peterpolidoro/camera-gpio-interface-pcb/docs/generated/README.md

# camera-gpio-interface-pcb — Generated Board Documentation

Everything in this directory is generated by `orb-weaver-kicad-docs` from the
KiCad sources. Do not edit it by hand; run `make docs` instead.

- KiCad `10.0.6`
- Board `6bc224f47287`

## Board At A Glance

| Property | Value |
| --- | --- |
| Outline | 100.0 × 60.0 mm, 5.0 mm corner radius |
| Thickness | 1.6 mm |
| Copper layers | 4 |
| Mounting holes | 4 × 3.2 mm |
| Connectors and controls | 11 |
| Bill of materials | 26 distinct parts, 151 placements |

## Assembled Board

The [board view](board-view.md) numbers the design blocks on the model and on the top render; each number leads to the block's page.

### Top, straight down

Top, straight down

### Bottom, straight down

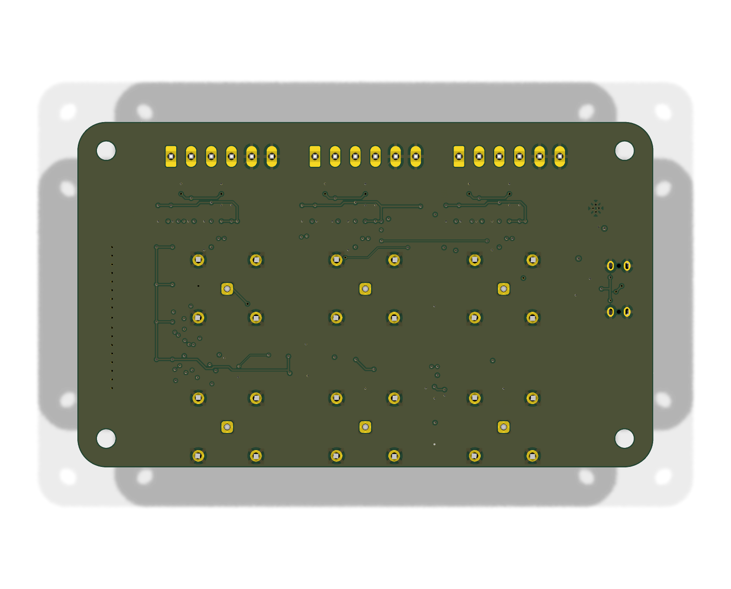
[picture p4: docs/generated/3d/bottom.png]
Bottom, straight down


### Isometric from the front left

Isometric from the front left

### Isometric from the front right

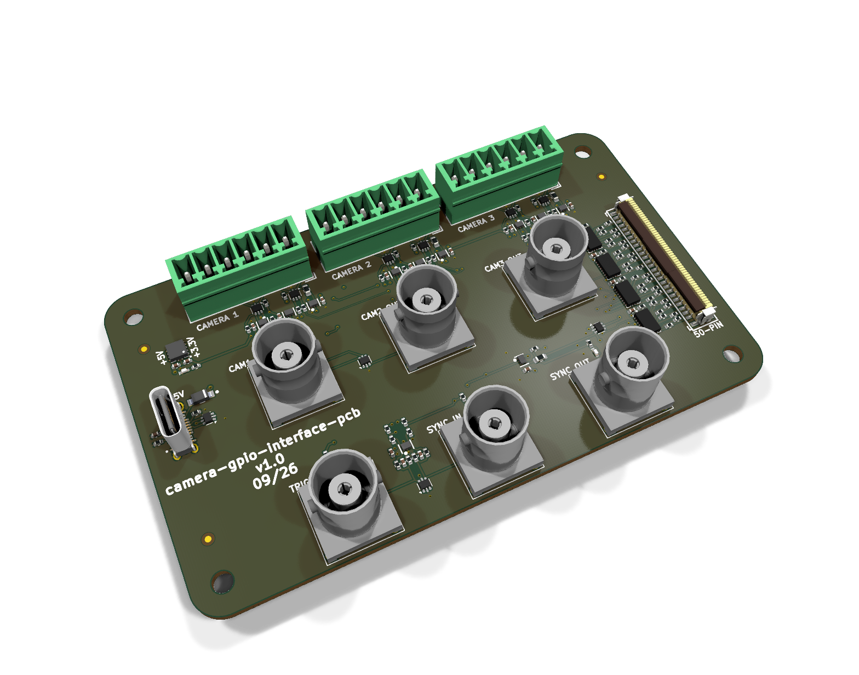
[picture p5: docs/generated/3d/iso-front-right.png]
Isometric from the front right


### Isometric from the rear left

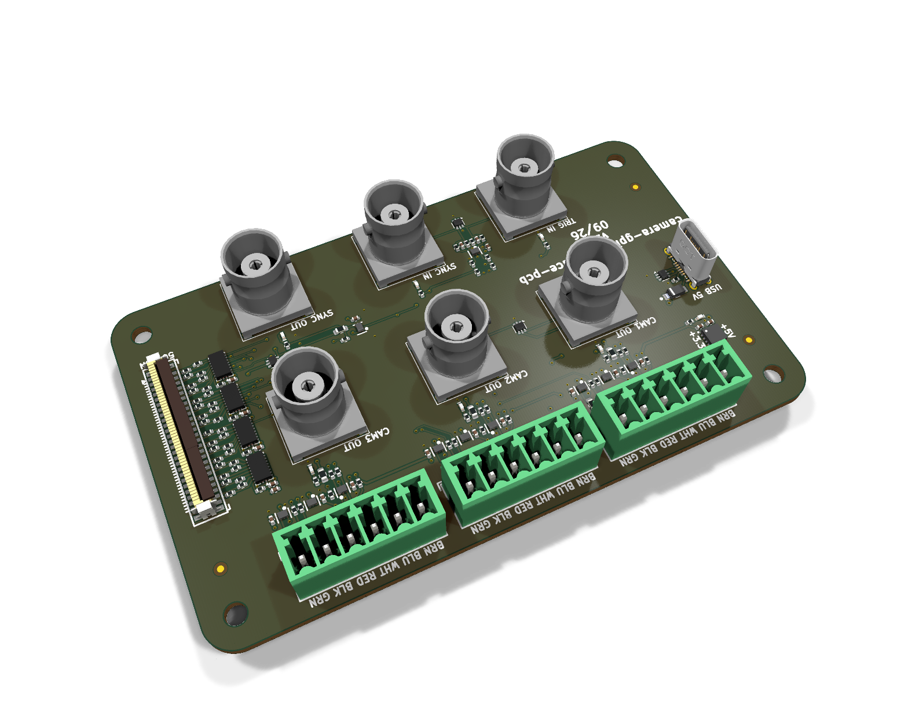
[picture p6: docs/generated/3d/iso-rear-left.png]
Isometric from the rear left


### Isometric from the rear right

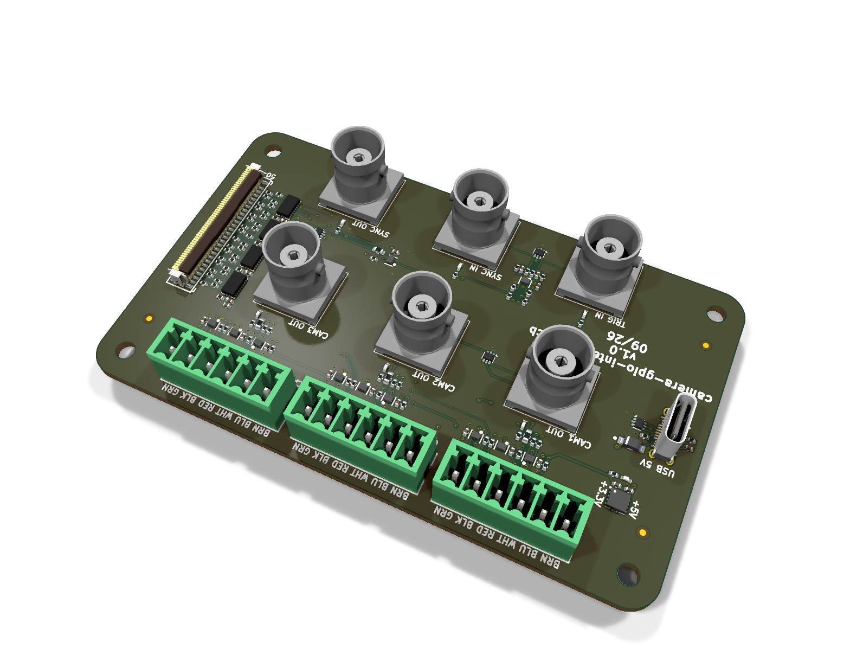
[picture p7: docs/generated/3d/iso-rear-right.png]
Isometric from the rear right


### Front elevation, for connector heights

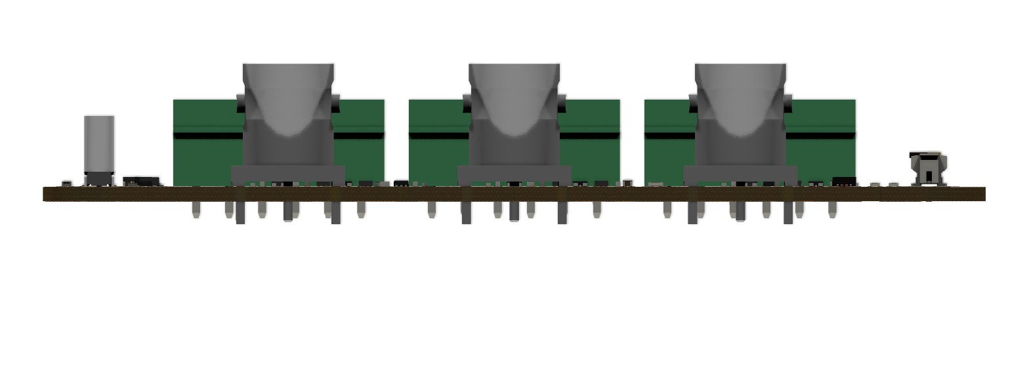
[picture p8: docs/generated/3d/elevation-front.png]
Front elevation, for connector heights


### Left elevation, for connector heights

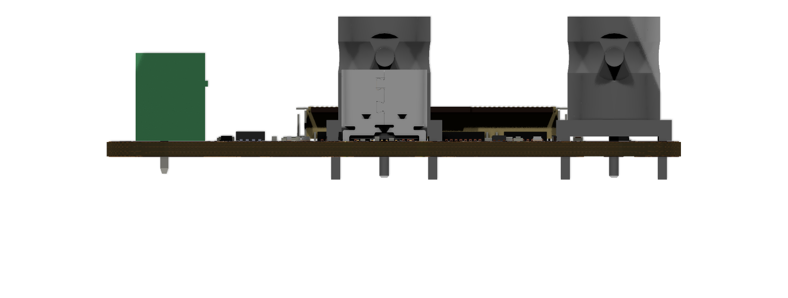
[picture p9: docs/generated/3d/elevation-left.png]
Left elevation, for connector heights


## Documents

| Document | File |
| --- | --- |
| Schematic, all sheets, PDF | [camera-gpio-interface-pcb-schematic.pdf](schematic/camera-gpio-interface-pcb-schematic.pdf) |
| Schematic sheets, SVG (11) | [schematic/](schematic/) |
| Schematic, instance overviews and details, PDF | [Review booklet](schematic/camera-gpio-interface-pcb-schematic-review.pdf) |
| Design blocks placed (7), one page each | [blocks/README.md](blocks/README.md) |
| Board view: the model and the top render with the design blocks numbered | [board-view.md](board-view.md) |
| Subsystem sheets (3), from their recipes | [subsystems/README.md](subsystems/README.md) |
| Assembly view, top | [assembly-top.svg](layout/assembly-top.svg) |
| Assembly view, bottom | [assembly-bottom.svg](layout/assembly-bottom.svg) |
| Assembled board, STEP, for FreeCAD | [camera-gpio-interface-pcb-assembled.step](3d/camera-gpio-interface-pcb-assembled.step) |
| Assembled board, glTF, for a viewer (the library's materials written in) | [camera-gpio-interface-pcb.glb](3d/camera-gpio-interface-pcb.glb) |
| Bill of materials | [table](bom/camera-gpio-interface-pcb-bom.md) · [CSV](bom/camera-gpio-interface-pcb-bom.csv) |
| Outline and mounting holes, dimensioned drawing | [SVG](mechanical/board-dimensions.svg) · [PDF](mechanical/board-dimensions.pdf) · [PNG](mechanical/board-dimensions.png) |
| Board dimensions and stackup | [board-dimensions.md](mechanical/board-dimensions.md) |
| Board geometry, machine readable | [board-geometry.json](mechanical/board-geometry.json) |
| Mounting holes | [mounting-holes.csv](mechanical/mounting-holes.csv) |
| Connector locations | [connectors.csv](mechanical/connectors.csv) |

## Design Blocks

Every block the board places, documented from the library: [the index](blocks/README.md) and one page per placement; the numbers are the [board view](board-view.md)'s.

| # | Instance | Block | Lifecycle | Family | Placed sheet |
| ---: | --- | --- | --- | --- | --- |
| 1 | [`blackfly_s_gpio_channel_mcv6_vertical`](blocks/blackfly_s_gpio_channel_mcv6_vertical.md) | `orb_weaver_blackfly_s_gpio_channel:blackfly_s_gpio_channel_mcv6_vertical` | routed | blackfly_s_gpio_channel `mcv6_vertical` (gpio) | differs |
| 7 | [`logic_input_2ch_5v_schmitt_sn74lvc2g17`](blocks/logic_input_2ch_5v_schmitt_sn74lvc2g17.md) | `orb_weaver_private:logic_input_2ch_5v_schmitt_sn74lvc2g17` | routed |  | differs |
| 4 | [`5v_to_3v3_tps73733`](blocks/5v_to_3v3_tps73733.md) | `orb_weaver_private:5v_to_3v3_tps73733` | routed |  | differs |
| 6 | [`usb2_vertical`](blocks/usb2_vertical.md) | `orb_weaver_private:usb2_vertical` | routed |  | differs |
| 5 | [`instrument_port_digital_50_dut_ffc_boundary_vertical`](blocks/instrument_port_digital_50_dut_ffc_boundary_vertical.md) | `orb_weaver_private:instrument_port_digital_50_dut_ffc_boundary_vertical` | routed |  | differs |
| 3 | [`blackfly_s_gpio_channel_mcv6_vertical2`](blocks/blackfly_s_gpio_channel_mcv6_vertical2.md) | `orb_weaver_blackfly_s_gpio_channel:blackfly_s_gpio_channel_mcv6_vertical` | routed | blackfly_s_gpio_channel `mcv6_vertical` (gpio) | differs |
| 2 | [`blackfly_s_gpio_channel_mcv6_vertical1`](blocks/blackfly_s_gpio_channel_mcv6_vertical1.md) | `orb_weaver_blackfly_s_gpio_channel:blackfly_s_gpio_channel_mcv6_vertical` | routed | blackfly_s_gpio_channel `mcv6_vertical` (gpio) | differs |

## Subsystems

The board's subsystem sheets from their recipes: [the index](subsystems/README.md) and one page each.

| Subsystem | Recipe | Blocks |
| --- | --- | --- |
| [`inputs`](subsystems/inputs.md) | `subsystems/inputs.subsystem.yaml` | 1 |
| [`power`](subsystems/power.md) | `subsystems/power.subsystem.yaml` | 2 |
| [`outputs`](subsystems/outputs.md) | `subsystems/outputs.subsystem.yaml` | 0 |

### Enclosure Reference

Millimetres from the **centre of the board outline**, X right and Y up,
looking at the top of the board. Extents are the part's courtyard, which is
what a panel cutout has to clear. Full tables in [board-dimensions.md](mechanical/board-dimensions.md).

Outline and mounting holes, dimensioned

The outline and the mounting holes dimensioned, as KiCad draws them: [SVG](mechanical/board-dimensions.svg) · [PDF](mechanical/board-dimensions.pdf); the cross is the centre the tables measure from.

**Mounting holes**

| Ref | X (mm) | Y (mm) | Drill (mm) |
| --- | --- | --- | --- |
| H101 | -45.0 | 25.0 | 3.2 |
| H102 | 45.0 | 25.0 | 3.2 |
| H103 | 45.0 | -25.0 | 3.2 |
| H104 | -45.0 | -25.0 | 3.2 |

**Connectors and controls**

| Ref | Part | X (mm) | Y (mm) | Rot | Extent X (mm) | Extent Y (mm) |
| --- | --- | --- | --- | --- | --- | --- |
| J301 | HL-BNC-KHDA | -24.0 | -23.0 | 0.0 | -30.5 to -17.5 | -29.5 to -16.5 |
| J302 | HL-BNC-KHDA | 0.0 | -23.0 | 0.0 | -6.5 to 6.5 | -29.5 to -16.5 |
| J401 | HL-BNC-KHDA | 24.0 | -23.0 | 0.0 | 17.5 to 30.5 | -29.5 to -16.5 |
| J402 | HL-BNC-KHDA | -24.0 | 1.0 | 0.0 | -30.5 to -17.5 | -5.5 to 7.5 |
| J403 | HL-BNC-KHDA | 0.0 | 1.0 | 0.0 | -6.5 to 6.5 | -5.5 to 7.5 |
| J404 | HL-BNC-KHDA | 24.0 | 1.0 | 0.0 | 17.5 to 30.5 | -5.5 to 7.5 |
| J501 | FH12-50S-0.5SVA(54) | 44.0 | -4.0 | 270.0 | 41.2 to 46.8 | -18.75 to 10.75 |
| J701 | TBH-1x06-3.5mm | -25.0 | 24.0 | 180.0 | -36.7 to -13.3 | 19.25 to 27.5 |
| J901 | USB-C | -44.0 | 1.0 | 90.0 | -46.31 to -41.69 | -4.05 to 6.05 |
| J1201 | TBH-1x06-3.5mm | 0.0 | 24.0 | 180.0 | -11.7 to 11.7 | 19.25 to 27.5 |
| J1401 | TBH-1x06-3.5mm | 25.0 | 24.0 | 180.0 | 13.3 to 36.7 | 19.25 to 27.5 |
