peterpolidoro/camera-gpio-interface-pcb/docs/generated/board-view.md

# camera-gpio-interface-pcb — Board View

<!-- Generated by orb-weaver-kicad-docs (scripts/board_view.py); do not edit. -->

The assembled board with its design blocks numbered. On the site the picture is a model that turns, or the top
render where WebGL is absent, and each number is a link to the block's page: its schematic, parts, ports and
placement guidance. Read on the forge, the picture is the plain top render and the table below is the key.

<script type="module" src="https://ajax.googleapis.com/ajax/libs/model-viewer/4.0.0/model-viewer.min.js"></script>

<script>
(function(){try{var c=document.createElement('canvas');if('customElements' in window&&(c.getContext('webgl2')||c.getContext('webgl')))document.documentElement.classList.add('webgl');}catch(e){}})();
</script>

<style>
.board-3d{display:none}html.webgl .board-3d{display:block}html.webgl .board-2d{display:none}.board-plain{display:none}
@media print{.board-3d{display:none !important}.board-2d{display:block !important}}
.hotspot{display:block;width:22px;height:22px;border-radius:11px;border:2px solid #fff;background:#d9480f;color:#fff;font:bold 11px/18px sans-serif;text-align:center;text-decoration:none;box-shadow:0 1px 3px rgba(0,0,0,.4)}
.hotspot::before{content:attr(data-n)}.hotspot:hover{background:#a63a0b}
.board-hint{font-size:.8em;opacity:.75;margin:.4em 0 0}
</style>

<div class="board-3d">
<model-viewer id="board" src="../3d/camera-gpio-interface-pcb.glb?v=8f34d4777c1f" alt="The assembled camera-gpio-interface-pcb" camera-controls touch-action="pan-y"
 camera-orbit="0deg 30deg auto" field-of-view="30deg" shadow-intensity="0.5" exposure="0.75" interaction-prompt="none"
 style="width:100%;height:560px;background:#fff;border-radius:8px">

</model-viewer>
<p class="board-hint">Drag to turn, scroll to zoom; the numbers are links.</p>
<script>
(function(){var mv=document.getElementById('board');if(!mv)return;
var fallback=function(){document.documentElement.classList.remove('webgl');};
mv.addEventListener('error',fallback);var t=setTimeout(fallback,20000);
if(window.customElements)customElements.whenDefined('model-viewer').then(function(){clearTimeout(t);});})();
</script>
</div>

<div class="board-2d">
<object data="../3d/top.svg?v=dc8af144220e" type="image/svg+xml" style="width:100%" aria-label="The top of the board with the blocks numbered"></object>
<p class="board-hint">The numbers are links; in a browser with WebGL this picture is a model that turns.</p>
</div>

<div class="board-plain" markdown>

Top, straight down

</div>

| # | Block instance | Library block | On sheet | Side | Parts |
| ---: | --- | --- | --- | --- | ---: |
| 1 | [`blackfly_s_gpio_channel_mcv6_vertical`](blocks/blackfly_s_gpio_channel_mcv6_vertical.md) | `orb_weaver_blackfly_s_gpio_channel:blackfly_s_gpio_channel_mcv6_vertical` | `/` | top | 21 |
| 2 | [`blackfly_s_gpio_channel_mcv6_vertical1`](blocks/blackfly_s_gpio_channel_mcv6_vertical1.md) | `orb_weaver_blackfly_s_gpio_channel:blackfly_s_gpio_channel_mcv6_vertical` | `/` | top | 21 |
| 3 | [`blackfly_s_gpio_channel_mcv6_vertical2`](blocks/blackfly_s_gpio_channel_mcv6_vertical2.md) | `orb_weaver_blackfly_s_gpio_channel:blackfly_s_gpio_channel_mcv6_vertical` | `/` | top | 21 |
| 4 | [`5v_to_3v3_tps73733`](blocks/5v_to_3v3_tps73733.md) | `orb_weaver_private:5v_to_3v3_tps73733` | `/power` | top | 3 |
| 5 | [`instrument_port_digital_50_dut_ffc_boundary_vertical`](blocks/instrument_port_digital_50_dut_ffc_boundary_vertical.md) | `orb_weaver_private:instrument_port_digital_50_dut_ffc_boundary_vertical` | `/` | top | 46 |
| 6 | [`usb2_vertical`](blocks/usb2_vertical.md) | `orb_weaver_private:usb2_vertical` | `/power` | top | 6 |
| 7 | [`logic_input_2ch_5v_schmitt_sn74lvc2g17`](blocks/logic_input_2ch_5v_schmitt_sn74lvc2g17.md) | `orb_weaver_private:logic_input_2ch_5v_schmitt_sn74lvc2g17` | `/inputs` | top | 12 |

The numbers run left to right, top to bottom over the top view. The model is
[`3d/camera-gpio-interface-pcb.glb`](3d/camera-gpio-interface-pcb.glb) (metres, Y up, the board's x and y along X and Z); the drawing
[`3d/top.svg`](3d/top.svg) is [`3d/top.png`](3d/top.png) at
12.35 px/mm with one rectangle per block, the union of its footprints' courtyards; both and the
footprints of each block are recorded in [`3d/hotspots.json`](3d/hotspots.json).
Each block's page shows the render clipped around its rectangle.
