peterpolidoro/camera-gpio-interface-pcb/docs/generated/blocks/blackfly_s_gpio_channel_mcv6_vertical1.md

# blackfly_s_gpio_channel_mcv6_vertical1

<!-- Generated by orb-weaver-kicad-board-docs from board-manifest.yaml; do not edit. -->

Block `orb_weaver_blackfly_s_gpio_channel:blackfly_s_gpio_channel_mcv6_vertical` placed in `/` of **camera-gpio-interface-pcb**. One FLIR Blackfly S camera GPIO channel (trigger, sync, exposure output, instrument taps) on a 6-position 3.5 mm Phoenix header; the connector family pilot: the vertical MCV and the horizontal MC header are pad-identical, so one source publishes both orientations

|  |  |
| --- | --- |
| Lifecycle | routed |
| Family | blackfly_s_gpio_channel `mcv6_vertical` (gpio): VERTICAL, top-entry 6-position 3.5 mm pluggable screw-terminal header, Phoenix MCV 1,5/6-G-3,5 (1843648), LCSC C5443576 |
| Placement | anchor (0, -24) mm, rotation 180°, front side; anchor rule: inferred (block not in the anchor table): the group's one connector, pad-array centre |
| Sheet | `blackfly_s_gpio_channel_mcv6_vertical.kicad_sch`; sheet pins: the library's arrangement |
| Drawing | [camera-gpio-interface-pcb-blackfly_s_gpio_channel_mcv6_vertical1.svg](../schematic/camera-gpio-interface-pcb-blackfly_s_gpio_channel_mcv6_vertical1.svg) |

## On the Board

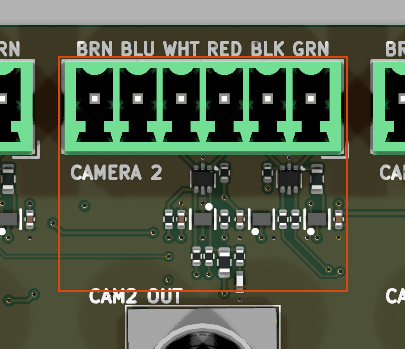
[picture p12: docs/generated/blocks/layout/blackfly_s_gpio_channel_mcv6_vertical1.png]
blackfly_s_gpio_channel_mcv6_vertical1 on the board


Block 2 of the [board view](../board-view.md): 23.4 × 19.1 mm on the top side, its centre 0.0 mm right of and 18.0 mm above the board centre (X right, Y up, as the enclosure tables); 21 footprints. The picture is the top render clipped around the block, the rectangle the extent of its footprints' courtyards.

## Description

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

## Ports

The brief's shape, edge, class and meaning for each port, then what the board wires it to.

| Port | Shape | Edge | Class | Wired to | Board net | Board class | GPIO | Meaning | On this board |
| --- | --- | --- | --- | --- | --- | --- | --- | --- | --- |
| `+3.3V` | passive | west | PWR_3V3_LOCAL | `+3.3V` | `/+3.3V` | PWR_3V3_NARROW |  | Logic rail for U23001, U23002, U23003 and the L2/L1 pull-ups; always-on if the taps must read before firmware. | The only logic rail, from the TPS73733 on the power sheet; always on while USB is present, as the InstrumentPort block requires |
| `+5V` | passive | west | PWR_5V_LOCAL | `+5V` | `/+5V` | PWR_5V_NARROW |  | Must be a 5 V rail: the Line 0 opto drive level (R23003) and both ESD clamps' VBUS reference. | VBUS after the USB block's Schottky (+5V_USB in the design record): the Line 0 pull-ups and every ESD array's clamp reference |
| `CAM_OUT_BNC` | output | west | Default | `CAM2_OUT_BNC` | `/CAM2_OUT_BNC` | Default |  | Exposure-active output: CAM_OUT through R23005 (470 ohm); the BNC itself is the board's. | Camera 2 ExposureActive (Line 2, Schmitt-buffered) behind the block's 470 Ω, to the CAM2 OUT BNC |
| `GND` | passive | west | PWR_RETURN_LOCAL | `GND` | `/GND` | PWR_RETURN_LOCAL |  | Camera pins 5 (opto ground) and 6 (ground) both land here, with the logic and ESD returns. | Board ground; every BNC shell and camera pins 5 and 6 |
| `L0_INST` | output | west | INSTRUMENT | `CAM2_L0_INST` | `/CAM2_L0_INST` | INSTRUMENT |  | 100 ohm tap (R23007) on L0, camera Line 0 OPTOIN: the sync drive. | DIG8: camera 2 pin 2 node (Line 0, the Rsync drive), 0 to 4.7 V open-drain |
| `L1_INST` | output | west | INSTRUMENT | `CAM2_L1_INST` | `/CAM2_L1_INST` | INSTRUMENT |  | 100 ohm tap (R23008) on L1_BUF, camera Line 1 OPTOOUT after the Schmitt buffer. | DIG9: camera 2 OPTOOUT (Line 1), Schmitt-buffered; a second camera output for diagnosing missed triggers |
| `L2_INST` | output | west | INSTRUMENT | `CAM2_L2_INST` | `/CAM2_L2_INST` | INSTRUMENT |  | 100 ohm tap (R23009) on L2, camera Line 2, the open-drain exposure output. | DIG10: camera 2 Line 2 raw open-drain node (ExposureActive) |
| `L3_INST` | output | west | INSTRUMENT | `CAM2_L3_INST` | `/CAM2_L3_INST` | INSTRUMENT |  | 100 ohm tap (R23010) on L3, camera Line 3, the frame trigger. | DIG11: camera 2 pin 1 node (Line 3, the trigger) after the 220 Ω |
| `OUT_INST` | output | west | INSTRUMENT | `CAM2_OUT_INST` | `/CAM2_OUT_INST` | INSTRUMENT |  | 100 ohm tap (R23011) on CAM_OUT, the buffered exposure signal. | DIG12: what the CAM2 OUT BNC carries |
| `SYNC_IN` | input | west | Default | `SYNC_IN` | `/SYNC_IN` | Default |  | Conditioned 3.3 V Rsync from the board's input Schmitt into U23003 (pin 2). | Conditioned Rsync from the SYNC IN BNC, 3.3 V, to the three Line 0 drivers and the SYNC OUT driver |
| `TRIG_IN` | input | west | Default | `TRIG_IN` | `/TRIG_IN` | Default |  | Conditioned 3.3 V frame trigger from the board's input Schmitt into U23002 (pin 2). | Conditioned 150 Hz frame trigger from the TRIG IN BNC, 3.3 V, to the three camera channels' Line 3 drivers |

## Parts

As placed on the board's sheet; 21 of 21 paired with the brief's references by symbol identity, the rest given the brief's role where the internal part has one, else the catalog's role slug; the placement is the `Placement` field of the board's symbol, else of the library's (D38); the manufacturer part and the LCSC number are the board's BOM's.

| Reference | Brief | Part | Value | Role | Placement | Manufacturer part | LCSC | DNP |
| --- | --- | --- | --- | --- | --- | --- | --- | --- |
| `C1201` | `C23001` | `OW-CAP-100N-0402-X5R-16V` | 100nF | VCC pin 6 bypass, U23002 | beside U1202.6 (VCC), on +3.3V | GRM155R62A104KE14D | [C162178](https://www.lcsc.com/product-detail/C162178.html) |  |
| `C1202` | `C23002` | `OW-CAP-100N-0402-X5R-16V` | 100nF | VCC pin 6 bypass, U23003 | beside U1203.6 (VCC), on +3.3V | GRM155R62A104KE14D | [C162178](https://www.lcsc.com/product-detail/C162178.html) |  |
| `C1203` | `C23003` | `OW-CAP-100N-0402-X5R-16V` | 100nF | VCC pin 5 bypass, U23001 | beside U1201C.5 (VCC), on +3.3V | GRM155R62A104KE14D | [C162178](https://www.lcsc.com/product-detail/C162178.html) |  |
| `D1201` | `D23001` | `OW-MISC-APHHS1005CGCK` | APHHS1005CGCK | Exposure LED, green |  | [APHHS1005CGCK](https://www.kingbrightusa.com/images/catalog/SPEC/APHHS1005CGCK.pdf) | [C2853065](https://www.lcsc.com/product-detail/C2853065.html) |  |
| `J1201` | `J23001` | `OW-CONN-TBH-1X06-3P5-VERT` | TBH-1x06-3.5mm | Camera GPIO header, 6-pos 3.5 mm |  | [1843648](https://www.phoenixcontact.com/en-pc/products/1843648) | [C5443576](https://www.lcsc.com/product-detail/C5443576.html) |  |
| `R1201` | `R23001` | `OW-PASS-RC0402FR-071KL` | 1k | L2 pull-up to +3.3V, 1 k | beside U1201A.1 (1A), on L2 | RC0402FR-071KL | [C106235](https://www.lcsc.com/product-detail/C106235.html) |  |
| `R1202` | `R23002` | `OW-RES-4K7-0402` | 4.7k | L1 pull-up to +3.3V, 4.7 k | beside U1201B.3 (2A), on L1 | 0402WGF4701TCE | [C25900](https://www.lcsc.com/product-detail/C25900.html) |  |
| `R1203` | `R23003` | `OW-PASS-FRC0402F8200TS` | 820 | L0 opto pull-up to +5V, 820 ohm | beside U1203.4, on L0 | FRC0402F8200TS | [C2909387](https://www.lcsc.com/product-detail/C2909387.html) |  |
| `R1204` | `R23004` | `OW-PASS-0603WAF2200T5E` | 220 | L3 trigger series, 220 ohm |  | 0603WAF2200T5E | [C22962](https://www.lcsc.com/product-detail/C22962.html) |  |
| `R1205` | `R23005` | `OW-PASS-0603WAF4700T5E` | 470 | BNC drive series, 470 ohm |  | 0603WAF4700T5E | [C23179](https://www.lcsc.com/product-detail/C23179.html) |  |
| `R1206` | `R23006` | `OW-PASS-RC0402FR-07680RL` | 680 | LED series, 680 ohm |  | RC0402FR-07680RL | [C137948](https://www.lcsc.com/product-detail/C137948.html) |  |
| `R1207` | `R23007` | `OW-PASS-0402WGF1000TCE` | 100 | 100 ohm tap, L0 to L0_INST |  | 0402WGF1000TCE | [C25076](https://www.lcsc.com/product-detail/C25076.html) |  |
| `R1208` | `R23008` | `OW-PASS-0402WGF1000TCE` | 100 | 100 ohm tap, L1_BUF to L1_INST |  | 0402WGF1000TCE | [C25076](https://www.lcsc.com/product-detail/C25076.html) |  |
| `R1209` | `R23009` | `OW-PASS-0402WGF1000TCE` | 100 | 100 ohm tap, L2 to L2_INST |  | 0402WGF1000TCE | [C25076](https://www.lcsc.com/product-detail/C25076.html) |  |
| `R1210` | `R23010` | `OW-PASS-0402WGF1000TCE` | 100 | 100 ohm tap, L3 to L3_INST |  | 0402WGF1000TCE | [C25076](https://www.lcsc.com/product-detail/C25076.html) |  |
| `R1211` | `R23011` | `OW-PASS-0402WGF1000TCE` | 100 | 100 ohm tap, CAM_OUT to OUT_INST |  | 0402WGF1000TCE | [C25076](https://www.lcsc.com/product-detail/C25076.html) |  |
| `U1201` | `U23001` | `OW-MISC-SN74LVC2G17DRYR` | SN74LVC2G17DRYR | Schmitt buffers, L2 and L1 |  | [SN74LVC2G17DRYR](https://www.ti.com/lit/ds/symlink/sn74lvc2g17.pdf) | [C2675856](https://www.lcsc.com/product-detail/C2675856.html) |  |
| `U1202` | `U23002` | `OW-MISC-SN74LVC1G125DRYR` | SN74LVC1G125DRYR | Line 3 trigger driver, always enabled |  | [SN74LVC1G125DRYR](https://www.ti.com/lit/ds/symlink/sn74lvc1g125.pdf) | [C527546](https://www.lcsc.com/product-detail/C527546.html) |  |
| `U1203` | `U23003` | `OW-MISC-SN74LVC1G07DRYR` | SN74LVC1G07DRYR | Line 0 sync driver, open drain |  | [SN74LVC1G07DRYR](https://www.ti.com/lit/ds/symlink/sn74lvc1g07.pdf) | [C2675513](https://www.lcsc.com/product-detail/C2675513.html) |  |
| `U1204` | `U23004` | `OW-MISC-USBLC6-2P6` | USBLC6-2P6 | ESD array for L3/L0 |  | [USBLC6-2P6](https://www.st.com/resource/en/datasheet/usblc6-2.pdf) | [C2827693](https://www.lcsc.com/product-detail/C2827693.html) |  |
| `U1205` | `U23005` | `OW-MISC-USBLC6-2P6` | USBLC6-2P6 | ESD array for L2/L1 |  | [USBLC6-2P6](https://www.st.com/resource/en/datasheet/usblc6-2.pdf) | [C2827693](https://www.lcsc.com/product-detail/C2827693.html) |  |

## Operating Notes

- Camera side: J23001's terminal numbers are the camera's Hirose HR10A-7R-6PB pin numbers, wired with the FLIR 1 m flying-lead GPIO cable into a Phoenix MC 1,5/6-ST-3,5 plug: pin 1 green Line 3 (GPI, trigger), pin 2 black Line 0 (OPTOIN, sync), pin 3 red Line 2 (GPIO, exposure output), pin 4 white Line 1 (OPTOOUT), pin 5 blue opto ground and pin 6 brown ground, both on GND (common-ground wiring).
- Trigger path: TRIG_IN -> U23002 (SN74LVC1G125, ~{OE} pin 1 grounded, so always enabled) -> L3_DRV -> R23004 (220 ohm) -> L3 -> camera Line 3; camera settings TriggerSelector FrameStart, TriggerSource Line3 RisingEdge. Sync path: SYNC_IN -> U23003 (SN74LVC1G07 open drain) -> L0, pulled to +5V by R23003 (820 ohm): 5 V across 820 ohm is about 6 mA, less by the opto input's forward drop. Both drivers run from +3.3V with 5.5 V-tolerant I/O.
- Exposure output: camera Line 2 (LineMode Output, LineSource ExposureActive, V3_3Enable false, so open drain) is pulled up by R23001 (1 k) to +3.3V and squared by Schmitt U23001 1A -> 1Y = CAM_OUT, which drives the BNC through R23005 (470 ohm), the green LED D23001 through R23006 (680 ohm: about (3.3 - 2.1) / 680 = 1.8 mA, LED on while exposure is active) and the OUT_INST tap. Line 1 (OPTOOUT, LineSource Off) is pulled up by R23002 (4.7 k) and buffered 2A -> 2Y into L1_BUF for its tap.
- ESD: two USBLC6-2P6 arrays with VBUS on +5V clamp L3 and L0 (U23004) and L2 and L1 (U23005), 15 kV IEC 61000-4-2 level 4, at most 3.5 pF per line; both I/O pins of each pair are wired to the node, so the footprint's paired pads need no track between them. +5V must therefore be a 5 V rail: it is the clamp reference and the opto drive level, and feeds nothing else.
- Variants (family.json): mcv6_vertical fits J23001 = OW-CONN-TBH-1X06-3P5-VERT (Phoenix MCV 1,5/6-G-3,5, top entry); mc6_horizontal fits OW-CONN-1844252 (Phoenix MC 1,5/6-G-3,5, side entry toward the footprint's +Y). The two footprints are pad-identical (six 1.8 x 3.6 mm ovals on 3.5 mm, origin at the pad-array centre), so the variant swaps only the connector's body, courtyard and 3D model; every pad, track and via stays, and the anchor connector_center is the same point for both.
- The placing board provides +3.3V (bind it to the always-on rail when the taps must be observable before firmware runs), a 5 V rail on +5V, the BNC on CAM_OUT_BNC, the conditioned 3.3 V TRIG_IN and SYNC_IN, and the instrument port behind the five 100 ohm taps; the three pull-ups are inside because the block owns L0, L1 and L2 (layout convention 10). Place one block per camera; the horizontal variant's plug needs the board edge its wire exit faces.

## Placement and Routing

### Camera header

`J23001`

J23001, the 6-position 3.5 mm Phoenix header; pins 1 to 4 are Lines 3, 0, 2 and 1, pins 5 and 6 are the camera's two grounds.

- Place: Place J23001 at the board edge the plug needs: the vertical body takes the plug from above, the horizontal from its +Y side; the anchor is the pad-array centre for both.
- Route: L3, L0, L2 and L1 run straight from the pads to their clamps and parts; GND from pins 5 and 6 into the block's return.

### Line 3 trigger drive

`U23002`, `R23004`, `C23001`

U23002 (always enabled) drives L3_DRV; R23004 (220 ohm) in series feeds camera Line 3 on L3; C23001 bypasses U23002's VCC.

- Place: Place U23002 near J23001 pin 1 with C23001 at its pin 6 and a short return to pin 3; R23004 between the driver and the connector.
- Route: L3 is a 3.3 V edge-triggered line: short, over ground, away from the switching parts of the board.

### Line 0 sync drive

`U23003`, `R23003`, `C23002`

U23003's open-drain Y pulls L0 low; R23003 (820 ohm) returns it to +5V, the opto input's drive level; C23002 bypasses U23003's VCC.

- Place: Place U23003 near J23001 pin 2 with C23002 at its pin 6; R23003 from L0 to the +5V entry.
- Route: L0 carries about 6 mA pulses into the camera's opto input; keep its return with the trigger line.

### Exposure output, BNC drive and LED

`U23001`, `R23001`, `R23002`, `R23005`, `R23006`, `D23001`, `C23003`

R23001 pulls Line 2 up, U23001 gate 1 squares it into CAM_OUT; R23005 drives the BNC, R23006 lights D23001; R23002 pulls Line 1 up and gate 2 buffers it into L1_BUF; C23003 bypasses U23001.

- Place: Place U23001 between the connector and the BNC side with C23003 at its pin 5; R23001 and R23002 at the connector pads; D23001 where it is visible.
- Route: CAM_OUT is the board's exposure reference: route R23005's far end to the BNC with a ground return beside it.

### ESD clamps

`U23004`, `U23005`

U23004 clamps L3 and L0, U23005 clamps L2 and L1, both referenced to +5V and GND; each pair's two I/O pins are tied to the node.

- Place: Place both arrays right at J23001's pads, before any series part, with the shortest GND return.
- Route: Wire the paired I/O pads together on the node itself; no separate track between them.

### Instrument taps

`R23010`, `R23007`, `R23009`, `R23008`, `R23011`

100 ohm series taps: R23010 on L3, R23007 on L0, R23009 on L2, R23008 on L1_BUF, R23011 on CAM_OUT, each to its _INST port.

- Place: Place the five taps as a row toward the instrument-port side of the block.
- Route: INSTRUMENT class to the instrument port; every tapped node has a DC definition (driven or pulled up).

## Library Identity

|  |  |
| --- | --- |
| Block | `orb_weaver_blackfly_s_gpio_channel:blackfly_s_gpio_channel_mcv6_vertical` |
| Resolution | the placed id is in the library |
| Brief | `design_block_families/blackfly_s_gpio_channel/source/blackfly_s_gpio_channel.brief.yaml`, the family's brief |
| Published sheet | `c9f98b3dd751f5b0` |
| Published PCB | `bc94c2fa85826a2e` |
| Family release | `blackfly_s_gpio_channel` variant `mcv6_vertical`, profile `gpio`; VERTICAL, top-entry 6-position 3.5 mm pluggable screw-terminal header, Phoenix MCV 1,5/6-G-3,5 (1843648), LCSC C5443576; geometry `76343d3e1fe7bf57`; copper `5697f9a330d24bc3`; hardware unvalidated; qualification matches |
| Placed sheet | `c66fa0c5aaaae95b`: matches the brief: its 21 parts by internal part, every port by name and shape; the file is the board's copy under its own designators |
| Netlist check | ok on 2026-10-15: every pin on the brief's net; 24 identity records differ, the board's own instances |
