peterpolidoro/camera-gpio-interface-pcb/docs/generated/schematic/camera-gpio-interface-pcb-schematic-review.pdf

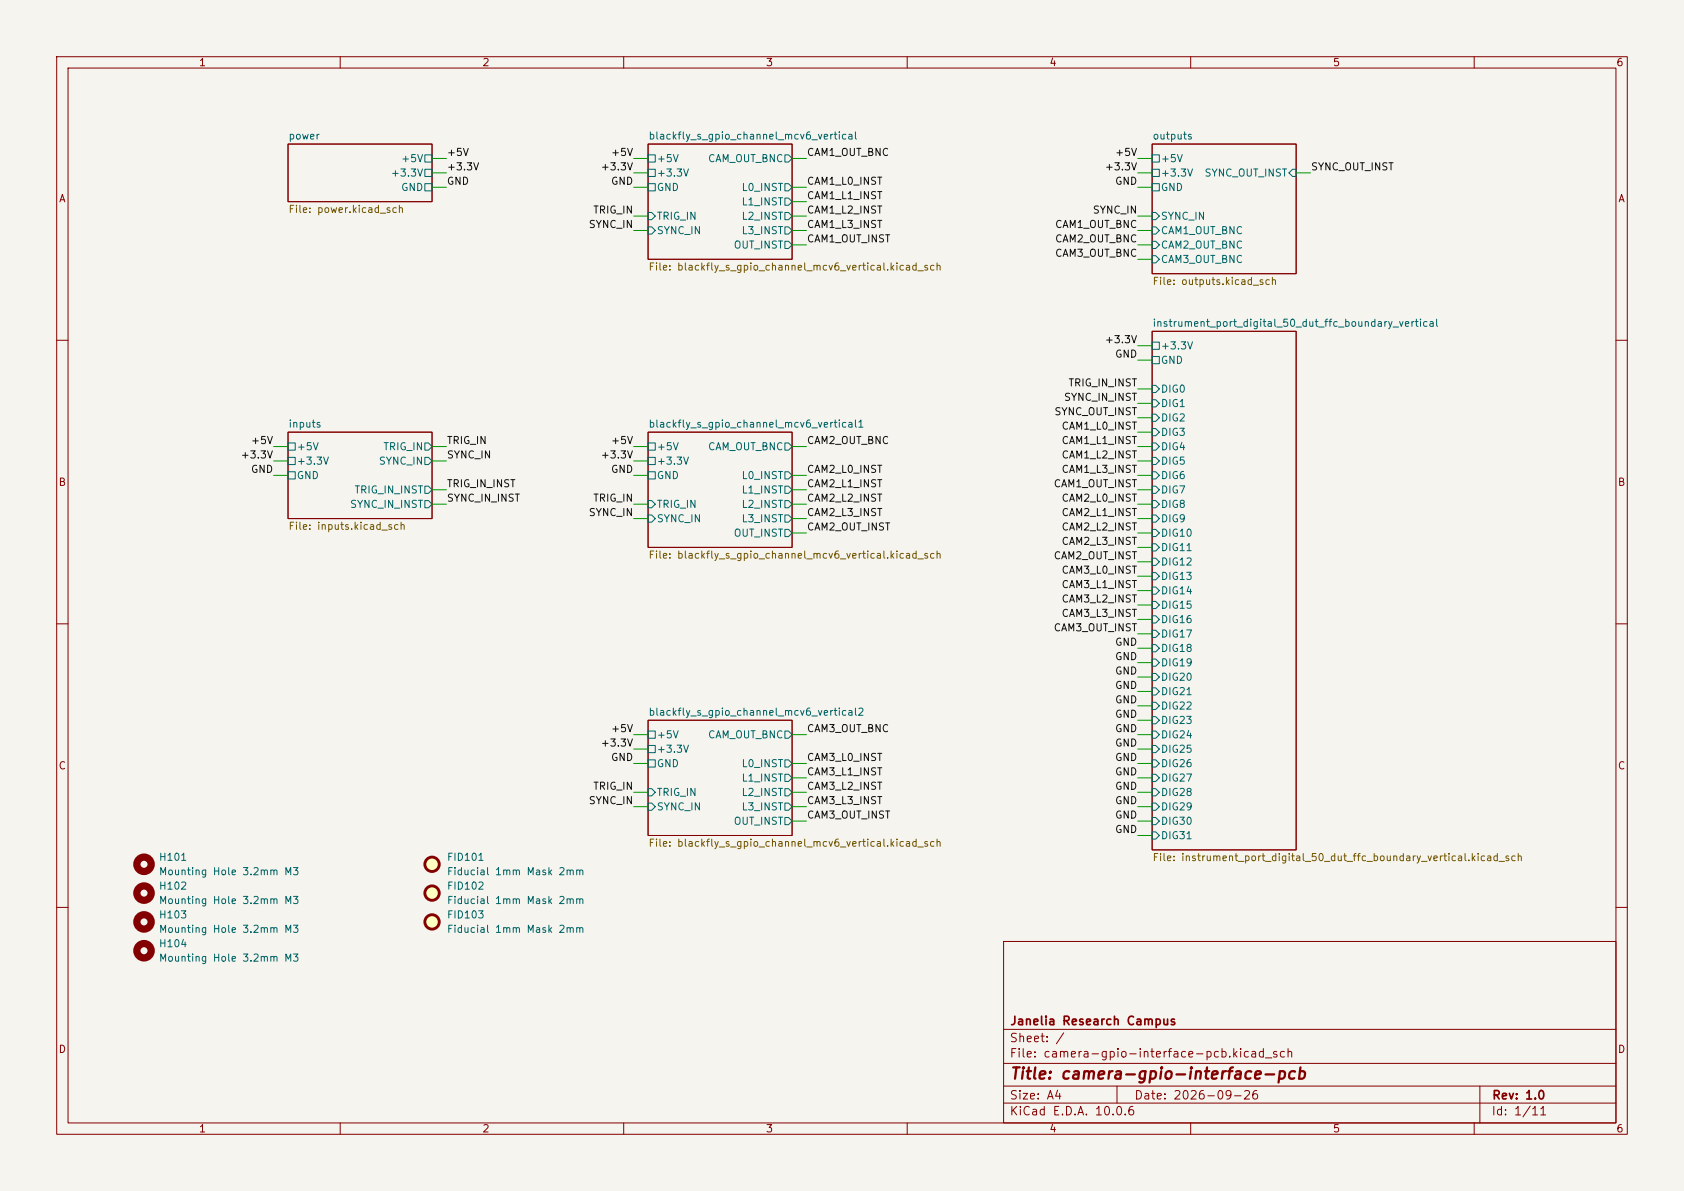
[picture p17: page 1]

Janelia Research Campus
Sheet: /
File: camera-gpio-interface-pcb.kicad_sch
Title: camera-gpio-interface-pcb

Size: A4 | Date: 2026-09-26 | Rev: 1.0
KiCad E.D.A. 10.0.6 | | Id: 1/11

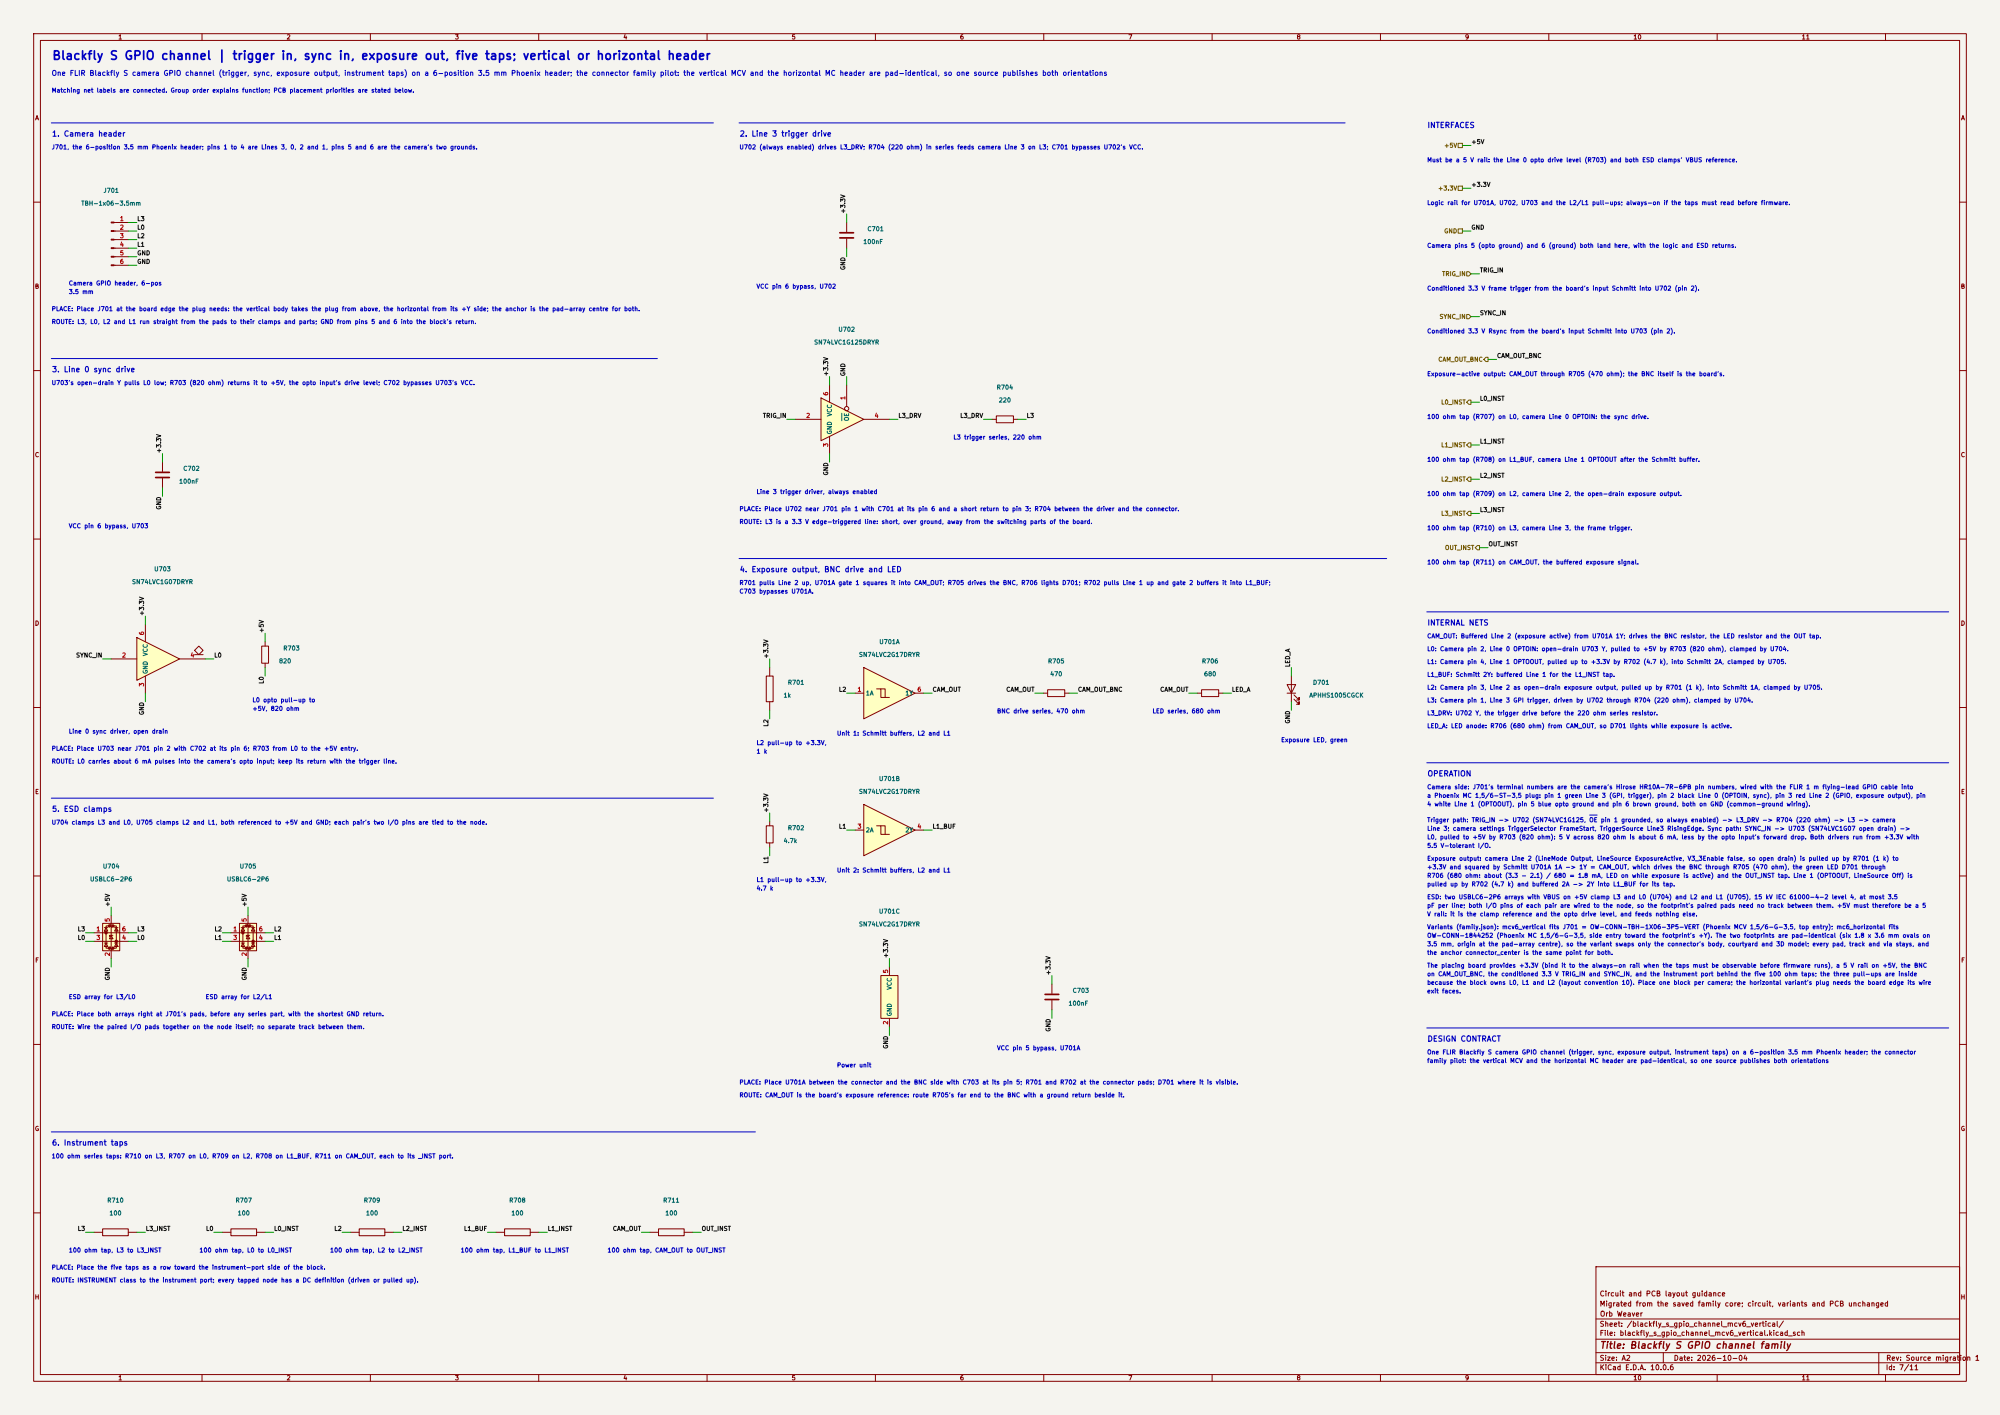
[picture p18: page 2]

Blackfly S GPIO channel | trigger in, sync in, exposure out, five taps; vertical or horizontal header

One FLIR Blackfly S camera GPIO channel (trigger, sync, exposure output, instrument taps) on a 6-position 3.5 mm Phoenix header; the connector family pilot: the vertical MCV and the horizontal MC header are pad-identical, so one source publishes both orientations

Matching net labels are connected. Group order explains function; PCB placement priorities are stated below.

J701, the 6-position 3.5 mm Phoenix header; pins 1 to 4 are Lines 3, 0, 2 and 1, pins 5 and 6 are the camera's two grounds.

U702 (always enabled) drives L3_DRV; R704 (220 ohm) in series feeds camera Line 3 on L3; C701 bypasses U702's VCC.

Must be a 5 V rail: the Line 0 opto drive level (R703) and both ESD clamps' VBUS reference.

Logic rail for U701A, U702, U703 and the L2/L1 pull-ups; always-on if the taps must read before firmware.

Camera pins 5 (opto ground) and 6 (ground) both land here, with the logic and ESD returns.

Camera GPIO header, 6-pos

Conditioned 3.3 V frame trigger from the board's input Schmitt into U702 (pin 2).

PLACE: Place J701 at the board edge the plug needs: the vertical body takes the plug from above, the horizontal from its +Y side; the anchor is the pad-array centre for both.

ROUTE: L3, L0, L2 and L1 run straight from the pads to their clamps and parts; GND from pins 5 and 6 into the block's return.

Conditioned 3.3 V Rsync from the board's input Schmitt into U703 (pin 2).

Exposure-active output: CAM_OUT through R705 (470 ohm); the BNC itself is the board's.

U703's open-drain Y pulls L0 low; R703 (820 ohm) returns it to +5V, the opto input's drive level; C702 bypasses U703's VCC.

100 ohm tap (R707) on L0, camera Line 0 OPTOIN: the sync drive.

100 ohm tap (R708) on L1_BUF, camera Line 1 OPTOOUT after the Schmitt buffer.

Line 3 trigger driver, always enabled

100 ohm tap (R709) on L2, camera Line 2, the open-drain exposure output.

PLACE: Place U702 near J701 pin 1 with C701 at its pin 6 and a short return to pin 3; R704 between the driver and the connector.

ROUTE: L3 is a 3.3 V edge-triggered line: short, over ground, away from the switching parts of the board.

100 ohm tap (R710) on L3, camera Line 3, the frame trigger.

4. Exposure output, BNC drive and LED

100 ohm tap (R711) on CAM_OUT, the buffered exposure signal.

R701 pulls Line 2 up, U701A gate 1 squares it into CAM_OUT; R705 drives the BNC, R706 lights D701; R702 pulls Line 1 up and gate 2 buffers it into L1_BUF;
C703 bypasses U701A.

CAM_OUT: Buffered Line 2 (exposure active) from U701A 1Y; drives the BNC resistor, the LED resistor and the OUT tap.

L0: Camera pin 2, Line 0 OPTOIN: open-drain U703 Y, pulled to +5V by R703 (820 ohm), clamped by U704.

L1: Camera pin 4, Line 1 OPTOOUT, pulled up to +3.3V by R702 (4.7 k), into Schmitt 2A, clamped by U705.

L1_BUF: Schmitt 2Y: buffered Line 1 for the L1_INST tap.
L2: Camera pin 3, Line 2 as open-drain exposure output, pulled up by R701 (1 k), into Schmitt 1A, clamped by U705.

L0 opto pull-up to
+5V, 820 ohm

L3: Camera pin 1, Line 3 GPI trigger, driven by U702 through R704 (220 ohm), clamped by U704.

BNC drive series, 470 ohm

L3_DRV: U702 Y, the trigger drive before the 220 ohm series resistor.
LED_A: LED anode: R706 (680 ohm) from CAM_OUT, so D701 lights while exposure is active.

Line 0 sync driver, open drain

Unit 1: Schmitt buffers, L2 and L1

PLACE: Place U703 near J701 pin 2 with C702 at its pin 6; R703 from L0 to the +5V entry.

ROUTE: L0 carries about 6 mA pulses into the camera's opto input; keep its return with the trigger line.

Camera side: J701's terminal numbers are the camera's Hirose HR10A-7R-6PB pin numbers, wired with the FLIR 1 m flying-lead GPIO cable into
a Phoenix MC 1,5/6-ST-3,5 plug: pin 1 green Line 3 (GPI, trigger), pin 2 black Line 0 (OPTOIN, sync), pin 3 red Line 2 (GPIO, exposure output), pin
4 white Line 1 (OPTOOUT), pin 5 blue opto ground and pin 6 brown ground, both on GND (common-ground wiring).

U704 clamps L3 and L0, U705 clamps L2 and L1, both referenced to +5V and GND; each pair's two I/O pins are tied to the node.

Trigger path: TRIG_IN -> U702 (SN74LVC1G125, OE pin 1 grounded, so always enabled) -> L3_DRV -> R704 (220 ohm) -> L3 -> camera
Line 3; camera settings TriggerSelector FrameStart, TriggerSource Line3 RisingEdge. Sync path: SYNC_IN -> U703 (SN74LVC1G07 open drain) ->
L0, pulled to +5V by R703 (820 ohm): 5 V across 820 ohm is about 6 mA, less by the opto input's forward drop. Both drivers run from +3.3V with
5.5 V-tolerant I/O.

Exposure output: camera Line 2 (LineMode Output, LineSource ExposureActive, V3_3Enable false, so open drain) is pulled up by R701 (1 k) to
+3.3V and squared by Schmitt U701A 1A -> 1Y = CAM_OUT, which drives the BNC through R705 (470 ohm), the green LED D701 through
R706 (680 ohm: about (3.3 - 2.1) / 680 = 1.8 mA, LED on while exposure is active) and the OUT_INST tap. Line 1 (OPTOOUT, LineSource Off) is
pulled up by R702 (4.7 k) and buffered 2A -> 2Y into L1_BUF for its tap.

Unit 2: Schmitt buffers, L2 and L1

ESD: two USBLC6-2P6 arrays with VBUS on +5V clamp L3 and L0 (U704) and L2 and L1 (U705), 15 kV IEC 61000-4-2 level 4, at most 3.5
pF per line; both I/O pins of each pair are wired to the node, so the footprint's paired pads need no track between them. +5V must therefore be a 5
V rail: it is the clamp reference and the opto drive level, and feeds nothing else.
Variants (family.json): mcv6_vertical fits J701 = OW-CONN-TBH-1X06-3P5-VERT (Phoenix MCV 1,5/6-G-3,5, top entry); mc6_horizontal fits
OW-CONN-1844252 (Phoenix MC 1,5/6-G-3,5, side entry toward the footprint's +Y). The two footprints are pad-identical (six 1.8 x 3.6 mm ovals on
3.5 mm, origin at the pad-array centre), so the variant swaps only the connector's body, courtyard and 3D model; every pad, track and via stays, and
the anchor connector_center is the same point for both.
The placing board provides +3.3V (bind it to the always-on rail when the taps must be observable before firmware runs), a 5 V rail on +5V, the BNC
on CAM_OUT_BNC, the conditioned 3.3 V TRIG_IN and SYNC_IN, and the instrument port behind the five 100 ohm taps; the three pull-ups are inside
because the block owns L0, L1 and L2 (layout convention 10). Place one block per camera; the horizontal variant's plug needs the board edge its wire
exit faces.

PLACE: Place both arrays right at J701's pads, before any series part, with the shortest GND return.

ROUTE: Wire the paired I/O pads together on the node itself; no separate track between them.

One FLIR Blackfly S camera GPIO channel (trigger, sync, exposure output, instrument taps) on a 6-position 3.5 mm Phoenix header; the connector
family pilot: the vertical MCV and the horizontal MC header are pad-identical, so one source publishes both orientations

PLACE: Place U701A between the connector and the BNC side with C703 at its pin 5; R701 and R702 at the connector pads; D701 where it is visible.

ROUTE: CAM_OUT is the board's exposure reference: route R705's far end to the BNC with a ground return beside it.

100 ohm series taps: R710 on L3, R707 on L0, R709 on L2, R708 on L1_BUF, R711 on CAM_OUT, each to its _INST port.

PLACE: Place the five taps as a row toward the instrument-port side of the block.
ROUTE: INSTRUMENT class to the instrument port; every tapped node has a DC definition (driven or pulled up).

Circuit and PCB layout guidance
Migrated from the saved family core; circuit, variants and PCB unchanged
Orb Weaver
Sheet: /blackfly_s_gpio_channel_mcv6_vertical/
File: blackfly_s_gpio_channel_mcv6_vertical.kicad_sch
Title: Blackfly S GPIO channel family

Date: 2026-10-04

KiCad E.D.A. 10.0.6 | | Id: 7/11

1 | 2 | 3 | 4 | 5 | 6 | 7 | 8 | 9 | 10 | 11

1
2
3
4
5
6

J701

## TBH-1x06-3.5mm

L0

L3

L2
L1

## GND GND

## Camera GPIO header, 6-pos

3.5 mm

Matching net labels are connected. Group order explains function; PCB placement priorities are stated below.

# 1. Camera header

ROUTE: L3, L0, L2 and L1 run straight from the pads to their clamps and parts; GND from pins 5 and 6 into the block's return.

Blackfly S GPIO channel | trigger in, sync in, exposure out, five taps; vertical or horizontal header

J701, the 6-position 3.5 mm Phoenix header; pins 1 to 4 are Lines 3, 0, 2 and 1, pins 5 and 6 are the camera's two grounds.

PLACE: Place J701 at the board edge the plug needs: the vertical body takes the plug from above, the horizontal from its +Y side; the anchor is the pad-array centre for both.

One FLIR Blackfly S camera GPIO channel (trigger, sync, exposure output, instrument taps) on a 6-position 3.5 mm Phoenix header; the connector family pilot: the vertical MCV and the horizontal MC header are pad-identical, so one source publishes both orientations

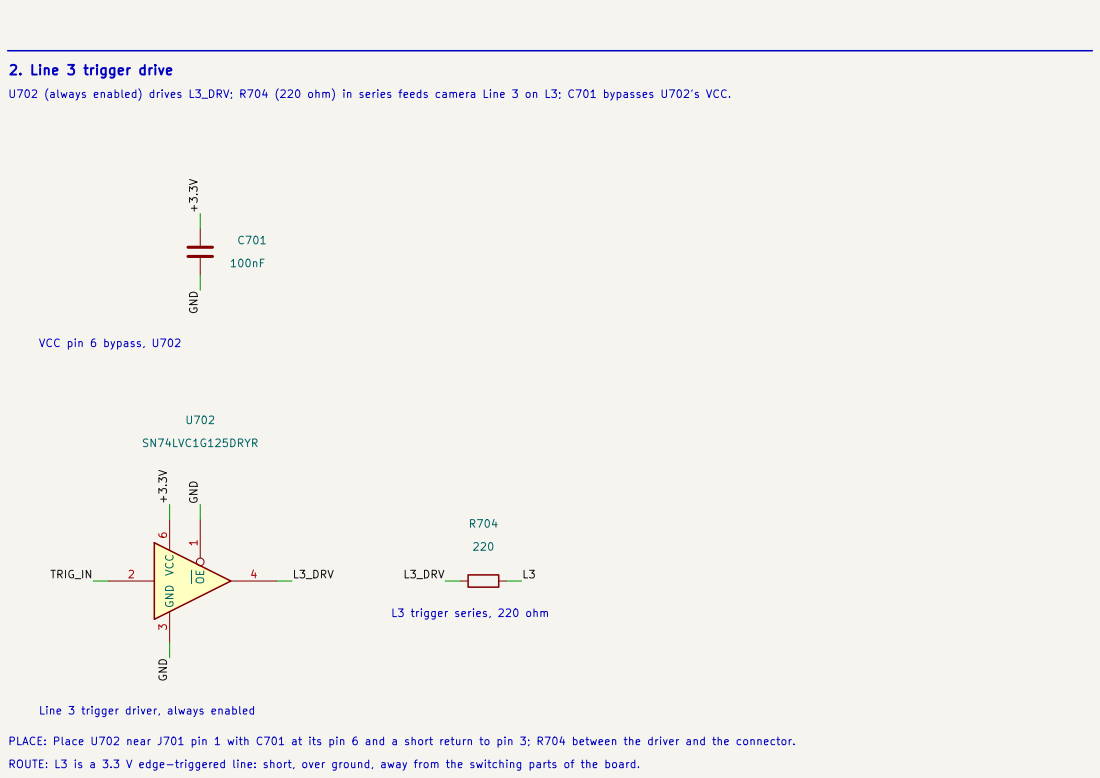
[picture p19: page 4]

U702 (always enabled) drives L3_DRV; R704 (220 ohm) in series feeds camera Line 3 on L3; C701 bypasses U702's VCC.

Line 3 trigger driver, always enabled

PLACE: Place U702 near J701 pin 1 with C701 at its pin 6 and a short return to pin 3; R704 between the driver and the connector.

ROUTE: L3 is a 3.3 V edge-triggered line: short, over ground, away from the switching parts of the board.

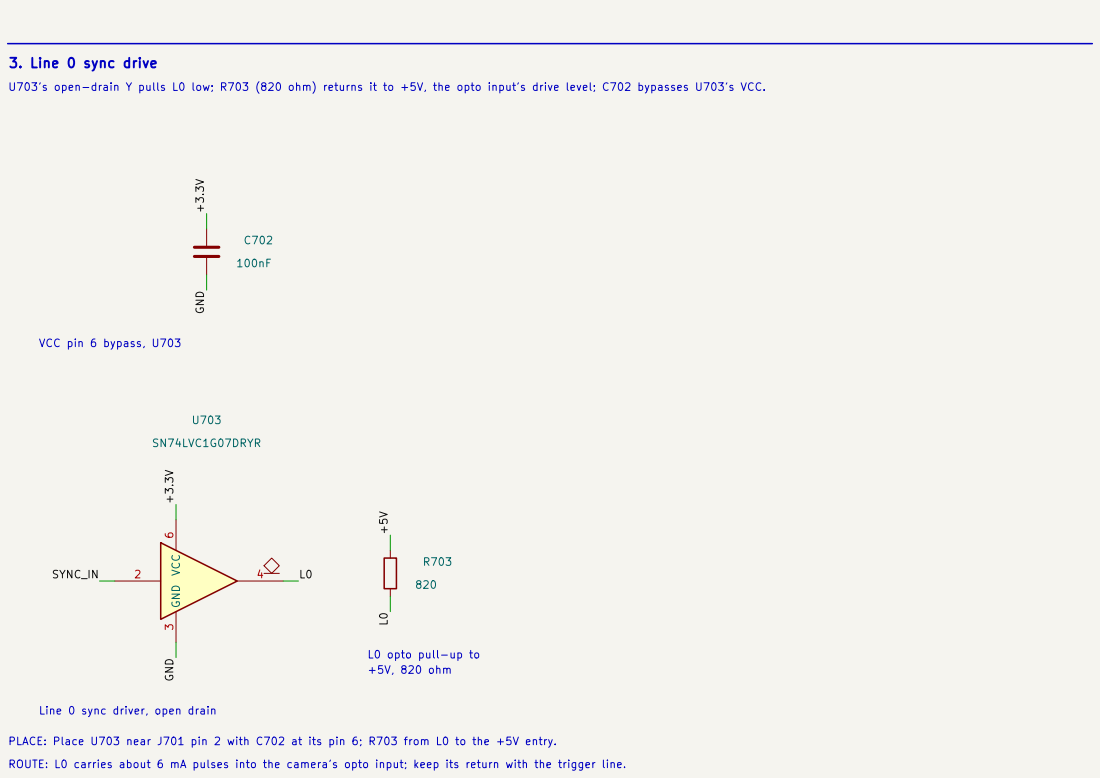
[picture p20: page 5]

U703's open-drain Y pulls L0 low; R703 (820 ohm) returns it to +5V, the opto input's drive level; C702 bypasses U703's VCC.

L0 opto pull-up to
+5V, 820 ohm

Line 0 sync driver, open drain

PLACE: Place U703 near J701 pin 2 with C702 at its pin 6; R703 from L0 to the +5V entry.

ROUTE: L0 carries about 6 mA pulses into the camera's opto input; keep its return with the trigger line.

GND

# 2 VCC

5

U701C

### SN74LVC2G17DRYR

R705

470

1A 1

1Y 6

U701A

### SN74LVC2G17DRYR

R706

680

2A 3

2Y 4

U701B

### SN74LVC2G17DRYR

R702

4.7k

D701

### APHHS1005CGCK

C703

100nF

R701

1k

### CAM_OUT

### CAM_OUT_BNC

L1

GND

### L1_BUF

L1

GND

L2

### LED_A

### CAM_OUT

+3.3V

### CAM_OUT

### LED_A

+3.3V

L2

GND

+3.3V

+3.3V

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

### Unit 2: Schmitt buffers, L2 and L1

## INTERNAL NETS

100 ohm tap (R711) on CAM_OUT, the buffered exposure signal.

One FLIR Blackfly S camera GPIO channel (trigger, sync, exposure output, instrument taps) on a 6-position 3.5 mm Phoenix header; the connector because the block owns L0, L1 and L2 (layout convention 10). Place one block per camera; the horizontal variant's plug needs the board edge its wire

4.7 k

exit faces.

### VCC pin 5 bypass, U701A

### LED series, 680 ohm

L1 pull-up to +3.3V,

## DESIGN CONTRACT

Camera side: J701's terminal numbers are the camera's Hirose HR10A-7R-6PB pin numbers, wired with the FLIR 1 m flying-lead GPIO cable into

the anchor connector_center is the same point for both.

3.5 mm, origin at the pad-array centre), so the variant swaps only the connector's body, courtyard and 3D model; every pad, track and via stays, and

OW-CONN-1844252 (Phoenix MC 1,5/6-G-3,5, side entry toward the footprint's +Y). The two footprints are pad-identical (six 1.8 x 3.6 mm ovals on

Variants (family.json): mcv6_vertical fits J701 = OW-CONN-TBH-1X06-3P5-VERT (Phoenix MCV 1,5/6-G-3,5, top entry); mc6_horizontal fits

V rail: it is the clamp reference and the opto drive level, and feeds nothing else.

pF per line; both I/O pins of each pair are wired to the node, so the footprint's paired pads need no track between them. +5V must therefore be a 5 pulled up by R702 (4.7 k) and buffered 2A -> 2Y into L1_BUF for its tap.

R706 (680 ohm: about (3.3 - 2.1) / 680 = 1.8 mA, LED on while exposure is active) and the OUT_INST tap. Line 1 (OPTOOUT, LineSource Off) is

Exposure output: camera Line 2 (LineMode Output, LineSource ExposureActive, V3_3Enable false, so open drain) is pulled up by R701 (1 k) to

5.5 V-tolerant I/O.

L0, pulled to +5V by R703 (820 ohm): 5 V across 820 ohm is about 6 mA, less by the opto input's forward drop. Both drivers run from +3.3V with

Line 3; camera settings TriggerSelector FrameStart, TriggerSource Line3 RisingEdge. Sync path: SYNC_IN -> U703 (SN74LVC1G07 open drain) ->

4 white Line 1 (OPTOOUT), pin 5 blue opto ground and pin 6 brown ground, both on GND (common-ground wiring).

a Phoenix MC 1,5/6-ST-3,5 plug: pin 1 green Line 3 (GPI, trigger), pin 2 black Line 0 (OPTOIN, sync), pin 3 red Line 2 (GPIO, exposure output), pin

on CAM_OUT_BNC, the conditioned 3.3 V TRIG_IN and SYNC_IN, and the instrument port behind the five 100 ohm taps; the three pull-ups are inside

## OPERATION

+3.3V and squared by Schmitt U701A 1A -> 1Y = CAM_OUT, which drives the BNC through R705 (470 ohm), the green LED D701 through

Trigger path: TRIG_IN -> U702 (SN74LVC1G125, OE pin 1 grounded, so always enabled) -> L3_DRV -> R704 (220 ohm) -> L3 -> camera

The placing board provides +3.3V (bind it to the always-on rail when the taps must be observable before firmware runs), a 5 V rail on +5V, the BNC

LED_A: LED anode: R706 (680 ohm) from CAM_OUT, so D701 lights while exposure is active.

L1: Camera pin 4, Line 1 OPTOOUT, pulled up to +3.3V by R702 (4.7 k), into Schmitt 2A, clamped by U705.

CAM_OUT: Buffered Line 2 (exposure active) from U701A 1Y; drives the BNC resistor, the LED resistor and the OUT tap.

L3_DRV: U702 Y, the trigger drive before the 220 ohm series resistor.

L1_BUF: Schmitt 2Y: buffered Line 1 for the L1_INST tap.

## 4. Exposure output, BNC drive and LED

### BNC drive series, 470 ohm

### Unit 1: Schmitt buffers, L2 and L1

L2 pull-up to +3.3V,

C703 bypasses U701A.

### Power unit

### Exposure LED, green

1 k

ESD: two USBLC6-2P6 arrays with VBUS on +5V clamp L3 and L0 (U704) and L2 and L1 (U705), 15 kV IEC 61000-4-2 level 4, at most 3.5

L3: Camera pin 1, Line 3 GPI trigger, driven by U702 through R704 (220 ohm), clamped by U704.

L2: Camera pin 3, Line 2 as open-drain exposure output, pulled up by R701 (1 k), into Schmitt 1A, clamped by U705.

L0: Camera pin 2, Line 0 OPTOIN: open-drain U703 Y, pulled to +5V by R703 (820 ohm), clamped by U704.

R701 pulls Line 2 up, U701A gate 1 squares it into CAM_OUT; R705 drives the BNC, R706 lights D701; R702 pulls Line 1 up and gate 2 buffers it into L1_BUF;

ROUTE: CAM_OUT is the board's exposure reference: route R705's far end to the BNC with a ground return beside it.

PLACE: Place U701A between the connector and the BNC side with C703 at its pin 5; R701 and R702 at the connector pads; D701 where it is visible.

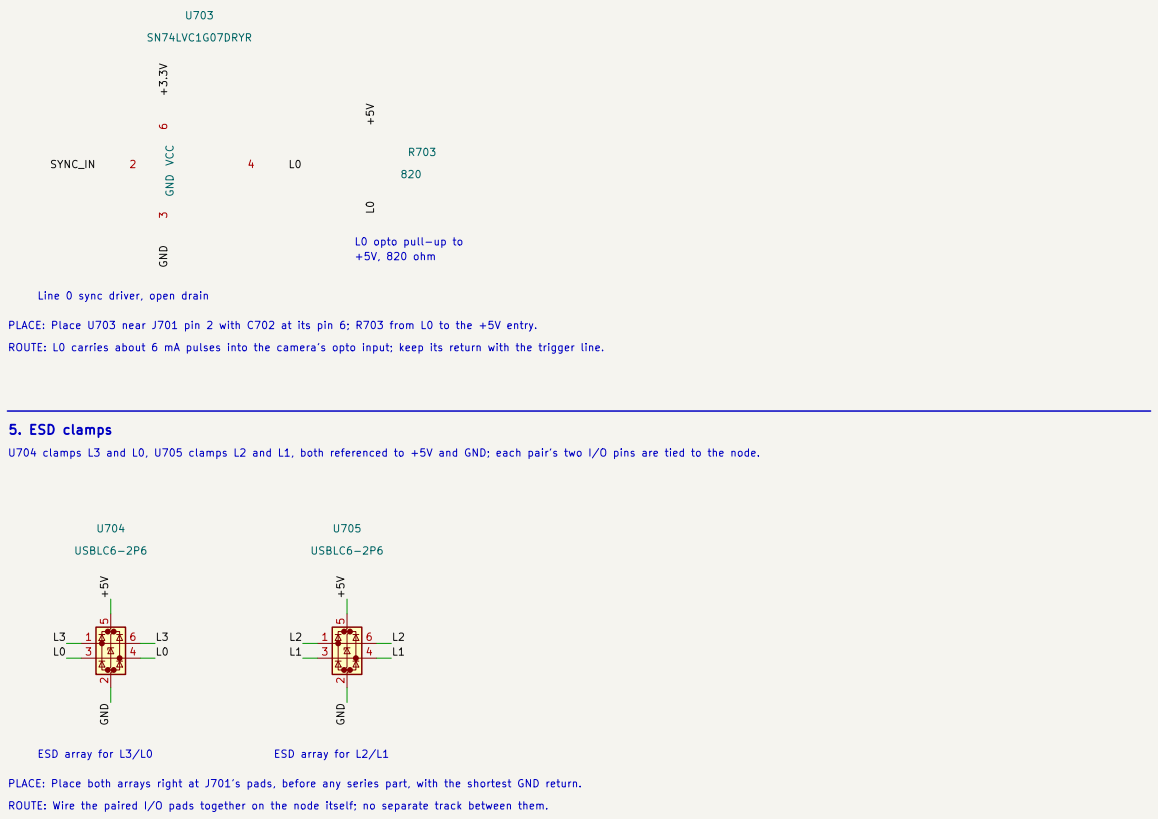
[picture p21: page 7]

L0 opto pull-up to
+5V, 820 ohm

Line 0 sync driver, open drain

PLACE: Place U703 near J701 pin 2 with C702 at its pin 6; R703 from L0 to the +5V entry.

ROUTE: L0 carries about 6 mA pulses into the camera's opto input; keep its return with the trigger line.

U704 clamps L3 and L0, U705 clamps L2 and L1, both referenced to +5V and GND; each pair's two I/O pins are tied to the node.

PLACE: Place both arrays right at J701's pads, before any series part, with the shortest GND return.

ROUTE: Wire the paired I/O pads together on the node itself; no separate track between them.

R711

100

R709

100

1

2

3 | 4

5
| 6

U704

## USBLC6-2P6

R707

100

R710

100

R708

100

1

2

3 | 4

5
| 6

U705

## USBLC6-2P6

GND

## OUT_INSTCAM_OUT

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
## L3_INSTL3

## L2_INST

L1_BUF | L1_INST
L0 | L0_INST

4.7 k

L1 pull-up to +3.3V,

# 6. Instrument taps

100 ohm series taps: R710 on L3, R707 on L0, R709 on L2, R708 on L1_BUF, R711 on CAM_OUT, each to its _INST port.

100 ohm tap, L1_BUF to L1_INST | 100 ohm tap, CAM_OUT to OUT_INST
100 ohm tap, L3 to L3_INST | 100 ohm tap, L0 to L0_INST | 100 ohm tap, L2 to L2_INST

PLACE: Place the five taps as a row toward the instrument-port side of the block.

ROUTE: INSTRUMENT class to the instrument port; every tapped node has a DC definition (driven or pulled up).

# 5. ESD clamps

ESD array for L3/L0 | ESD array for L2/L1

PLACE: Place both arrays right at J701's pads, before any series part, with the shortest GND return.

ROUTE: Wire the paired I/O pads together on the node itself; no separate track between them.

U704 clamps L3 and L0, U705 clamps L2 and L1, both referenced to +5V and GND; each pair's two I/O pins are tied to the node.

ROUTE: CAM_OUT is the board's exposure reference: route R705's far end to the BNC with a ground return beside it.

PLACE: Place U701A between the connector and the BNC side with C703 at its pin 5; R701 and R702 at the connector pads; D701 where it is visible.

1 | 2 | 3 | 4 | 5 | 6 | 7 | 8 | 9 | 10 | 11

# L1_INST

# CAM_OUT_BNC

# L2_INST

+3.3V

# L3_INST

+5V

# TRIG_IN

# OUT_INST

# SYNC_IN

# GND

# L0_INST

# OUT_INST

+5V

+3.3V

# GND

# TRIG_IN

# SYNC_IN

# CAM_OUT_BNC

# L0_INST

# L1_INST

# L2_INST

# L3_INST

100 ohm tap (R711) on CAM_OUT, the buffered exposure signal.

100 ohm tap (R710) on L3, camera Line 3, the frame trigger.

Conditioned 3.3 V Rsync from the board's input Schmitt into U703 (pin 2).

Conditioned 3.3 V frame trigger from the board's input Schmitt into U702 (pin 2).

Camera pins 5 (opto ground) and 6 (ground) both land here, with the logic and ESD returns.

Must be a 5 V rail: the Line 0 opto drive level (R703) and both ESD clamps' VBUS reference.

100 ohm tap (R709) on L2, camera Line 2, the open-drain exposure output.

100 ohm tap (R708) on L1_BUF, camera Line 1 OPTOOUT after the Schmitt buffer.

100 ohm tap (R707) on L0, camera Line 0 OPTOIN: the sync drive.

Exposure-active output: CAM_OUT through R705 (470 ohm); the BNC itself is the board's.

# INTERFACES

Logic rail for U701A, U702, U703 and the L2/L1 pull-ups; always-on if the taps must read before firmware.

D

E

F

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

# INTERNAL NETS

One FLIR Blackfly S camera GPIO channel (trigger, sync, exposure output, instrument taps) on a 6-position 3.5 mm Phoenix header; the connector because the block owns L0, L1 and L2 (layout convention 10). Place one block per camera; the horizontal variant's plug needs the board edge its wire exit faces.

# DESIGN CONTRACT

Camera side: J701's terminal numbers are the camera's Hirose HR10A-7R-6PB pin numbers, wired with the FLIR 1 m flying-lead GPIO cable into

the anchor connector_center is the same point for both.

3.5 mm, origin at the pad-array centre), so the variant swaps only the connector's body, courtyard and 3D model; every pad, track and via stays, and

OW-CONN-1844252 (Phoenix MC 1,5/6-G-3,5, side entry toward the footprint's +Y). The two footprints are pad-identical (six 1.8 x 3.6 mm ovals on

Variants (family.json): mcv6_vertical fits J701 = OW-CONN-TBH-1X06-3P5-VERT (Phoenix MCV 1,5/6-G-3,5, top entry); mc6_horizontal fits

V rail: it is the clamp reference and the opto drive level, and feeds nothing else.

pF per line; both I/O pins of each pair are wired to the node, so the footprint's paired pads need no track between them. +5V must therefore be a 5 pulled up by R702 (4.7 k) and buffered 2A -> 2Y into L1_BUF for its tap.

R706 (680 ohm: about (3.3 - 2.1) / 680 = 1.8 mA, LED on while exposure is active) and the OUT_INST tap. Line 1 (OPTOOUT, LineSource Off) is

Exposure output: camera Line 2 (LineMode Output, LineSource ExposureActive, V3_3Enable false, so open drain) is pulled up by R701 (1 k) to

5.5 V-tolerant I/O.

L0, pulled to +5V by R703 (820 ohm): 5 V across 820 ohm is about 6 mA, less by the opto input's forward drop. Both drivers run from +3.3V with

Line 3; camera settings TriggerSelector FrameStart, TriggerSource Line3 RisingEdge. Sync path: SYNC_IN -> U703 (SN74LVC1G07 open drain) ->

4 white Line 1 (OPTOOUT), pin 5 blue opto ground and pin 6 brown ground, both on GND (common-ground wiring).

a Phoenix MC 1,5/6-ST-3,5 plug: pin 1 green Line 3 (GPI, trigger), pin 2 black Line 0 (OPTOIN, sync), pin 3 red Line 2 (GPIO, exposure output), pin

on CAM_OUT_BNC, the conditioned 3.3 V TRIG_IN and SYNC_IN, and the instrument port behind the five 100 ohm taps; the three pull-ups are inside

# OPERATION

+3.3V and squared by Schmitt U701A 1A -> 1Y = CAM_OUT, which drives the BNC through R705 (470 ohm), the green LED D701 through

Trigger path: TRIG_IN -> U702 (SN74LVC1G125, OE pin 1 grounded, so always enabled) -> L3_DRV -> R704 (220 ohm) -> L3 -> camera

The placing board provides +3.3V (bind it to the always-on rail when the taps must be observable before firmware runs), a 5 V rail on +5V, the BNC

LED_A: LED anode: R706 (680 ohm) from CAM_OUT, so D701 lights while exposure is active.

L1: Camera pin 4, Line 1 OPTOOUT, pulled up to +3.3V by R702 (4.7 k), into Schmitt 2A, clamped by U705.

CAM_OUT: Buffered Line 2 (exposure active) from U701A 1Y; drives the BNC resistor, the LED resistor and the OUT tap.

L3_DRV: U702 Y, the trigger drive before the 220 ohm series resistor.

L1_BUF: Schmitt 2Y: buffered Line 1 for the L1_INST tap.

ESD: two USBLC6-2P6 arrays with VBUS on +5V clamp L3 and L0 (U704) and L2 and L1 (U705), 15 kV IEC 61000-4-2 level 4, at most 3.5

L3: Camera pin 1, Line 3 GPI trigger, driven by U702 through R704 (220 ohm), clamped by U704.

L2: Camera pin 3, Line 2 as open-drain exposure output, pulled up by R701 (1 k), into Schmitt 1A, clamped by U705.

L0: Camera pin 2, Line 0 OPTOIN: open-drain U703 Y, pulled to +5V by R703 (820 ohm), clamped by U704.

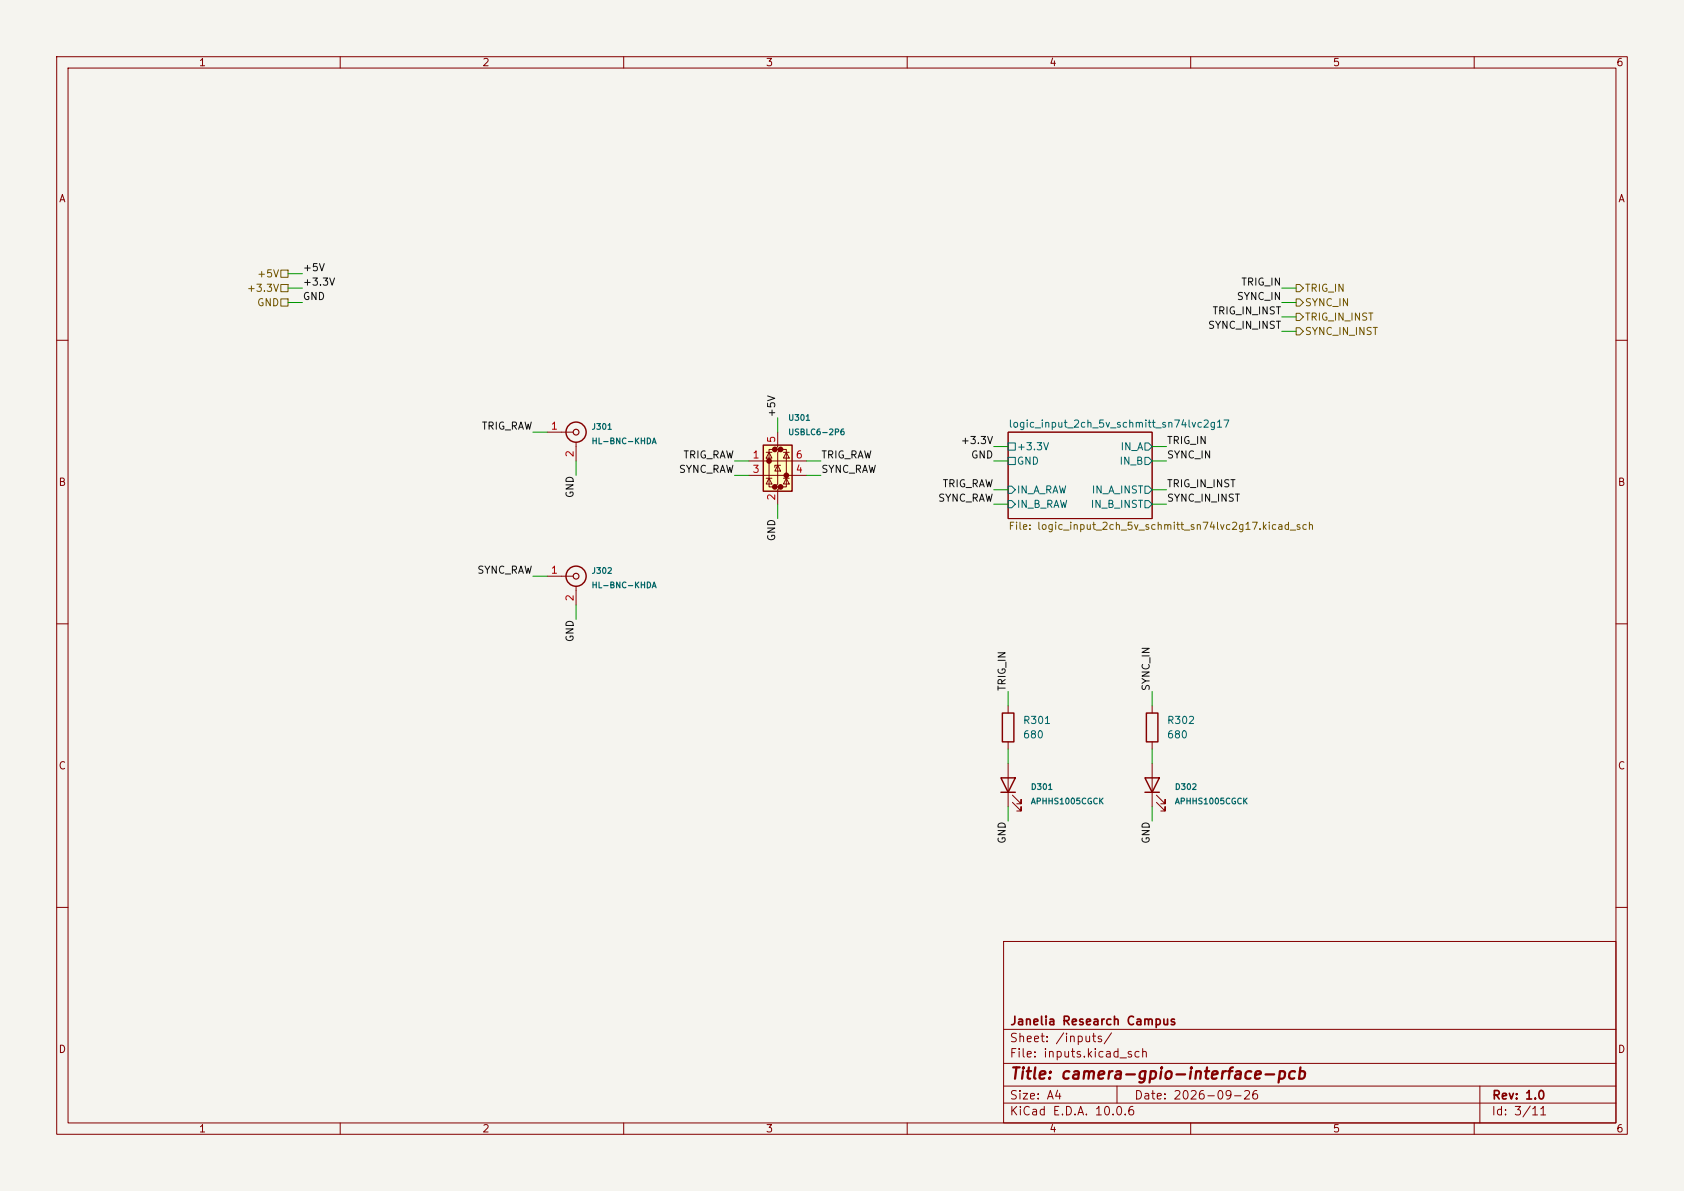
[picture p22: page 11]

Janelia Research Campus
Sheet: /inputs/
File: inputs.kicad_sch
Title: camera-gpio-interface-pcb

Size: A4 | Date: 2026-09-26 | Rev: 1.0
KiCad E.D.A. 10.0.6 | | Id: 3/11

1 | 2 | 3 | 4 | 5 | 6 | 7 | 8 | 9 | 10 | 11
1 | 2 | 3 | 4 | 5 | 6 | 7 | 8 | 9 | 10 | 11

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
| Date: 2026-10-04
KiCad E.D.A. 10.0.6 | | Id: 11/11
Size: A2 | Rev: Source migration 1

## Title: Two-channel Schmitt logic input

### File: logic_input_2ch_5v_schmitt_sn74lvc2g17.kicad_sch

### Sheet: /inputs/logic_input_2ch_5v_schmitt_sn74lvc2g17/

### Orb Weaver

### Migrated from the saved library sheet; circuit and PCB unchanged

### Circuit and PCB layout guidance

1A

1
1Y

6

U1101A

SN74LVC2G17DRYR

R1105

100k

C1103

100nF

C1101

470pF

R1103

4.7k

R1106

100k

R1108

100

R1107

100

C1102

# 470pFGND

## 2 VCC

5

U1101C

SN74LVC2G17DRYR

R1101

100k

2A

3
2Y

4

U1101B

SN74LVC2G17DRYR

R1104

4.7k

R1102

100k

IN_B_INST

IN_A

IN_B

IN_A_INST

GND

+3.3V

IN_A_RAW

IN_B_RAW

IN_B_FILT

IN_B

GND

IN_A_INSTIN_A

IN_B_RAW

IN_A

GND

IN_B_FILT

IN_B_FILT

IN_B_RAW

GND IN_A_FILT

IN_A_FILT

IN_B_INST

GND
IN_A

IN_B

IN_B_RAW

IN_A_RAW

IN_B

GND

+3.3V

GND

IN_A_INST

IN_B_INST

IN_A

IN_A_RAW

+3.3VGND

IN_A_FILT

+3.3VGND

IN_BGND

IN_A_RAW

First consumer: camera-gpio-interface-pcb, TRIG IN and SYNC IN BNCs from a pyControl breakout on IN_A_RAW/IN_B_RAW, TRIG_IN/SYNC_IN out, taps

Tolerance: inputs are rated 0 to 5.5 V at any valid VCC, 6.5 V absolute maximum, with no clamp diode to VCC, so a 5 V source plugged in by mistake is legal; a source held below ground draws about 0.2 mA per volt through the 4.7 kohm (a -5 V DAC output about 1 mA), and a short to a 36 V rail

Filter: 4.7 kohm and 470 pF give a 72 kHz corner and about 2 us from a 3.3 V edge to the Schmitt threshold, the same on both channels so their

Rails are generic labels: bind +3.3V to the always-on rail when the taps must be observable before firmware runs, or to the switched domain when

ground reference.

the consumer of IN_A/IN_B can be powered down and must rise and fall with it; sequencing between source and buffer is a non-issue because Ioff

on DIG0/DIG1 of the digital-50 InstrumentPort.
Series resistors and filter capacitors on the input edge, the 2G17 and its decoupling in the middle, output pull-downs and taps on the output edge, so harness-side nets stay on one edge and logic and tap nets leave on the other. Keep the input pair away from motor bridge outputs and give it a

PLACE: Series resistors and filter capacitors on the input edge of the block, C1101 with

V, so a 3.3 V microcontroller pin clears the high threshold by 0.9 V or more and a 5 V TTL-level VOH of 2.4 V by 0.4 V.

field edge violates and double-triggers; the 2G17 has no such limit and 0.4 V minimum hysteresis at 3 V. Thresholds VT+ <= 2.0 V and VT- >= 0.8

The Schmitt input is the point of the block: an ordinary LVC buffer specifies a maximum input transition rate of about 8 ns/V, which a slow or noisy

V or 5 V field-wired logic signal into clean 3.3 V logic, with a 100 ohm InstrumentPort tap on each output. Generic sibling of

relative timing is preserved; 470 pF suits sub-10 kHz timing edges on long unshielded leads, swap C1101/C1102 for a faster corner when the the _INST ports, INSTRUMENT netclass from the instrument-taps profile; C1103 100 nF (OW-CAP-100N-0402-X5R-16V, C162178) hard against downstream buffer never sees a floating input when this rail is down; R1107/R1108 100 ohm T-taps (OW-PASS-0402WGF1000TCE, C25076) to reads low without forming a divider that eats VIH margin; R1105/R1106 100 kohm pull-down on each output for Ioff high-Z, so an always-on

R1101/R1102 100 kohm pull-down (OW-PASS-RC0402JR-07100KL, C106234) on the harness side of the series resistor, so an unplugged input

Per channel: R1103/R1104 4.7 kohm series (OW-RES-4K7-0402, C25900) into C1101/C1102 470 pF C0G to ground

tapped through R1107 (100 ohm) to IN_A_INST; channel B is R1104, C1102, 2A (pin 3), 2Y (pin 4), IN_B and R1108 to IN_B_INST.

Signal path, per channel: IN_A_RAW -> R1103 (4.7 k) -> IN_A_FILT (C1101 470 pF to GND) -> U1101A 1A (pin 1) -> 1Y (pin 6) -> IN_A,

IN_A_RAW and IN_B_RAW, take conditioned 3.3 V logic out on IN_A and IN_B and the taps out on IN_A_INST and IN_B_INST; rails +3.3V and GND.

Power unit

mm vias.

ROUTE: IN_B_FILT stays inside the block.

PLACE: Mirror channel A on the input edge so both channels see the same copper and the

Input series filter resistor, 4.7 k

### 3. Output pull-downs and instrument taps

ROUTE: +3.3V carries PWR_3V3_LOCAL; the block's baseline is 0.2 mm tracks and 0.6/0.3

The same network for channel B into 2A; R1102 holds IN_B_RAW low when unplugged.

### 2. Channel B input filter

Two-channel single-ended logic input conditioner: per-channel series/RC filtering plus an SN74LVC2G17 dual Schmitt-trigger buffer that turns a 3.3 V or 5 V field-wired logic signal into clean 3.3 V logic, with a 100 ohm InstrumentPort tap on each output.

Two-channel Schmitt logic input | 4.7 k / 470 pF filters, SN74LVC2G17, pull-downs and taps

vias.

hard against pin 5 with a short return to pin 2; +3.3V and GND reach the block through

Project-local pending bench verification; promotable once a second board uses it.

Input series filter resistor, 4.7 k | Instrument tap series resistor

same delay.

pull-down, 100 k

Input idle-low

a short return to GND at the buffer's pin 2 side; keep the raw pair away from motor bridge

Two-channel single-ended logic input conditioner: per-channel series/RC filtering plus an SN74LVC2G17 dual Schmitt-trigger buffer that turns a 3.3

1A; R1101 holds IN_A_RAW low when nothing is plugged in.

R1103 in series with the raw input into C1101 to GND forms the 72 kHz low-pass at

### 1. Channel A input filter

Matching net labels are connected. Group order explains function; PCB placement priorities are stated below.

PLACE: Output pull-downs and taps on the output edge, so logic and tap nets leave on the

pull-down, 100 k

outputs with a ground reference beside it.

Instrument tap series resistor

ROUTE: IN_A_RAW and IN_B_RAW enter as tracks (harness side); IN_A_FILT stays inside the

is bounded to about 7 mA and destroys a 0.19 USD buffer instead of the consumer.

block.

R1106: Output pull-down, unpowered state

U1101C pin 5.

PLACE: U1101A in the middle of the block between the input and output edges, C1103

U1101A gates A (1A to 1Y) and B (2A to 2Y) square the filtered inputs into 3.3 V logic;

R1105: Output pull-down, unpowered state

C1101: Input low-pass capacitor, 72 kHz with 4.7 k

C1103 (100 nF) bypasses VCC (pin 5) to GND (pin 2).

signal needs it (27 pF gives 1.25 MHz).

side opposite the harness.

Unit 1: Schmitt-trigger buffer

ROUTE: IN_A, IN_B, IN_A_INST and IN_B_INST leave through vias (port copper); the taps carry the INSTRUMENT class, the two tap stubs are 0.15 mm.

Unit 2: Schmitt-trigger buffer
C1102: Input low-pass capacitor, 72 kHz with 4.7 k

### DESIGN CONTRACT

### INTERFACES

U1101A

C1103: VCC bypass for

V is bounded to about 7 mA into the buffer.

### 4. Schmitt buffer and supply bypass

disables the outputs when the part is unpowered.

sync inputs, sensor and switch logic lines and any other pair of inputs a board conditions; use the encoder block when the harness also carries the quadrature_encoder_input_5v_sn74lvc2g17: same circuit and values, generic names, no encoder-supply passthrough. Use this one for BNC trigger and

### OPERATION

which is why the sequencing between source and buffer does not matter. C1103 (100 nF) bypasses pin 5.

Supply: VCC 1.65 to 5.5 V, 10 uA max, +/-24 mA drive at 3 V; Ioff (10 uA max) keeps the outputs off a live downstream input when the rail is down, absolute), so a 5 V source is legal; a source below ground draws about 0.2 mA per volt through the 4.7 k (about 1 mA from -5 V), and a short to 36

The Schmitt input is the point: at VCC = 3 V, VT+ is 1.3 to 2.0 V and VT- 0.8 to 1.3 V with at least 0.4 V of hysteresis, so slow or noisy field edges

(OW-CAP-470P-0402-C0G-100V, C1518202) and U1101A SN74LVC2G17DRYR gate A/B (OW-MISC-SN74LVC2G17DRYR, C2675856);

us later, the same on both channels, so relative timing is kept. For faster edges swap C1101/C1102 (27 pF gives about 1.25 MHz).

R1105/R1106 (100 k) define the outputs when +3.3V is off.

R1101/R1102 (100 k) pull the raw inputs low when unplugged, on the harness side of the series resistor so no divider eats VIH margin;

cannot double-trigger; a 3.3 V source clears VT+ by at least 1.3 V, a 5 V TTL VOH of 2.4 V by 0.4 V. Inputs are rated 0 to 5.5 V at any VCC (6.5 V

Filter: 4.7 k and 470 pF give a time constant of about 2.2 us and a corner near 72 kHz; a 3.3 V edge reaches the worst-case VT+ of 2.0 V about 2

encoder supply; place this block twice for four inputs. Connector-agnostic: the jack or terminal lives on the board sheet. Bring the raw lines in on

Instrument tap of IN_B through R1108 (100 ohm), INSTRUMENT class.

Instrument tap of IN_A through R1107 (100 ohm), INSTRUMENT class.

Conditioned channel B, 3.3 V logic from 2Y (pin 4); pulled down by R1106 when the rail is off.

Conditioned channel A, 3.3 V logic from 1Y (pin 6); pulled down by R1105 when the rail is off.

Field-wired channel B input, 0 to 5.5 V legal at any VCC; pulled low by R1102 (100 k) when unplugged.

Field-wired channel A input, 0 to 5.5 V legal at any VCC; pulled low by R1101 (100 k) when unplugged.

Return for the buffer (pin 2), both filter capacitors and the four pull-downs.

IN_A/IN_B powers down with it (Ioff keeps the unpowered outputs off the bus).

Buffer supply (VCC, pin 5), 1.65 to 5.5 V; always-on when the taps must be observable before firmware runs, switched when the consumer of

R1105/R1106 (100 k) define IN_A/IN_B while the buffer is unpowered; R1107/R1108 (100 ohm) are the series taps to IN_A_INST and IN_B_INST.

Input idle-low

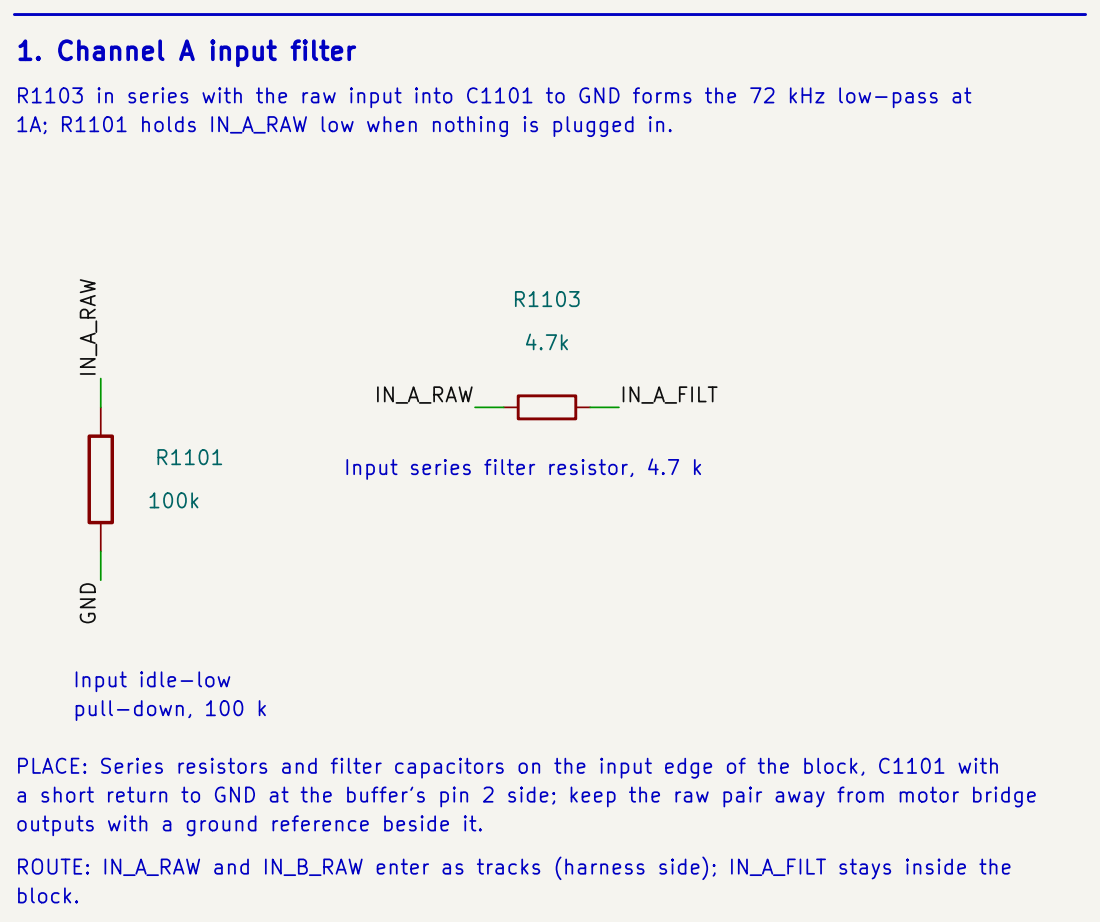
[picture p23: page 13]

R1103 in series with the raw input into C1101 to GND forms the 72 kHz low-pass at
1A; R1101 holds IN_A_RAW low when nothing is plugged in.

PLACE: Series resistors and filter capacitors on the input edge of the block, C1101 with
a short return to GND at the buffer's pin 2 side; keep the raw pair away from motor bridge
outputs with a ground reference beside it.
ROUTE: IN_A_RAW and IN_B_RAW enter as tracks (harness side); IN_A_FILT stays inside the
block.

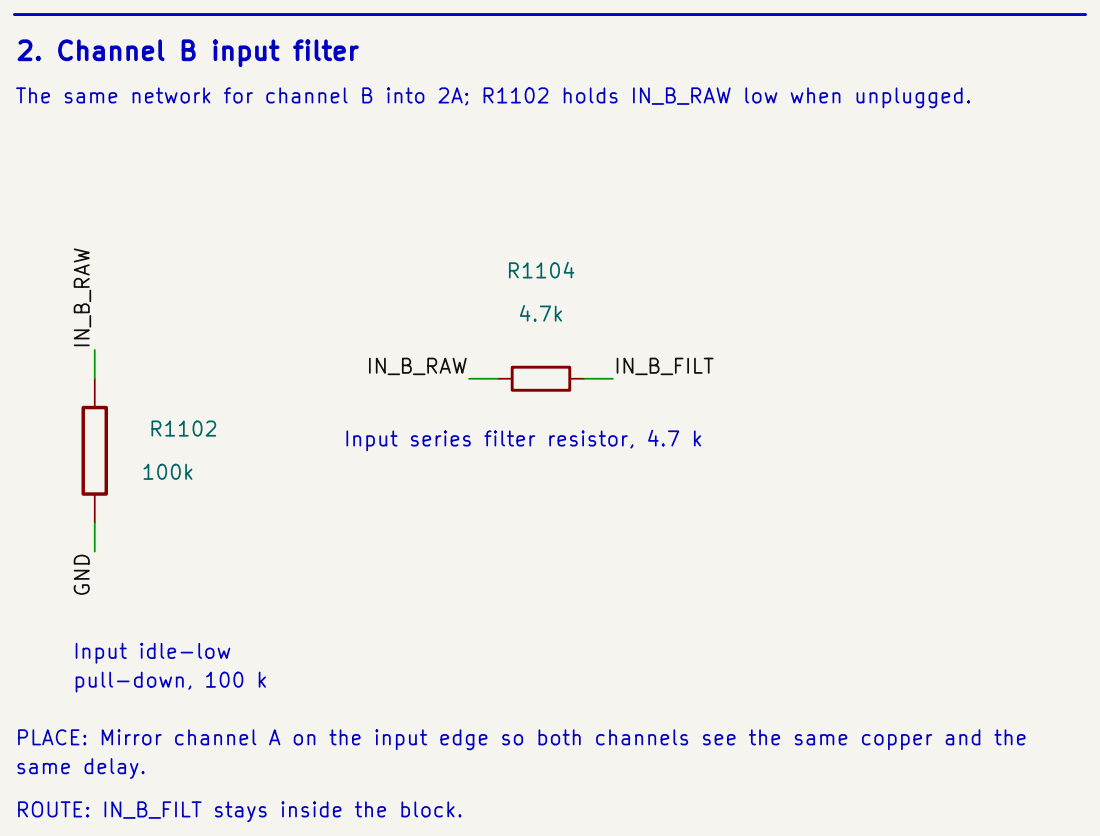
[picture p24: page 14]

The same network for channel B into 2A; R1102 holds IN_B_RAW low when unplugged.

Input series filter resistor, 4.7 k

PLACE: Mirror channel A on the input edge so both channels see the same copper and the
same delay.

ROUTE: IN_B_FILT stays inside the block.

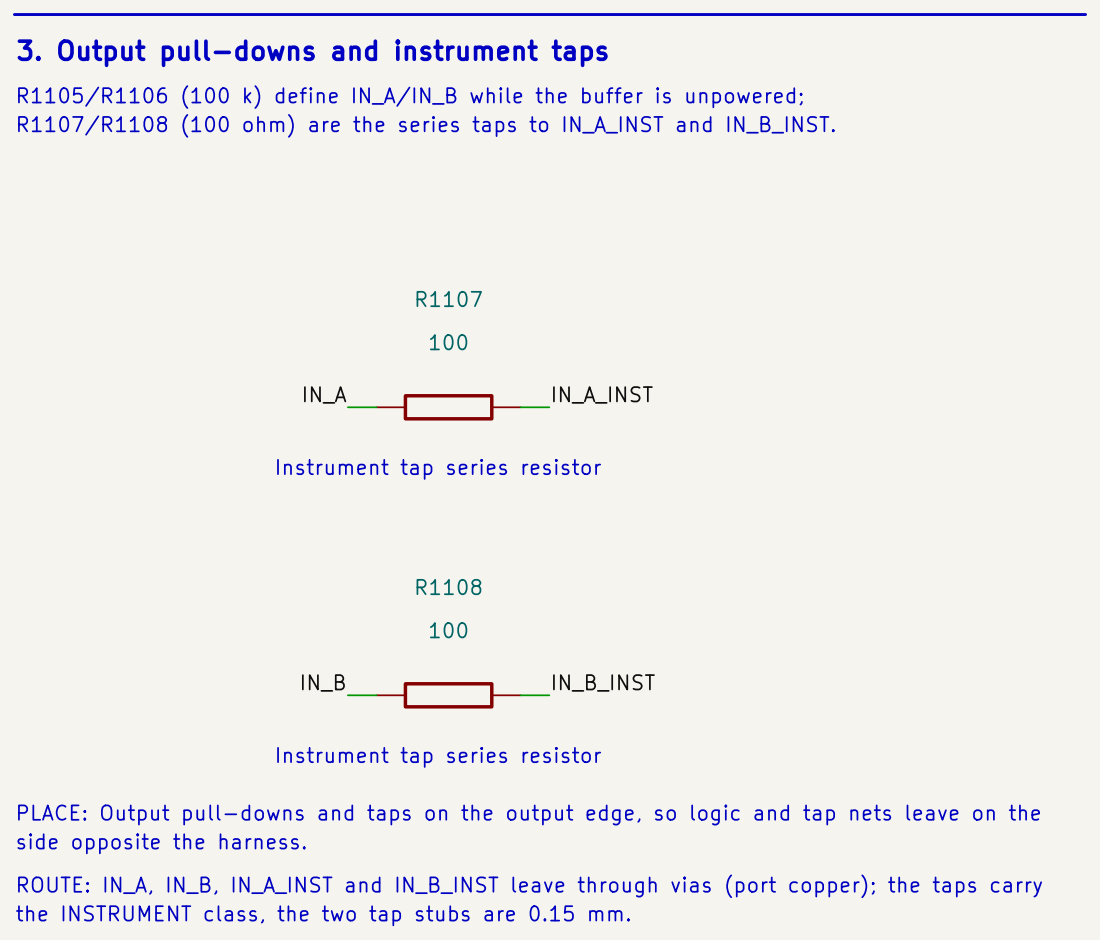
[picture p25: page 15]

3. Output pull-downs and instrument taps

R1105/R1106 (100 k) define IN_A/IN_B while the buffer is unpowered;
R1107/R1108 (100 ohm) are the series taps to IN_A_INST and IN_B_INST.

Instrument tap series resistor

PLACE: Output pull-downs and taps on the output edge, so logic and tap nets leave on the
side opposite the harness.
ROUTE: IN_A, IN_B, IN_A_INST and IN_B_INST leave through vias (port copper); the taps carry
the INSTRUMENT class, the two tap stubs are 0.15 mm.

1A 1

1Y 6

U1101A

### SN74LVC2G17DRYR

R1105

100k

C1103

100nF

C1101

470pF

R1106

100k

C1102

# 470pFGND

# 2 VCC

5

U1101C

### SN74LVC2G17DRYR

2A 3

2Y 4

U1101B

### SN74LVC2G17DRYR

### IN_B_INST

### IN_A

### IN_B

### IN_A_INST

### GND

+3.3V

### IN_A_RAW

### IN_B_RAW

### IN_B_FILT

### IN_A

GND

### IN_B_FILT

### GND IN_A_FILT

### IN_A_FILT

GND

### IN_A

### IN_B

### IN_B_RAW

### IN_A_RAW

### IN_B

### GND

+3.3V

### IN_A_INST

### IN_B_INST

### IN_A

### +3.3VGND

### +3.3VGND

### IN_BGND

Tolerance: inputs are rated 0 to 5.5 V at any valid VCC, 6.5 V absolute maximum, with no clamp diode to VCC, so a 5 V source plugged in by mistake is legal; a source held below ground draws about 0.2 mA per volt through the 4.7 kohm (a -5 V DAC output about 1 mA), and a short to a 36 V rail

Filter: 4.7 kohm and 470 pF give a 72 kHz corner and about 2 us from a 3.3 V edge to the Schmitt threshold, the same on both channels so their

Rails are generic labels: bind +3.3V to the always-on rail when the taps must be observable before firmware runs, or to the switched domain when the consumer of IN_A/IN_B can be powered down and must rise and fall with it; sequencing between source and buffer is a non-issue because Ioff

V, so a 3.3 V microcontroller pin clears the high threshold by 0.9 V or more and a 5 V TTL-level VOH of 2.4 V by 0.4 V.

field edge violates and double-triggers; the 2G17 has no such limit and 0.4 V minimum hysteresis at 3 V. Thresholds VT+ <= 2.0 V and VT- >= 0.8

The Schmitt input is the point of the block: an ordinary LVC buffer specifies a maximum input transition rate of about 8 ns/V, which a slow or noisy

V or 5 V field-wired logic signal into clean 3.3 V logic, with a 100 ohm InstrumentPort tap on each output. Generic sibling of

relative timing is preserved; 470 pF suits sub-10 kHz timing edges on long unshielded leads, swap C1101/C1102 for a faster corner when the the _INST ports, INSTRUMENT netclass from the instrument-taps profile; C1103 100 nF (OW-CAP-100N-0402-X5R-16V, C162178) hard against downstream buffer never sees a floating input when this rail is down; R1107/R1108 100 ohm T-taps (OW-PASS-0402WGF1000TCE, C25076) to reads low without forming a divider that eats VIH margin; R1105/R1106 100 kohm pull-down on each output for Ioff high-Z, so an always-on

R1101/R1102 100 kohm pull-down (OW-PASS-RC0402JR-07100KL, C106234) on the harness side of the series resistor, so an unplugged input

Per channel: R1103/R1104 4.7 kohm series (OW-RES-4K7-0402, C25900) into C1101/C1102 470 pF C0G to ground

tapped through R1107 (100 ohm) to IN_A_INST; channel B is R1104, C1102, 2A (pin 3), 2Y (pin 4), IN_B and R1108 to IN_B_INST.

Signal path, per channel: IN_A_RAW -> R1103 (4.7 k) -> IN_A_FILT (C1101 470 pF to GND) -> U1101A 1A (pin 1) -> 1Y (pin 6) -> IN_A,

IN_A_RAW and IN_B_RAW, take conditioned 3.3 V logic out on IN_A and IN_B and the taps out on IN_A_INST and IN_B_INST; rails +3.3V and GND.

### Power unit

mm vias.

### ROUTE: +3.3V carries PWR_3V3_LOCAL; the block's baseline is 0.2 mm tracks and 0.6/0.3

vias.

### hard against pin 5 with a short return to pin 2; +3.3V and GND reach the block through

Two-channel single-ended logic input conditioner: per-channel series/RC filtering plus an SN74LVC2G17 dual Schmitt-trigger buffer that turns a 3.3

is bounded to about 7 mA and destroys a 0.19 USD buffer instead of the consumer.

### R1106: Output pull-down, unpowered state

U1101C pin 5.

### PLACE: U1101A in the middle of the block between the input and output edges, C1103

U1101A gates A (1A to 1Y) and B (2A to 2Y) square the filtered inputs into 3.3 V logic;

### R1105: Output pull-down, unpowered state

### C1101: Input low-pass capacitor, 72 kHz with 4.7 k

C1103 (100 nF) bypasses VCC (pin 5) to GND (pin 2).

signal needs it (27 pF gives 1.25 MHz).

### Unit 1: Schmitt-trigger buffer

### Unit 2: Schmitt-trigger buffer C1102: Input low-pass capacitor, 72 kHz with 4.7 k

## DESIGN CONTRACT

## INTERFACES

U1101A

### C1103: VCC bypass for

V is bounded to about 7 mA into the buffer.

## 4. Schmitt buffer and supply bypass

disables the outputs when the part is unpowered.

sync inputs, sensor and switch logic lines and any other pair of inputs a board conditions; use the encoder block when the harness also carries the quadrature_encoder_input_5v_sn74lvc2g17: same circuit and values, generic names, no encoder-supply passthrough. Use this one for BNC trigger and

## OPERATION

which is why the sequencing between source and buffer does not matter. C1103 (100 nF) bypasses pin 5.

Supply: VCC 1.65 to 5.5 V, 10 uA max, +/-24 mA drive at 3 V; Ioff (10 uA max) keeps the outputs off a live downstream input when the rail is down, absolute), so a 5 V source is legal; a source below ground draws about 0.2 mA per volt through the 4.7 k (about 1 mA from -5 V), and a short to 36

The Schmitt input is the point: at VCC = 3 V, VT+ is 1.3 to 2.0 V and VT- 0.8 to 1.3 V with at least 0.4 V of hysteresis, so slow or noisy field edges

(OW-CAP-470P-0402-C0G-100V, C1518202) and U1101A SN74LVC2G17DRYR gate A/B (OW-MISC-SN74LVC2G17DRYR, C2675856);

us later, the same on both channels, so relative timing is kept. For faster edges swap C1101/C1102 (27 pF gives about 1.25 MHz).

R1105/R1106 (100 k) define the outputs when +3.3V is off.

R1101/R1102 (100 k) pull the raw inputs low when unplugged, on the harness side of the series resistor so no divider eats VIH margin;

cannot double-trigger; a 3.3 V source clears VT+ by at least 1.3 V, a 5 V TTL VOH of 2.4 V by 0.4 V. Inputs are rated 0 to 5.5 V at any VCC (6.5 V

Filter: 4.7 k and 470 pF give a time constant of about 2.2 us and a corner near 72 kHz; a 3.3 V edge reaches the worst-case VT+ of 2.0 V about 2

encoder supply; place this block twice for four inputs. Connector-agnostic: the jack or terminal lives on the board sheet. Bring the raw lines in on

Instrument tap of IN_B through R1108 (100 ohm), INSTRUMENT class.

Instrument tap of IN_A through R1107 (100 ohm), INSTRUMENT class.

Conditioned channel B, 3.3 V logic from 2Y (pin 4); pulled down by R1106 when the rail is off.

Conditioned channel A, 3.3 V logic from 1Y (pin 6); pulled down by R1105 when the rail is off.

Field-wired channel B input, 0 to 5.5 V legal at any VCC; pulled low by R1102 (100 k) when unplugged.

Field-wired channel A input, 0 to 5.5 V legal at any VCC; pulled low by R1101 (100 k) when unplugged.

Return for the buffer (pin 2), both filter capacitors and the four pull-downs.

IN_A/IN_B powers down with it (Ioff keeps the unpowered outputs off the bus).

Buffer supply (VCC, pin 5), 1.65 to 5.5 V; always-on when the taps must be observable before firmware runs, switched when the consumer of

# IN_B_INST

# IN_A

# IN_B

# IN_A_INST

# GND

+3.3V

# IN_A_RAW

# IN_B_RAW

# IN_A

# IN_B_RAW

# IN_A_RAW

# IN_B

# GND

+3.3V

# IN_A_INST

# IN_B_INST

# INTERFACES

Instrument tap of IN_B through R1108 (100 ohm), INSTRUMENT class.

Instrument tap of IN_A through R1107 (100 ohm), INSTRUMENT class.

Conditioned channel B, 3.3 V logic from 2Y (pin 4); pulled down by R1106 when the rail is off.

Conditioned channel A, 3.3 V logic from 1Y (pin 6); pulled down by R1105 when the rail is off.

Field-wired channel B input, 0 to 5.5 V legal at any VCC; pulled low by R1102 (100 k) when unplugged.

Field-wired channel A input, 0 to 5.5 V legal at any VCC; pulled low by R1101 (100 k) when unplugged.

Return for the buffer (pin 2), both filter capacitors and the four pull-downs.

IN_A/IN_B powers down with it (Ioff keeps the unpowered outputs off the bus).

Buffer supply (VCC, pin 5), 1.65 to 5.5 V; always-on when the taps must be observable before firmware runs, switched when the consumer of

D

E

F

First consumer: camera-gpio-interface-pcb, TRIG IN and SYNC IN BNCs from a pyControl breakout on IN_A_RAW/IN_B_RAW, TRIG_IN/SYNC_IN out, taps

Tolerance: inputs are rated 0 to 5.5 V at any valid VCC, 6.5 V absolute maximum, with no clamp diode to VCC, so a 5 V source plugged in by mistake is legal; a source held below ground draws about 0.2 mA per volt through the 4.7 kohm (a -5 V DAC output about 1 mA), and a short to a 36 V rail

Filter: 4.7 kohm and 470 pF give a 72 kHz corner and about 2 us from a 3.3 V edge to the Schmitt threshold, the same on both channels so their

Rails are generic labels: bind +3.3V to the always-on rail when the taps must be observable before firmware runs, or to the switched domain when

ground reference.

the consumer of IN_A/IN_B can be powered down and must rise and fall with it; sequencing between source and buffer is a non-issue because Ioff

on DIG0/DIG1 of the digital-50 InstrumentPort.
Series resistors and filter capacitors on the input edge, the 2G17 and its decoupling in the middle, output pull-downs and taps on the output edge, so harness-side nets stay on one edge and logic and tap nets leave on the other. Keep the input pair away from motor bridge outputs and give it a

V, so a 3.3 V microcontroller pin clears the high threshold by 0.9 V or more and a 5 V TTL-level VOH of 2.4 V by 0.4 V.

field edge violates and double-triggers; the 2G17 has no such limit and 0.4 V minimum hysteresis at 3 V. Thresholds VT+ <= 2.0 V and VT- >= 0.8

The Schmitt input is the point of the block: an ordinary LVC buffer specifies a maximum input transition rate of about 8 ns/V, which a slow or noisy

V or 5 V field-wired logic signal into clean 3.3 V logic, with a 100 ohm InstrumentPort tap on each output. Generic sibling of

relative timing is preserved; 470 pF suits sub-10 kHz timing edges on long unshielded leads, swap C1101/C1102 for a faster corner when the the _INST ports, INSTRUMENT netclass from the instrument-taps profile; C1103 100 nF (OW-CAP-100N-0402-X5R-16V, C162178) hard against downstream buffer never sees a floating input when this rail is down; R1107/R1108 100 ohm T-taps (OW-PASS-0402WGF1000TCE, C25076) to reads low without forming a divider that eats VIH margin; R1105/R1106 100 kohm pull-down on each output for Ioff high-Z, so an always-on

R1101/R1102 100 kohm pull-down (OW-PASS-RC0402JR-07100KL, C106234) on the harness side of the series resistor, so an unplugged input

Per channel: R1103/R1104 4.7 kohm series (OW-RES-4K7-0402, C25900) into C1101/C1102 470 pF C0G to ground

tapped through R1107 (100 ohm) to IN_A_INST; channel B is R1104, C1102, 2A (pin 3), 2Y (pin 4), IN_B and R1108 to IN_B_INST.

Signal path, per channel: IN_A_RAW -> R1103 (4.7 k) -> IN_A_FILT (C1101 470 pF to GND) -> U1101A 1A (pin 1) -> 1Y (pin 6) -> IN_A,

IN_A_RAW and IN_B_RAW, take conditioned 3.3 V logic out on IN_A and IN_B and the taps out on IN_A_INST and IN_B_INST; rails +3.3V and GND.

Project-local pending bench verification; promotable once a second board uses it.

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

is bounded to about 7 mA and destroys a 0.19 USD buffer instead of the consumer.

U1101C pin 5.

signal needs it (27 pF gives 1.25 MHz).

# DESIGN CONTRACT

V is bounded to about 7 mA into the buffer.

disables the outputs when the part is unpowered.

sync inputs, sensor and switch logic lines and any other pair of inputs a board conditions; use the encoder block when the harness also carries the quadrature_encoder_input_5v_sn74lvc2g17: same circuit and values, generic names, no encoder-supply passthrough. Use this one for BNC trigger and

# OPERATION

which is why the sequencing between source and buffer does not matter. C1103 (100 nF) bypasses pin 5.

Supply: VCC 1.65 to 5.5 V, 10 uA max, +/-24 mA drive at 3 V; Ioff (10 uA max) keeps the outputs off a live downstream input when the rail is down, absolute), so a 5 V source is legal; a source below ground draws about 0.2 mA per volt through the 4.7 k (about 1 mA from -5 V), and a short to 36

The Schmitt input is the point: at VCC = 3 V, VT+ is 1.3 to 2.0 V and VT- 0.8 to 1.3 V with at least 0.4 V of hysteresis, so slow or noisy field edges

(OW-CAP-470P-0402-C0G-100V, C1518202) and U1101A SN74LVC2G17DRYR gate A/B (OW-MISC-SN74LVC2G17DRYR, C2675856);

us later, the same on both channels, so relative timing is kept. For faster edges swap C1101/C1102 (27 pF gives about 1.25 MHz).

R1105/R1106 (100 k) define the outputs when +3.3V is off.

R1101/R1102 (100 k) pull the raw inputs low when unplugged, on the harness side of the series resistor so no divider eats VIH margin;

cannot double-trigger; a 3.3 V source clears VT+ by at least 1.3 V, a 5 V TTL VOH of 2.4 V by 0.4 V. Inputs are rated 0 to 5.5 V at any VCC (6.5 V

Filter: 4.7 k and 470 pF give a time constant of about 2.2 us and a corner near 72 kHz; a 3.3 V edge reaches the worst-case VT+ of 2.0 V about 2

encoder supply; place this block twice for four inputs. Connector-agnostic: the jack or terminal lives on the board sheet. Bring the raw lines in on

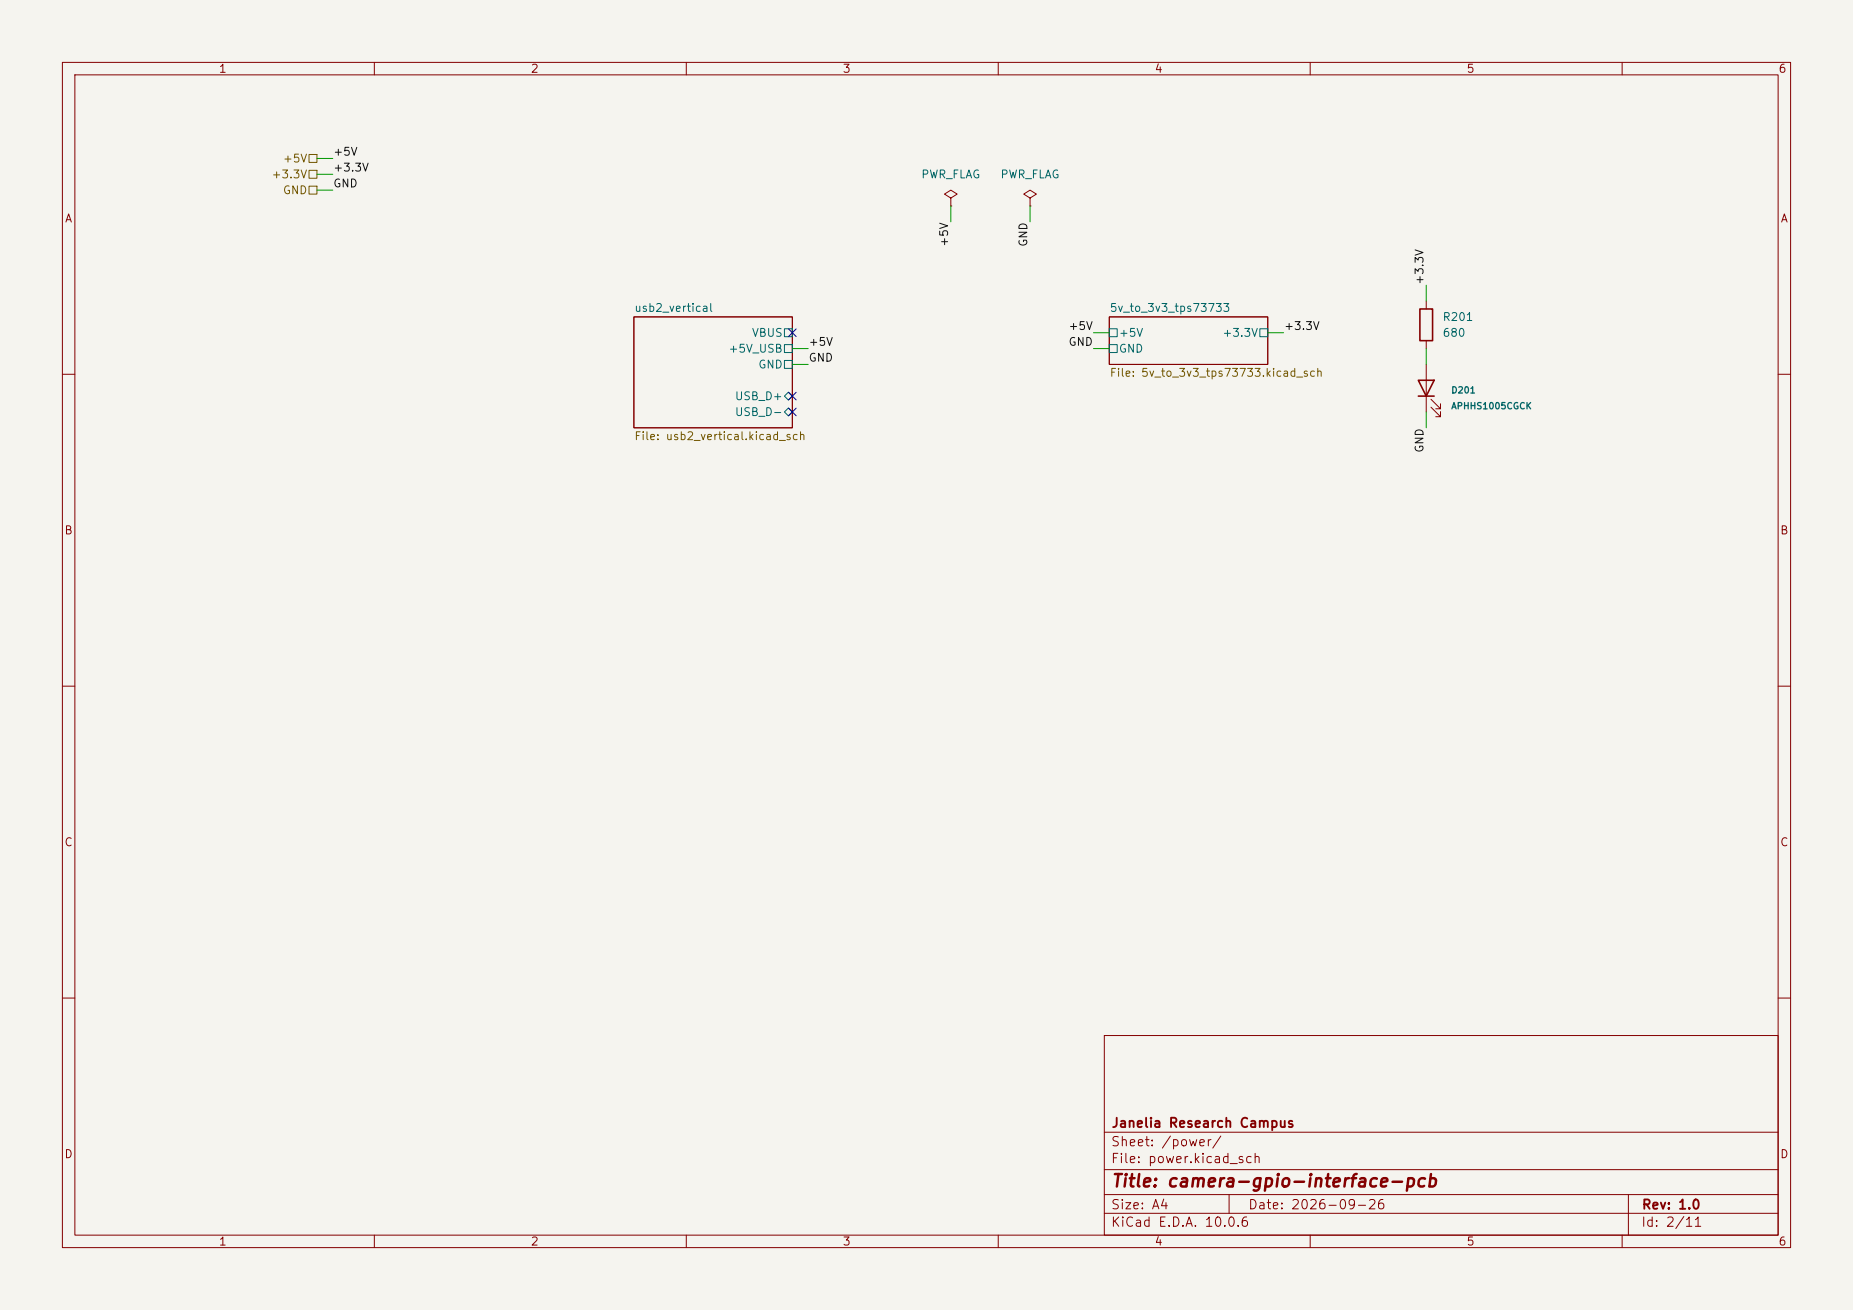
[picture p26: page 19]

Janelia Research Campus
Sheet: /power/
File: power.kicad_sch
Title: camera-gpio-interface-pcb

Size: A4 | Date: 2026-09-26 | Rev: 1.0
KiCad E.D.A. 10.0.6 | | Id: 2/11

1 | 2 | 3 | 4 | 5 | 6
1 | 2 | 3 | 4 | 5 | 6

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
| Date: 2026-10-04
KiCad E.D.A. 10.0.6 | | Id: 10/11
Size: A4 | Rev: Source migration 1

## Title: 5 V to 3.3 V regulator

### File: 5v_to_3v3_tps73733.kicad_sch

### Sheet: /power/5v_to_3v3_tps73733/

### Orb Weaver

### Migrated from the saved library sheet; circuit and PCB unchanged

### Circuit and PCB layout guidance

C1002

1uF

C1001

1uF

OUT | 1
NR | 3

GND

4

EN 5

IN 8

PAD

9

U1001

TPS73733QDRBRQ1

+5V

GND
+3.3V +5V | +3.3V

+3.3V

GND

+5V

GND

+5V

GND

+3.3V

GND

GND +5V

NR (pin 3) is left open: no noise-reduction capacitor is fitted. GND (pin 4) and

C1001 (1 uF) bypasses the input, C1002 (1 uF) is the output capacitor; both are the catalog 0402 1 uF part. The rail is rated by the TPS73733 (fixed 3.3 V, 1

Regulated output, 3.3 V fixed.

control inside this block.

the thermal pad (pin 9) return to GND.

dropout.

Input rail; also drives EN, so the regulator is on whenever it is present.

A class per the catalog description); derate for the board's actual load and

Input bypass

### DESIGN CONTRACT

Clean 3.3 V linear regulator from a 5 V input rail using the TI TPS73733 fixed 3.3 V 1 A LDO. Intended for MCU, RP2040, TMC logic, encoder interface, and other low-voltage digital circuitry.

tied to IN, so the regulator is on whenever +5V is present; there is no enable

Signal path: +5V -> U1001 (IN, pin 8) -> +3.3V (OUT, pin 1). EN (pin 5) is

Common return; regulator ground pin and thermal pad.

### OPERATION

### INTERFACES

PLACE: Place C1001 at pins 8 and 4 and C1002 at pins 1 and 4 with short local ground returns; tie the thermal pad to GND copper.

U1001 regulates +5V to +3.3V with EN tied to IN. C1001 bypasses IN to GND, C1002 holds OUT to GND; NR is open.

Fixed 3.3 V LDO

# 5 V to 3.3 V regulator | TPS73733 fixed 3.3 V LDO

Clean 3.3 V linear regulator from a 5 V input rail using the TI TPS73733 fixed 3.3 V 1 A LDO.

Matching net labels are connected. Group order explains function; PCB placement priorities are stated below.

### 1. Regulator and bypass

ROUTE: +5V and +3.3V carry the rail classes (PWR_5V_LOCAL, PWR_3V3_LOCAL); the GND return of the pad is the regulator's heat path as well.

Output capacitor

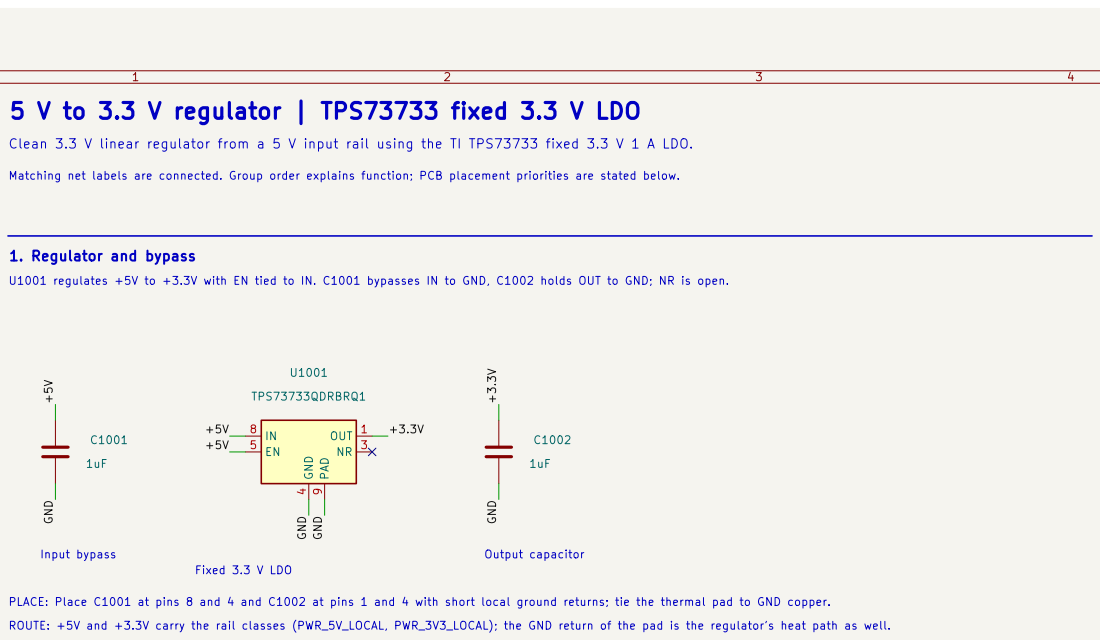
[picture p27: page 21]

5 V to 3.3 V regulator | TPS73733 fixed 3.3 V LDO

Clean 3.3 V linear regulator from a 5 V input rail using the TI TPS73733 fixed 3.3 V 1 A LDO.

Matching net labels are connected. Group order explains function; PCB placement priorities are stated below.

U1001 regulates +5V to +3.3V with EN tied to IN. C1001 bypasses IN to GND, C1002 holds OUT to GND; NR is open.

PLACE: Place C1001 at pins 8 and 4 and C1002 at pins 1 and 4 with short local ground returns; tie the thermal pad to GND copper.
ROUTE: +5V and +3.3V carry the rail classes (PWR_5V_LOCAL, PWR_3V3_LOCAL); the GND return of the pad is the regulator's heat path as well.

+5V

# GND

+3.3V

+5V

# GND

+3.3V

Regulated output, 3.3 V fixed.

Input rail; also drives EN, so the regulator is on whenever it is present.

Common return; regulator ground pin and thermal pad.

# INTERFACES

# NR (pin 3) is left open: no noise-reduction capacitor is fitted. GND (pin 4) and

# C1001 (1 uF) bypasses the input, C1002 (1 uF) is the output capacitor; both are the catalog 0402 1 uF part. The rail is rated by the TPS73733 (fixed 3.3 V, 1

control inside this block.

the thermal pad (pin 9) return to GND.

dropout.

# A class per the catalog description); derate for the board's actual load and

# DESIGN CONTRACT

# Clean 3.3 V linear regulator from a 5 V input rail using the TI TPS73733 fixed 3.3 V 1 A LDO. Intended for MCU, RP2040, TMC logic, encoder interface, and other

low-voltage digital circuitry.

# tied to IN, so the regulator is on whenever +5V is present; there is no enable

# Signal path: +5V -> U1001 (IN, pin 8) -> +3.3V (OUT, pin 1). EN (pin 5) is

# OPERATION

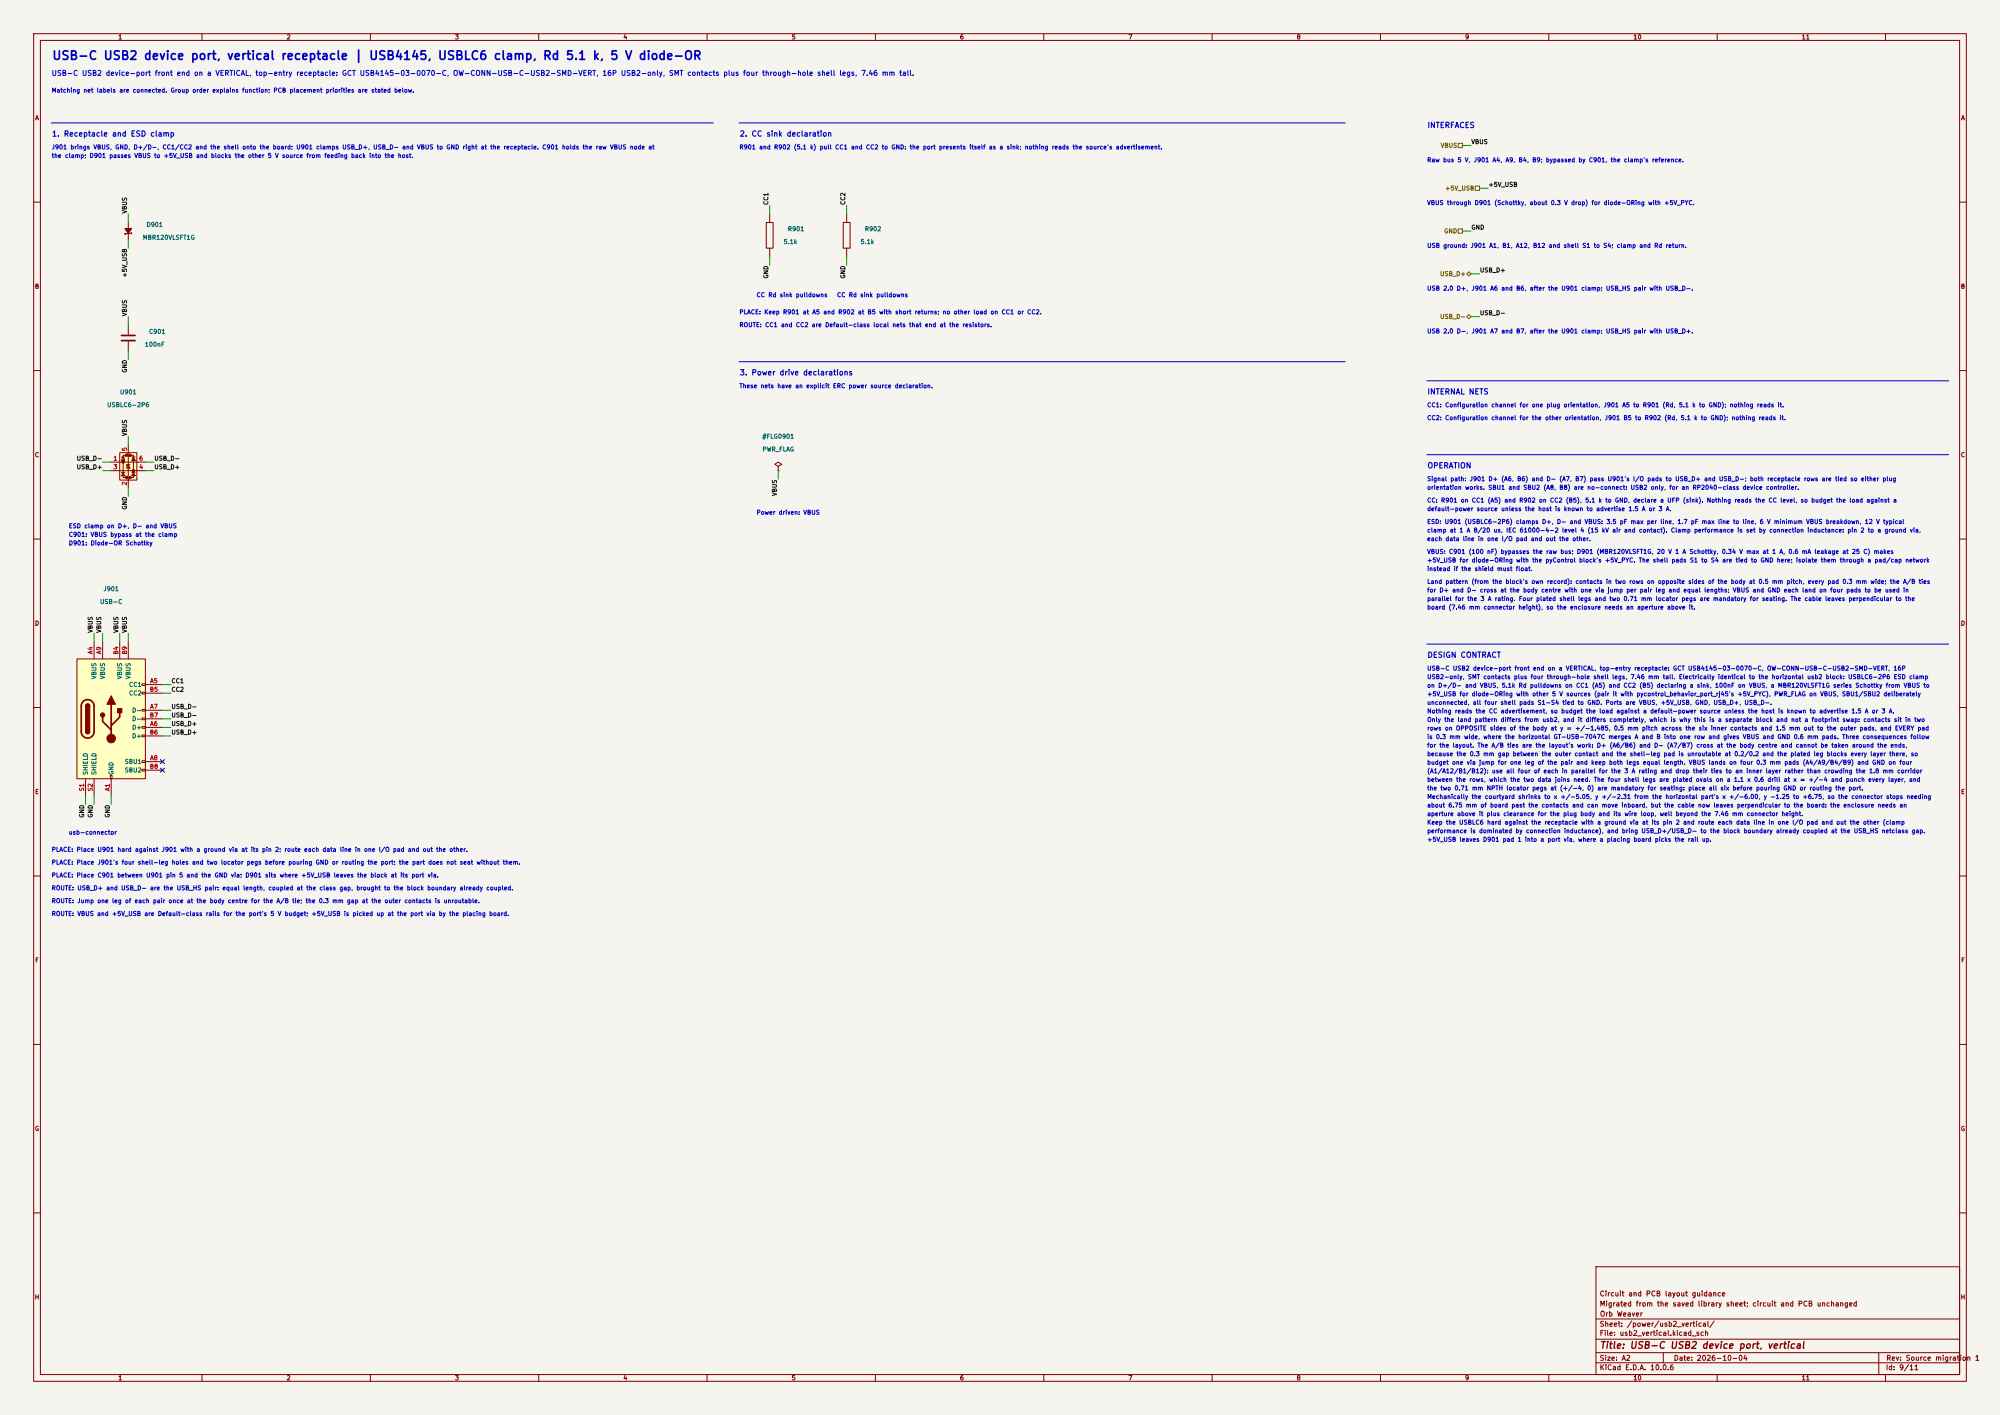
[picture p28: page 24]

USB-C USB2 device port, vertical receptacle | USB4145, USBLC6 clamp, Rd 5.1 k, 5 V diode-OR

USB-C USB2 device-port front end on a VERTICAL, top-entry receptacle: GCT USB4145-03-0070-C, OW-CONN-USB-C-USB2-SMD-VERT, 16P USB2-only, SMT contacts plus four through-hole shell legs, 7.46 mm tall.

Matching net labels are connected. Group order explains function; PCB placement priorities are stated below.

1. Receptacle and ESD clamp

J901 brings VBUS, GND, D+/D-, CC1/CC2 and the shell onto the board; U901 clamps USB_D+, USB_D- and VBUS to GND right at the receptacle. C901 holds the raw VBUS node at
the clamp; D901 passes VBUS to +5V_USB and blocks the other 5 V source from feeding back into the host.

R901 and R902 (5.1 k) pull CC1 and CC2 to GND: the port presents itself as a sink; nothing reads the source's advertisement.

Raw bus 5 V, J901 A4, A9, B4, B9; bypassed by C901, the clamp's reference.

VBUS through D901 (Schottky, about 0.3 V drop) for diode-ORing with +5V_PYC.

USB ground: J901 A1, B1, A12, B12 and shell S1 to S4; clamp and Rd return.

USB 2.0 D+, J901 A6 and B6, after the U901 clamp; USB_HS pair with USB_D-.

PLACE: Keep R901 at A5 and R902 at B5 with short returns; no other load on CC1 or CC2.

ROUTE: CC1 and CC2 are Default-class local nets that end at the resistors.

USB 2.0 D-, J901 A7 and B7, after the U901 clamp; USB_HS pair with USB_D+.

These nets have an explicit ERC power source declaration.

CC1: Configuration channel for one plug orientation, J901 A5 to R901 (Rd, 5.1 k to GND); nothing reads it.

CC2: Configuration channel for the other orientation, J901 B5 to R902 (Rd, 5.1 k to GND); nothing reads it.

Signal path: J901 D+ (A6, B6) and D- (A7, B7) pass U901's I/O pads to USB_D+ and USB_D-; both receptacle rows are tied so either plug
orientation works. SBU1 and SBU2 (A8, B8) are no-connect: USB2 only, for an RP2040-class device controller.

CC: R901 on CC1 (A5) and R902 on CC2 (B5), 5.1 k to GND, declare a UFP (sink). Nothing reads the CC level, so budget the load against a
default-power source unless the host is known to advertise 1.5 A or 3 A.

ESD clamp on D+, D- and VBUS
C901: VBUS bypass at the clamp
D901: Diode-OR Schottky

ESD: U901 (USBLC6-2P6) clamps D+, D- and VBUS: 3.5 pF max per line, 1.7 pF max line to line, 6 V minimum VBUS breakdown, 12 V typical
clamp at 1 A 8/20 us, IEC 61000-4-2 level 4 (15 kV air and contact). Clamp performance is set by connection inductance: pin 2 to a ground via,
each data line in one I/O pad and out the other.

VBUS: C901 (100 nF) bypasses the raw bus; D901 (MBR120VLSFT1G, 20 V 1 A Schottky, 0.34 V max at 1 A, 0.6 mA leakage at 25 C) makes
+5V_USB for diode-ORing with the pyControl block's +5V_PYC. The shell pads S1 to S4 are tied to GND here; isolate them through a pad/cap network
instead if the shield must float.

Land pattern (from the block's own record): contacts in two rows on opposite sides of the body at 0.5 mm pitch, every pad 0.3 mm wide; the A/B ties
for D+ and D- cross at the body centre with one via jump per pair leg and equal lengths; VBUS and GND each land on four pads to be used in
parallel for the 3 A rating. Four plated shell legs and two 0.71 mm locator pegs are mandatory for seating. The cable leaves perpendicular to the
board (7.46 mm connector height), so the enclosure needs an aperture above it.

USB-C USB2 device-port front end on a VERTICAL, top-entry receptacle: GCT USB4145-03-0070-C, OW-CONN-USB-C-USB2-SMD-VERT, 16P
USB2-only, SMT contacts plus four through-hole shell legs, 7.46 mm tall. Electrically identical to the horizontal usb2 block: USBLC6-2P6 ESD clamp
on D+/D- and VBUS, 5.1k Rd pulldowns on CC1 (A5) and CC2 (B5) declaring a sink, 100nF on VBUS, a MBR120VLSFT1G series Schottky from VBUS to
+5V_USB for diode-ORing with other 5 V sources (pair it with pycontrol_behavior_port_rj45's +5V_PYC), PWR_FLAG on VBUS, SBU1/SBU2 deliberately
unconnected, all four shell pads S1-S4 tied to GND. Ports are VBUS, +5V_USB, GND, USB_D+, USB_D-.
Nothing reads the CC advertisement, so budget the load against a default-power source unless the host is known to advertise 1.5 A or 3 A.
Only the land pattern differs from usb2, and it differs completely, which is why this is a separate block and not a footprint swap: contacts sit in two
rows on OPPOSITE sides of the body at y = +/-1.485, 0.5 mm pitch across the six inner contacts and 1.5 mm out to the outer pads, and EVERY pad
is 0.3 mm wide, where the horizontal GT-USB-7047C merges A and B into one row and gives VBUS and GND 0.6 mm pads. Three consequences follow
for the layout. The A/B ties are the layout's work: D+ (A6/B6) and D- (A7/B7) cross at the body centre and cannot be taken around the ends,
because the 0.3 mm gap between the outer contact and the shell-leg pad is unroutable at 0.2/0.2 and the plated leg blocks every layer there, so
budget one via jump for one leg of the pair and keep both legs equal length. VBUS lands on four 0.3 mm pads (A4/A9/B4/B9) and GND on four
(A1/A12/B1/B12): use all four of each in parallel for the 3 A rating and drop their ties to an inner layer rather than crowding the 1.8 mm corridor
between the rows, which the two data joins need. The four shell legs are plated ovals on a 1.1 x 0.6 drill at x = +/-4 and punch every layer, and
the two 0.71 mm NPTH locator pegs at (+/-4, 0) are mandatory for seating: place all six before pouring GND or routing the port.
Mechanically the courtyard shrinks to x +/-5.05, y +/-2.31 from the horizontal part's x +/-6.00, y -1.25 to +6.75, so the connector stops needing
about 6.75 mm of board past the contacts and can move inboard, but the cable now leaves perpendicular to the board: the enclosure needs an
aperture above it plus clearance for the plug body and its wire loop, well beyond the 7.46 mm connector height.
Keep the USBLC6 hard against the receptacle with a ground via at its pin 2 and route each data line in one I/O pad and out the other (clamp
performance is dominated by connection inductance), and bring USB_D+/USB_D- to the block boundary already coupled at the USB_HS netclass gap.
+5V_USB leaves D901 pad 1 into a port via, where a placing board picks the rail up.

PLACE: Place U901 hard against J901 with a ground via at its pin 2; route each data line in one I/O pad and out the other.

PLACE: Place J901's four shell-leg holes and two locator pegs before pouring GND or routing the port; the part does not seat without them.

PLACE: Place C901 between U901 pin 5 and the GND via; D901 sits where +5V_USB leaves the block at its port via.

ROUTE: USB_D+ and USB_D- are the USB_HS pair: equal length, coupled at the class gap, brought to the block boundary already coupled.

ROUTE: Jump one leg of each pair once at the body centre for the A/B tie; the 0.3 mm gap at the outer contacts is unroutable.

ROUTE: VBUS and +5V_USB are Default-class rails for the port's 5 V budget; +5V_USB is picked up at the port via by the placing board.

Circuit and PCB layout guidance
Migrated from the saved library sheet; circuit and PCB unchanged
Orb Weaver
Sheet: /power/usb2_vertical/
File: usb2_vertical.kicad_sch
Title: USB-C USB2 device port, vertical

Date: 2026-10-04

KiCad E.D.A. 10.0.6 | | Id: 9/11

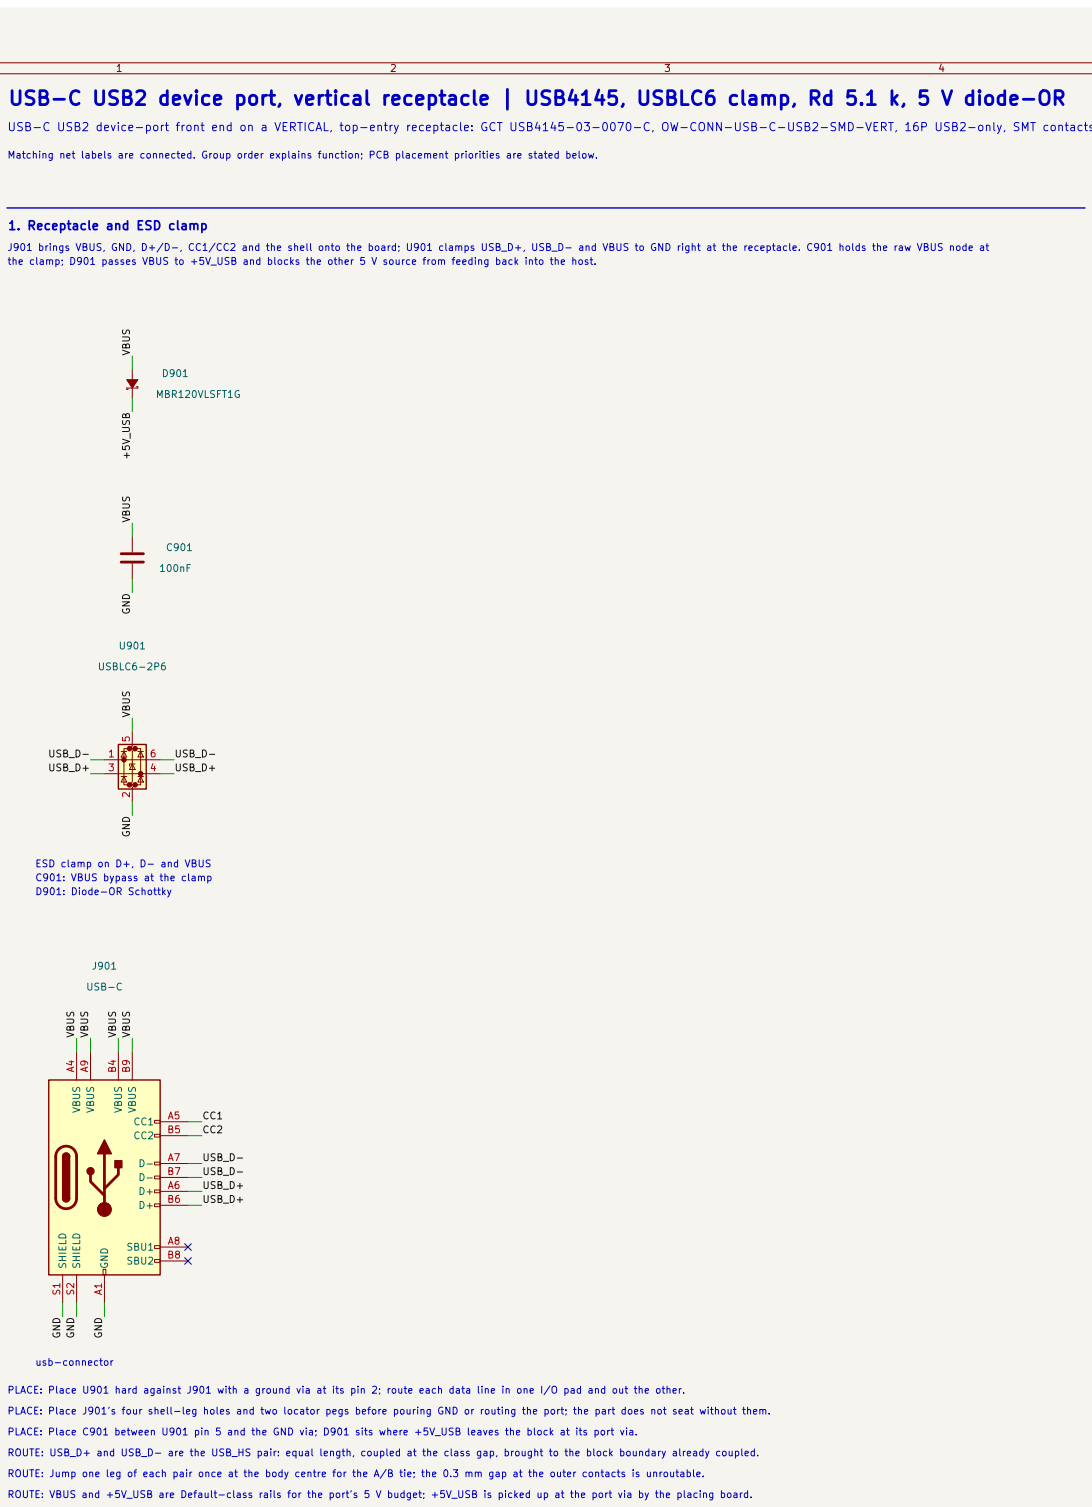
[picture p29: page 25]

USB-C USB2 device port, vertical receptacle | USB4145, USBLC6 clamp, Rd 5.1 k, 5 V diode-OR

USB-C USB2 device-port front end on a VERTICAL, top-entry receptacle: GCT USB4145-03-0070-C, OW-CONN-USB-C-USB2-SMD-VERT, 16P USB2-only, SMT contacts plus four through-hole shell legs, 7.46 mm tall.

Matching net labels are connected. Group order explains function; PCB placement priorities are stated below.

1. Receptacle and ESD clamp

J901 brings VBUS, GND, D+/D-, CC1/CC2 and the shell onto the board; U901 clamps USB_D+, USB_D- and VBUS to GND right at the receptacle. C901 holds the raw VBUS node at
the clamp; D901 passes VBUS to +5V_USB and blocks the other 5 V source from feeding back into the host.

ESD clamp on D+, D- and VBUS
C901: VBUS bypass at the clamp
D901: Diode-OR Schottky

PLACE: Place U901 hard against J901 with a ground via at its pin 2; route each data line in one I/O pad and out the other.
PLACE: Place J901's four shell-leg holes and two locator pegs before pouring GND or routing the port; the part does not seat without them.
PLACE: Place C901 between U901 pin 5 and the GND via; D901 sits where +5V_USB leaves the block at its port via.
ROUTE: USB_D+ and USB_D- are the USB_HS pair: equal length, coupled at the class gap, brought to the block boundary already coupled.
ROUTE: Jump one leg of each pair once at the body centre for the A/B tie; the 0.3 mm gap at the outer contacts is unroutable.
ROUTE: VBUS and +5V_USB are Default-class rails for the port's 5 V budget; +5V_USB is picked up at the port via by the placing board.

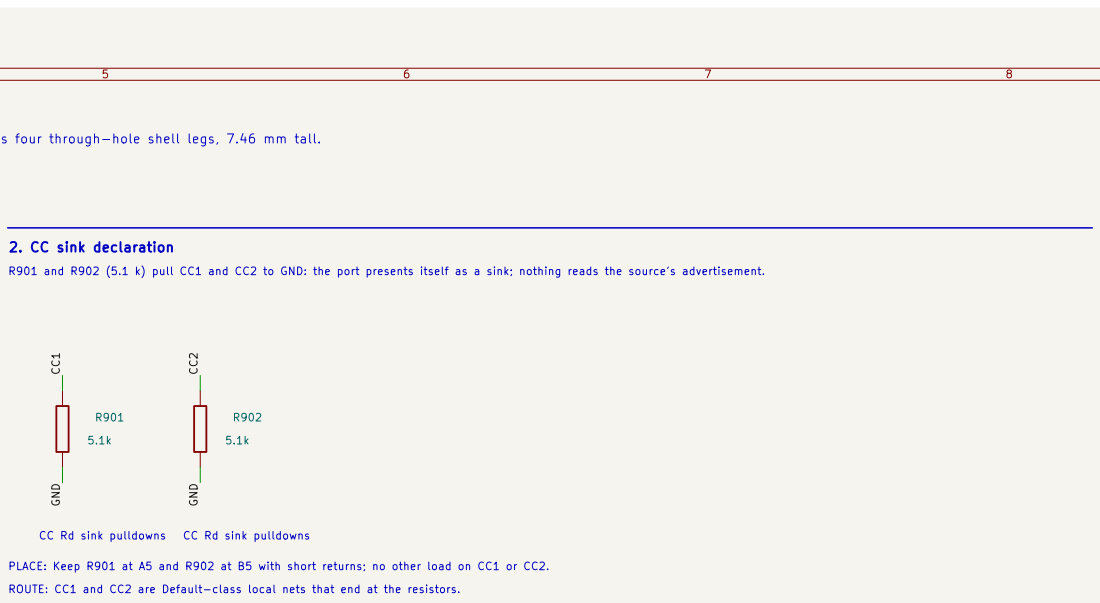
[picture p30: page 26]
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

R901 and R902 (5.1 k) pull CC1 and CC2 to GND: the port presents itself as a sink; nothing reads the source's advertisement.

PLACE: Keep R901 at A5 and R902 at B5 with short returns; no other load on CC1 or CC2.

ROUTE: CC1 and CC2 are Default-class local nets that end at the resistors.

R901

5.1k

R902

5.1k

## #FLG0901

## PWR_FLAG

## VBUS

CC2
CC1

### GND

### GND

## CC Rd sink pulldowns CC Rd sink pulldowns

## Power driven: VBUS

ROUTE: CC1 and CC2 are Default-class local nets that end at the resistors.

# 3. Power drive declarations

These nets have an explicit ERC power source declaration.

PLACE: Keep R901 at A5 and R902 at B5 with short returns; no other load on CC1 or CC2.

R901 and R902 (5.1 k) pull CC1 and CC2 to GND: the port presents itself as a sink; nothing reads the source's advertisement.

# 2. CC sink declaration

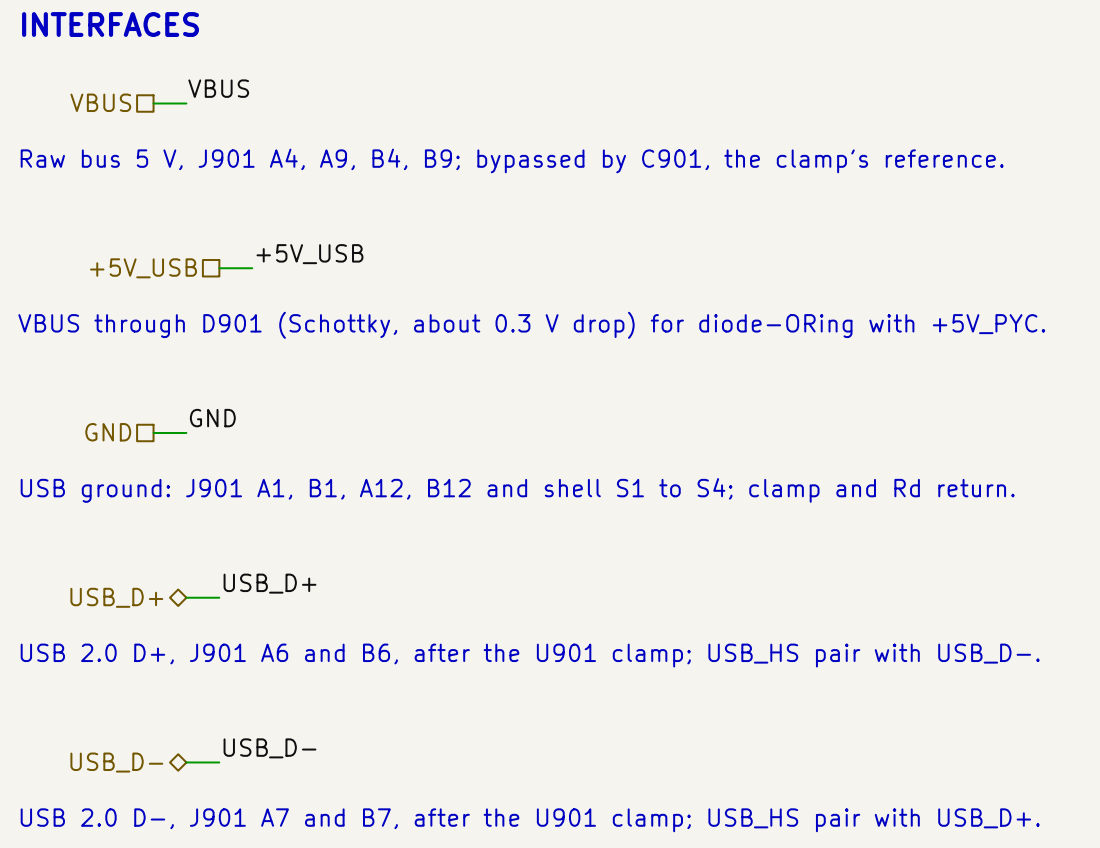
[picture p31: page 28]

Raw bus 5 V, J901 A4, A9, B4, B9; bypassed by C901, the clamp's reference.

VBUS through D901 (Schottky, about 0.3 V drop) for diode-ORing with +5V_PYC.

USB ground: J901 A1, B1, A12, B12 and shell S1 to S4; clamp and Rd return.

USB 2.0 D+, J901 A6 and B6, after the U901 clamp; USB_HS pair with USB_D-.

USB 2.0 D-, J901 A7 and B7, after the U901 clamp; USB_HS pair with USB_D+.

C

D

E

default-power source unless the host is known to advertise 1.5 A or 3 A.

instead if the shield must float.

CC: R901 on CC1 (A5) and R902 on CC2 (B5), 5.1 k to GND, declare a UFP (sink). Nothing reads the CC level, so budget the load against a

parallel for the 3 A rating. Four plated shell legs and two 0.71 mm locator pegs are mandatory for seating. The cable leaves perpendicular to the

+5V_USB leaves D901 pad 1 into a port via, where a placing board picks the rail up.

ESD: U901 (USBLC6-2P6) clamps D+, D- and VBUS: 3.5 pF max per line, 1.7 pF max line to line, 6 V minimum VBUS breakdown, 12 V typical

VBUS: C901 (100 nF) bypasses the raw bus; D901 (MBR120VLSFT1G, 20 V 1 A Schottky, 0.34 V max at 1 A, 0.6 mA leakage at 25 C) makes orientation works. SBU1 and SBU2 (A8, B8) are no-connect: USB2 only, for an RP2040-class device controller.

clamp at 1 A 8/20 us, IEC 61000-4-2 level 4 (15 kV air and contact). Clamp performance is set by connection inductance: pin 2 to a ground via, each data line in one I/O pad and out the other.

+5V_USB for diode-ORing with the pyControl block's +5V_PYC. The shell pads S1 to S4 are tied to GND here; isolate them through a pad/cap network

Land pattern (from the block's own record): contacts in two rows on opposite sides of the body at 0.5 mm pitch, every pad 0.3 mm wide; the A/B ties for D+ and D- cross at the body centre with one via jump per pair leg and equal lengths; VBUS and GND each land on four pads to be used in

(A1/A12/B1/B12): use all four of each in parallel for the 3 A rating and drop their ties to an inner layer rather than crowding the 1.8 mm corridor

Keep the USBLC6 hard against the receptacle with a ground via at its pin 2 and route each data line in one I/O pad and out the other (clamp aperture above it plus clearance for the plug body and its wire loop, well beyond the 7.46 mm connector height.

about 6.75 mm of board past the contacts and can move inboard, but the cable now leaves perpendicular to the board: the enclosure needs an

the two 0.71 mm NPTH locator pegs at (+/-4, 0) are mandatory for seating: place all six before pouring GND or routing the port.

performance is dominated by connection inductance), and bring USB_D+/USB_D- to the block boundary already coupled at the USB_HS netclass gap.

between the rows, which the two data joins need. The four shell legs are plated ovals on a 1.1 x 0.6 drill at x = +/-4 and punch every layer, and budget one via jump for one leg of the pair and keep both legs equal length. VBUS lands on four 0.3 mm pads (A4/A9/B4/B9) and GND on four because the 0.3 mm gap between the outer contact and the shell-leg pad is unroutable at 0.2/0.2 and the plated leg blocks every layer there, so for the layout. The A/B ties are the layout's work: D+ (A6/B6) and D- (A7/B7) cross at the body centre and cannot be taken around the ends,

Mechanically the courtyard shrinks to x +/-5.05, y +/-2.31 from the horizontal part's x +/-6.00, y -1.25 to +6.75, so the connector stops needing board (7.46 mm connector height), so the enclosure needs an aperture above it.

is 0.3 mm wide, where the horizontal GT-USB-7047C merges A and B into one row and gives VBUS and GND 0.6 mm pads. Three consequences follow rows on OPPOSITE sides of the body at y = +/-1.485, 0.5 mm pitch across the six inner contacts and 1.5 mm out to the outer pads, and EVERY pad on D+/D- and VBUS, 5.1k Rd pulldowns on CC1 (A5) and CC2 (B5) declaring a sink, 100nF on VBUS, a MBR120VLSFT1G series Schottky from VBUS to

USB2-only, SMT contacts plus four through-hole shell legs, 7.46 mm tall. Electrically identical to the horizontal usb2 block: USBLC6-2P6 ESD clamp

Only the land pattern differs from usb2, and it differs completely, which is why this is a separate block and not a footprint swap: contacts sit in two

Nothing reads the CC advertisement, so budget the load against a default-power source unless the host is known to advertise 1.5 A or 3 A.

unconnected, all four shell pads S1-S4 tied to GND. Ports are VBUS, +5V_USB, GND, USB_D+, USB_D-.

+5V_USB for diode-ORing with other 5 V sources (pair it with pycontrol_behavior_port_rj45's +5V_PYC), PWR_FLAG on VBUS, SBU1/SBU2 deliberately

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

# DESIGN CONTRACT

# INTERNAL NETS

CC2: Configuration channel for the other orientation, J901 B5 to R902 (Rd, 5.1 k to GND); nothing reads it.

CC1: Configuration channel for one plug orientation, J901 A5 to R901 (Rd, 5.1 k to GND); nothing reads it.

# OPERATION

Signal path: J901 D+ (A6, B6) and D- (A7, B7) pass U901's I/O pads to USB_D+ and USB_D-; both receptacle rows are tied so either plug

1 | 2 | 3 | 4 | 5 | 6 | 7 | 8 | 9 | 10 | 11 | 12 | 13 | 14 | 15 | 16
1 | 2 | 3 | 4 | 5 | 6 | 7 | 8 | 9 | 10 | 11 | 12 | 13 | 14 | 15 | 16

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
| Date: 2026-10-04
KiCad E.D.A. 10.0.6 | | Id: 5/11
Size: A1 | Rev: Source migration 1

## Title: InstrumentPort-Digital-50 DUT boundary, vertical

### File: instrument_port_digital_50_dut_ffc_boundary_vertical.kicad_sch

### Sheet: /instrument_port_digital_50_dut_ffc_boundary_vertical/

### Orb Weaver

### Migrated from the saved library sheet; circuit and PCB unchanged

### Circuit and PCB layout guidance

R523

100

R501

10k

R527

100

R528

100

R521

100

R522

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
## GND 10

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
## VCC 20

## PAD 21

U503

SN74LV541ARKSR

R526

100

R513

100

R524

100

R515

100

R518

100

R525

100

OE1 1

A1 2
A2 3
A3 4
A4 5
A5 6
A6 7
A7 8
A8 9

## GND 10

# Y8 11 Y7 12 Y6 13 Y5 14 Y4 15 Y3 16 Y2 17 Y1 18

OE2 19

## VCC 20

## PAD 21

U502

SN74LV541ARKSR

C501

4.7uF

R502

10k

R514

100

R516

100

R517

100

R503

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
J501

FH12-50S-0.5SVA(54)

R504

10k

OE1 1

A1 2
A2 3
A3 4
A4 5
A5 6
A6 7
A7 8
A8 9

## GND 10

# Y8 11 Y7 12 Y6 13 Y5 14 Y4 15 Y3 16 Y2 17 Y1 18

OE2 19

## VCC 20

## PAD 21

U501

SN74LV541ARKSR

R510

100

R507

100

R509

100

R508

100

R532

100

R531

100

C505

100nF

R530

100

R529

100

R506

100

OE1 1

A1 2
A2 3
A3 4
A4 5
A5 6
A6 7
A7 8
A8 9

## GND 10

# Y8 11 Y7 12 Y6 13 Y5 14 Y4 15 Y3 16 Y2 17 Y1 18

OE2 19

## VCC 20

## PAD 21

U504

SN74LV541ARKSR

R536

100

R535

100

R534

100

R533

100

C502

100nF

R511

100

R505

100

R512

100

R520

100
C503

100nF

C504

100nF

R519

100

DIG24

DIG13

DIG14

DIG31

DIG27

DIG15

DIG30

DIG7

DIG16

DIG23

DIG29

DIG22

DIG21

DIG17

DIG20

DIG28

DIG18

DIG19

DIG11

DIG6

DIG5

DIG4

DIG8

DIG3

DIG2

DIG9

DIG1

DIG10

DIG12

DIG0

GND

DIG26

DIG25

+3.3V

DIG31_ISO

DIG26_BUF

GND

DIG2_BUF
DIG17_BUF
DIG25_BUF | DIG25_ISO

DIG16_BUF

OE4

DIG24_BUF | DIG24_ISO

DIG3_BUF

DIG1_BUF
DIG0_BUF

GND

+3.3V

DIG30_BUF

DIG5_ISO

OE3

DIG5_BUF

DIG3_ISO

+3.3V

GND

GND

OE4

OE4

DIG27_ISODIG27_BUF

GND

DIG26_ISO

DIG7

DIG0

DIG1

DIG2

DIG20
DIG3

DIG4

DIG5

DIG6

GND

OE1

OE1

DIG19
DIG18
DIG17
DIG16

OE3

OE3

DIG21_BUF

DIG18_BUF

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

within each row.

with the connector's ground contacts.

Output source damping

Output source damping

C501 (4.7 uF) holds the +3.3V rail where it enters the block; the per-package 100 nF bypasses are in the octet groups.

ROUTE: The DIG8 to DIG15 inputs are this block's ports and escape toward the board on vias; keep the Y runs short to the resistors and the resistor-to-contact runs paired between the Y pins and J501, outputs toward the connector.

PLACE: Place C503 hard against pin 20 of U502 with a short return to pin 10 and the exposed pad 21; R502 near pins 1 and 19; the eight damping resistors

ROUTE: +3.3V carries PWR_3V3_LOCAL from the entry to the four VCC pins; GND is PWR_RETURN_LOCAL.

PLACE: Place C501 at the supply entry of the block, not at any one package.

4.7 uF

+3.3V rail-entry bulk,

Output source damping

Output source damping

10 k

OE1/OE2 pull-down,

SN74LV541A octal buffer, DUT to instrument

Output source damping

Output source damping

VCC pin 20 bypass, 100 nF

ing | Output source damping | Output source dampingOutput source damp

Output source damping

and every net stays driven and terminated: ERC, DRC and design_block_tools.py check are ALL BLIND to this error, and only a pin-by-pin netlist comparison or continuity on the real cable catches it.

orb_weaver_smd:Texas_RKS0020A_VQFN-20-1EP_2.5x4.5mm_P0.5mm_EP1x3mm, exposed pad 21 to GND), grouped DIG0-7 / DIG8-15 / DIG16-23 / DIG24-31 to match the 13-contact octet windows. The 541 is flow-through: input pin p pairs with output pin 20-p, A1(2) to Y1(18) through A8(9) to Y8(11). DIRECTION IS A HARDWARE PROPERTY: DUT to instrument only. The cable carries no supply, no voltage

NOT HERE. instrument_port_digital_50_adapter_ffc_boundary_vertical is pre-mirrored to 51-n so that the expected reversing assembly - same-side Type A FFC with a vertical FH12 at both ends, connectors

rotated 180 degrees - delivers DIGn to DIGn. Mirroring both ends cancels and channels arrive as DIG31-n. The ground pattern is palindromic under 51-n, so a mirrored map lands every ground identically

SN74LV541A octal buffer, DUT to instrument

Per-output source damping is 100 ohms, OW-PASS-0402WGF1000TCE. That value is chosen as the smallest standard one that bounds a hard short to ground inside the LV541A's +/-35mA output absolute maximum even crediting the driver with zero impedance (3.3V/100R = 33mA); 68R gives 49mA, 47R gives 70mA, and the legacy 33R gives 100mA. It is NOT short-circuit protection and does not cover

no OE port. The owning contract was relaxed on 2026-09-15 from requiring manual disabling to permitting none, so this conforms; the reasoning and the retained future option are in

VCC pin 20 bypass, 100 nF

kicad-libs/docs/digital-instrument-port-design-blocks.md under 'No disable control, and why'. DO NOT re-add a control as an oversight fix. Shared 10k is verified against aggregate leakage: 2 x 5uA

max gives 0.1V against a 0.99V VIL. If a noise investigation ever needs a mute, detaching the FFC bounds the cable's contribution but NOT the buffers', which keep switching into their board-side traces bias is board-specific and not in this block: every unused DIGn must be tied at the board. Attach and remove the FFC with target power off; J501 is rated 20 mating cycles, so break the link at the

floor(n/2) + floor(n/16), so DIG0 is pin 2 and DIG31 is pin 49, with all 18 grounds on pins 1, 4, 7, 10, 13, 16, 19, 22, 25, 26, 29, 32, 35, 38, 41, 44, 47 and 50. THE MIRROR LIVES ON THE ADAPTER,

Output source damping

every fault. DEFAULT-ENABLED BY HARDWARE, AND THERE IS NO DISABLE AT ALL: both active-low OE inputs of each package share one net held low by a single 10k pull-down - R501 through R504,

switched rail cannot observe the domain it is powering down with. DECOUPLING is one 100nF per package, C502 through C505, hard against each pin 20 with a short return, plus one 4.7uF

Output source damping

rail-entry bulk, C501 / OW-CAP-4U7-0402-X5R-16V, at the supply entry. C501 is NOT a fifth per-IC bypass - do not 'fix' its distance to any package. Simultaneous-switching budget: 32 x 50pF

InstrumentPort-Digital-50 DUT boundary | four SN74LV541A octets, 100 ohm damping, enabled by hardware

Matching net labels are connected. Group order explains function; PCB placement priorities are stated below.

one per package - so observation works with the MCU held in reset, unprogrammed or unable to boot, and the port cannot be muted without desoldering. There is no manual jumper, no firmware link and

### 1. Octet DIG0 to DIG7: U501

C502 bypasses VCC (pin 20); R501 holds both enables (pins 1 and 19) low.

and damping resistors; lift the 100R resistors on the suspect channels instead. SUPPLY FROM THE BOARD'S ALWAYS-ON 3.3V RAIL, independent of firmware, HV_EN and every switched domain; a buffer on a

Output source damping

SN74LV541A octal buffer, DUT to instrument

PLACE: Place C505 hard against pin 20 of U504 with a short return to pin 10 and the exposed pad 21; R504 near pins 1 and 19; the eight damping resistors

VCC pin 20 bypass, 100 nF

Supply: the always-on 3.3 V rail on VCC (pins 20); SN74LV541A runs 2 to 5.5 V, drives +/-8 mA at 3.3 V, inputs tolerate 0 to 5.5 V with Ioff <= 5 uA unpowered, VIH 2.31 V, VIL 0.99 V, edges <= 100 with the 25/26 double ground at the bank boundary. The mirror lives on instrument_port_digital_50_adapter_ffc_boundary_vertical; mirroring both ends cancels, and ERC and DRC cannot see it.

Pin mapping is the contract's DUT table and is not mirrored: channel n lands on contact 2 + n + floor(n/2) + floor(n/16), DIG0 on contact 2, DIG31 on contact 49, the 18 grounds on 1, 4, 7, ... 47, 50 reference, enable or stimulus.

The 100 ohm damping bounds a hard short of one output to GND at 33 mA, inside the +/-35 mA per-output absolute maximum, and damps edges into the cable; it is not short-circuit protection. Input leakage against the 0.99 V VIL), so observation works with the MCU in reset or unprogrammed. The contract permits this since 2026-09-15; do not re-add a control as a fix.

instrument end.

### DESIGN CONTRACT

C597991, 0.5mm pitch, symbol Conn_01x50, footprint orb_weaver_connectors:Hirose_FH12-50S-0.5SVA_1x50-4MP_P0.5mm_Vertical; the four mechanical lands are unnumbered pads and carry no net.
Thirty-two channels through four SN74LV541ARKSR octal buffers (OW-MISC-SN74LV541ARKSR, C7364695, symbol orb_weaver_misc:SN74LV541ARKSR, footprint

### OPERATION

with the connector's ground contacts.

between the Y pins and J501, outputs toward the connector.

x 3.3V = 5.3nC per all-channel edge, about 1mV of droop against the combined local reservoir. Expect meaningfully less than 4.7uF at 3.3V bias - a 4.7uF X5R in an 0402 derates hard - so treat the

ROUTE: The DIG24 to DIG31 inputs are this block's ports and escape toward the board on vias; keep the Y runs short to the resistors and the resistor-to-contact runs paired

Output source dampingOutput source damping

DUT side of the InstrumentPort-Digital-50 profile (board-interfaces docs/instrument-port-digital.md, draft v0.1). Direction is a hardware property, DUT to instrument only: DIGn enters U501 to U504

(DIG0 to 7, 8 to 15, 16 to 23, 24 to 31, each octet one package, A8 down to A1), leaves on Y8 to Y1 through 100 ohm damping (R505 to R536) onto J501. The cable carries no supply,

Enabled by hardware default, no disable at all: both active-low enables of each package share one net held low by its 10 k pull-down (R501 to R504; at most about 0.1 V from the two inputs'

VCC pin 20 bypass, 100 nF

Output source damping

ns/V, not a Schmitt input. C502 to C505 (100 nF) bypass each pin 20; C501 (4.7 uF, X5R 0402, well below nameplate at 3.3 V bias) is the one rail-entry bulk, not a fifth per-package bypass.

C503 bypasses VCC (pin 20); R502 holds both enables (pins 1 and 19) low.

DUT-side InstrumentPort-Digital-50 with integrated read-only buffering, on a VERTICAL, top-entry 50-contact ZIF connector: Hirose FH12-50S-0.5SVA(54), OW-CONN-FH12-50S-0-5SVA-54, LCSC

Output source damping

reference, no enable and no stimulus, and nothing in this block may be driven by the instrument. PIN MAPPING IS THE CONTRACT'S DUT TABLE AND IS NOT MIRRORED: channel n lands on pin 2 + n +

### 5. Rail-entry bulk bypass

Output source damping

Output source damping

findings from this block under the shared rules; a board wanting 0.20 mm inside the block re-routes the block, not the rule (layout conventions 12).

unless the actual assembly is hot-plug qualified. Profile is InstrumentPort-Digital-50 draft v0.1, UNQUALIFIED: no measured rate, delay, skew, loading or power-state limit has been established.

Output source damping

Marker/beacon channel indices are NOT frozen, with DIG0/DIG1 the current recommendation over the earlier DIG14/DIG15. Pairs with instrument_port_digital_50_adapter_ffc_boundary_vertical; the

analyzer-specific channel map belongs to la5032_connector_boundary, not here. GROUNDED INPUTS ARE THE BOARD'S COPPER: the inputs are this block's ports, so a board that grounds unused DIGn

channels draws one 0.20 mm track per grounded LV541A pad column straight into that package's thermal pad on F.Cu, before autorouting; Freerouting will not run a track along a row of same-net 0.5

Output source damping

OE1/OE2 pull-down,
10 k

Output source damping

Output source damping

Output source damping

18 connector grounds, buffer GND pins and pads, bypass and OE pull-down return.

Output source damping

Output source dampingOutput source damping

C505 bypasses VCC (pin 20); R504 holds both enables (pins 1 and 19) low.

### 4. Octet DIG24 to DIG31: U504

with the connector's ground contacts.

ROUTE: The DIG0 to DIG7 inputs are this block's ports and escape toward the board on vias; keep the Y runs short to the resistors and the resistor-to-contact runs paired

Observation input 0 into U501 A8 (pin 9); leaves on contact 2.

Observation input 1 into U501 A7 (pin 8); leaves on contact 3.

Observation input 2 into U501 A6 (pin 7); leaves on contact 5.

Observation input 3 into U501 A5 (pin 6); leaves on contact 6.

Observation input 4 into U501 A4 (pin 5); leaves on contact 8.

Observation input 5 into U501 A3 (pin 4); leaves on contact 9.

Output source damping

nameplate value as nominal, not measured. INPUT BIAS IS BOARD-SPECIFIC AND IS NOT IN THIS BLOCK: there is no universal pull-down, because SPI selects, open-drain buses and switched-domain taps

each need different bias, and pulls that must read HIGH on a switched net reference the switched rail, never the always-on one. Every unused input must be explicitly tied at the board. LV541A at 3.3V
needs VIH >= 2.31V and VIL <= 0.99V with transitions <= 100 ns/V; it is 0-5.5V input tolerant with 2pF typical input capacitance and Ioff <= 5uA at VCC=0. It is NOT Schmitt-triggered and NOT a

comparator: do not route a raw analog node through it for a timing witness, and do not treat a clean legacy LVC125A capture as LV541A qualification. OE would disable outputs only - it never removes

input loading or makes a floating input acceptable, which is part of why no mute was fitted. Requires straight-ended 0.30 +/-0.05mm FFC with gold contacts, at least 2mm exposed contact and 3mm

reinforcement; retention-eared cable is NOT qualified for this connector. Rated 20 mating cycles, so prefer breaking the link at the instrument end, and attach or remove the cable with target power off

### INTERFACES

Output source damping

U504 buffers DIG24 to DIG31 (inputs A8 to A1, pins 9 to 2) onto Y8 to Y1 (pins 11 to 18); R529 to R536 (100 ohm) damp each output into its connector contact.

mm-pitch pads and left those groups unrouted on every camera-board run (layout conventions 11a). Since 2026-09-29 every DIGn also ends at its own escape via above the pad row, so a board may

### 2. Octet DIG8 to DIG15: U502

Output source dampingOutput source damping

Observation input 6 into U501 A2 (pin 3); leaves on contact 11.

PLACE: Place C502 hard against pin 20 of U501 with a short return to pin 10 and the exposed pad 21; R501 near pins 1 and 19; the eight damping resistors

instead tie an unused channel to ground at that via; either way the grounding copper is the board's, never the block's. FLOOR COPPER IS DECLARED: the 0.10 mm gaps between the 32 damping resistors

U501 buffers DIG0 to DIG7 (inputs A8 to A1, pins 9 to 2) onto Y8 to Y1 (pins 11 to 18); R505 to R512 (100 ohm) damp each output into its connector contact.

### 3. Octet DIG16 to DIG23: U503

C504 bypasses VCC (pin 20); R503 holds both enables (pins 1 and 19) low.

between the Y pins and J501, outputs toward the connector.

DUT-side InstrumentPort-Digital-50 with integrated read-only buffering, on a VERTICAL, top-entry 50-contact ZIF connector: Hirose FH12-50S-0.5SVA(54), OW-CONN-FH12-50S-0-5SVA-54, LCSC C597991, 0.5mm pitch, symbol Conn_01x50, footprint orb_weaver_connectors:Hirose_FH12-50S-0.5SVA_1x50-4MP_P0.5mm_Vertical; the four mechanical lands are unnumbered pads and carry no net.

and the LV541A pins (2026-09-26) and between each DIGn escape stub and the escape via beside it (2026-09-29) are wrapped in BLOCK_FLOOR rule areas, so a consuming board sees no clearance

U503 buffers DIG16 to DIG23 (inputs A8 to A1, pins 9 to 2) onto Y8 to Y1 (pins 11 to 18); R521 to R528 (100 ohm) damp each output into its connector contact.

PLACE: Place C504 hard against pin 20 of U503 with a short return to pin 10 and the exposed pad 21; R503 near pins 1 and 19; the eight damping resistors

ROUTE: The DIG16 to DIG23 inputs are this block's ports and escape toward the board on vias; keep the Y runs short to the resistors and the resistor-to-contact runs paired

J501 carries the 32 damped outputs (DIGn_ISO) on the contract's DUT contacts and the 18 grounds on one GND; the four mechanical lands carry no net.

Always-on 3.3 V buffer supply (VCC pins 20); never reaches the cable.

R501

10k

R502

10k

OE1 1

A1 2
A2 3
A3 4
A4 5
A5 6
A6 7
A7 8
A8 9

# GND 10

Y8 11

Y7 12

Y6 13

Y5 14 Y4 15

Y3 16

Y2 17

Y1 18

OE2 19

# VCC 20

# PAD 21

U501

### SN74LV541ARKSR

R510

100

R507

100

R509

100

R508

100

R506

100

C502

100nF

R511

100

R505

100

R512

100

### DIG2_BUF

### DIG3_BUF

### DIG1_BUF DIG0_BUF

+3.3V

### DIG5_ISO DIG5_BUF

### DIG3_ISO

### DIG7

### DIG0

### DIG1

### DIG2

### DIG3

### DIG4

### DIG5

### DIG6

GND

OE1

OE1

### DIG1_ISO

### DIG1_BUF

GND

OE1

DIG6_BUF | DIG6_ISO

### DIG4_ISODIG4_BUF

### DIG7_BUF DIG6_BUF DIG5_BUF DIG4_BUF DIG3_BUF

+3.3V

### DIG7_ISODIG7_BUF

GND

GND

### DIG2_BUF

### DIG2_ISO

### DIG0_BUF

GND

### DIG0_ISO

OE2

10 k

OE1/OE2 pull-down,

between the Y pins and J501, outputs toward the connector.

U502 buffers DIG8 to DIG15 (inputs A8 to A1, pins 9 to 2) onto Y8 to Y1 (pins 11 to 18); R513 to R520 (100 ohm) damp each output into its connector contact.

with the connector's ground contacts.

ROUTE: The DIG8 to DIG15 inputs are this block's ports and escape toward the board on vias; keep the Y runs short to the resistors and the resistor-to-contact runs paired between the Y pins and J501, outputs toward the connector.

PLACE: Place C503 hard against pin 20 of U502 with a short return to pin 10 and the exposed pad 21; R502 near pins 1 and 19; the eight damping resistors

10 k

OE1/OE2 pull-down,

ping | Output source damping | Output source dampingOutput source dam

Output source damping

### SN74LV541A octal buffer, DUT to instrument

### VCC pin 20 bypass, 100 nF

Output source damping

Output source damping

## 1. Octet DIG0 to DIG7: U501

C502 bypasses VCC (pin 20); R501 holds both enables (pins 1 and 19) low.

Output source damping

C503 bypasses VCC (pin 20); R502 holds both enables (pins 1 and 19) low.

Output source damping

Output source dampingOutput source damping

with the connector's ground contacts.

ROUTE: The DIG0 to DIG7 inputs are this block's ports and escape toward the board on vias; keep the Y runs short to the resistors and the resistor-to-contact runs paired

## 2. Octet DIG8 to DIG15: U502

PLACE: Place C502 hard against pin 20 of U501 with a short return to pin 10 and the exposed pad 21; R501 near pins 1 and 19; the eight damping resistors

U501 buffers DIG0 to DIG7 (inputs A8 to A1, pins 9 to 2) onto Y8 to Y1 (pins 11 to 18); R505 to R512 (100 ohm) damp each output into its connector contact.

R513

100

R515

100

R518

100

OE1 1

A1 2
A2 3
A3 4
A4 5
A5 6
A6 7
A7 8
A8 9

# GND 10

Y8 11

Y7 12

Y6 13

Y5 14 Y4 15

Y3 16

Y2 17

Y1 18

OE2 19

# VCC 20

# PAD 21

U502

### SN74LV541ARKSR

R502

10k

R514

100

R516

100

R517

100

R503

10k

R520

100
C503

100nF

R519

100

OE3

### DIG13

OE2

### DIG8

### DIG9

### DIG10

### DIG11

### DIG12

### DIG14

### DIG15

DIG11_ISO | DIG10_BUF

### DIG9_BUF

### DIG9_BUF

### DIG8_BUF

### DIG11_BUF

### DIG12_ISO

### DIG10_BUF

### DIG11_BUF

### DIG10_ISO

### DIG12_BUF

### DIG13_BUF

### DIG14_BUF

### DIG15_BUF

### DIG14_BUF

GND

### DIG13_BUF

+3.3V

GND

### DIG15_BUF

### DIG9_ISO

OE2

### DIG14_ISO

### DIG8_BUF

### DIG12_BUF

### DIG8_ISO

GND

+3.3V

GND

GND

OE2

### DIG15_ISO

### DIG13_ISO

U502 buffers DIG8 to DIG15 (inputs A8 to A1, pins 9 to 2) onto Y8 to Y1 (pins 11 to 18); R513 to R520 (100 ohm) damp each output into its connector contact.

with the connector's ground contacts.

10 k

OE1/OE2 pull-down,

with the connector's ground contacts.

Output source damping

Output source damping

ROUTE: The DIG8 to DIG15 inputs are this block's ports and escape toward the board on vias; keep the Y runs short to the resistors and the resistor-to-contact runs paired between the Y pins and J501, outputs toward the connector.

PLACE: Place C503 hard against pin 20 of U502 with a short return to pin 10 and the exposed pad 21; R502 near pins 1 and 19; the eight damping resistors

Output source damping

Output source damping

10 k

OE1/OE2 pull-down,

### SN74LV541A octal buffer, DUT to instrument

Output source damping

Output source damping

ping | Output source damping | Output source dampingOutput source dam

### VCC pin 20 bypass, 100 nF

C503 bypasses VCC (pin 20); R502 holds both enables (pins 1 and 19) low.

## 2. Octet DIG8 to DIG15: U502 3. Octet DIG16 to DIG23: U503

C504 bypasses VCC (pin 20); R503 holds both enables (pins 1 and 19) low.

between the Y pins and J501, outputs toward the connector.

U503 buffers DIG16 to DIG23 (inputs A8 to A1, pins 9 to 2) onto Y8 to Y1 (pins 11 to 18); R521 to R528 (100 ohm) damp each output into its connector contact.

PLACE: Place C504 hard against pin 20 of U503 with a short return to pin 10 and the exposed pad 21; R503 near pins 1 and 19; the eight damping resistors

ROUTE: The DIG16 to DIG23 inputs are this block's ports and escape toward the board on vias; keep the Y runs short to the resistors and the resistor-to-contact runs paired

R523

100

R527

100

R528

100

R521

100

R522

100

OE1 1

A1 2
A2 3
A3 4
A4 5
A5 6
A6 7
A7 8
A8 9

# GND 10

Y8 11

Y7 12

Y6 13

Y5 14 Y4 15

Y3 16

Y2 17

Y1 18

OE2 19

# VCC 20

# PAD 21

U503

### SN74LV541ARKSR

R526

100

R524

100

R525

100

R503

10k

C504

100nF

### DIG7

### DIG11

### DIG6

### DIG5

### DIG4

### DIG8

### DIG3

### DIG2

### DIG9

### DIG1

### DIG10

### DIG12

### DIG0

### GND

+3.3V

### DIG17_BUF DIG16_BUF

GND

OE3

+3.3V

GND

### DIG20 DIG19 DIG18 DIG17 DIG16

OE3

OE3

### DIG21_BUF

### DIG18_BUF

### DIG19_BUF

### DIG20_BUF

### DIG22_BUF

### DIG23_BUFDIG23 DIG22 DIG21

### DIG20_BUF

### DIG7

### DIG6

### DIG5

### DIG4

### DIG3

### DIG2

### DIG1

### DIG0

### GND

+3.3V

### DIG20_ISO

### DIG8

DIG19_ISODIG19_BUF | DIG18_ISODIG18_BUF
DIG17_ISODIG17_BUF | DIG16_ISODIG16_BUF
DIG23_ISODIG23_BUF | DIG22_ISO

### DIG22_BUF

### DIG12

### DIG11

### DIG10

### DIG9

DIG21_BUF | DIG21_ISO

### +3.3VGND

GND

Observation input 10 into U502 A6 (pin 7); leaves on contact 17.

Observation input 8 into U502 A8 (pin 9); leaves on contact 14.

Observation input 9 into U502 A7 (pin 8); leaves on contact 15.

Observation input 11 into U502 A5 (pin 6); leaves on contact 18.

Observation input 12 into U502 A4 (pin 5); leaves on contact 20.

Observation input 7 into U501 A1 (pin 2); leaves on contact 12.

with the connector's ground contacts.

10 k

OE1/OE2 pull-down,

### SN74LV541A octal buffer, DUT to instrument

### VCC pin 20 bypass, 100 nF

Output source damping
Output source damping

Output source damping

Output source damping

Output source damping

Output source damping

18 connector grounds, buffer GND pins and pads, bypass and OE pull-down return.

Observation input 0 into U501 A8 (pin 9); leaves on contact 2.

Observation input 1 into U501 A7 (pin 8); leaves on contact 3.

Observation input 2 into U501 A6 (pin 7); leaves on contact 5.

Observation input 3 into U501 A5 (pin 6); leaves on contact 6.

Observation input 4 into U501 A4 (pin 5); leaves on contact 8.

Observation input 5 into U501 A3 (pin 4); leaves on contact 9.

## INTERFACES

Output source dampingOutput source damping

Observation input 6 into U501 A2 (pin 3); leaves on contact 11.

## 3. Octet DIG16 to DIG23: U503

C504 bypasses VCC (pin 20); R503 holds both enables (pins 1 and 19) low.

between the Y pins and J501, outputs toward the connector.

U503 buffers DIG16 to DIG23 (inputs A8 to A1, pins 9 to 2) onto Y8 to Y1 (pins 11 to 18); R521 to R528 (100 ohm) damp each output into its connector contact.

PLACE: Place C504 hard against pin 20 of U503 with a short return to pin 10 and the exposed pad 21; R503 near pins 1 and 19; the eight damping resistors

ROUTE: The DIG16 to DIG23 inputs are this block's ports and escape toward the board on vias; keep the Y runs short to the resistors and the resistor-to-contact runs paired

Always-on 3.3 V buffer supply (VCC pins 20); never reaches the cable.

C501

4.7uF

R504

10k

R532

100

R531

100

C505

100nF

R530

100

R529

100

OE1 1

A1 2
A2 3
A3 4
A4 5
A5 6
A6 7
A7 8
A8 9

# GND 10

Y8 11

Y7 12

Y6 13

Y5 14 Y4 15

Y3 16

Y2 17

Y1 18

OE2 19

# VCC 20

# PAD 21

U504

### SN74LV541ARKSR

R536

100

R535

100

R534

100

R533

100

### DIG31_ISO

### DIG26_BUF

GND

DIG25_BUF | DIG25_ISO

OE4

DIG24_BUF | DIG24_ISO

### DIG30_BUF

GND

GND

OE4

OE4

### DIG27_ISODIG27_BUF

### DIG26_ISO

### DIG30_ISO

GND

DIG28_BUF | DIG28_ISO

### DIG31_BUF

### DIG29

### DIG30

### DIG31

### GND +3.3V

### DIG28 DIG28_BUF

### DIG31_BUF DIG30_BUF DIG29_BUF

### DIG27_BUF DIG26_BUF DIG25_BUF DIG24_BUF

### DIG29_ISODIG29_BUF

+3.3V

### DIG24

### DIG25

### DIG26

### DIG27

+3.3V

Output source damping

C501 (4.7 uF) holds the +3.3V rail where it enters the block; the per-package 100 nF bypasses are in the octet groups.

ROUTE: +3.3V carries PWR_3V3_LOCAL from the entry to the four VCC pins; GND is PWR_RETURN_LOCAL.

PLACE: Place C501 at the supply entry of the block, not at any one package.

4.7 uF

+3.3V rail-entry bulk,

### SN74LV541A octal buffer, DUT to instrument

PLACE: Place C505 hard against pin 20 of U504 with a short return to pin 10 and the exposed pad 21; R504 near pins 1 and 19; the eight damping resistors

### VCC pin 20 bypass, 100 nF

with the connector's ground contacts.

between the Y pins and J501, outputs toward the connector.

ROUTE: The DIG24 to DIG31 inputs are this block's ports and escape toward the board on vias; keep the Y runs short to the resistors and the resistor-to-contact runs paired

Output source dampingOutput source damping

Output source damping

## 5. Rail-entry bulk bypass

Output source damping

OE1/OE2 pull-down,
10 k

Output source damping

C505 bypasses VCC (pin 20); R504 holds both enables (pins 1 and 19) low.

## 4. Octet DIG24 to DIG31: U504

Output source damping

Output source damping

U504 buffers DIG24 to DIG31 (inputs A8 to A1, pins 9 to 2) onto Y8 to Y1 (pins 11 to 18); R529 to R536 (100 ohm) damp each output into its connector contact.

R513

100

R515

100

# GND 10

# PAD 21

C501

4.7uF

R502

10k

R514

100

R516

100

### GND

DIG11_ISO | DIG10_BUF

## DIG9_BUF

## DIG11_BUF

## DIG10_ISO

### GND

## DIG9_ISO

OE2

## DIG8_BUF

## DIG8_ISO

### GND

+3.3V

### GND

with the connector's ground contacts.

### Output source damping

C501 (4.7 uF) holds the +3.3V rail where it enters the block; the per-package 100 nF bypasses are in the octet groups.

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

ROUTE: +3.3V carries PWR_3V3_LOCAL from the entry to the four VCC pins; GND is PWR_RETURN_LOCAL.

PLACE: Place C501 at the supply entry of the block, not at any one package.

4.7 uF

+3.3V rail-entry bulk,

### Output source damping

### Output source damping

10 k

OE1/OE2 pull-down,

## SN74LV541A octal buffer, DUT to instrument

### Output source damping

# 5. Rail-entry bulk bypass

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
J501

### FH12-50S-0.5SVA(54)

### DIG24

### DIG13

### DIG14

### DIG27

### DIG15

### DIG16

### DIG23

### DIG22

### DIG21

### DIG17

### DIG20

### DIG18

### DIG19

### DIG26

### DIG25

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

Observation input 16 into U503 A8 (pin 9); leaves on contact 27.

Observation input 18 into U503 A6 (pin 7); leaves on contact 30.

Observation input 19 into U503 A5 (pin 6); leaves on contact 31.

Observation input 30 into U504 A2 (pin 3); leaves on contact 48.

Observation input 20 into U503 A4 (pin 5); leaves on contact 33.

Observation input 21 into U503 A3 (pin 4); leaves on contact 34.

Observation input 22 into U503 A2 (pin 3); leaves on contact 36.

Observation input 23 into U503 A1 (pin 2); leaves on contact 37.

Observation input 24 into U504 A8 (pin 9); leaves on contact 39.

Observation input 25 into U504 A7 (pin 8); leaves on contact 40.

Observation input 26 into U504 A6 (pin 7); leaves on contact 42.

Observation input 27 into U504 A5 (pin 6); leaves on contact 43.

Observation input 28 into U504 A4 (pin 5); leaves on contact 45.

Observation input 29 into U504 A3 (pin 4); leaves on contact 46.

Observation input 31 into U504 A1 (pin 2); leaves on contact 49.

and every net stays driven and terminated: ERC, DRC and design_block_tools.py check are ALL BLIND to this error, and only a pin-by-pin netlist comparison or continuity on the real cable catches it.

orb_weaver_smd:Texas_RKS0020A_VQFN-20-1EP_2.5x4.5mm_P0.5mm_EP1x3mm, exposed pad 21 to GND), grouped DIG0-7 / DIG8-15 / DIG16-23 / DIG24-31 to match the 13-contact octet windows. The 541 is flow-through: input pin p pairs with output pin 20-p, A1(2) to Y1(18) through A8(9) to Y8(11). DIRECTION IS A HARDWARE PROPERTY: DUT to instrument only. The cable carries no supply, no voltage

NOT HERE. instrument_port_digital_50_adapter_ffc_boundary_vertical is pre-mirrored to 51-n so that the expected reversing assembly - same-side Type A FFC with a vertical FH12 at both ends, connectors rotated 180 degrees - delivers DIGn to DIGn. Mirroring both ends cancels and channels arrive as DIG31-n. The ground pattern is palindromic under 51-n, so a mirrored map lands every ground identically

Per-output source damping is 100 ohms, OW-PASS-0402WGF1000TCE. That value is chosen as the smallest standard one that bounds a hard short to ground inside the LV541A's +/-35mA output absolute maximum even crediting the driver with zero impedance (3.3V/100R = 33mA); 68R gives 49mA, 47R gives 70mA, and the legacy 33R gives 100mA. It is NOT short-circuit protection and does not cover

no OE port. The owning contract was relaxed on 2026-09-15 from requiring manual disabling to permitting none, so this conforms; the reasoning and the retained future option are in kicad-libs/docs/digital-instrument-port-design-blocks.md under 'No disable control, and why'. DO NOT re-add a control as an oversight fix. Shared 10k is verified against aggregate leakage: 2 x 5uA max gives 0.1V against a 0.99V VIL. If a noise investigation ever needs a mute, detaching the FFC bounds the cable's contribution but NOT the buffers', which keep switching into their board-side traces bias is board-specific and not in this block: every unused DIGn must be tied at the board. Attach and remove the FFC with target power off; J501 is rated 20 mating cycles, so break the link at the

floor(n/2) + floor(n/16), so DIG0 is pin 2 and DIG31 is pin 49, with all 18 grounds on pins 1, 4, 7, 10, 13, 16, 19, 22, 25, 26, 29, 32, 35, 38, 41, 44, 47 and 50. THE MIRROR LIVES ON THE ADAPTER,

every fault. DEFAULT-ENABLED BY HARDWARE, AND THERE IS NO DISABLE AT ALL: both active-low OE inputs of each package share one net held low by a single 10k pull-down - R501 through R504,

switched rail cannot observe the domain it is powering down with. DECOUPLING is one 100nF per package, C502 through C505, hard against each pin 20 with a short return, plus one 4.7uF
rail-entry bulk, C501 / OW-CAP-4U7-0402-X5R-16V, at the supply entry. C501 is NOT a fifth per-IC bypass - do not 'fix' its distance to any package. Simultaneous-switching budget: 32 x 50pF

one per package - so observation works with the MCU held in reset, unprogrammed or unable to boot, and the port cannot be muted without desoldering. There is no manual jumper, no firmware link and

and damping resistors; lift the 100R resistors on the suspect channels instead. SUPPLY FROM THE BOARD'S ALWAYS-ON 3.3V RAIL, independent of firmware, HV_EN and every switched domain; a buffer on a

Supply: the always-on 3.3 V rail on VCC (pins 20); SN74LV541A runs 2 to 5.5 V, drives +/-8 mA at 3.3 V, inputs tolerate 0 to 5.5 V with Ioff <= 5 uA unpowered, VIH 2.31 V, VIL 0.99 V, edges <= 100 with the 25/26 double ground at the bank boundary. The mirror lives on instrument_port_digital_50_adapter_ffc_boundary_vertical; mirroring both ends cancels, and ERC and DRC cannot see it.

Pin mapping is the contract's DUT table and is not mirrored: channel n lands on contact 2 + n + floor(n/2) + floor(n/16), DIG0 on contact 2, DIG31 on contact 49, the 18 grounds on 1, 4, 7, ... 47, 50 reference, enable or stimulus.

The 100 ohm damping bounds a hard short of one output to GND at 33 mA, inside the +/-35 mA per-output absolute maximum, and damps edges into the cable; it is not short-circuit protection. Input leakage against the 0.99 V VIL), so observation works with the MCU in reset or unprogrammed. The contract permits this since 2026-09-15; do not re-add a control as a fix.

instrument end.

# DESIGN CONTRACT

C597991, 0.5mm pitch, symbol Conn_01x50, footprint orb_weaver_connectors:Hirose_FH12-50S-0.5SVA_1x50-4MP_P0.5mm_Vertical; the four mechanical lands are unnumbered pads and carry no net.
Thirty-two channels through four SN74LV541ARKSR octal buffers (OW-MISC-SN74LV541ARKSR, C7364695, symbol orb_weaver_misc:SN74LV541ARKSR, footprint

# OPERATION

x 3.3V = 5.3nC per all-channel edge, about 1mV of droop against the combined local reservoir. Expect meaningfully less than 4.7uF at 3.3V bias - a 4.7uF X5R in an 0402 derates hard - so treat the

DUT side of the InstrumentPort-Digital-50 profile (board-interfaces docs/instrument-port-digital.md, draft v0.1). Direction is a hardware property, DUT to instrument only: DIGn enters U501 to U504
(DIG0 to 7, 8 to 15, 16 to 23, 24 to 31, each octet one package, A8 down to A1), leaves on Y8 to Y1 through 100 ohm damping (R505 to R536) onto J501. The cable carries no supply,

Enabled by hardware default, no disable at all: both active-low enables of each package share one net held low by its 10 k pull-down (R501 to R504; at most about 0.1 V from the two inputs'

ns/V, not a Schmitt input. C502 to C505 (100 nF) bypass each pin 20; C501 (4.7 uF, X5R 0402, well below nameplate at 3.3 V bias) is the one rail-entry bulk, not a fifth per-package bypass.

DUT-side InstrumentPort-Digital-50 with integrated read-only buffering, on a VERTICAL, top-entry 50-contact ZIF connector: Hirose FH12-50S-0.5SVA(54), OW-CONN-FH12-50S-0-5SVA-54, LCSC

reference, no enable and no stimulus, and nothing in this block may be driven by the instrument. PIN MAPPING IS THE CONTRACT'S DUT TABLE AND IS NOT MIRRORED: channel n lands on pin 2 + n +

findings from this block under the shared rules; a board wanting 0.20 mm inside the block re-routes the block, not the rule (layout conventions 12).

unless the actual assembly is hot-plug qualified. Profile is InstrumentPort-Digital-50 draft v0.1, UNQUALIFIED: no measured rate, delay, skew, loading or power-state limit has been established. Marker/beacon channel indices are NOT frozen, with DIG0/DIG1 the current recommendation over the earlier DIG14/DIG15. Pairs with instrument_port_digital_50_adapter_ffc_boundary_vertical; the analyzer-specific channel map belongs to la5032_connector_boundary, not here. GROUNDED INPUTS ARE THE BOARD'S COPPER: the inputs are this block's ports, so a board that grounds unused DIGn channels draws one 0.20 mm track per grounded LV541A pad column straight into that package's thermal pad on F.Cu, before autorouting; Freerouting will not run a track along a row of same-net 0.5 nameplate value as nominal, not measured. INPUT BIAS IS BOARD-SPECIFIC AND IS NOT IN THIS BLOCK: there is no universal pull-down, because SPI selects, open-drain buses and switched-domain taps each need different bias, and pulls that must read HIGH on a switched net reference the switched rail, never the always-on one. Every unused input must be explicitly tied at the board. LV541A at 3.3V
needs VIH >= 2.31V and VIL <= 0.99V with transitions <= 100 ns/V; it is 0-5.5V input tolerant with 2pF typical input capacitance and Ioff <= 5uA at VCC=0. It is NOT Schmitt-triggered and NOT a
comparator: do not route a raw analog node through it for a timing witness, and do not treat a clean legacy LVC125A capture as LV541A qualification. OE would disable outputs only - it never removes input loading or makes a floating input acceptable, which is part of why no mute was fitted. Requires straight-ended 0.30 +/-0.05mm FFC with gold contacts, at least 2mm exposed contact and 3mm reinforcement; retention-eared cable is NOT qualified for this connector. Rated 20 mating cycles, so prefer breaking the link at the instrument end, and attach or remove the cable with target power off

mm-pitch pads and left those groups unrouted on every camera-board run (layout conventions 11a). Since 2026-09-29 every DIGn also ends at its own escape via above the pad row, so a board may

instead tie an unused channel to ground at that via; either way the grounding copper is the board's, never the block's. FLOOR COPPER IS DECLARED: the 0.10 mm gaps between the 32 damping resistors and the LV541A pins (2026-09-26) and between each DIGn escape stub and the escape via beside it (2026-09-29) are wrapped in BLOCK_FLOOR rule areas, so a consuming board sees no clearance

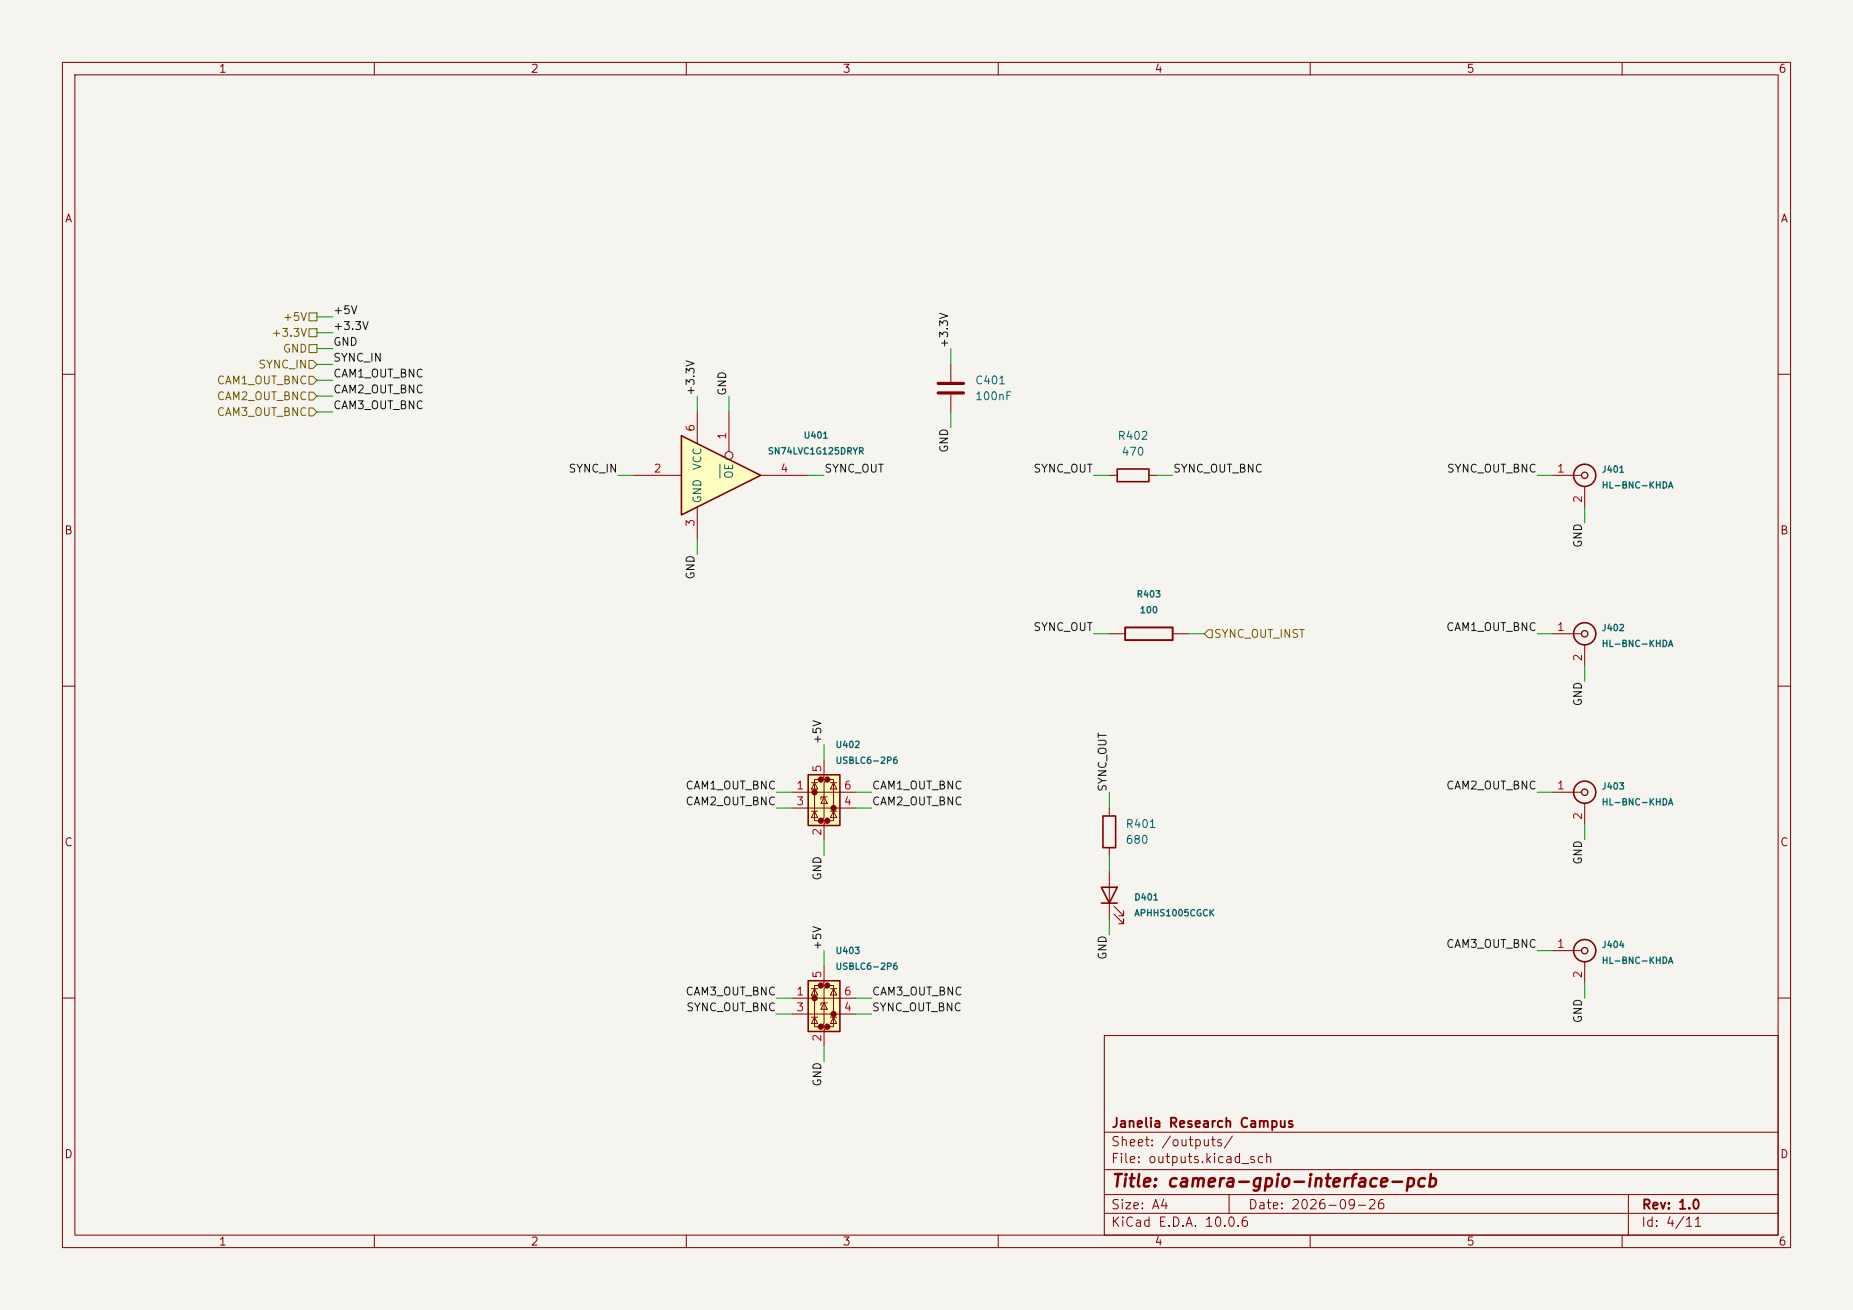
[picture p32: page 40]

Janelia Research Campus
Sheet: /outputs/
File: outputs.kicad_sch
Title: camera-gpio-interface-pcb

Size: A4 | Date: 2026-09-26 | Rev: 1.0
KiCad E.D.A. 10.0.6 | | Id: 4/11

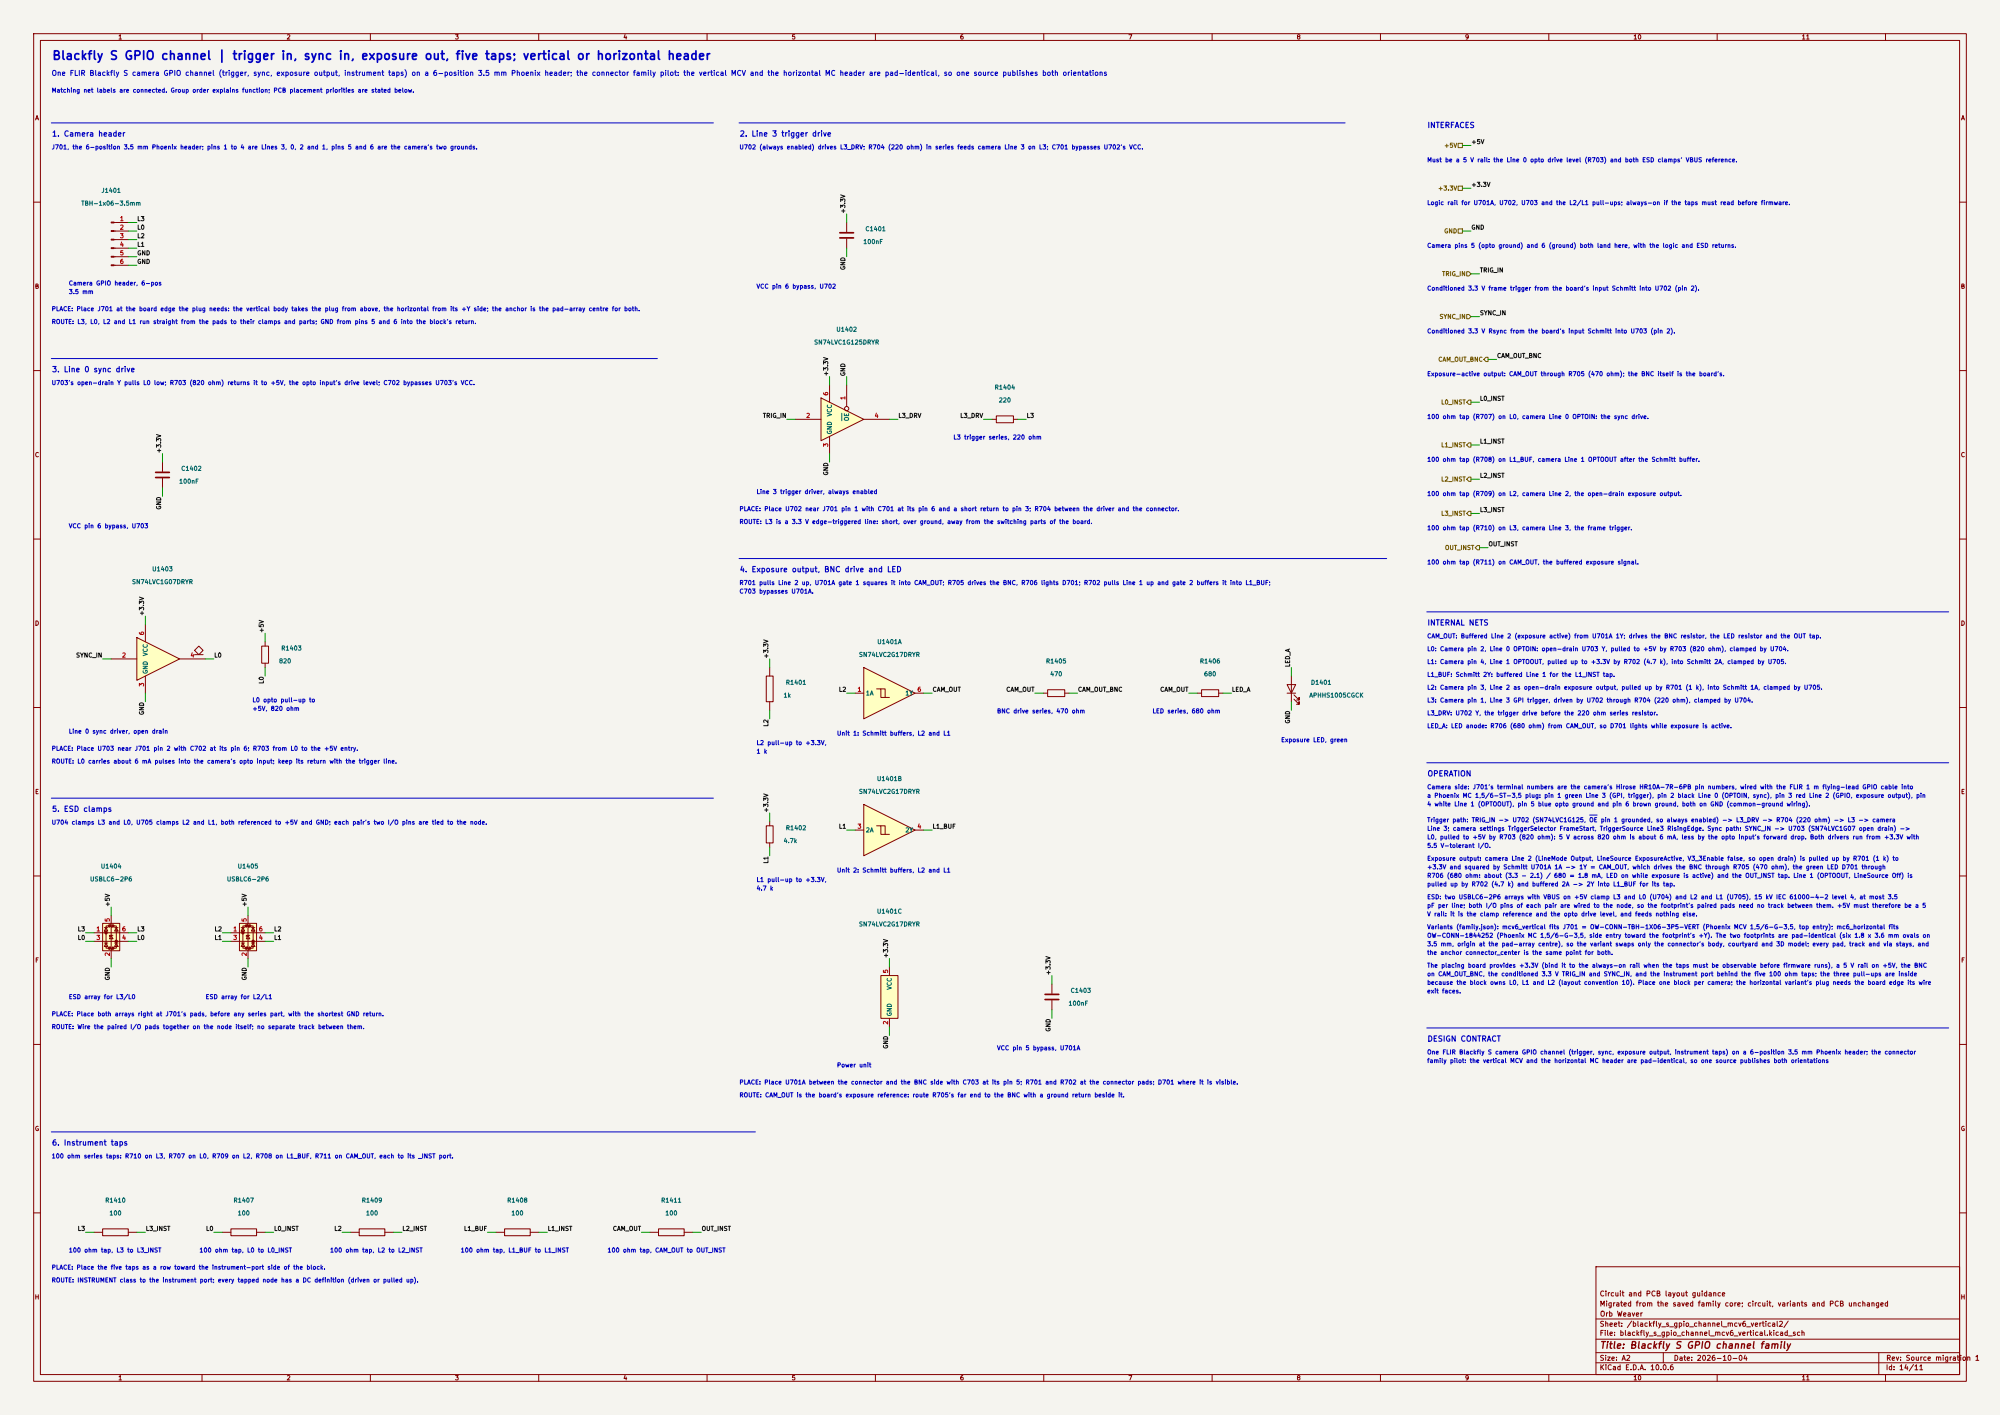
[picture p33: page 41]

Blackfly S GPIO channel | trigger in, sync in, exposure out, five taps; vertical or horizontal header

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

Matching net labels are connected. Group order explains function; PCB placement priorities are stated below.

J701, the 6-position 3.5 mm Phoenix header; pins 1 to 4 are Lines 3, 0, 2 and 1, pins 5 and 6 are the camera's two grounds.

U702 (always enabled) drives L3_DRV; R704 (220 ohm) in series feeds camera Line 3 on L3; C701 bypasses U702's VCC.

Must be a 5 V rail: the Line 0 opto drive level (R703) and both ESD clamps' VBUS reference.

Logic rail for U701A, U702, U703 and the L2/L1 pull-ups; always-on if the taps must read before firmware.

Camera pins 5 (opto ground) and 6 (ground) both land here, with the logic and ESD returns.

Camera GPIO header, 6-pos

Conditioned 3.3 V frame trigger from the board's input Schmitt into U702 (pin 2).

PLACE: Place J701 at the board edge the plug needs: the vertical body takes the plug from above, the horizontal from its +Y side; the anchor is the pad-array centre for both.

ROUTE: L3, L0, L2 and L1 run straight from the pads to their clamps and parts; GND from pins 5 and 6 into the block's return.

Conditioned 3.3 V Rsync from the board's input Schmitt into U703 (pin 2).

Exposure-active output: CAM_OUT through R705 (470 ohm); the BNC itself is the board's.

U703's open-drain Y pulls L0 low; R703 (820 ohm) returns it to +5V, the opto input's drive level; C702 bypasses U703's VCC.

100 ohm tap (R707) on L0, camera Line 0 OPTOIN: the sync drive.

100 ohm tap (R708) on L1_BUF, camera Line 1 OPTOOUT after the Schmitt buffer.

Line 3 trigger driver, always enabled

100 ohm tap (R709) on L2, camera Line 2, the open-drain exposure output.

PLACE: Place U702 near J701 pin 1 with C701 at its pin 6 and a short return to pin 3; R704 between the driver and the connector.

ROUTE: L3 is a 3.3 V edge-triggered line: short, over ground, away from the switching parts of the board.

100 ohm tap (R710) on L3, camera Line 3, the frame trigger.

4. Exposure output, BNC drive and LED

100 ohm tap (R711) on CAM_OUT, the buffered exposure signal.

R701 pulls Line 2 up, U701A gate 1 squares it into CAM_OUT; R705 drives the BNC, R706 lights D701; R702 pulls Line 1 up and gate 2 buffers it into L1_BUF;
C703 bypasses U701A.

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

L1_BUF: Schmitt 2Y: buffered Line 1 for the L1_INST tap.
L2: Camera pin 3, Line 2 as open-drain exposure output, pulled up by R701 (1 k), into Schmitt 1A, clamped by U705.

L0 opto pull-up to
+5V, 820 ohm

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

BNC drive series, 470 ohm

L3_DRV: U702 Y, the trigger drive before the 220 ohm series resistor.
LED_A: LED anode: R706 (680 ohm) from CAM_OUT, so D701 lights while exposure is active.

Line 0 sync driver, open drain

Unit 1: Schmitt buffers, L2 and L1

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

Camera side: J701's terminal numbers are the camera's Hirose HR10A-7R-6PB pin numbers, wired with the FLIR 1 m flying-lead GPIO cable into
a Phoenix MC 1,5/6-ST-3,5 plug: pin 1 green Line 3 (GPI, trigger), pin 2 black Line 0 (OPTOIN, sync), pin 3 red Line 2 (GPIO, exposure output), pin
4 white Line 1 (OPTOOUT), pin 5 blue opto ground and pin 6 brown ground, both on GND (common-ground wiring).

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

Trigger path: TRIG_IN -> U702 (SN74LVC1G125, OE pin 1 grounded, so always enabled) -> L3_DRV -> R704 (220 ohm) -> L3 -> camera
Line 3; camera settings TriggerSelector FrameStart, TriggerSource Line3 RisingEdge. Sync path: SYNC_IN -> U703 (SN74LVC1G07 open drain) ->
L0, pulled to +5V by R703 (820 ohm): 5 V across 820 ohm is about 6 mA, less by the opto input's forward drop. Both drivers run from +3.3V with
5.5 V-tolerant I/O.

Exposure output: camera Line 2 (LineMode Output, LineSource ExposureActive, V3_3Enable false, so open drain) is pulled up by R701 (1 k) to
+3.3V and squared by Schmitt U701A 1A -> 1Y = CAM_OUT, which drives the BNC through R705 (470 ohm), the green LED D701 through
R706 (680 ohm: about (3.3 - 2.1) / 680 = 1.8 mA, LED on while exposure is active) and the OUT_INST tap. Line 1 (OPTOOUT, LineSource Off) is
pulled up by R702 (4.7 k) and buffered 2A -> 2Y into L1_BUF for its tap.

Unit 2: Schmitt buffers, L2 and L1

ESD: two USBLC6-2P6 arrays with VBUS on +5V clamp L3 and L0 (U704) and L2 and L1 (U705), 15 kV IEC 61000-4-2 level 4, at most 3.5
pF per line; both I/O pins of each pair are wired to the node, so the footprint's paired pads need no track between them. +5V must therefore be a 5
V rail: it is the clamp reference and the opto drive level, and feeds nothing else.
Variants (family.json): mcv6_vertical fits J701 = OW-CONN-TBH-1X06-3P5-VERT (Phoenix MCV 1,5/6-G-3,5, top entry); mc6_horizontal fits
OW-CONN-1844252 (Phoenix MC 1,5/6-G-3,5, side entry toward the footprint's +Y). The two footprints are pad-identical (six 1.8 x 3.6 mm ovals on
3.5 mm, origin at the pad-array centre), so the variant swaps only the connector's body, courtyard and 3D model; every pad, track and via stays, and
the anchor connector_center is the same point for both.
The placing board provides +3.3V (bind it to the always-on rail when the taps must be observable before firmware runs), a 5 V rail on +5V, the BNC
on CAM_OUT_BNC, the conditioned 3.3 V TRIG_IN and SYNC_IN, and the instrument port behind the five 100 ohm taps; the three pull-ups are inside
because the block owns L0, L1 and L2 (layout convention 10). Place one block per camera; the horizontal variant's plug needs the board edge its wire
exit faces.

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

100 ohm series taps: R710 on L3, R707 on L0, R709 on L2, R708 on L1_BUF, R711 on CAM_OUT, each to its _INST port.

PLACE: Place the five taps as a row toward the instrument-port side of the block.
ROUTE: INSTRUMENT class to the instrument port; every tapped node has a DC definition (driven or pulled up).

Circuit and PCB layout guidance
Migrated from the saved family core; circuit, variants and PCB unchanged
Orb Weaver
Sheet: /blackfly_s_gpio_channel_mcv6_vertical2/
File: blackfly_s_gpio_channel_mcv6_vertical.kicad_sch
Title: Blackfly S GPIO channel family

Date: 2026-10-04

KiCad E.D.A. 10.0.6 | | Id: 14/11

1 | 2 | 3 | 4 | 5 | 6 | 7 | 8 | 9 | 10 | 11

1
2
3
4
5
6

J1401

## TBH-1x06-3.5mm

L0

L3

L2
L1

## GND GND

## Camera GPIO header, 6-pos

3.5 mm

Matching net labels are connected. Group order explains function; PCB placement priorities are stated below.

# 1. Camera header

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

Blackfly S GPIO channel | trigger in, sync in, exposure out, five taps; vertical or horizontal header

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

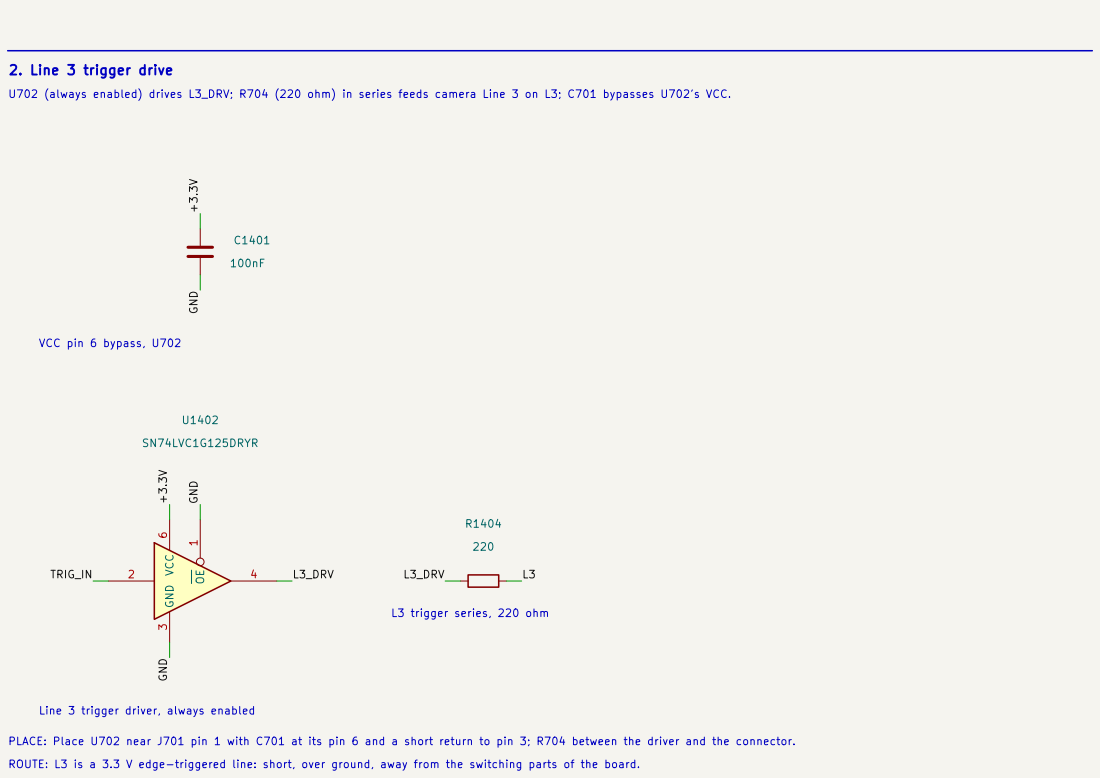
[picture p34: page 43]
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

Line 3 trigger driver, always enabled

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

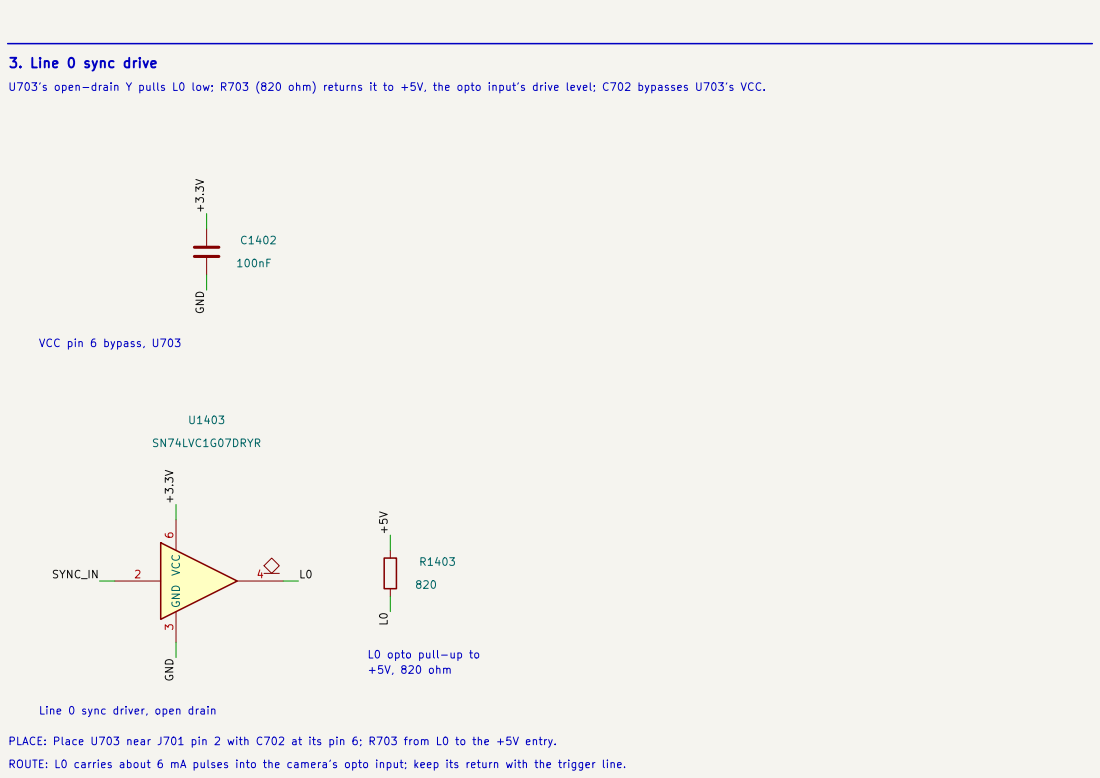
[picture p35: page 44]
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

L0 opto pull-up to
+5V, 820 ohm

Line 0 sync driver, open drain

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

GND

# 2 VCC

5

U1401C

### SN74LVC2G17DRYR

R1405

470

1A 1

1Y 6

U1401A

### SN74LVC2G17DRYR

R1406

680

2A 3

2Y 4

U1401B

### SN74LVC2G17DRYR

R1402

4.7k

D1401

### APHHS1005CGCK

C1403

100nF

R1401

1k

### CAM_OUT

### CAM_OUT_BNC

L1

GND

### L1_BUF

L1

GND

L2

### LED_A

### CAM_OUT

+3.3V

### CAM_OUT

### LED_A

+3.3V

L2

GND

+3.3V

+3.3V

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

### Unit 2: Schmitt buffers, L2 and L1

## INTERNAL NETS

100 ohm tap (R711) on CAM_OUT, the buffered exposure signal.

One FLIR Blackfly S camera GPIO channel (trigger, sync, exposure output, instrument taps) on a 6-position 3.5 mm Phoenix header; the connector because the block owns L0, L1 and L2 (layout convention 10). Place one block per camera; the horizontal variant's plug needs the board edge its wire

4.7 k

exit faces.

### VCC pin 5 bypass, U701A

### LED series, 680 ohm

L1 pull-up to +3.3V,

## DESIGN CONTRACT

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

the anchor connector_center is the same point for both.

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

V rail: it is the clamp reference and the opto drive level, and feeds nothing else.

pF per line; both I/O pins of each pair are wired to the node, so the footprint's paired pads need no track between them. +5V must therefore be a 5 pulled up by R702 (4.7 k) and buffered 2A -> 2Y into L1_BUF for its tap.

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

5.5 V-tolerant I/O.

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

Line 3; camera settings TriggerSelector FrameStart, TriggerSource Line3 RisingEdge. Sync path: SYNC_IN -> U703 (SN74LVC1G07 open drain) ->

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

## OPERATION

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

LED_A: LED anode: R706 (680 ohm) from CAM_OUT, so D701 lights while exposure is active.

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

L3_DRV: U702 Y, the trigger drive before the 220 ohm series resistor.

L1_BUF: Schmitt 2Y: buffered Line 1 for the L1_INST tap.

## 4. Exposure output, BNC drive and LED

### BNC drive series, 470 ohm

### Unit 1: Schmitt buffers, L2 and L1

L2 pull-up to +3.3V,

C703 bypasses U701A.

### Power unit

### Exposure LED, green

1 k

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

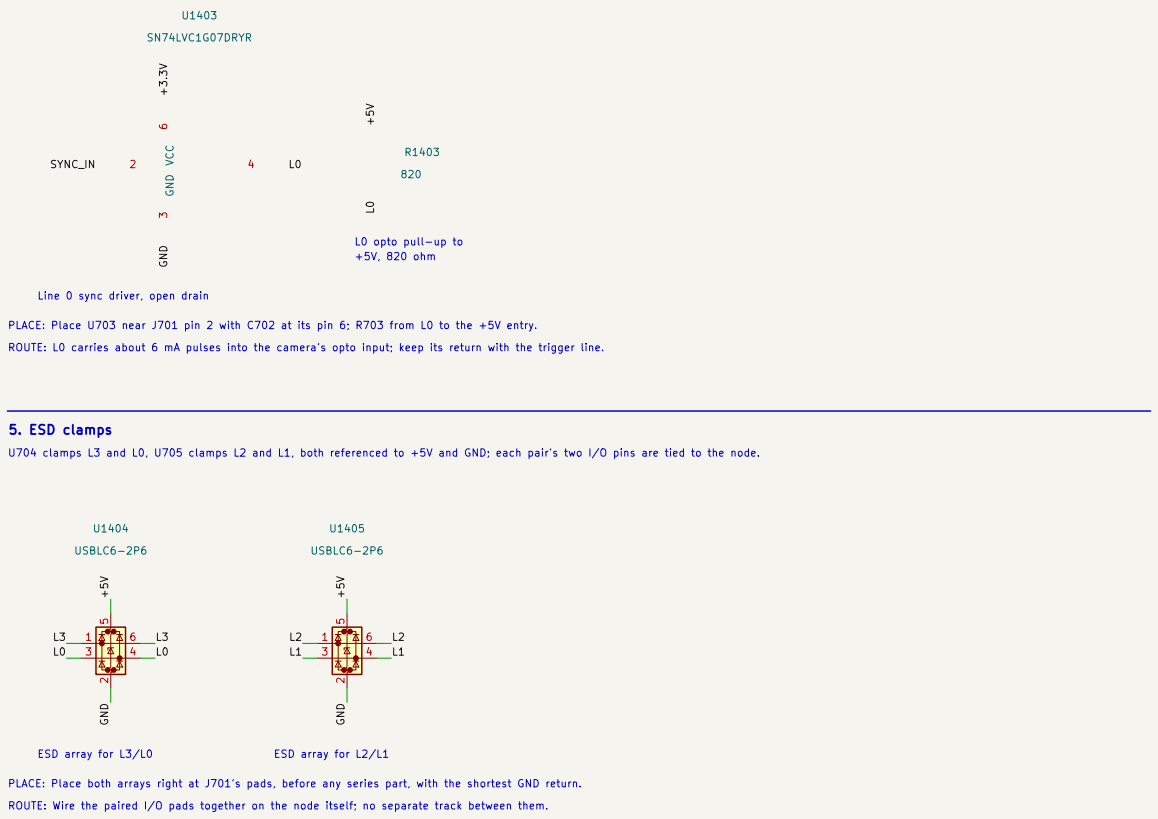
[picture p36: page 46]

L0 opto pull-up to
+5V, 820 ohm

Line 0 sync driver, open drain

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

R1411

100

R1409

100

1

2

3 | 4

5
| 6

U1404

## USBLC6-2P6

R1407

100

R1410

100

R1408

100

1

2

3 | 4

5
| 6

U1405

## USBLC6-2P6

GND

## OUT_INSTCAM_OUT

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
## L3_INSTL3

## L2_INST

L1_BUF | L1_INST
L0 | L0_INST

4.7 k

L1 pull-up to +3.3V,

# 6. Instrument taps

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

100 ohm tap, L1_BUF to L1_INST | 100 ohm tap, CAM_OUT to OUT_INST
100 ohm tap, L3 to L3_INST | 100 ohm tap, L0 to L0_INST | 100 ohm tap, L2 to L2_INST

PLACE: Place the five taps as a row toward the instrument-port side of the block.

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

# 5. ESD clamps

ESD array for L3/L0 | ESD array for L2/L1

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

1 | 2 | 3 | 4 | 5 | 6 | 7 | 8 | 9 | 10 | 11

# L1_INST

# CAM_OUT_BNC

# L2_INST

+3.3V

# L3_INST

+5V

# TRIG_IN

# OUT_INST

# SYNC_IN

# GND

# L0_INST

# OUT_INST

+5V

+3.3V

# GND

# TRIG_IN

# SYNC_IN

# CAM_OUT_BNC

# L0_INST

# L1_INST

# L2_INST

# L3_INST

100 ohm tap (R711) on CAM_OUT, the buffered exposure signal.

100 ohm tap (R710) on L3, camera Line 3, the frame trigger.

Conditioned 3.3 V Rsync from the board's input Schmitt into U703 (pin 2).

Conditioned 3.3 V frame trigger from the board's input Schmitt into U702 (pin 2).

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

100 ohm tap (R709) on L2, camera Line 2, the open-drain exposure output.

100 ohm tap (R708) on L1_BUF, camera Line 1 OPTOOUT after the Schmitt buffer.

100 ohm tap (R707) on L0, camera Line 0 OPTOIN: the sync drive.

Exposure-active output: CAM_OUT through R705 (470 ohm); the BNC itself is the board's.

# INTERFACES

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

D

E

F

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

# INTERNAL NETS

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

# DESIGN CONTRACT

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

the anchor connector_center is the same point for both.

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

V rail: it is the clamp reference and the opto drive level, and feeds nothing else.

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

5.5 V-tolerant I/O.

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

Line 3; camera settings TriggerSelector FrameStart, TriggerSource Line3 RisingEdge. Sync path: SYNC_IN -> U703 (SN74LVC1G07 open drain) ->

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

# OPERATION

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

LED_A: LED anode: R706 (680 ohm) from CAM_OUT, so D701 lights while exposure is active.

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

L3_DRV: U702 Y, the trigger drive before the 220 ohm series resistor.

L1_BUF: Schmitt 2Y: buffered Line 1 for the L1_INST tap.

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

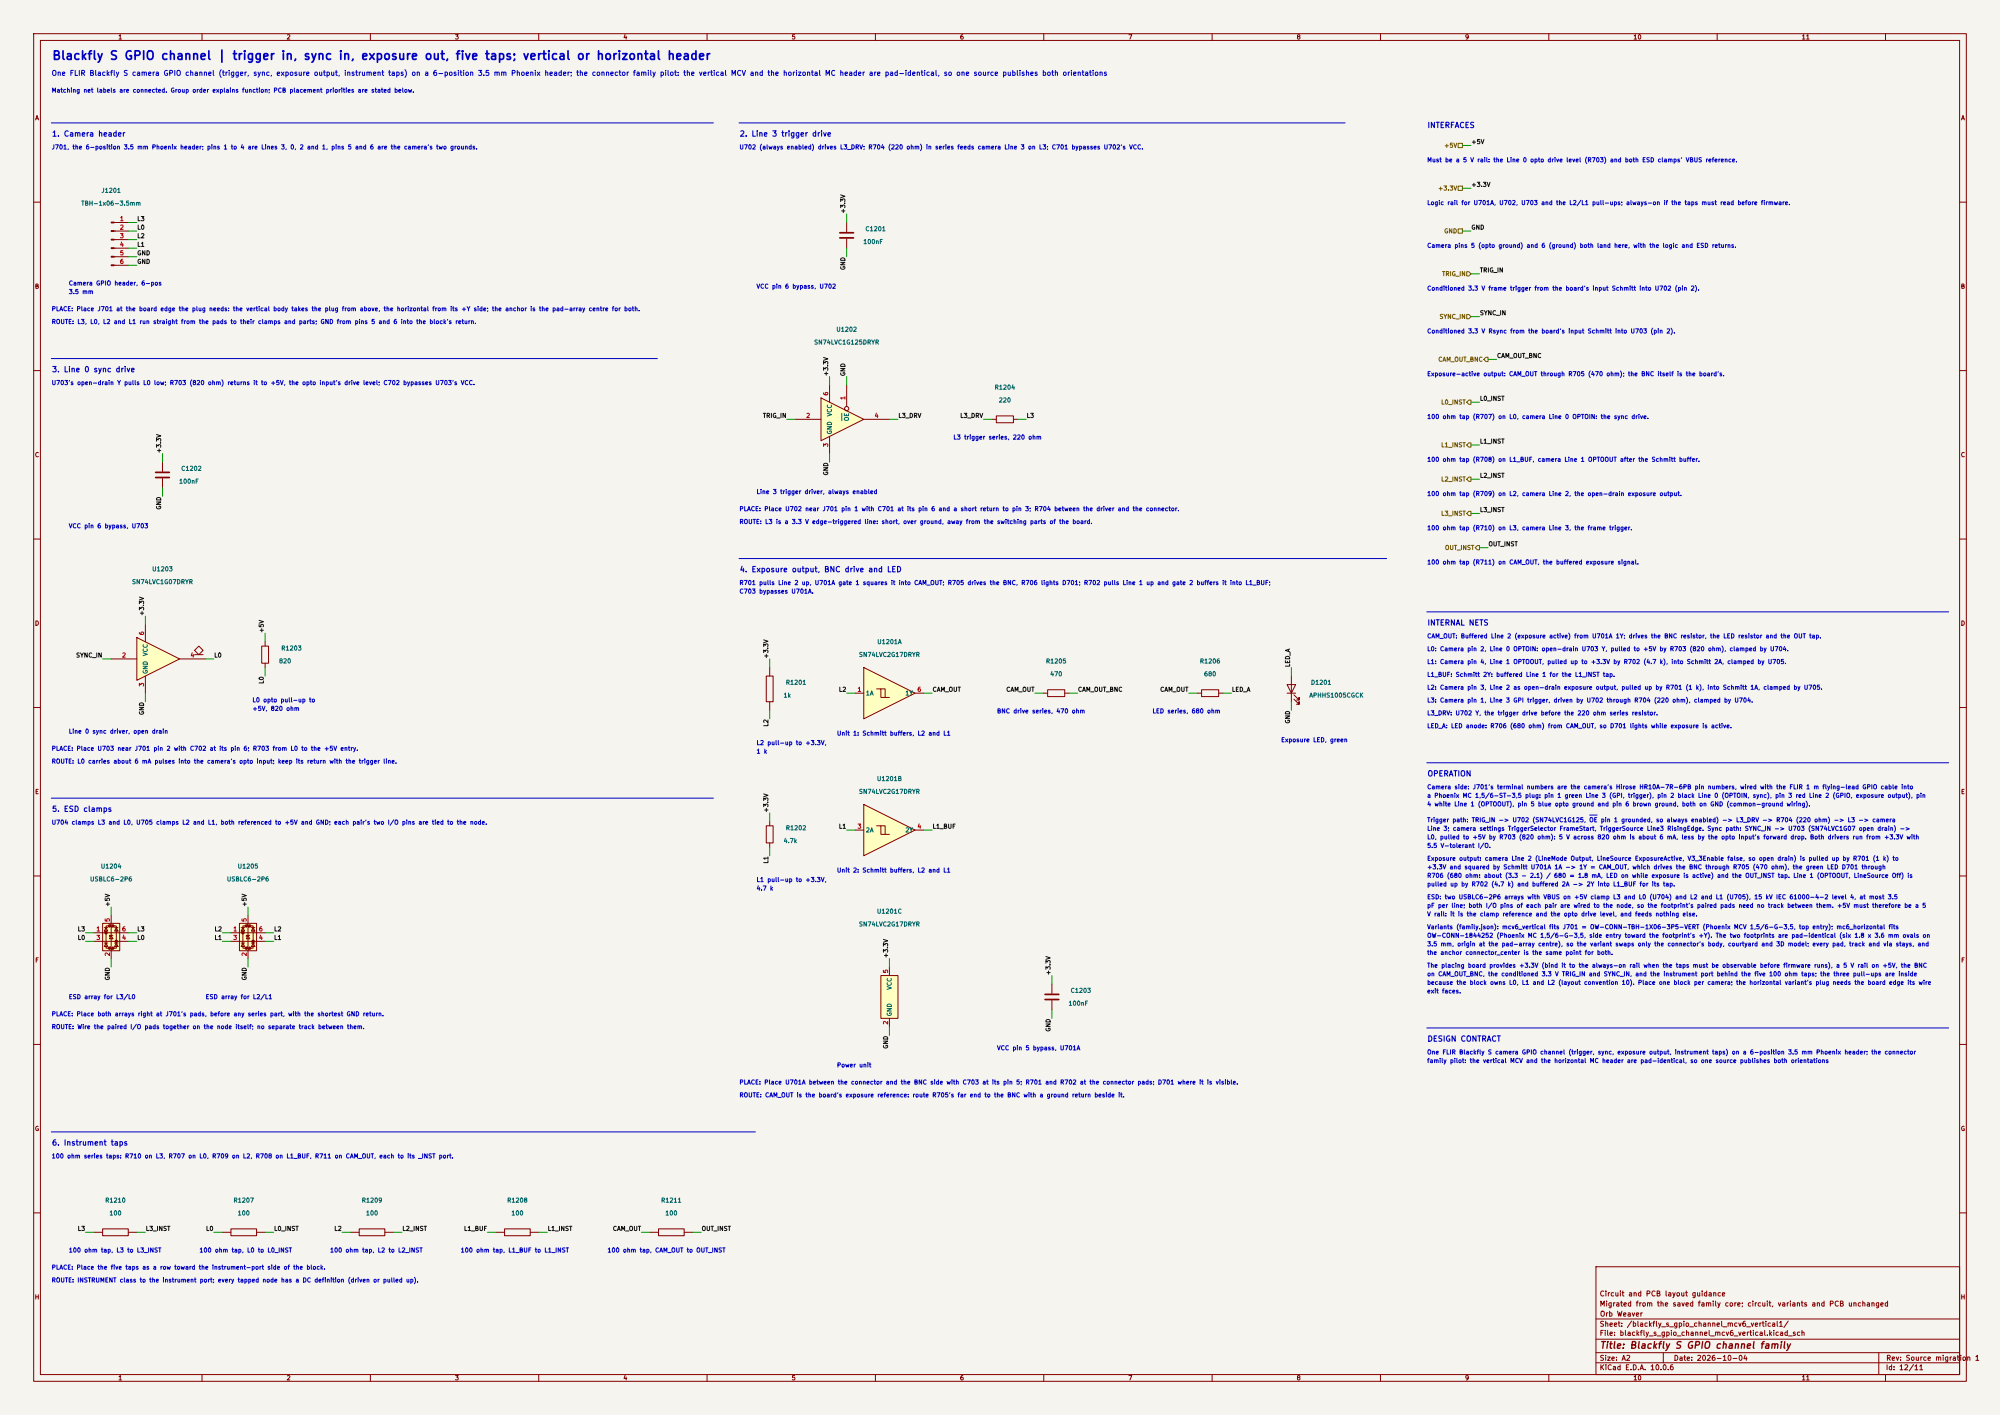
[picture p37: page 50]

Blackfly S GPIO channel | trigger in, sync in, exposure out, five taps; vertical or horizontal header

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

Matching net labels are connected. Group order explains function; PCB placement priorities are stated below.

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

Camera GPIO header, 6-pos

Conditioned 3.3 V frame trigger from the board's input Schmitt into U702 (pin 2).

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

Conditioned 3.3 V Rsync from the board's input Schmitt into U703 (pin 2).

Exposure-active output: CAM_OUT through R705 (470 ohm); the BNC itself is the board's.

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

100 ohm tap (R707) on L0, camera Line 0 OPTOIN: the sync drive.

100 ohm tap (R708) on L1_BUF, camera Line 1 OPTOOUT after the Schmitt buffer.

Line 3 trigger driver, always enabled

100 ohm tap (R709) on L2, camera Line 2, the open-drain exposure output.

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

100 ohm tap (R710) on L3, camera Line 3, the frame trigger.

4. Exposure output, BNC drive and LED

100 ohm tap (R711) on CAM_OUT, the buffered exposure signal.

R701 pulls Line 2 up, U701A gate 1 squares it into CAM_OUT; R705 drives the BNC, R706 lights D701; R702 pulls Line 1 up and gate 2 buffers it into L1_BUF;
C703 bypasses U701A.

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

L1_BUF: Schmitt 2Y: buffered Line 1 for the L1_INST tap.
L2: Camera pin 3, Line 2 as open-drain exposure output, pulled up by R701 (1 k), into Schmitt 1A, clamped by U705.

L0 opto pull-up to
+5V, 820 ohm

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

BNC drive series, 470 ohm

L3_DRV: U702 Y, the trigger drive before the 220 ohm series resistor.
LED_A: LED anode: R706 (680 ohm) from CAM_OUT, so D701 lights while exposure is active.

Line 0 sync driver, open drain

Unit 1: Schmitt buffers, L2 and L1

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

Camera side: J701's terminal numbers are the camera's Hirose HR10A-7R-6PB pin numbers, wired with the FLIR 1 m flying-lead GPIO cable into
a Phoenix MC 1,5/6-ST-3,5 plug: pin 1 green Line 3 (GPI, trigger), pin 2 black Line 0 (OPTOIN, sync), pin 3 red Line 2 (GPIO, exposure output), pin
4 white Line 1 (OPTOOUT), pin 5 blue opto ground and pin 6 brown ground, both on GND (common-ground wiring).

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

Trigger path: TRIG_IN -> U702 (SN74LVC1G125, OE pin 1 grounded, so always enabled) -> L3_DRV -> R704 (220 ohm) -> L3 -> camera
Line 3; camera settings TriggerSelector FrameStart, TriggerSource Line3 RisingEdge. Sync path: SYNC_IN -> U703 (SN74LVC1G07 open drain) ->
L0, pulled to +5V by R703 (820 ohm): 5 V across 820 ohm is about 6 mA, less by the opto input's forward drop. Both drivers run from +3.3V with
5.5 V-tolerant I/O.

Exposure output: camera Line 2 (LineMode Output, LineSource ExposureActive, V3_3Enable false, so open drain) is pulled up by R701 (1 k) to
+3.3V and squared by Schmitt U701A 1A -> 1Y = CAM_OUT, which drives the BNC through R705 (470 ohm), the green LED D701 through
R706 (680 ohm: about (3.3 - 2.1) / 680 = 1.8 mA, LED on while exposure is active) and the OUT_INST tap. Line 1 (OPTOOUT, LineSource Off) is
pulled up by R702 (4.7 k) and buffered 2A -> 2Y into L1_BUF for its tap.

Unit 2: Schmitt buffers, L2 and L1

ESD: two USBLC6-2P6 arrays with VBUS on +5V clamp L3 and L0 (U704) and L2 and L1 (U705), 15 kV IEC 61000-4-2 level 4, at most 3.5
pF per line; both I/O pins of each pair are wired to the node, so the footprint's paired pads need no track between them. +5V must therefore be a 5
V rail: it is the clamp reference and the opto drive level, and feeds nothing else.
Variants (family.json): mcv6_vertical fits J701 = OW-CONN-TBH-1X06-3P5-VERT (Phoenix MCV 1,5/6-G-3,5, top entry); mc6_horizontal fits
OW-CONN-1844252 (Phoenix MC 1,5/6-G-3,5, side entry toward the footprint's +Y). The two footprints are pad-identical (six 1.8 x 3.6 mm ovals on
3.5 mm, origin at the pad-array centre), so the variant swaps only the connector's body, courtyard and 3D model; every pad, track and via stays, and
the anchor connector_center is the same point for both.
The placing board provides +3.3V (bind it to the always-on rail when the taps must be observable before firmware runs), a 5 V rail on +5V, the BNC
on CAM_OUT_BNC, the conditioned 3.3 V TRIG_IN and SYNC_IN, and the instrument port behind the five 100 ohm taps; the three pull-ups are inside
because the block owns L0, L1 and L2 (layout convention 10). Place one block per camera; the horizontal variant's plug needs the board edge its wire
exit faces.

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

PLACE: Place the five taps as a row toward the instrument-port side of the block.
ROUTE: INSTRUMENT class to the instrument port; every tapped node has a DC definition (driven or pulled up).

Circuit and PCB layout guidance
Migrated from the saved family core; circuit, variants and PCB unchanged
Orb Weaver
Sheet: /blackfly_s_gpio_channel_mcv6_vertical1/
File: blackfly_s_gpio_channel_mcv6_vertical.kicad_sch
Title: Blackfly S GPIO channel family

Date: 2026-10-04

KiCad E.D.A. 10.0.6 | | Id: 12/11

1 | 2 | 3 | 4 | 5 | 6 | 7 | 8 | 9 | 10 | 11

1
2
3
4
5
6

J1201

## TBH-1x06-3.5mm

L0

L3

L2
L1

## GND GND

## Camera GPIO header, 6-pos

3.5 mm

Matching net labels are connected. Group order explains function; PCB placement priorities are stated below.

# 1. Camera header

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

Blackfly S GPIO channel | trigger in, sync in, exposure out, five taps; vertical or horizontal header

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

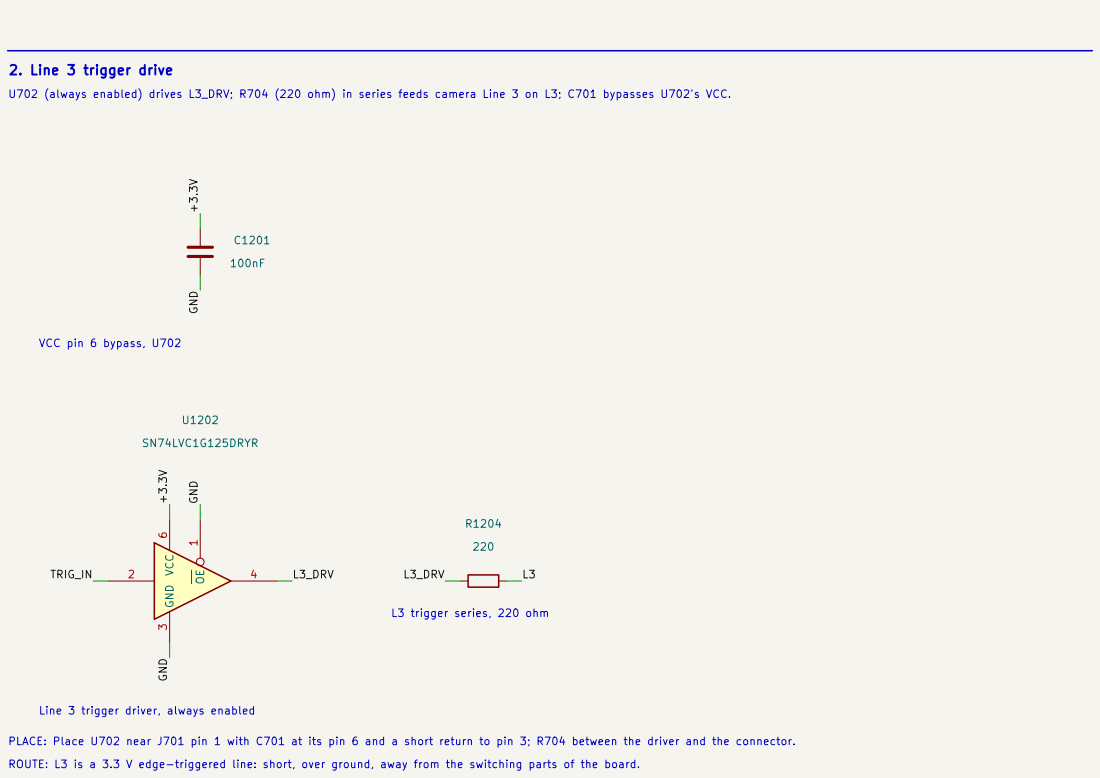
[picture p38: page 52]
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

Line 3 trigger driver, always enabled

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

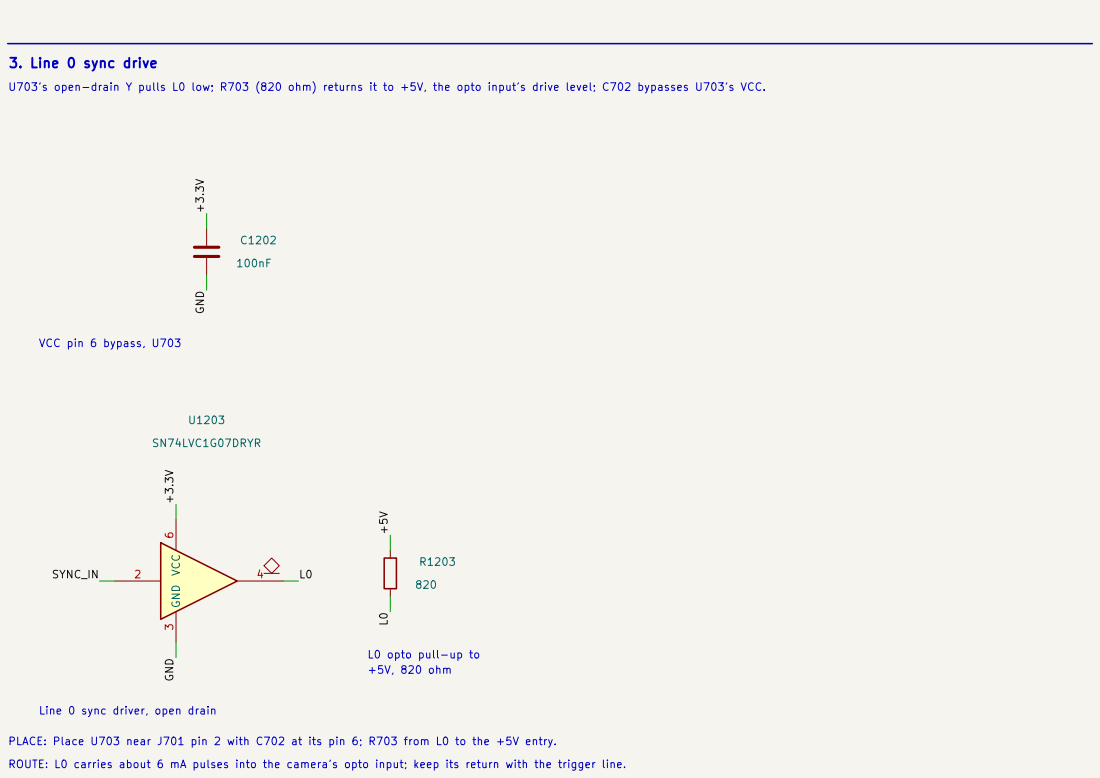
[picture p39: page 53]
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

L0 opto pull-up to
+5V, 820 ohm

Line 0 sync driver, open drain

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

GND

# 2 VCC

5

U1201C

### SN74LVC2G17DRYR

R1205

470

1A 1

1Y 6

U1201A

### SN74LVC2G17DRYR

R1206

680

2A 3

2Y 4

U1201B

### SN74LVC2G17DRYR

R1202

4.7k

D1201

### APHHS1005CGCK

C1203

100nF

R1201

1k

### CAM_OUT

### CAM_OUT_BNC

L1

GND

### L1_BUF

L1

GND

L2

### LED_A

### CAM_OUT

+3.3V

### CAM_OUT

### LED_A

+3.3V

L2

GND

+3.3V

+3.3V

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

### Unit 2: Schmitt buffers, L2 and L1

## INTERNAL NETS

100 ohm tap (R711) on CAM_OUT, the buffered exposure signal.

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

4.7 k

exit faces.

### VCC pin 5 bypass, U701A

### LED series, 680 ohm

L1 pull-up to +3.3V,

## DESIGN CONTRACT

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

the anchor connector_center is the same point for both.

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

V rail: it is the clamp reference and the opto drive level, and feeds nothing else.

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

5.5 V-tolerant I/O.

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

Line 3; camera settings TriggerSelector FrameStart, TriggerSource Line3 RisingEdge. Sync path: SYNC_IN -> U703 (SN74LVC1G07 open drain) ->

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

## OPERATION

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

LED_A: LED anode: R706 (680 ohm) from CAM_OUT, so D701 lights while exposure is active.

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

L3_DRV: U702 Y, the trigger drive before the 220 ohm series resistor.

L1_BUF: Schmitt 2Y: buffered Line 1 for the L1_INST tap.

## 4. Exposure output, BNC drive and LED

### BNC drive series, 470 ohm

### Unit 1: Schmitt buffers, L2 and L1

L2 pull-up to +3.3V,

C703 bypasses U701A.

### Power unit

### Exposure LED, green

1 k

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

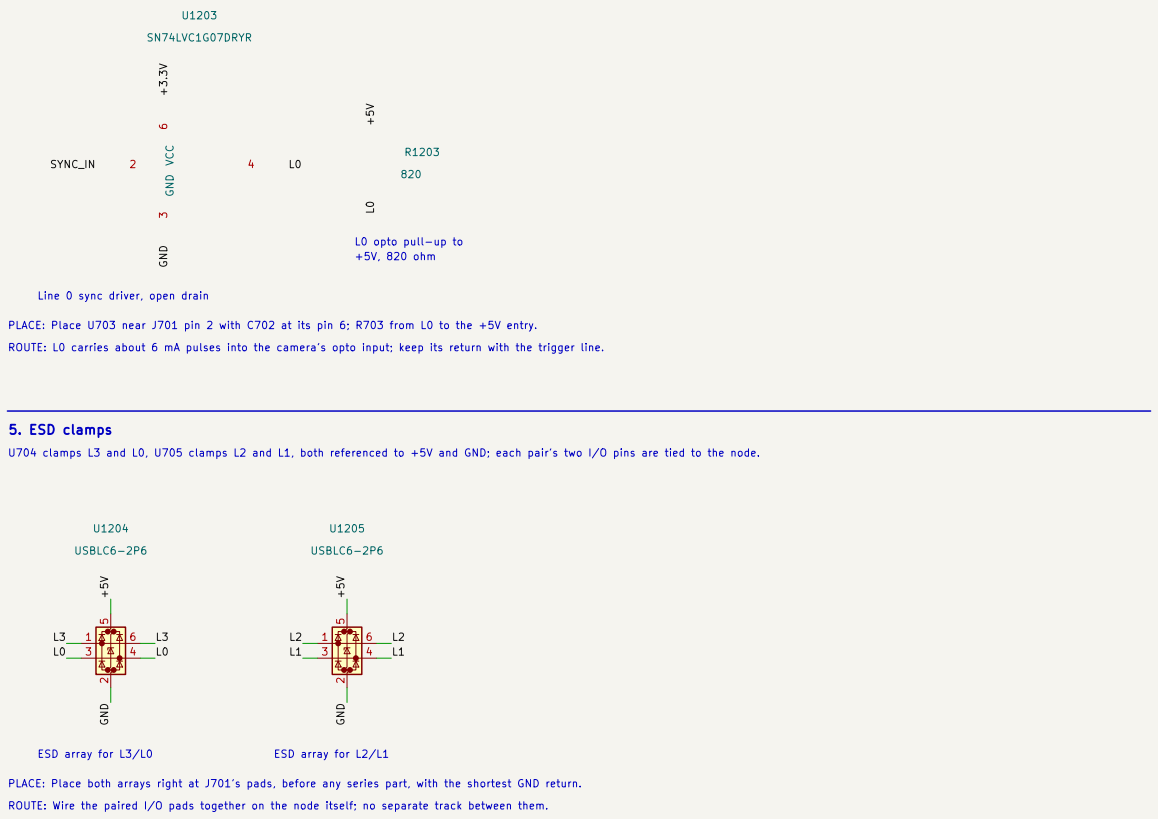
[picture p40: page 55]

L0 opto pull-up to
+5V, 820 ohm

Line 0 sync driver, open drain

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

R1211

100

R1209

100

1

2

3 | 4

5
| 6

U1204

## USBLC6-2P6

R1207

100

R1210

100

R1208

100

1

2

3 | 4

5
| 6

U1205

## USBLC6-2P6

GND

## OUT_INSTCAM_OUT

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
## L3_INSTL3

## L2_INST

L1_BUF | L1_INST
L0 | L0_INST

4.7 k

L1 pull-up to +3.3V,

# 6. Instrument taps

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

100 ohm tap, L1_BUF to L1_INST | 100 ohm tap, CAM_OUT to OUT_INST
100 ohm tap, L3 to L3_INST | 100 ohm tap, L0 to L0_INST | 100 ohm tap, L2 to L2_INST

PLACE: Place the five taps as a row toward the instrument-port side of the block.

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

# 5. ESD clamps

ESD array for L3/L0 | ESD array for L2/L1

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

1 | 2 | 3 | 4 | 5 | 6 | 7 | 8 | 9 | 10 | 11

# L1_INST

# CAM_OUT_BNC

# L2_INST

+3.3V

# L3_INST

+5V

# TRIG_IN

# OUT_INST

# SYNC_IN

# GND

# L0_INST

# OUT_INST

+5V

+3.3V

# GND

# TRIG_IN

# SYNC_IN

# CAM_OUT_BNC

# L0_INST

# L1_INST

# L2_INST

# L3_INST

100 ohm tap (R711) on CAM_OUT, the buffered exposure signal.

100 ohm tap (R710) on L3, camera Line 3, the frame trigger.

Conditioned 3.3 V Rsync from the board's input Schmitt into U703 (pin 2).

Conditioned 3.3 V frame trigger from the board's input Schmitt into U702 (pin 2).

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

100 ohm tap (R709) on L2, camera Line 2, the open-drain exposure output.

100 ohm tap (R708) on L1_BUF, camera Line 1 OPTOOUT after the Schmitt buffer.

100 ohm tap (R707) on L0, camera Line 0 OPTOIN: the sync drive.

Exposure-active output: CAM_OUT through R705 (470 ohm); the BNC itself is the board's.

# INTERFACES

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

D

E

F

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

# INTERNAL NETS

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

# DESIGN CONTRACT

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

the anchor connector_center is the same point for both.

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

V rail: it is the clamp reference and the opto drive level, and feeds nothing else.

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

5.5 V-tolerant I/O.

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

Line 3; camera settings TriggerSelector FrameStart, TriggerSource Line3 RisingEdge. Sync path: SYNC_IN -> U703 (SN74LVC1G07 open drain) ->

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

# OPERATION

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

LED_A: LED anode: R706 (680 ohm) from CAM_OUT, so D701 lights while exposure is active.

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

L3_DRV: U702 Y, the trigger drive before the 220 ohm series resistor.

L1_BUF: Schmitt 2Y: buffered Line 1 for the L1_INST tap.

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
