peterpolidoro/camera-gpio-interface-pcb/docs/generated/mechanical/mounting-holes.csv

reference | x_mm | y_mm | drill_diameter_mm | plated | footprint
H101 | -45.0 | 25.0 | 3.2 | False | MountingHole:MountingHole_3.2mm_M3
H102 | 45.0 | 25.0 | 3.2 | False | MountingHole:MountingHole_3.2mm_M3
H103 | 45.0 | -25.0 | 3.2 | False | MountingHole:MountingHole_3.2mm_M3
H104 | -45.0 | -25.0 | 3.2 | False | MountingHole:MountingHole_3.2mm_M3
J901 | -44.0 | -3.0 | 0.71 | False | orb_weaver_connectors:USB_C_Receptacle_GCT_USB4145-03-0070-C_16P_Vertical
J901 | -44.0 | 5.0 | 0.71 | False | orb_weaver_connectors:USB_C_Receptacle_GCT_USB4145-03-0070-C_16P_Vertical
