peterpolidoro/camera-gpio-interface-pcb/docs/generated/bom/camera-gpio-interface-pcb-bom.md

# camera-gpio-interface-pcb Bill of Materials

Generated by `orb-weaver-kicad-docs`. Do not edit by hand.

26 distinct parts, 151 placements. `LCSC` is the JLCPCB
catalog number the assembly BOM resolves to, linked to its LCSC page; the
datasheet is the catalog's where it records one (12 of 26 parts).

| Qty | References | Value | Package | Manufacturer | MPN | LCSC | Datasheet |
| --- | --- | --- | --- | --- | --- | --- | --- |
| 2 | C1001, C1002 | 1uF | 0402 | Samsung Electro-Mechanics | CL05A105KL5NRNC | [C307413](https://www.lcsc.com/product-detail/C307413.html) |  |
| 2 | C1101, C1102 | 470pF | 0402 | Murata Electronics | GRM1555C2A471JE01D | [C1518202](https://www.lcsc.com/product-detail/C1518202.html) |  |
| 16 | C1103, C1201, C1202, C1203, C1401, C1402, C1403, C401, C502, C503, C504, C505, C701, C702, C703, C901 | 100nF | 0402 | Murata Electronics | GRM155R62A104KE14D | [C162178](https://www.lcsc.com/product-detail/C162178.html) |  |
| 1 | C501 | 4.7uF | 0402 | Murata Electronics | GRM155R61E475ME15D | [C2858031](https://www.lcsc.com/product-detail/C2858031.html) |  |
| 7 | D1201, D1401, D201, D301, D302, D401, D701 | APHHS1005CGCK | 0402 | Kingbright | APHHS1005CGCK | [C2853065](https://www.lcsc.com/product-detail/C2853065.html) | [datasheet](https://www.kingbrightusa.com/images/catalog/SPEC/APHHS1005CGCK.pdf) |
| 1 | D901 | MBR120VLSFT1G | SOD-123FL | onsemi | MBR120VLSFT1G | [C223608](https://www.lcsc.com/product-detail/C223608.html) | [datasheet](https://www.onsemi.com/pdf/datasheet/mbr120vlsft1-d.pdf) |
| 3 | J1201, J1401, J701 | TBH-1x06-3.5mm | Plugin,P=3.5mm | Phoenix Contact | 1843648 | [C5443576](https://www.lcsc.com/product-detail/C5443576.html) | [datasheet](https://www.phoenixcontact.com/en-pc/products/1843648) |
| 6 | J301, J302, J401, J402, J403, J404 | HL-BNC-KHDA | Plugin | Shenzhen HenryTech | HL-BNC-KHDA | [C19712152](https://www.lcsc.com/product-detail/C19712152.html) | [datasheet](https://jlcpcb.com/partdetail/C19712152) |
| 1 | J501 | FH12-50S-0.5SVA(54) | SMD,P=0.5mm | Hirose Electric | FH12-50S-0.5SVA(54) | [C597991](https://www.lcsc.com/product-detail/C597991.html) | [datasheet](https://www.hirose.com/product/en/products/FH12/FH12-50S-0.5SVA%2854%29/) |
| 1 | J901 | USB-C | SMD | Global Connector Technology | USB4145-03-0070-C | [C5815189](https://www.lcsc.com/product-detail/C5815189.html) | [datasheet](https://gct.co/files/drawings/usb4145.pdf) |
| 4 | R1101, R1102, R1105, R1106 | 100k | 0402 | YAGEO | RC0402JR-07100KL | [C106234](https://www.lcsc.com/product-detail/C106234.html) |  |
| 5 | R1103, R1104, R1202, R1402, R702 | 4.7k | 0402 | UNI-ROYAL(Uniroyal Elec) | 0402WGF4701TCE | [C25900](https://www.lcsc.com/product-detail/C25900.html) |  |
| 50 | R1107, R1108, R1207, R1208, R1209, R1210, R1211, R1407, R1408, R1409, R1410, R1411, R403, R505, R506, R507, R508, R509, R510, R511, R512, R513, R514, R515, R516, R517, R518, R519, R520, R521, R522, R523, R524, R525, R526, R527, R528, R529, R530, R531, R532, R533, R534, R535, R536, R707, R708, R709, R710, R711 | 100 | 0402 | UNI-ROYAL(Uniroyal Elec) | 0402WGF1000TCE | [C25076](https://www.lcsc.com/product-detail/C25076.html) |  |
| 3 | R1201, R1401, R701 | 1k | 0402 | YAGEO | RC0402FR-071KL | [C106235](https://www.lcsc.com/product-detail/C106235.html) |  |
| 3 | R1203, R1403, R703 | 820 | 0402 | FOJAN | FRC0402F8200TS | [C2909387](https://www.lcsc.com/product-detail/C2909387.html) |  |
| 3 | R1204, R1404, R704 | 220 | 0603 | UNI-ROYAL(Uniroyal Elec) | 0603WAF2200T5E | [C22962](https://www.lcsc.com/product-detail/C22962.html) |  |
| 4 | R1205, R1405, R402, R705 | 470 | 0603 | UNI-ROYAL(Uniroyal Elec) | 0603WAF4700T5E | [C23179](https://www.lcsc.com/product-detail/C23179.html) |  |
| 7 | R1206, R1406, R201, R301, R302, R401, R706 | 680 | 0402 | YAGEO | RC0402FR-07680RL | [C137948](https://www.lcsc.com/product-detail/C137948.html) |  |
| 4 | R501, R502, R503, R504 | 10k | 0402 | PANASONIC | ERJ2GEJ103X | [C278577](https://www.lcsc.com/product-detail/C278577.html) |  |
| 2 | R901, R902 | 5.1k | 0402 | Panasonic Electronic Components | ERJ2GEJ512X | [C413002](https://www.lcsc.com/product-detail/C413002.html) |  |
| 1 | U1001 | TPS73733QDRBRQ1 | VSON-8-EP(3x3) | Texas Instruments | TPS73733QDRBRQ1 | [C523768](https://www.lcsc.com/product-detail/C523768.html) | [datasheet](https://www.ti.com/lit/ds/symlink/tps737-q1.pdf) |
| 4 | U1101, U1201, U1401, U701 | SN74LVC2G17DRYR | SON-6(1x1.5) | Texas Instruments | SN74LVC2G17DRYR | [C2675856](https://www.lcsc.com/product-detail/C2675856.html) | [datasheet](https://www.ti.com/lit/ds/symlink/sn74lvc2g17.pdf) |
| 4 | U1202, U1402, U401, U702 | SN74LVC1G125DRYR | USON-6(1x1.5) | Texas Instruments | SN74LVC1G125DRYR | [C527546](https://www.lcsc.com/product-detail/C527546.html) | [datasheet](https://www.ti.com/lit/ds/symlink/sn74lvc1g125.pdf) |
| 3 | U1203, U1403, U703 | SN74LVC1G07DRYR | UFDFN-6(1x1.5) | Texas Instruments | SN74LVC1G07DRYR | [C2675513](https://www.lcsc.com/product-detail/C2675513.html) | [datasheet](https://www.ti.com/lit/ds/symlink/sn74lvc1g07.pdf) |
| 10 | U1204, U1205, U1404, U1405, U301, U402, U403, U704, U705, U901 | USBLC6-2P6 | SOT-666-6 | STMicroelectronics | USBLC6-2P6 | [C2827693](https://www.lcsc.com/product-detail/C2827693.html) | [datasheet](https://www.st.com/resource/en/datasheet/usblc6-2.pdf) |
| 4 | U501, U502, U503, U504 | SN74LV541ARKSR | VQFN-20(2.5x4.5) | Texas Instruments | SN74LV541ARKSR | [C7364695](https://www.lcsc.com/product-detail/C7364695.html) | [datasheet](https://www.ti.com/lit/ds/symlink/sn74lv541a.pdf) |
