peterpolidoro/camera-gpio-interface-pcb/docs/generated/3d/camera-gpio-interface-pcb-assembled.step

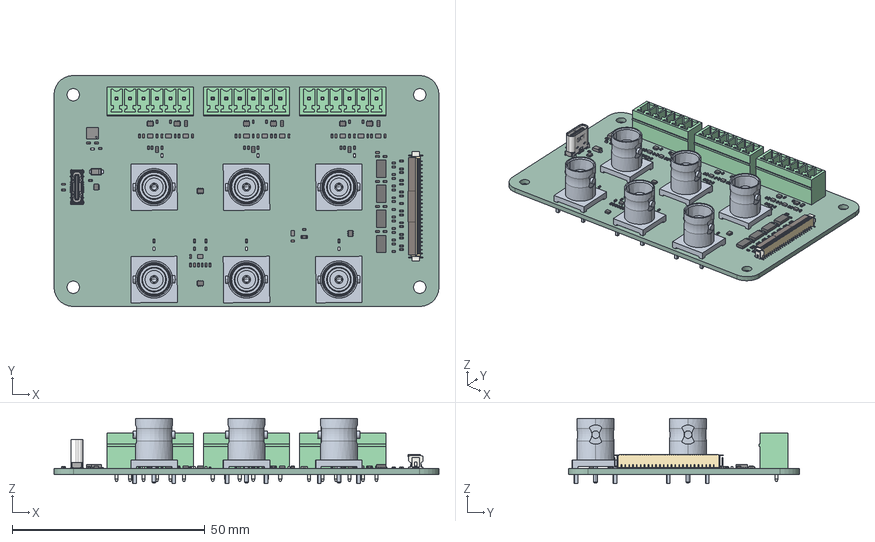
[picture p41: CAD file, 2026-10-15]
docs/generated/3d/camera-gpio-interface-pcb-assembled.step
100.0 x 60.0 x 17.0 mm
BODY-SON x 11
FRAME-DRY0006B x 11
PIN1-ID x 11
R_0402_1005Metric x 78
SOT_666 x 10
C_0402_1005Metric x 21
112406_SW0001 x 6
R_0603_1608Metric x 7
BODY-QFN x 4
APHHS1005 x 7
MCV_01x06_G_3_5mm x 3
NTS260SFT1G
DRB8B
Housing
Actuator
Leads
Fittings
camera-gpio-interface-pcb_PCB
