peterpolidoro/camera-gpio-interface-pcb/docs/generated/mechanical/board-dimensions.pdf

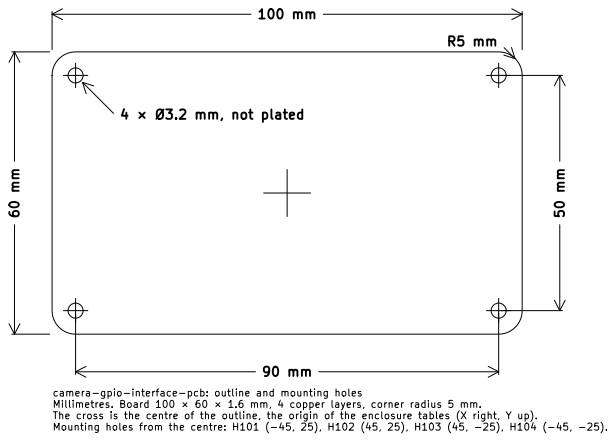
[picture p42: page 1]

camera-gpio-interface-pcb: outline and mounting holes
Millimetres. Board 100 × 60 × 1.6 mm, 4 copper layers, corner radius 5 mm. The cross is the centre of the outline, the origin of the enclosure tables (X right, Y up).

Mounting holes from the centre: H101 (-45, 25), H102 (45, 25), H103 (45, -25), H104 (-45, -25).
