peterpolidoro/camera-gpio-interface-pcb/docs/generated/schematic/camera-gpio-interface-pcb-schematic.pdf

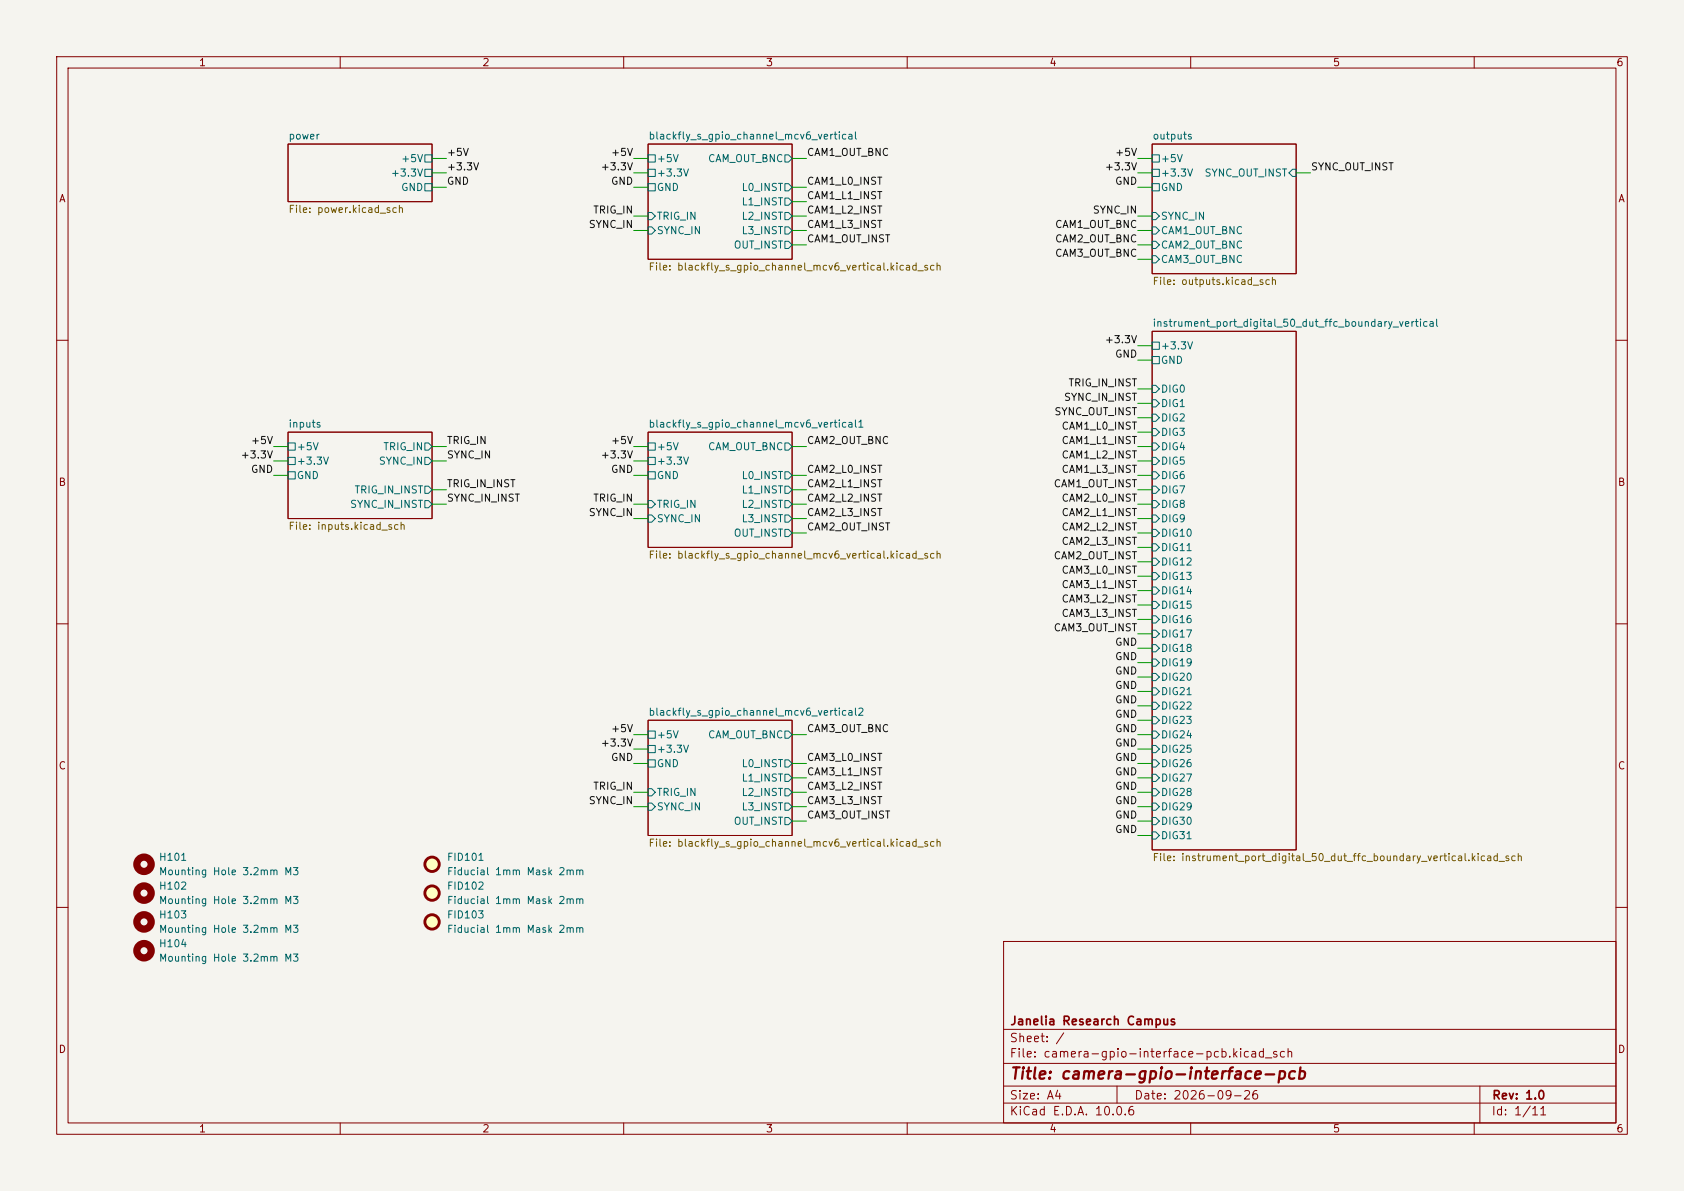
[picture p43: page 1]

SYNC_OUT_INST +5V outputs File: outputs.kicad_sch +3.3V GND
power File: power.kicad_sch

GND +3.3V CAM2_L3_INST CAM1_L3_INST CAM2_L2_INST CAM2_L1_INST SYNC_IN_INST GND +5V GND +5V +3.3V GND

H102 Mounting Hole 3.2mm M3 H104 Mounting Hole 3.2mm M3

Janelia Research Campus
Sheet: /
File: camera-gpio-interface-pcb.kicad_sch
Title: camera-gpio-interface-pcb

Size: A4 | Rev: 1.0
KiCad E.D.A. 10.0.6 | Id: 1/11

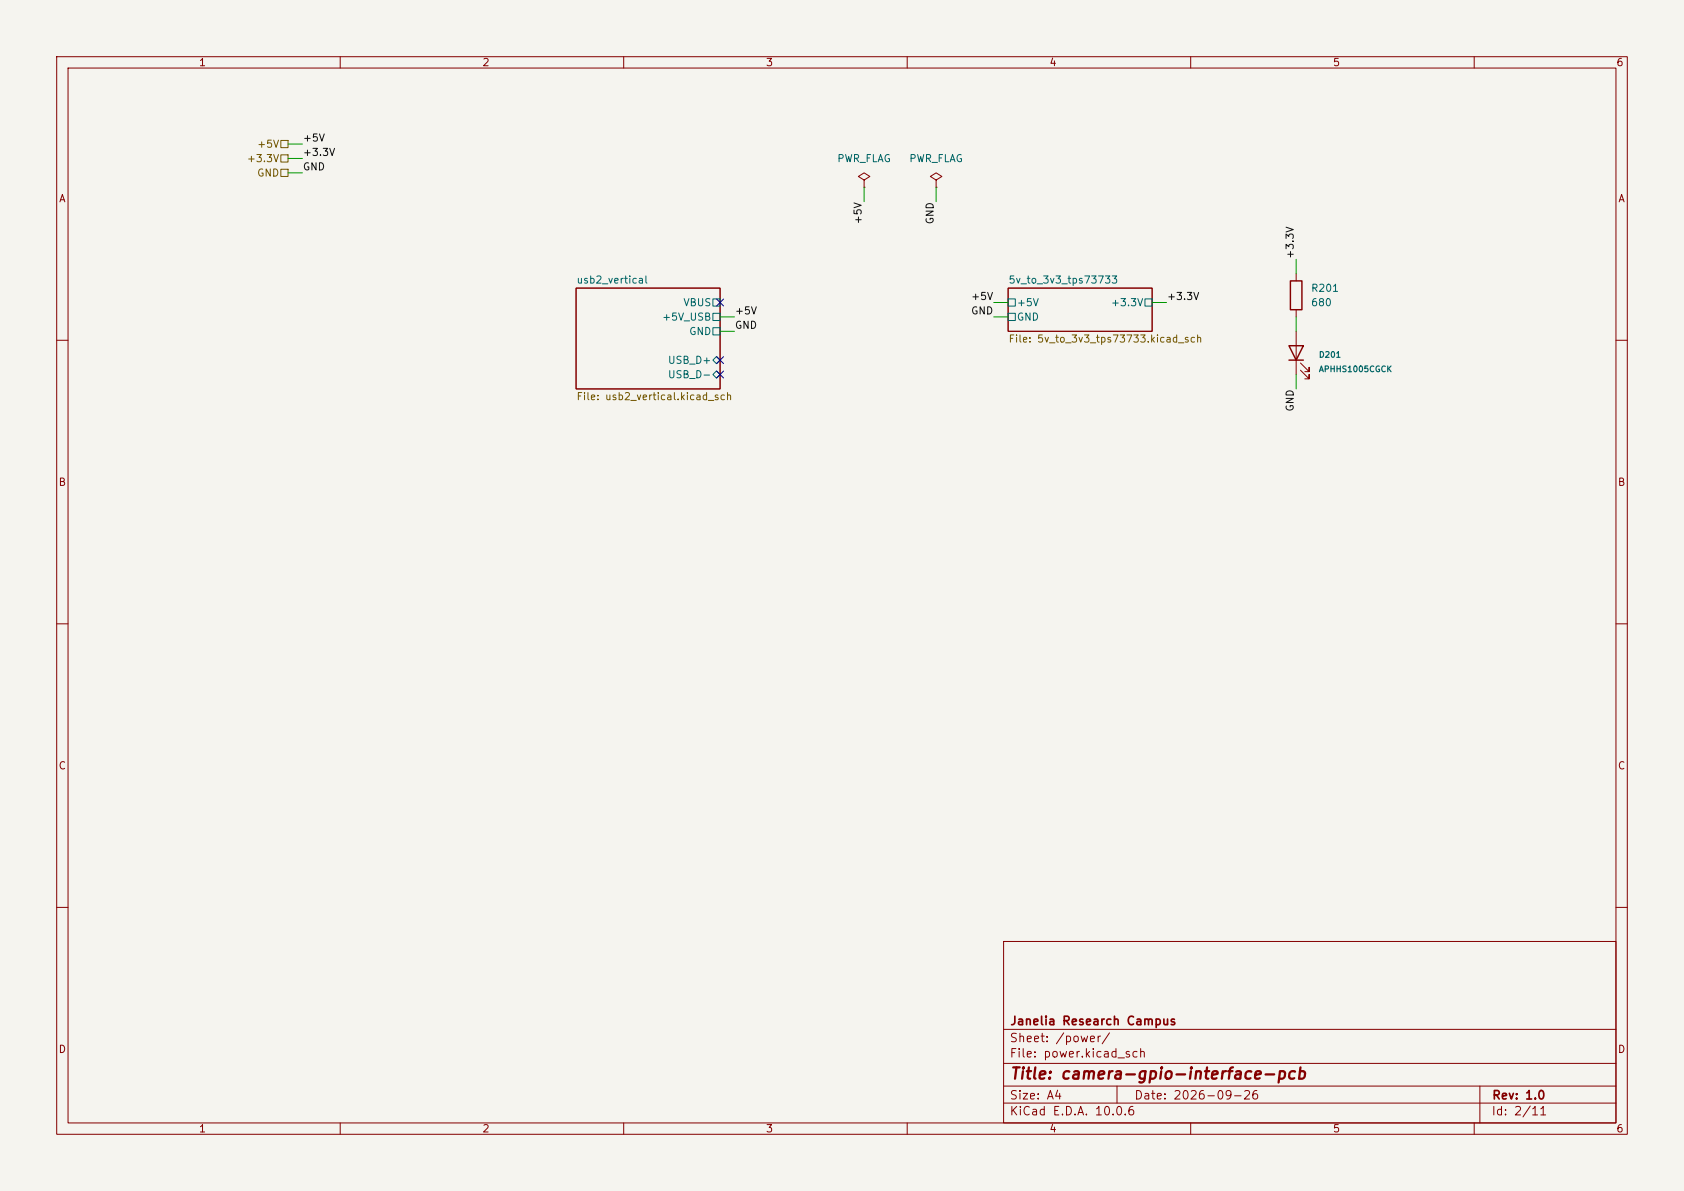
[picture p44: page 2]

Janelia Research Campus
Sheet: /power/
File: power.kicad_sch
Title: camera-gpio-interface-pcb

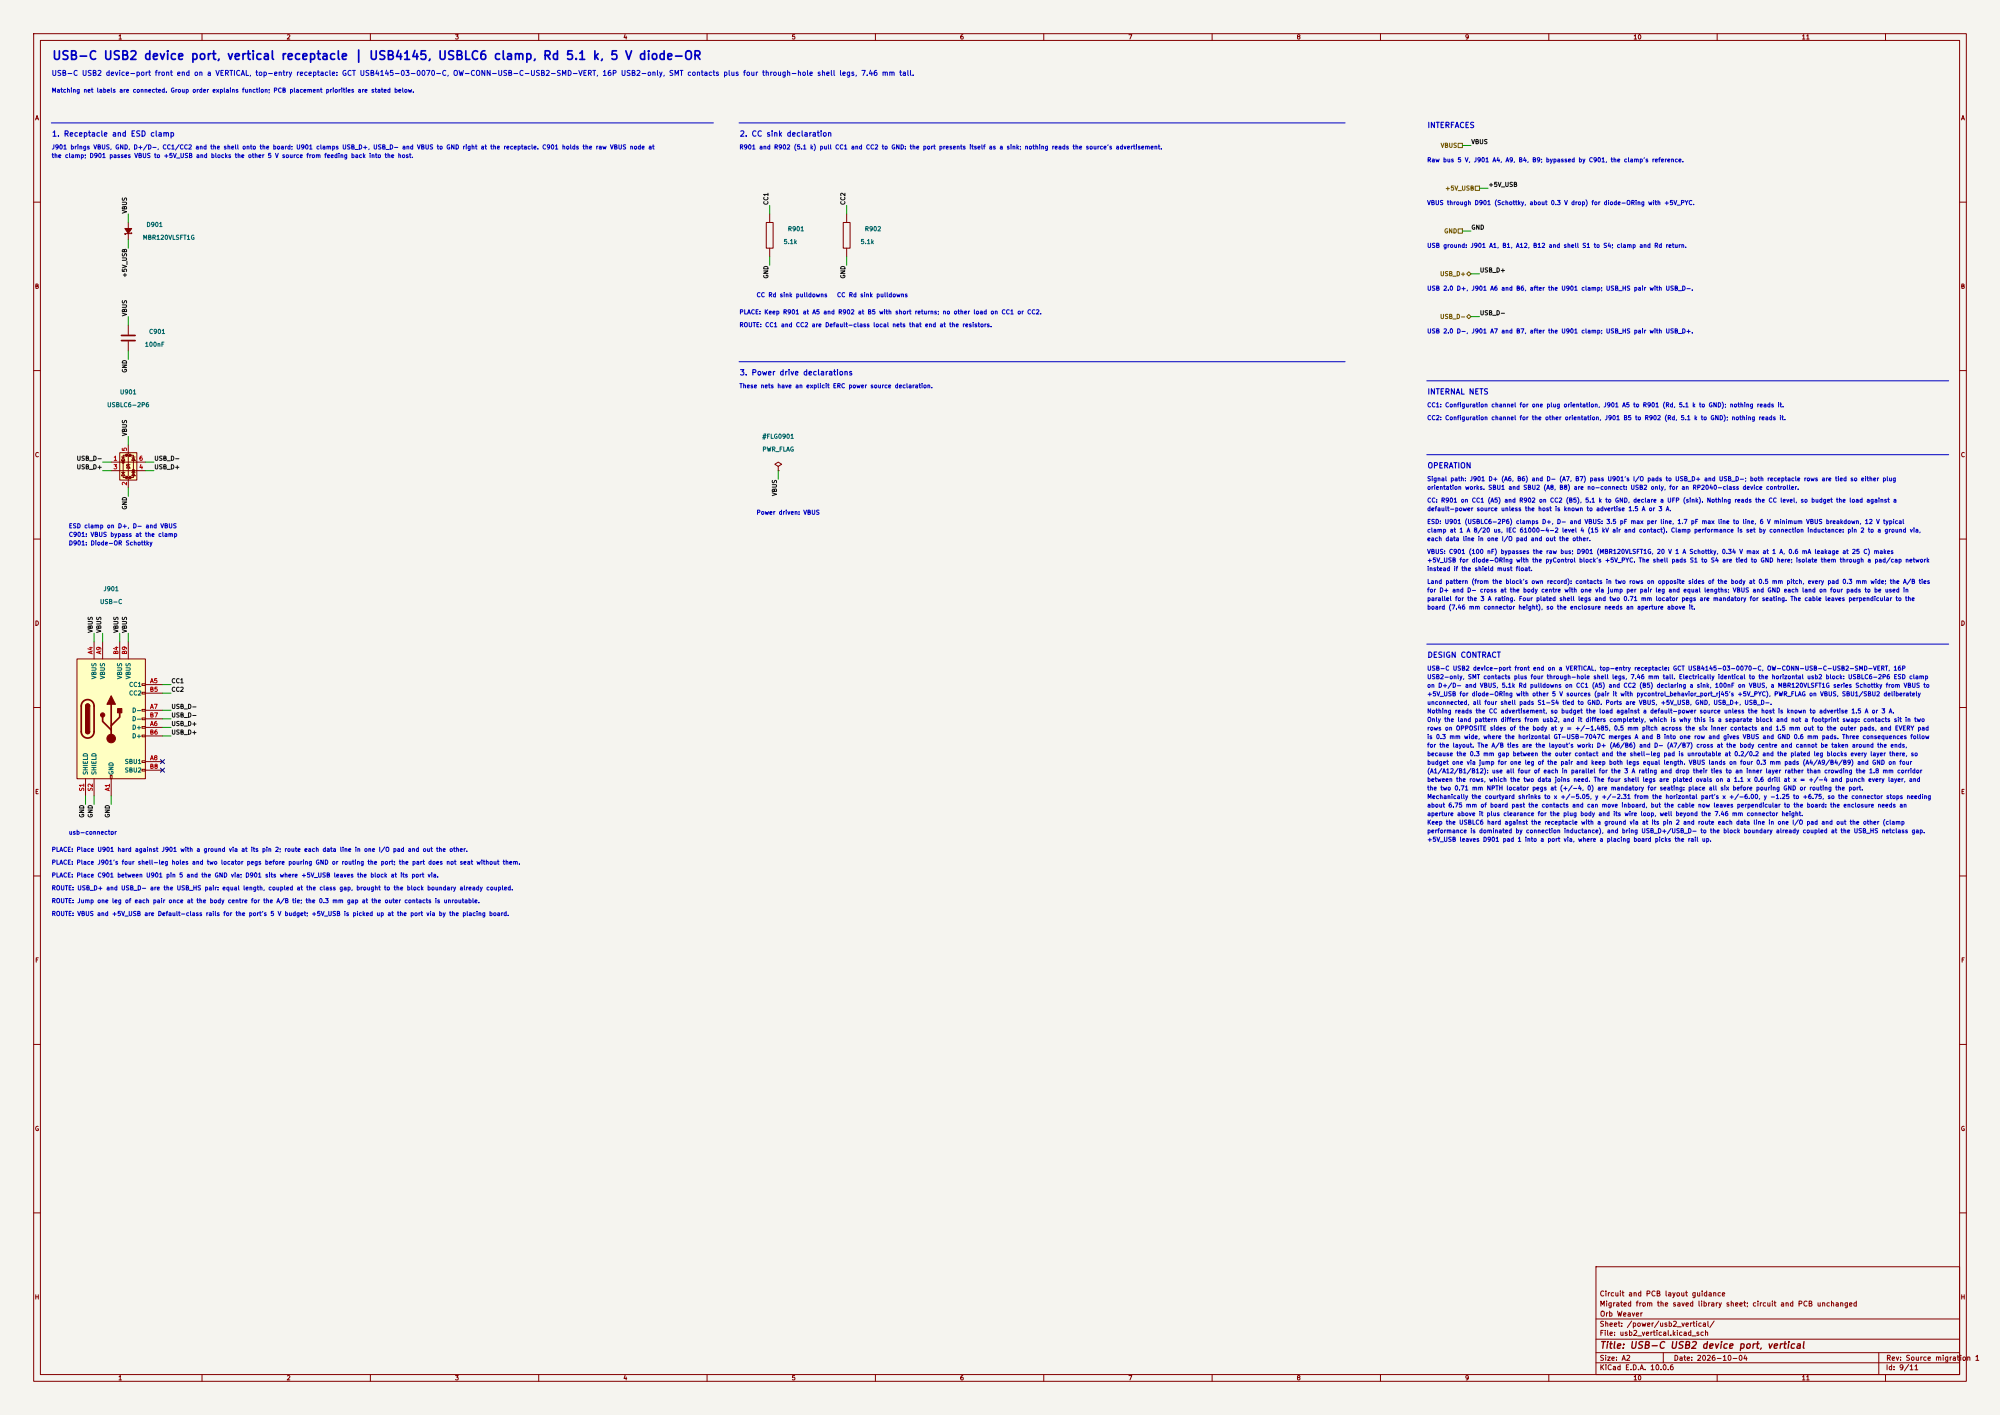
[picture p45: page 3]

USB-C USB2 device port, vertical receptacle | USB4145, USBLC6 clamp, Rd 5.1 k, 5 V diode-OR

USB-C USB2 device-port front end on a VERTICAL, top-entry receptacle: GCT USB4145-03-0070-C, OW-CONN-USB-C-USB2-SMD-VERT, 16P USB2-only, SMT contacts plus four through-hole shell legs, 7.46 mm tall.
USB_D+ VBUS
USB_D- VBUS VBUS USB_D-

Matching net labels are connected. Group order explains function; PCB placement priorities are stated below. 1. Receptacle and ESD clamp

J901 brings VBUS, GND, D+/D-, CC1/CC2 and the shell onto the board; U901 clamps USB_D+, USB_D- and VBUS to GND right at the receptacle. C901 holds the raw VBUS node at

CC2: Configuration channel for the other orientation, J901 B5 to R902 (Rd, 5.1 k to GND); nothing reads it. CC1: Configuration channel for one plug orientation, J901 A5 to R901 (Rd, 5.1 k to GND); nothing reads it. USB 2.0 D-, J901 A7 and B7, after the U901 clamp; USB_HS pair with USB_D+. USB 2.0 D+, J901 A6 and B6, after the U901 clamp; USB_HS pair with USB_D-. Raw bus 5 V, J901 A4, A9, B4, B9; bypassed by C901, the clamp's reference. USB ground: J901 A1, B1, A12, B12 and shell S1 to S4; clamp and Rd return. VBUS through D901 (Schottky, about 0.3 V drop) for diode-ORing with +5V_PYC. OPERATION

These nets have an explicit ERC power source declaration.

Signal path: J901 D+ (A6, B6) and D- (A7, B7) pass U901's I/O pads to USB_D+ and USB_D-; both receptacle rows are tied so either plug ROUTE: VBUS and +5V_USB are Default-class rails for the port's 5 V budget; +5V_USB is picked up at the port via by the placing board. ROUTE: USB_D+ and USB_D- are the USB_HS pair: equal length, coupled at the class gap, brought to the block boundary already coupled. PLACE: Place C901 between U901 pin 5 and the GND via; D901 sits where +5V_USB leaves the block at its port via. PLACE: Place J901's four shell-leg holes and two locator pegs before pouring GND or routing the port; the part does not seat without them. PLACE: Place U901 hard against J901 with a ground via at its pin 2; route each data line in one I/O pad and out the other. ROUTE: Jump one leg of each pair once at the body centre for the A/B tie; the 0.3 mm gap at the outer contacts is unroutable. usb-connector

ESD: U901 (USBLC6-2P6) clamps D+, D- and VBUS: 3.5 pF max per line, 1.7 pF max line to line, 6 V minimum VBUS breakdown, 12 V typical VBUS: C901 (100 nF) bypasses the raw bus; D901 (MBR120VLSFT1G, 20 V 1 A Schottky, 0.34 V max at 1 A, 0.6 mA leakage at 25 C) makes orientation works. SBU1 and SBU2 (A8, B8) are no-connect: USB2 only, for an RP2040-class device controller. clamp at 1 A 8/20 us, IEC 61000-4-2 level 4 (15 kV air and contact). Clamp performance is set by connection inductance: pin 2 to a ground via, each data line in one I/O pad and out the other. +5V_USB for diode-ORing with the pyControl block's +5V_PYC. The shell pads S1 to S4 are tied to GND here; isolate them through a pad/cap network

instead if the shield must float. CC: R901 on CC1 (A5) and R902 on CC2 (B5), 5.1 k to GND, declare a UFP (sink). Nothing reads the CC level, so budget the load against a

default-power source unless the host is known to advertise 1.5 A or 3 A.

ESD clamp on D+, D- and VBUS
C901: VBUS bypass at the clamp

Land pattern (from the block's own record): contacts in two rows on opposite sides of the body at 0.5 mm pitch, every pad 0.3 mm wide; the A/B ties

for D+ and D- cross at the body centre with one via jump per pair leg and equal lengths; VBUS and GND each land on four pads to be used in
parallel for the 3 A rating. Four plated shell legs and two 0.71 mm locator pegs are mandatory for seating. The cable leaves perpendicular to the +5V_USB leaves D901 pad 1 into a port via, where a placing board picks the rail up.
board (7.46 mm connector height), so the enclosure needs an aperture above it.

Only the land pattern differs from usb2, and it differs completely, which is why this is a separate block and not a footprint swap: contacts sit in two Nothing reads the CC advertisement, so budget the load against a default-power source unless the host is known to advertise 1.5 A or 3 A. unconnected, all four shell pads S1-S4 tied to GND. Ports are VBUS, +5V_USB, GND, USB_D+, USB_D-. +5V_USB for diode-ORing with other 5 V sources (pair it with pycontrol_behavior_port_rj45's +5V_PYC), PWR_FLAG on VBUS, SBU1/SBU2 deliberately USB-C USB2 device-port front end on a VERTICAL, top-entry receptacle: GCT USB4145-03-0070-C, OW-CONN-USB-C-USB2-SMD-VERT, 16P DESIGN CONTRACT

on D+/D- and VBUS, 5.1k Rd pulldowns on CC1 (A5) and CC2 (B5) declaring a sink, 100nF on VBUS, a MBR120VLSFT1G series Schottky from VBUS to USB2-only, SMT contacts plus four through-hole shell legs, 7.46 mm tall. Electrically identical to the horizontal usb2 block: USBLC6-2P6 ESD clamp

rows on OPPOSITE sides of the body at y = +/-1.485, 0.5 mm pitch across the six inner contacts and 1.5 mm out to the outer pads, and EVERY pad
is 0.3 mm wide, where the horizontal GT-USB-7047C merges A and B into one row and gives VBUS and GND 0.6 mm pads. Three consequences follow
for the layout. The A/B ties are the layout's work: D+ (A6/B6) and D- (A7/B7) cross at the body centre and cannot be taken around the ends,
budget one via jump for one leg of the pair and keep both legs equal length. VBUS lands on four 0.3 mm pads (A4/A9/B4/B9) and GND on four because the 0.3 mm gap between the outer contact and the shell-leg pad is unroutable at 0.2/0.2 and the plated leg blocks every layer there, so

(A1/A12/B1/B12): use all four of each in parallel for the 3 A rating and drop their ties to an inner layer rather than crowding the 1.8 mm corridor Keep the USBLC6 hard against the receptacle with a ground via at its pin 2 and route each data line in one I/O pad and out the other (clamp
performance is dominated by connection inductance), and bring USB_D+/USB_D- to the block boundary already coupled at the USB_HS netclass gap. between the rows, which the two data joins need. The four shell legs are plated ovals on a 1.1 x 0.6 drill at x = +/-4 and punch every layer, and
the two 0.71 mm NPTH locator pegs at (+/-4, 0) are mandatory for seating: place all six before pouring GND or routing the port.
Mechanically the courtyard shrinks to x +/-5.05, y +/-2.31 from the horizontal part's x +/-6.00, y -1.25 to +6.75, so the connector stops needing
aperture above it plus clearance for the plug body and its wire loop, well beyond the 7.46 mm connector height. about 6.75 mm of board past the contacts and can move inboard, but the cable now leaves perpendicular to the board: the enclosure needs an

Migrated from the saved library sheet; circuit and PCB unchanged
Orb Weaver
Sheet: /power/usb2_vertical/
File: usb2_vertical.kicad_sch
Title: USB-C USB2 device port, vertical

AB

C

D

AB

C

# D Date: 2026-10-04

Size: A4 | Rev: Source migration 1

# Title: 5 V to 3.3 V regulator

# File: 5v_to_3v3_tps73733.kicad_sch

# Sheet: /power/5v_to_3v3_tps73733/

## Orb Weaver

# Migrated from the saved library sheet; circuit and PCB unchanged

# Circuit and PCB layout guidance

C1002

## 1uF C1001

1uF | OUT | 1 NR | 3 GND

4

EN 5

IN 8 | PAD

9 U1001

TPS73733QDRBRQ1 | +5V GND +3.3V +5V | +3.3V +3.3V | GND | +5V GND +5V | GND | +3.3V GNDGND +5V

NR (pin 3) is left open: no noise-reduction capacitor is fitted. GND (pin 4) and C1001 (1 uF) bypasses the input, C1002 (1 uF) is the output capacitor; both are the catalog 0402 1 uF part. The rail is rated by the TPS73733 (fixed 3.3 V, 1 Regulated output, 3.3 V fixed. control inside this block. the thermal pad (pin 9) return to GND. dropout.

Input rail; also drives EN, so the regulator is on whenever it is present. A class per the catalog description); derate for the board's actual load and

Input bypass

DESIGN CONTRACT Clean 3.3 V linear regulator from a 5 V input rail using the TI TPS73733 fixed 3.3

## V 1 A LDO. Intended for MCU, RP2040, TMC logic, encoder interface, and other

low-voltage digital circuitry. tied to IN, so the regulator is on whenever +5V is present; there is no enable Signal path: +5V -> U1001 (IN, pin 8) -> +3.3V (OUT, pin 1). EN (pin 5) is Common return; regulator ground pin and thermal pad.

# OPERATION

# INTERFACES

PLACE: Place C1001 at pins 8 and 4 and C1002 at pins 1 and 4 with short local ground returns; tie the thermal pad to GND copper. U1001 regulates +5V to +3.3V with EN tied to IN. C1001 bypasses IN to GND, C1002 holds OUT to GND; NR is open. Fixed 3.3 V LDO 5 V to 3.3 V regulator | TPS73733 fixed 3.3 V LDO

Clean 3.3 V linear regulator from a 5 V input rail using the TI TPS73733 fixed 3.3 V 1 A LDO.

Matching net labels are connected. Group order explains function; PCB placement priorities are stated below. 1. Regulator and bypass

ROUTE: +5V and +3.3V carry the rail classes (PWR_5V_LOCAL, PWR_3V3_LOCAL); the GND return of the pad is the regulator's heat path as well. Output capacitor

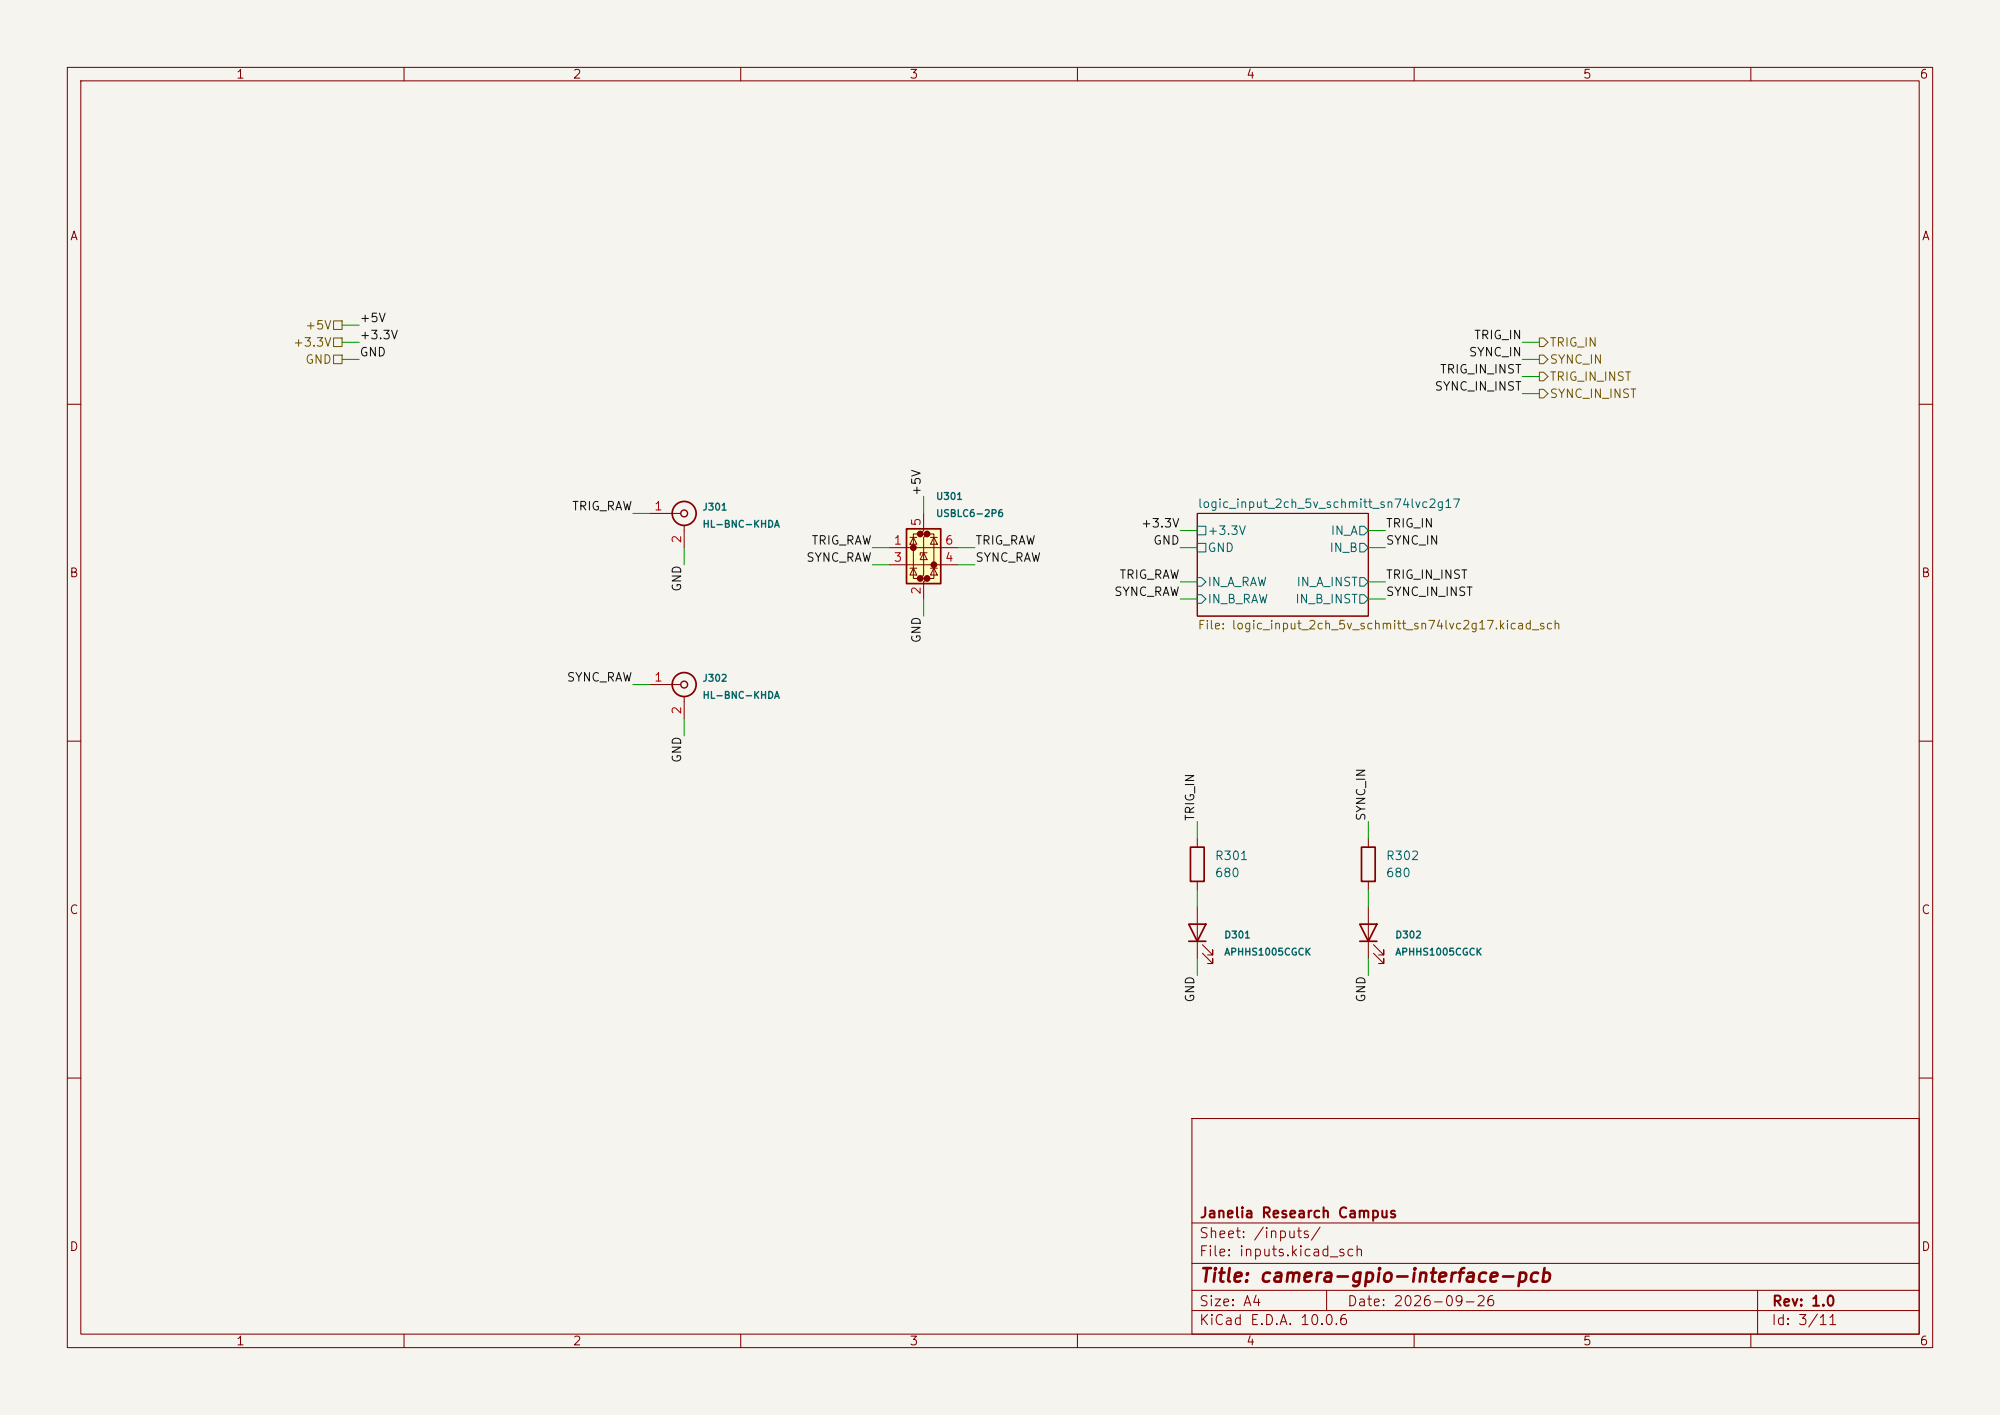
[picture p46: page 5]

TRIG_IN
Janelia Research Campus +3.3V GND

Sheet: /inputs/
File: inputs.kicad_sch
Title: camera-gpio-interface-pcb

AB

C

D

E

### FGH

AB

C

D

E

# FGH Date: 2026-10-04

# Title: Two-channel Schmitt logic input

# File: logic_input_2ch_5v_schmitt_sn74lvc2g17.kicad_sch

# Sheet: /inputs/logic_input_2ch_5v_schmitt_sn74lvc2g17/

# Migrated from the saved library sheet; circuit and PCB unchanged

# Circuit and PCB layout guidance

1A 1

## 1Y 6 U1101A SN74LVC2G17DRYR

R1105

100k C1103

100nF

C1101

## 470pF R1103

4.7k | R1106

100k R1108

100 R1107

100 | C1102

# 470pFGND

# 2 VCC

5 U1101C

## SN74LVC2G17DRYR

R1101

100k | 2A 3

## 2Y 4 U1101B

## SN74LVC2G17DRYR

R1104

4.7k R1102

100k

## IN_B_INST

## IN_A

## IN_B

# IN_A_INST GND +3.3V

## IN_A_RAW

## IN_B_RAW

## IN_B_FILT

## IN_B GND

IN_A | IN_A_INST IN_B_RAW | IN_A GND
IN_B_FILT | IN_B_FILT
IN_B_RAW | GND IN_A_FILT

## IN_A_FILT

IN_B_INST | GND

## IN_A

## IN_B

## IN_B_RAW

## IN_A_RAW

## IN_B

## GND +3.3V GND

## IN_A_INST

## IN_B_INST

## IN_A

IN_A_RAW | +3.3V GND
IN_A_FILT | +3.3V GND | IN_B GND IN_A_RAW

First consumer: camera-gpio-interface-pcb, TRIG IN and SYNC IN BNCs from a pyControl breakout on IN_A_RAW/IN_B_RAW, TRIG_IN/SYNC_IN out, taps

Tolerance: inputs are rated 0 to 5.5 V at any valid VCC, 6.5 V absolute maximum, with no clamp diode to VCC, so a 5 V source plugged in by mistake is legal; a source held below ground draws about 0.2 mA per volt through the 4.7 kohm (a -5 V DAC output about 1 mA), and a short to a 36 V rail Filter: 4.7 kohm and 470 pF give a 72 kHz corner and about 2 us from a 3.3 V edge to the Schmitt threshold, the same on both channels so their Rails are generic labels: bind +3.3V to the always-on rail when the taps must be observable before firmware runs, or to the switched domain when

ground reference. the consumer of IN_A/IN_B can be powered down and must rise and fall with it; sequencing between source and buffer is a non-issue because Ioff on DIG0/DIG1 of the digital-50 InstrumentPort. Series resistors and filter capacitors on the input edge, the 2G17 and its decoupling in the middle, output pull-downs and taps on the output edge, so harness-side nets stay on one edge and logic and tap nets leave on the other. Keep the input pair away from motor bridge outputs and give it a

PLACE: Series resistors and filter capacitors on the input edge of the block, C1101 with

V, so a 3.3 V microcontroller pin clears the high threshold by 0.9 V or more and a 5 V TTL-level VOH of 2.4 V by 0.4 V. field edge violates and double-triggers; the 2G17 has no such limit and 0.4 V minimum hysteresis at 3 V. Thresholds VT+ <= 2.0 V and VT- >= 0.8

The Schmitt input is the point of the block: an ordinary LVC buffer specifies a maximum input transition rate of about 8 ns/V, which a slow or noisy V or 5 V field-wired logic signal into clean 3.3 V logic, with a 100 ohm InstrumentPort tap on each output. Generic sibling of relative timing is preserved; 470 pF suits sub-10 kHz timing edges on long unshielded leads, swap C1101/C1102 for a faster corner when the

the _INST ports, INSTRUMENT netclass from the instrument-taps profile; C1103 100 nF (OW-CAP-100N-0402-X5R-16V, C162178) hard against downstream buffer never sees a floating input when this rail is down; R1107/R1108 100 ohm T-taps (OW-PASS-0402WGF1000TCE, C25076) to reads low without forming a divider that eats VIH margin; R1105/R1106 100 kohm pull-down on each output for Ioff high-Z, so an always-on

R1101/R1102 100 kohm pull-down (OW-PASS-RC0402JR-07100KL, C106234) on the harness side of the series resistor, so an unplugged input Per channel: R1103/R1104 4.7 kohm series (OW-RES-4K7-0402, C25900) into C1101/C1102 470 pF C0G to ground tapped through R1107 (100 ohm) to IN_A_INST; channel B is R1104, C1102, 2A (pin 3), 2Y (pin 4), IN_B and R1108 to IN_B_INST. Signal path, per channel: IN_A_RAW -> R1103 (4.7 k) -> IN_A_FILT (C1101 470 pF to GND) -> U1101A 1A (pin 1) -> 1Y (pin 6) -> IN_A,

IN_A_RAW and IN_B_RAW, take conditioned 3.3 V logic out on IN_A and IN_B and the taps out on IN_A_INST and IN_B_INST; rails +3.3V and GND. Power unit mm vias.

ROUTE: IN_B_FILT stays inside the block. PLACE: Mirror channel A on the input edge so both channels see the same copper and the

Input series filter resistor, 4.7 k | 3. Output pull-downs and instrument taps

## ROUTE: +3.3V carries PWR_3V3_LOCAL; the block's baseline is 0.2 mm tracks and 0.6/0.3

The same network for channel B into 2A; R1102 holds IN_B_RAW low when unplugged.

# 2. Channel B input filter

Two-channel single-ended logic input conditioner: per-channel series/RC filtering plus an SN74LVC2G17 dual Schmitt-trigger buffer that turns a 3.3 V or 5 V field-wired logic signal into clean 3.3 V logic, with a 100 ohm InstrumentPort tap on each output.

Two-channel Schmitt logic input | 4.7 k / 470 pF filters, SN74LVC2G17, pull-downs and taps

vias. hard against pin 5 with a short return to pin 2; +3.3V and GND reach the block through

Project-local pending bench verification; promotable once a second board uses it.

Input series filter resistor, 4.7 k | Instrument tap series resistor same delay.

pull-down, 100 k

Input idle-low

a short return to GND at the buffer's pin 2 side; keep the raw pair away from motor bridge

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

1A; R1101 holds IN_A_RAW low when nothing is plugged in. R1103 in series with the raw input into C1101 to GND forms the 72 kHz low-pass at 1. Channel A input filter

Matching net labels are connected. Group order explains function; PCB placement priorities are stated below. | PLACE: Output pull-downs and taps on the output edge, so logic and tap nets leave on the pull-down, 100 k outputs with a ground reference beside it.

Instrument tap series resistor ROUTE: IN_A_RAW and IN_B_RAW enter as tracks (harness side); IN_A_FILT stays inside the

is bounded to about 7 mA and destroys a 0.19 USD buffer instead of the consumer.

block. | R1106: Output pull-down, unpowered state | U1101C pin 5. PLACE: U1101A in the middle of the block between the input and output edges, C1103

U1101A gates A (1A to 1Y) and B (2A to 2Y) square the filtered inputs into 3.3 V logic; R1105: Output pull-down, unpowered state C1101: Input low-pass capacitor, 72 kHz with 4.7 k C1103 (100 nF) bypasses VCC (pin 5) to GND (pin 2).

signal needs it (27 pF gives 1.25 MHz).

side opposite the harness. | Unit 1: Schmitt-trigger buffer ROUTE: IN_A, IN_B, IN_A_INST and IN_B_INST leave through vias (port copper); the taps carry
the INSTRUMENT class, the two tap stubs are 0.15 mm. | Unit 2: Schmitt-trigger buffer C1102: Input low-pass capacitor, 72 kHz with 4.7 k | DESIGN CONTRACT

# INTERFACES

U1101A C1103: VCC bypass for | V is bounded to about 7 mA into the buffer.

# 4. Schmitt buffer and supply bypass

disables the outputs when the part is unpowered. sync inputs, sensor and switch logic lines and any other pair of inputs a board conditions; use the encoder block when the harness also carries the quadrature_encoder_input_5v_sn74lvc2g17: same circuit and values, generic names, no encoder-supply passthrough. Use this one for BNC trigger and OPERATION

which is why the sequencing between source and buffer does not matter. C1103 (100 nF) bypasses pin 5. Supply: VCC 1.65 to 5.5 V, 10 uA max, +/-24 mA drive at 3 V; Ioff (10 uA max) keeps the outputs off a live downstream input when the rail is down, absolute), so a 5 V source is legal; a source below ground draws about 0.2 mA per volt through the 4.7 k (about 1 mA from -5 V), and a short to 36

The Schmitt input is the point: at VCC = 3 V, VT+ is 1.3 to 2.0 V and VT- 0.8 to 1.3 V with at least 0.4 V of hysteresis, so slow or noisy field edges

(OW-CAP-470P-0402-C0G-100V, C1518202) and U1101A SN74LVC2G17DRYR gate A/B (OW-MISC-SN74LVC2G17DRYR, C2675856); us later, the same on both channels, so relative timing is kept. For faster edges swap C1101/C1102 (27 pF gives about 1.25 MHz).

R1105/R1106 (100 k) define the outputs when +3.3V is off. R1101/R1102 (100 k) pull the raw inputs low when unplugged, on the harness side of the series resistor so no divider eats VIH margin; cannot double-trigger; a 3.3 V source clears VT+ by at least 1.3 V, a 5 V TTL VOH of 2.4 V by 0.4 V. Inputs are rated 0 to 5.5 V at any VCC (6.5 V

Filter: 4.7 k and 470 pF give a time constant of about 2.2 us and a corner near 72 kHz; a 3.3 V edge reaches the worst-case VT+ of 2.0 V about 2

encoder supply; place this block twice for four inputs. Connector-agnostic: the jack or terminal lives on the board sheet. Bring the raw lines in on

Instrument tap of IN_B through R1108 (100 ohm), INSTRUMENT class.

Instrument tap of IN_A through R1107 (100 ohm), INSTRUMENT class. Conditioned channel B, 3.3 V logic from 2Y (pin 4); pulled down by R1106 when the rail is off. Conditioned channel A, 3.3 V logic from 1Y (pin 6); pulled down by R1105 when the rail is off. Field-wired channel B input, 0 to 5.5 V legal at any VCC; pulled low by R1102 (100 k) when unplugged. Field-wired channel A input, 0 to 5.5 V legal at any VCC; pulled low by R1101 (100 k) when unplugged. Return for the buffer (pin 2), both filter capacitors and the four pull-downs.

IN_A/IN_B powers down with it (Ioff keeps the unpowered outputs off the bus). Buffer supply (VCC, pin 5), 1.65 to 5.5 V; always-on when the taps must be observable before firmware runs, switched when the consumer of R1105/R1106 (100 k) define IN_A/IN_B while the buffer is unpowered;
R1107/R1108 (100 ohm) are the series taps to IN_A_INST and IN_B_INST.

Input idle-low

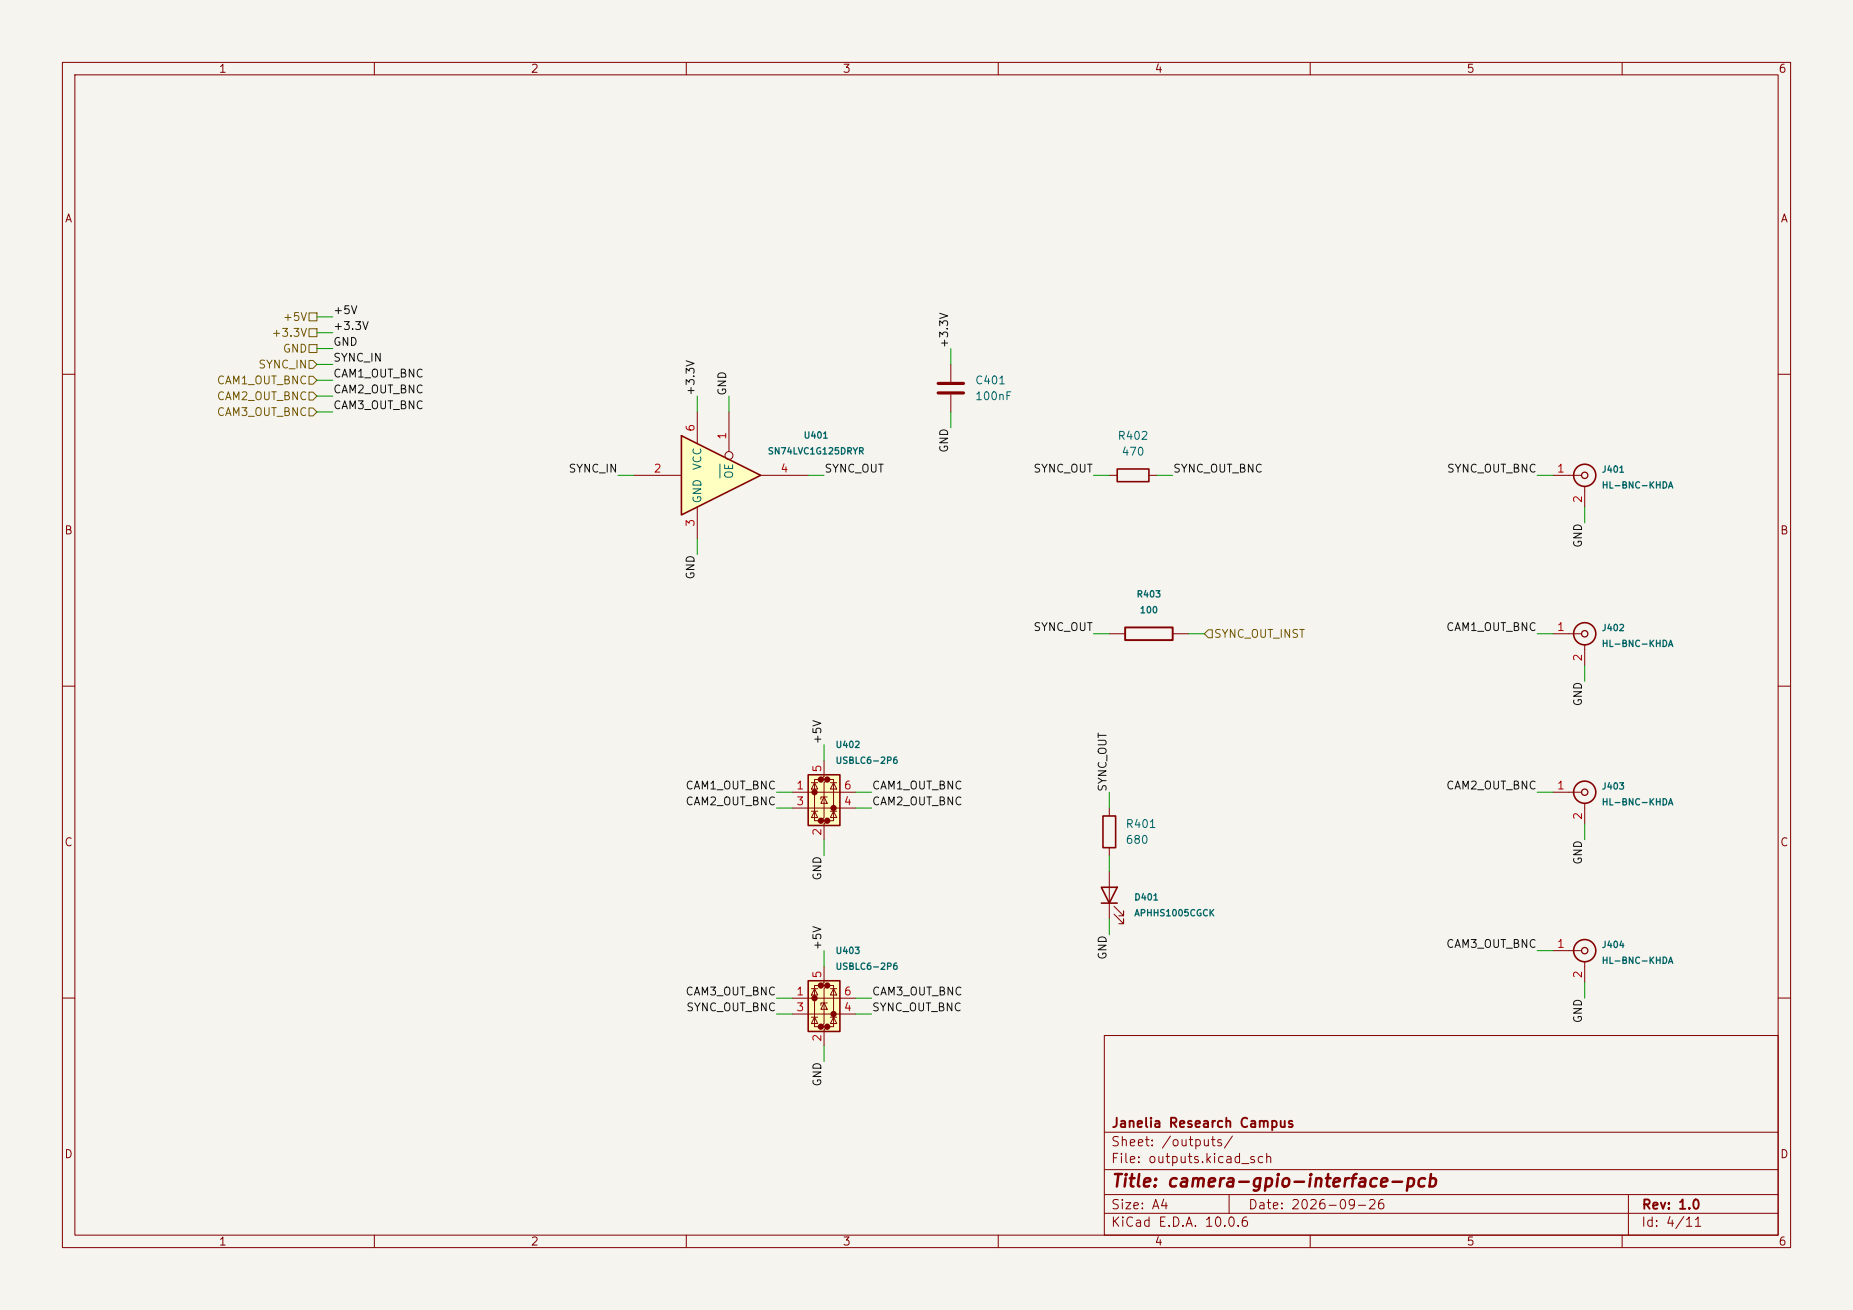
[picture p47: page 7]

Janelia Research Campus
Sheet: /outputs/
File: outputs.kicad_sch
Title: camera-gpio-interface-pcb

1 | 2 | 3 | 4 | 5 | 6 | 7 | 8 | 9 | 10 | 11 | 12 | 13 | 14 | 15 | 16
1 | 2 | 3 | 4 | 5 | 6 | 7 | 8 | 9 | 10 | 11 | 12 | 13 | 14 | 15 | 16

AB

C

D

E

### FGH

### IJK

AB

C

D

E

### FGH

# IJK Date: 2026-10-04

Size: A1 | Rev: Source migration 1

# Title: InstrumentPort-Digital-50 DUT boundary, vertical

# File: instrument_port_digital_50_dut_ffc_boundary_vertical.kicad_sch

# Sheet: /instrument_port_digital_50_dut_ffc_boundary_vertical/

# Migrated from the saved library sheet; circuit and PCB unchanged

# Circuit and PCB layout guidance

R523

100 R501

10k

R527

100 R528

100 | R521

100 R522

100 OE1

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
9 | GND 10
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
18 OE2

19 | VCC 20 | PAD 21 U503

## SN74LV541ARKSR

R526

100 R513

100 | R524
100 R515

100 R518

100 | R525

100 OE1 1

A1 2
A2 3
A3 4
A4 5
A5 6
A6 7
A7 8
A8 9 | GND 10
Y8 11 Y7 12 Y6 13 Y5 14 Y4 15 Y3 16 Y2 17 Y1 18 OE2 19 | VCC 20 | PAD 21 U502

## SN74LV541ARKSR

C501

4.7uF

R502

10k | R514

100 R516

100 | R517
100 | R503
10k | 1

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
J501

## FH12-50S-0.5SVA(54) R504

10k

OE1 1

A1 2
A2 3
A3 4
A4 5
A5 6
A6 7
A7 8
A8 9 | GND 10
Y8 11 Y7 12 Y6 13 Y5 14 Y4 15 Y3 16 Y2 17 Y1 18 OE2 19 | VCC 20 | PAD 21 U501

## SN74LV541ARKSR

R510

100 | R507

100 R509

100 R508

100

R532

100 | R531

100 C505

100nF | R530
100 | R529
| 100

R506

100

OE1 1

A1 2
A2 3
A3 4
A4 5
A5 6
A6 7
A7 8
A8 9 | GND 10
Y8 11 Y7 12 Y6 13 Y5 14 Y4 15 Y3 16 Y2 17 Y1 18 OE2 19 | VCC 20 | PAD 21 U504

## SN74LV541ARKSR

R536

100 | R535

100 R534

100 | R533
| 100

C502

100nF | R511
100 R505

100

R512

100 | R520

100 C503

100nF | C504 100nF R519
| 100

## DIG24

# DIG13 DIG14

# DIG31 DIG27

## DIG15

## DIG30

# DIG7 DIG16 DIG23 DIG29

# DIG22 DIG21 DIG17 DIG20 DIG28

# DIG18 DIG19 DIG11 DIG6 DIG5 DIG4 DIG8 DIG3 DIG2 DIG9

# DIG1 DIG10 DIG12

# DIG0 GND

# DIG26 DIG25

+3.3V

## DIG31_ISO

## DIG26_BUF GND

DIG2_BUF | DIG17_BUF
DIG25_BUF | DIG25_ISO

## DIG16_BUF OE4

DIG24_BUF | DIG24_ISO
DIG3_BUF DIG1_BUF DIG0_BUF | GND +3.3V | DIG30_BUF
DIG5_ISO | OE3
DIG5_BUF | DIG3_ISO | +3.3V GND | GND OE4 OE4 | DIG27_BUF | DIG27_ISO | GND

## DIG26_ISO

DIG7 DIG0 DIG1 DIG2 | DIG20 DIG3 DIG4 DIG5 DIG6 | GND OE1 OE1
DIG19 DIG18 DIG17 DIG16 OE3 OE3 | DIG21_BUF DIG18_BUF DIG30_ISO | GND

## DIG19_BUF

DIG28_BUF | DIG28_ISO

## DIG20_BUF DIG1_ISO

## DIG31_BUF

DIG22_BUF DIG23 | DIG23_BUF DIG22 DIG21 DIG1_BUF GND | OE1 | DIG20_BUF | DIG7 DIG6 DIG5 DIG4 DIG3 DIG2 DIG1 DIG0 GND+3.3V DIG20_ISO
DIG8 DIG19_BUF | DIG19_ISO | DIG18_BUF | DIG18_ISO
DIG17_BUF | DIG17_ISO | DIG16_BUF | DIG16_ISO
DIG23_BUF | DIG23_ISO | DIG22_ISO

## DIG20

# DIG31 DIG30 DIG29 DIG28 DIG27 DIG26 DIG25 DIG21 DIG24 DIG23 DIG22

## DIG22_BUF

## DIG19 DIG18 DIG17 DIG16 DIG15 DIG14 DIG13 DIG12 DIG11 DIG10 DIG9 DIG13

# DIG29 DIG30 DIG31 GND +3.3V

# OE2 DIG8 DIG9 DIG10 DIG11 DIG12

## DIG28

DIG14 DIG15 DIG6_BUF | DIG6_ISO
DIG4_BUF | DIG4_ISO

## DIG7_BUF DIG6_BUF DIG5_BUF DIG4_BUF DIG3_BUF

## DIG28_BUF

DIG21_BUF | DIG21_ISO +3.3V GND +3.3V | DIG7_BUF | DIG7_ISO GND

# DIG31_BUF DIG30_BUF DIG29_BUF GND

DIG27_BUF DIG26_BUF DIG25_BUF DIG24_BUF | DIG29_BUF | DIG29_ISO +3.3V DIG24 DIG25 DIG26 DIG27
DIG11_ISO | DIG10_BUF

## GND

## DIG18_ISO

## DIG9_BUF

## DIG25_ISO

## DIG24_ISO

## DIG9_BUF

## GND

## DIG19_ISO GND

## GND

## DIG31_ISO

## DIG8_BUF

## DIG14_ISO

## DIG11_BUF

## GND

## DIG12_ISO

## DIG1_ISO

## GND

## DIG23_ISO

## DIG22_ISO

## GND

## DIG2_ISO

## DIG29_ISO

## GND DIG16_ISO

## GND

## GND

## GND

## DIG11_ISO

## DIG10_ISO

## DIG17_ISO

## DIG15_ISO

DIG10_BUF DIG11_BUF | GND

## DIG28_ISO

## GND

## DIG10_ISO

## DIG27_ISO

## DIG12_BUF

## DIG26_ISO

## DIG30_ISO

## DIG13_BUF DIG14_BUF

## GND

## DIG15_BUF

## DIG9_ISO

DIG2_BUF | DIG14_BUF DIG2_ISO | GND

## DIG13_BUF +3.3V

DIG0_BUF | DIG7_ISO

## GND DIG8_ISO

## DIG0_ISO GND

## DIG12_ISO

## DIG0_ISO

## DIG15_BUF

## GND

## DIG9_ISO OE2

## DIG14_ISO

DIG8_BUF DIG12_BUF | DIG3_ISO

## DIG8_ISO

## GND

## DIG21_ISO GND

DIG20_ISO +3.3V | GND +3.3V | GND

## DIG4_ISO DIG5_ISO GND DIG6_ISO

## DIG13_ISO

OE2 | DIG15_ISO

## DIG13_ISO

Output source damping | Observation input 10 into U502 A6 (pin 7); leaves on contact 17. Observation input 8 into U502 A8 (pin 9); leaves on contact 14. Observation input 9 into U502 A7 (pin 8); leaves on contact 15. Observation input 17 into U503 A7 (pin 8); leaves on contact 28. Observation input 11 into U502 A5 (pin 6); leaves on contact 18. Observation input 12 into U502 A4 (pin 5); leaves on contact 20. Observation input 13 into U502 A3 (pin 4); leaves on contact 21. Observation input 14 into U502 A2 (pin 3); leaves on contact 23. Observation input 15 into U502 A1 (pin 2); leaves on contact 24. Observation input 16 into U503 A8 (pin 9); leaves on contact 27. 10 k OE1/OE2 pull-down, | Observation input 18 into U503 A6 (pin 7); leaves on contact 30. between the Y pins and J501, outputs toward the connector. | Observation input 19 into U503 A5 (pin 6); leaves on contact 31.

Observation input 7 into U501 A1 (pin 2); leaves on contact 12.

Observation input 30 into U504 A2 (pin 3); leaves on contact 48.

Observation input 20 into U503 A4 (pin 5); leaves on contact 33. Observation input 21 into U503 A3 (pin 4); leaves on contact 34. Observation input 22 into U503 A2 (pin 3); leaves on contact 36. Observation input 23 into U503 A1 (pin 2); leaves on contact 37. Observation input 24 into U504 A8 (pin 9); leaves on contact 39. Observation input 25 into U504 A7 (pin 8); leaves on contact 40. Observation input 26 into U504 A6 (pin 7); leaves on contact 42. Observation input 27 into U504 A5 (pin 6); leaves on contact 43. Observation input 28 into U504 A4 (pin 5); leaves on contact 45. Observation input 29 into U504 A3 (pin 4); leaves on contact 46.

U502 buffers DIG8 to DIG15 (inputs A8 to A1, pins 9 to 2) onto Y8 to Y1 (pins 11 to 18); R513 to R520 (100 ohm) damp each output into its connector contact.

Observation input 31 into U504 A1 (pin 2); leaves on contact 49.

# 6. FFC receptacle

with the connector's ground contacts. 10 k OE1/OE2 pull-down, SN74LV541A octal buffer, DUT to instrument

50-contact FFC receptacle, top entry PLACE: Vertical, top-entry receptacle at the board edge, latch away from the buffers; verify pin 1 and the contact face on the real part. ROUTE: Pair each DIGn_ISO with its neighbouring ground contact and tie all 18 grounds into one GND copper under the connector; land pattern dual-row staggered at 1.0 mm

within each row.

with the connector's ground contacts. | Output source damping

Output source damping C501 (4.7 uF) holds the +3.3V rail where it enters the block; the per-package 100 nF bypasses are in the octet groups. ROUTE: The DIG8 to DIG15 inputs are this block's ports and escape toward the board on vias; keep the Y runs short to the resistors and the resistor-to-contact runs paired

between the Y pins and J501, outputs toward the connector. PLACE: Place C503 hard against pin 20 of U502 with a short return to pin 10 and the exposed pad 21; R502 near pins 1 and 19; the eight damping resistors ROUTE: +3.3V carries PWR_3V3_LOCAL from the entry to the four VCC pins; GND is PWR_RETURN_LOCAL. PLACE: Place C501 at the supply entry of the block, not at any one package. 4.7 uF +3.3V rail-entry bulk,

Output source damping

Output source damping 10 k OE1/OE2 pull-down, | SN74LV541A octal buffer, DUT to instrument | Output source damping

Output source damping

VCC pin 20 bypass, 100 nF Output source damping | Output source damping | Output source damping

Output source damping

and every net stays driven and terminated: ERC, DRC and design_block_tools.py check are ALL BLIND to this error, and only a pin-by-pin netlist comparison or continuity on the real cable catches it. orb_weaver_smd:Texas_RKS0020A_VQFN-20-1EP_2.5x4.5mm_P0.5mm_EP1x3mm, exposed pad 21 to GND), grouped DIG0-7 / DIG8-15 / DIG16-23 / DIG24-31 to match the 13-contact octet windows. The 541 is flow-through: input pin p pairs with output pin 20-p, A1(2) to Y1(18) through A8(9) to Y8(11). DIRECTION IS A HARDWARE PROPERTY: DUT to instrument only. The cable carries no supply, no voltage NOT HERE. instrument_port_digital_50_adapter_ffc_boundary_vertical is pre-mirrored to 51-n so that the expected reversing assembly - same-side Type A FFC with a vertical FH12 at both ends, connectors

rotated 180 degrees - delivers DIGn to DIGn. Mirroring both ends cancels and channels arrive as DIG31-n. The ground pattern is palindromic under 51-n, so a mirrored map lands every ground identically

## SN74LV541A octal buffer, DUT to instrument

Per-output source damping is 100 ohms, OW-PASS-0402WGF1000TCE. That value is chosen as the smallest standard one that bounds a hard short to ground inside the LV541A's +/-35mA output absolute maximum even crediting the driver with zero impedance (3.3V/100R = 33mA); 68R gives 49mA, 47R gives 70mA, and the legacy 33R gives 100mA. It is NOT short-circuit protection and does not cover no OE port. The owning contract was relaxed on 2026-09-15 from requiring manual disabling to permitting none, so this conforms; the reasoning and the retained future option are in
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
