peterpolidoro/camera-gpio-interface-pcb/kicad/camera-gpio-interface-pcb.kicad_pcb

## KiCad design kicad/camera-gpio-interface-pcb.kicad_pcb (2026-10-14)

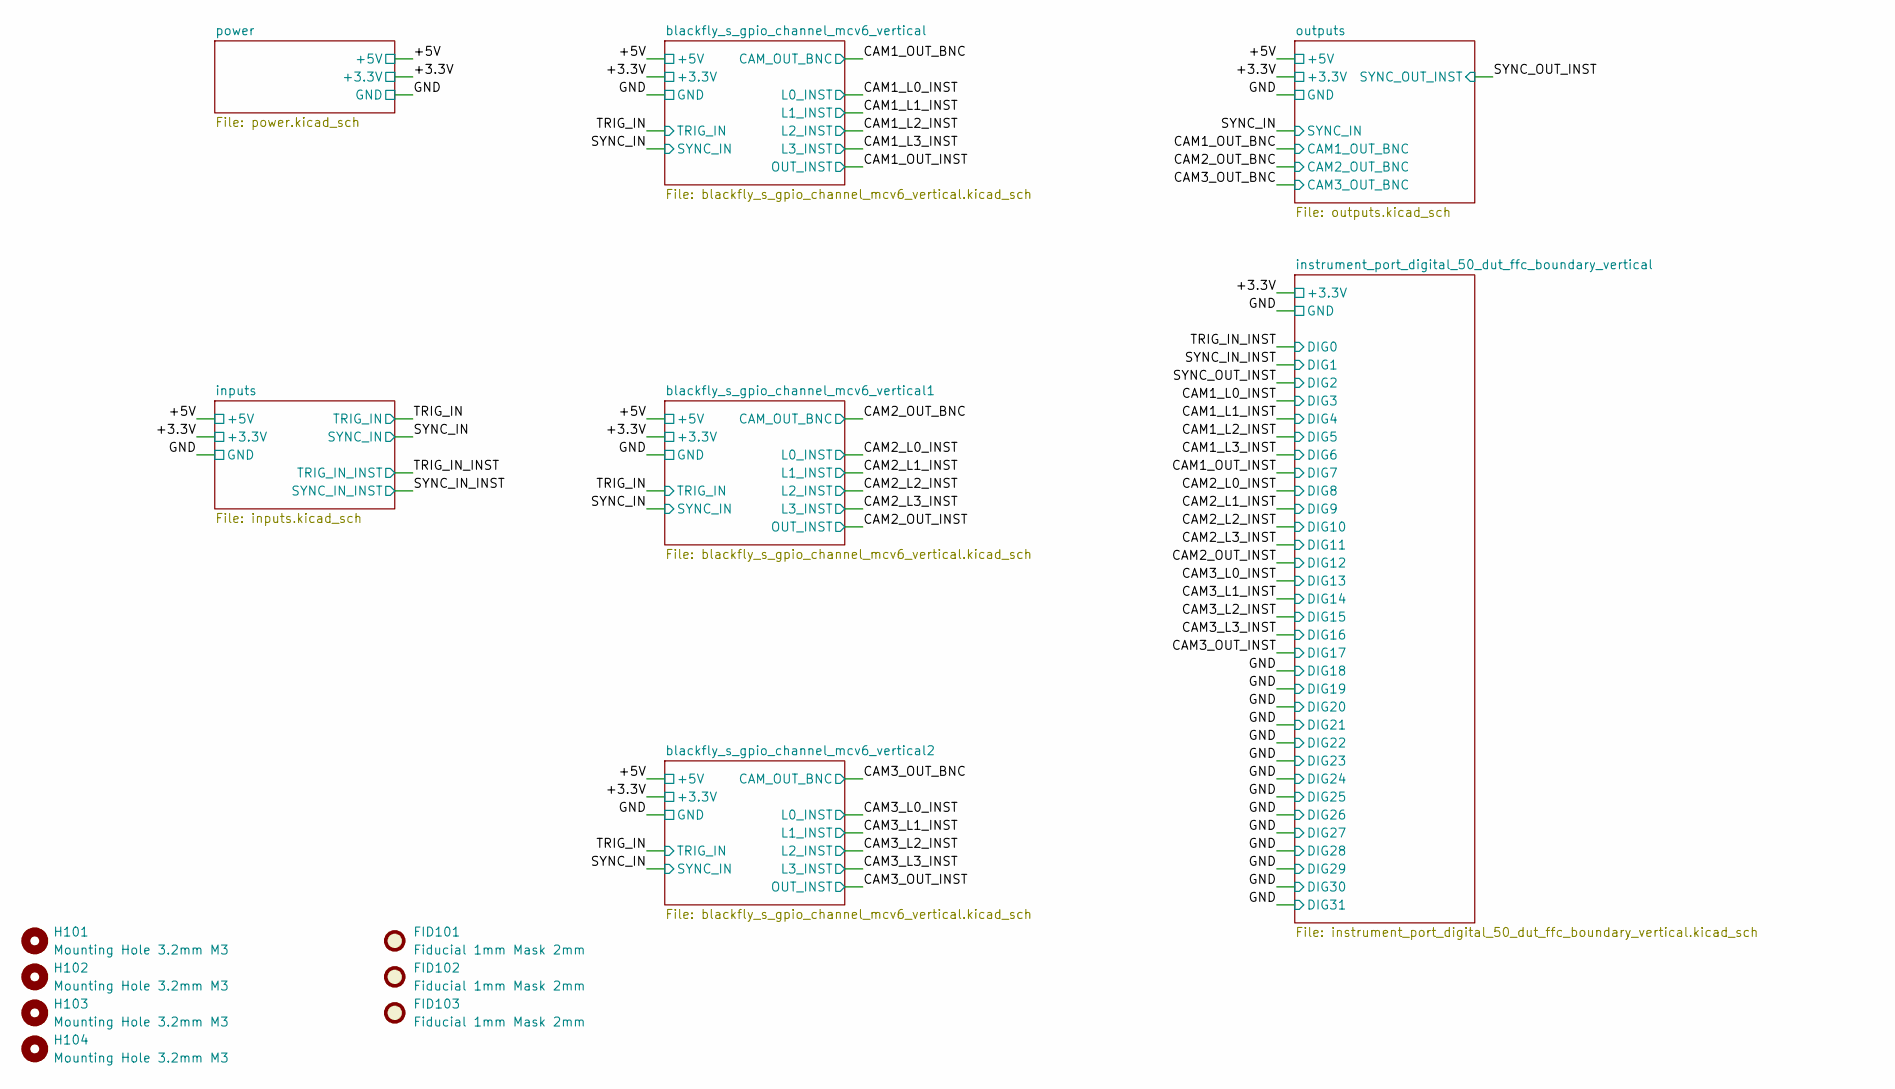
[picture p48: schematic camera-gpio-interface-pcb.kicad_sch]

Parts:
FID101, FID102, FID103: Fiducial 1mm Mask 2mm; Fiducial_1mm_Mask2mm
H101, H102, H103, H104: Mounting Hole 3.2mm M3; MountingHole_3.2mm_M3

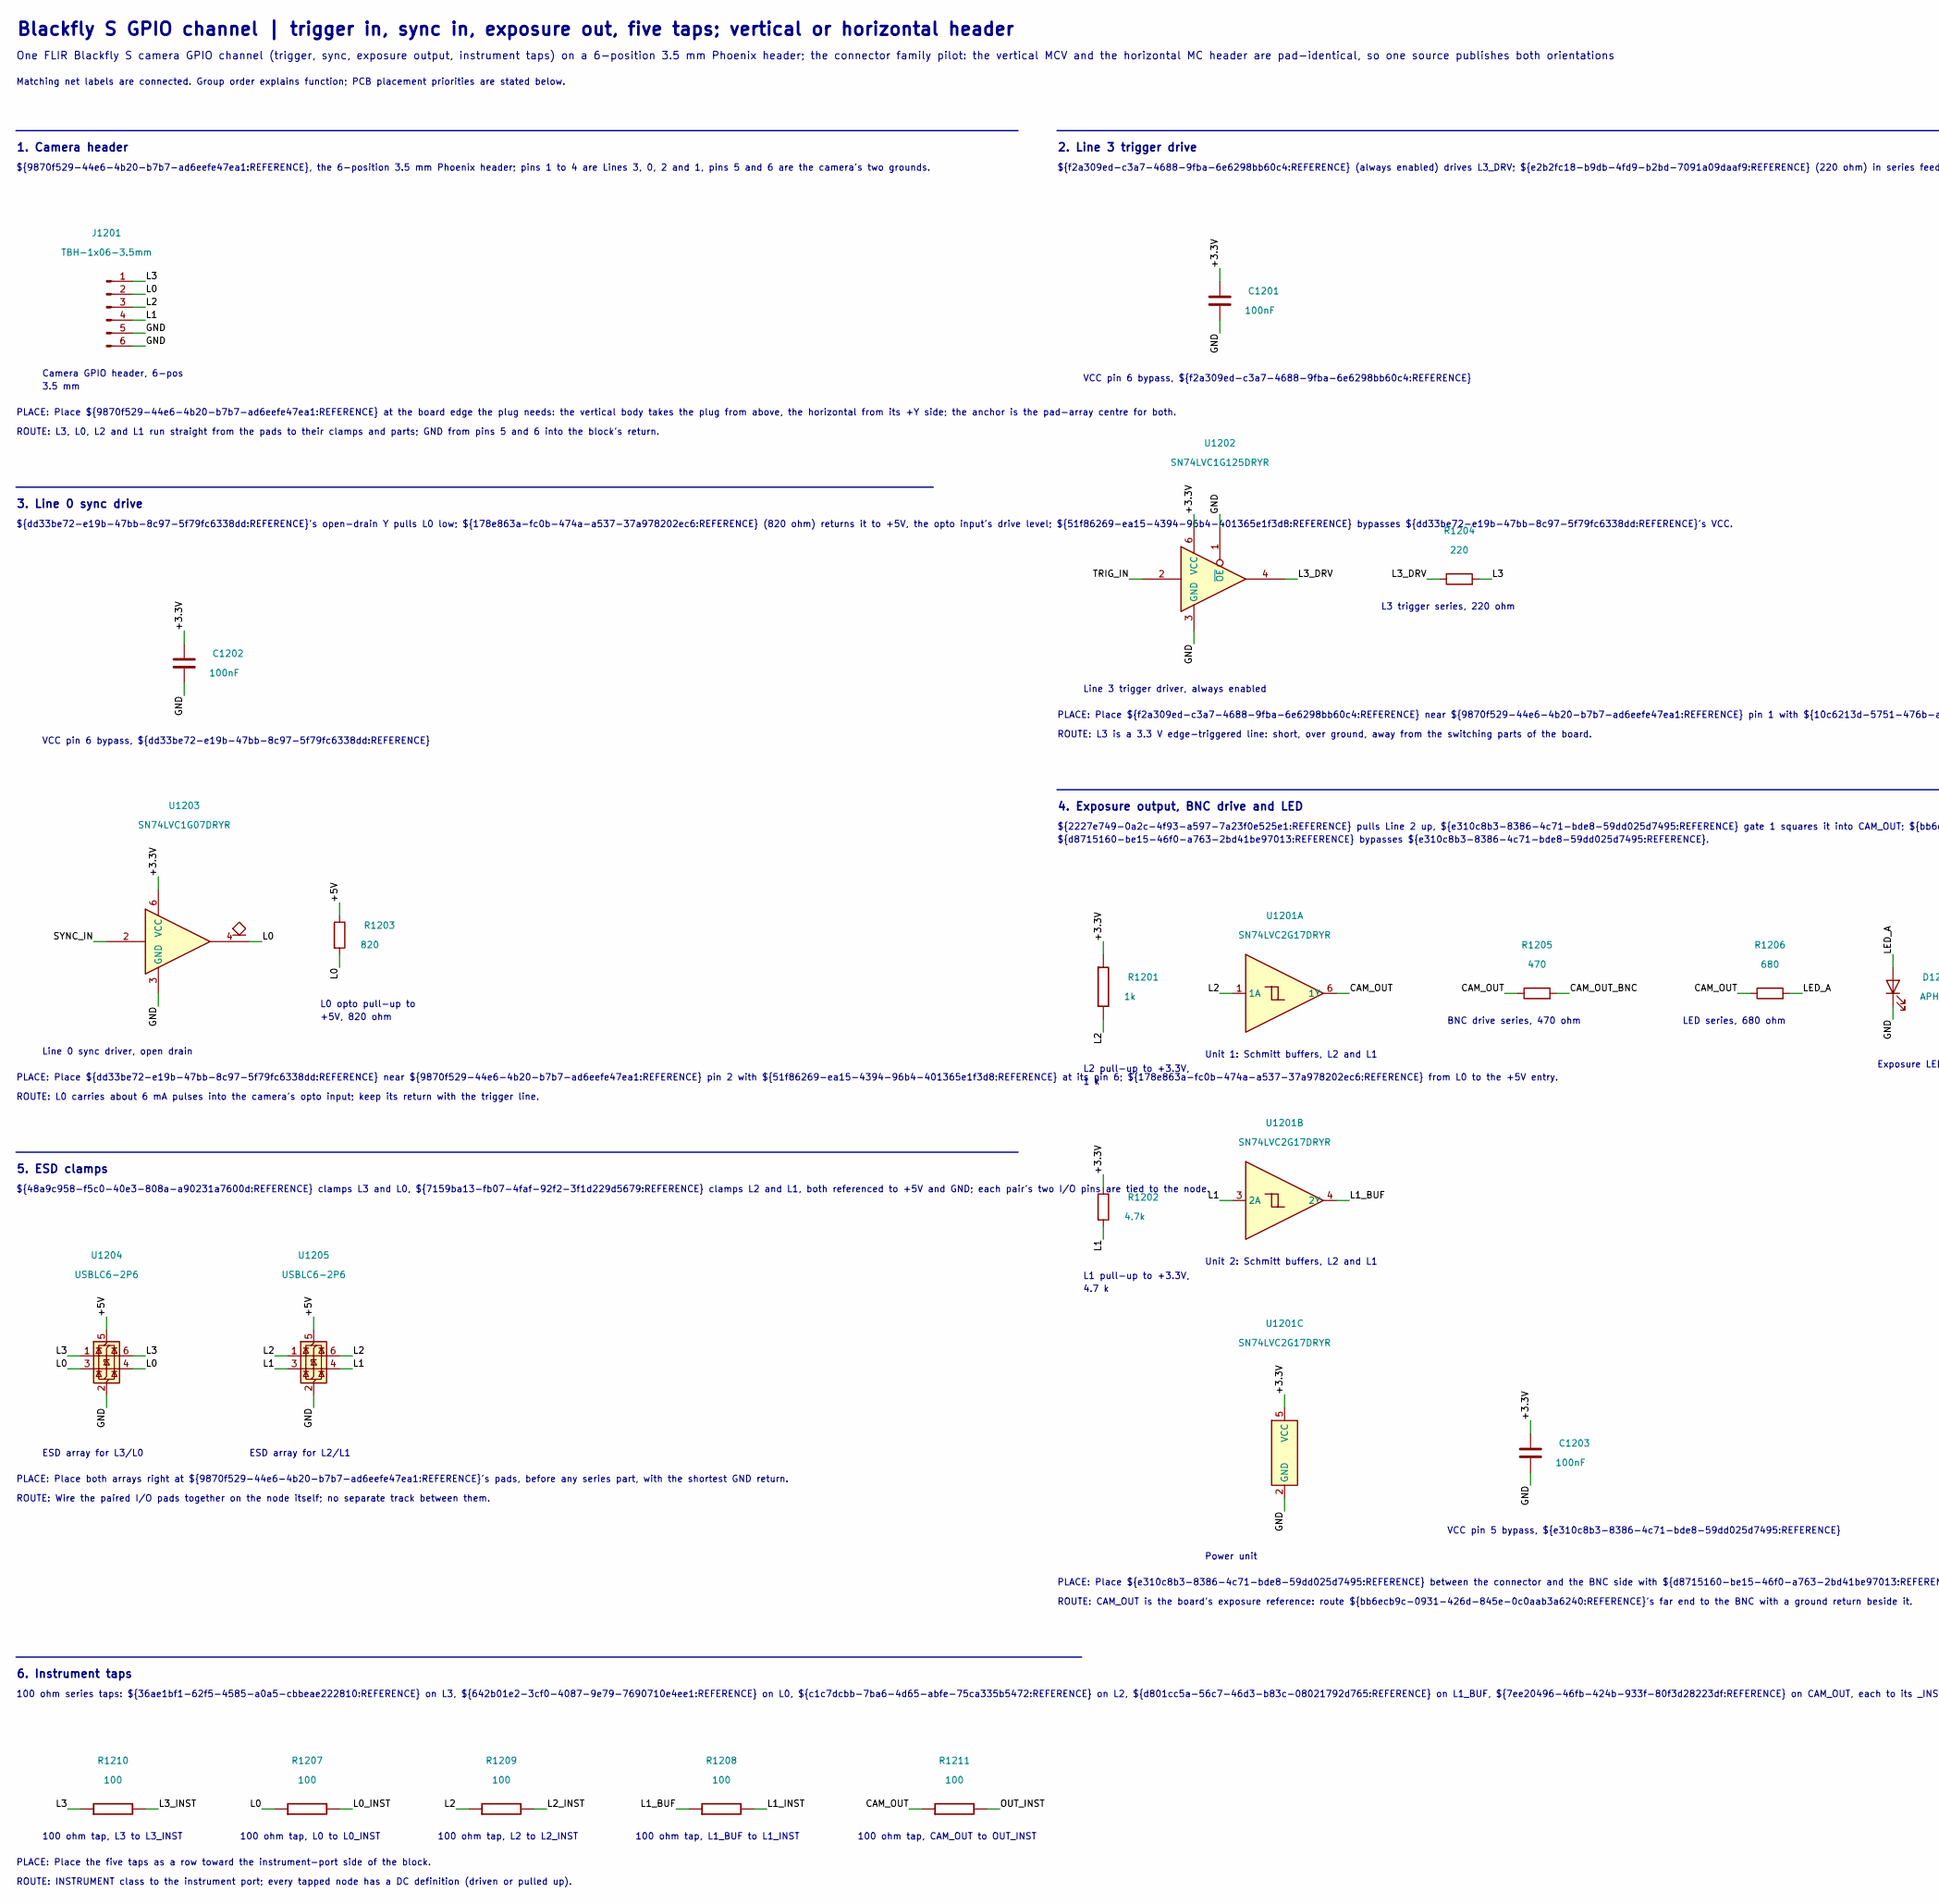
[picture p49: schematic blackfly_s_gpio_channel_mcv6_vertical.kicad_sch, Blackfly S GPIO channel family, part in row 1, column 1]

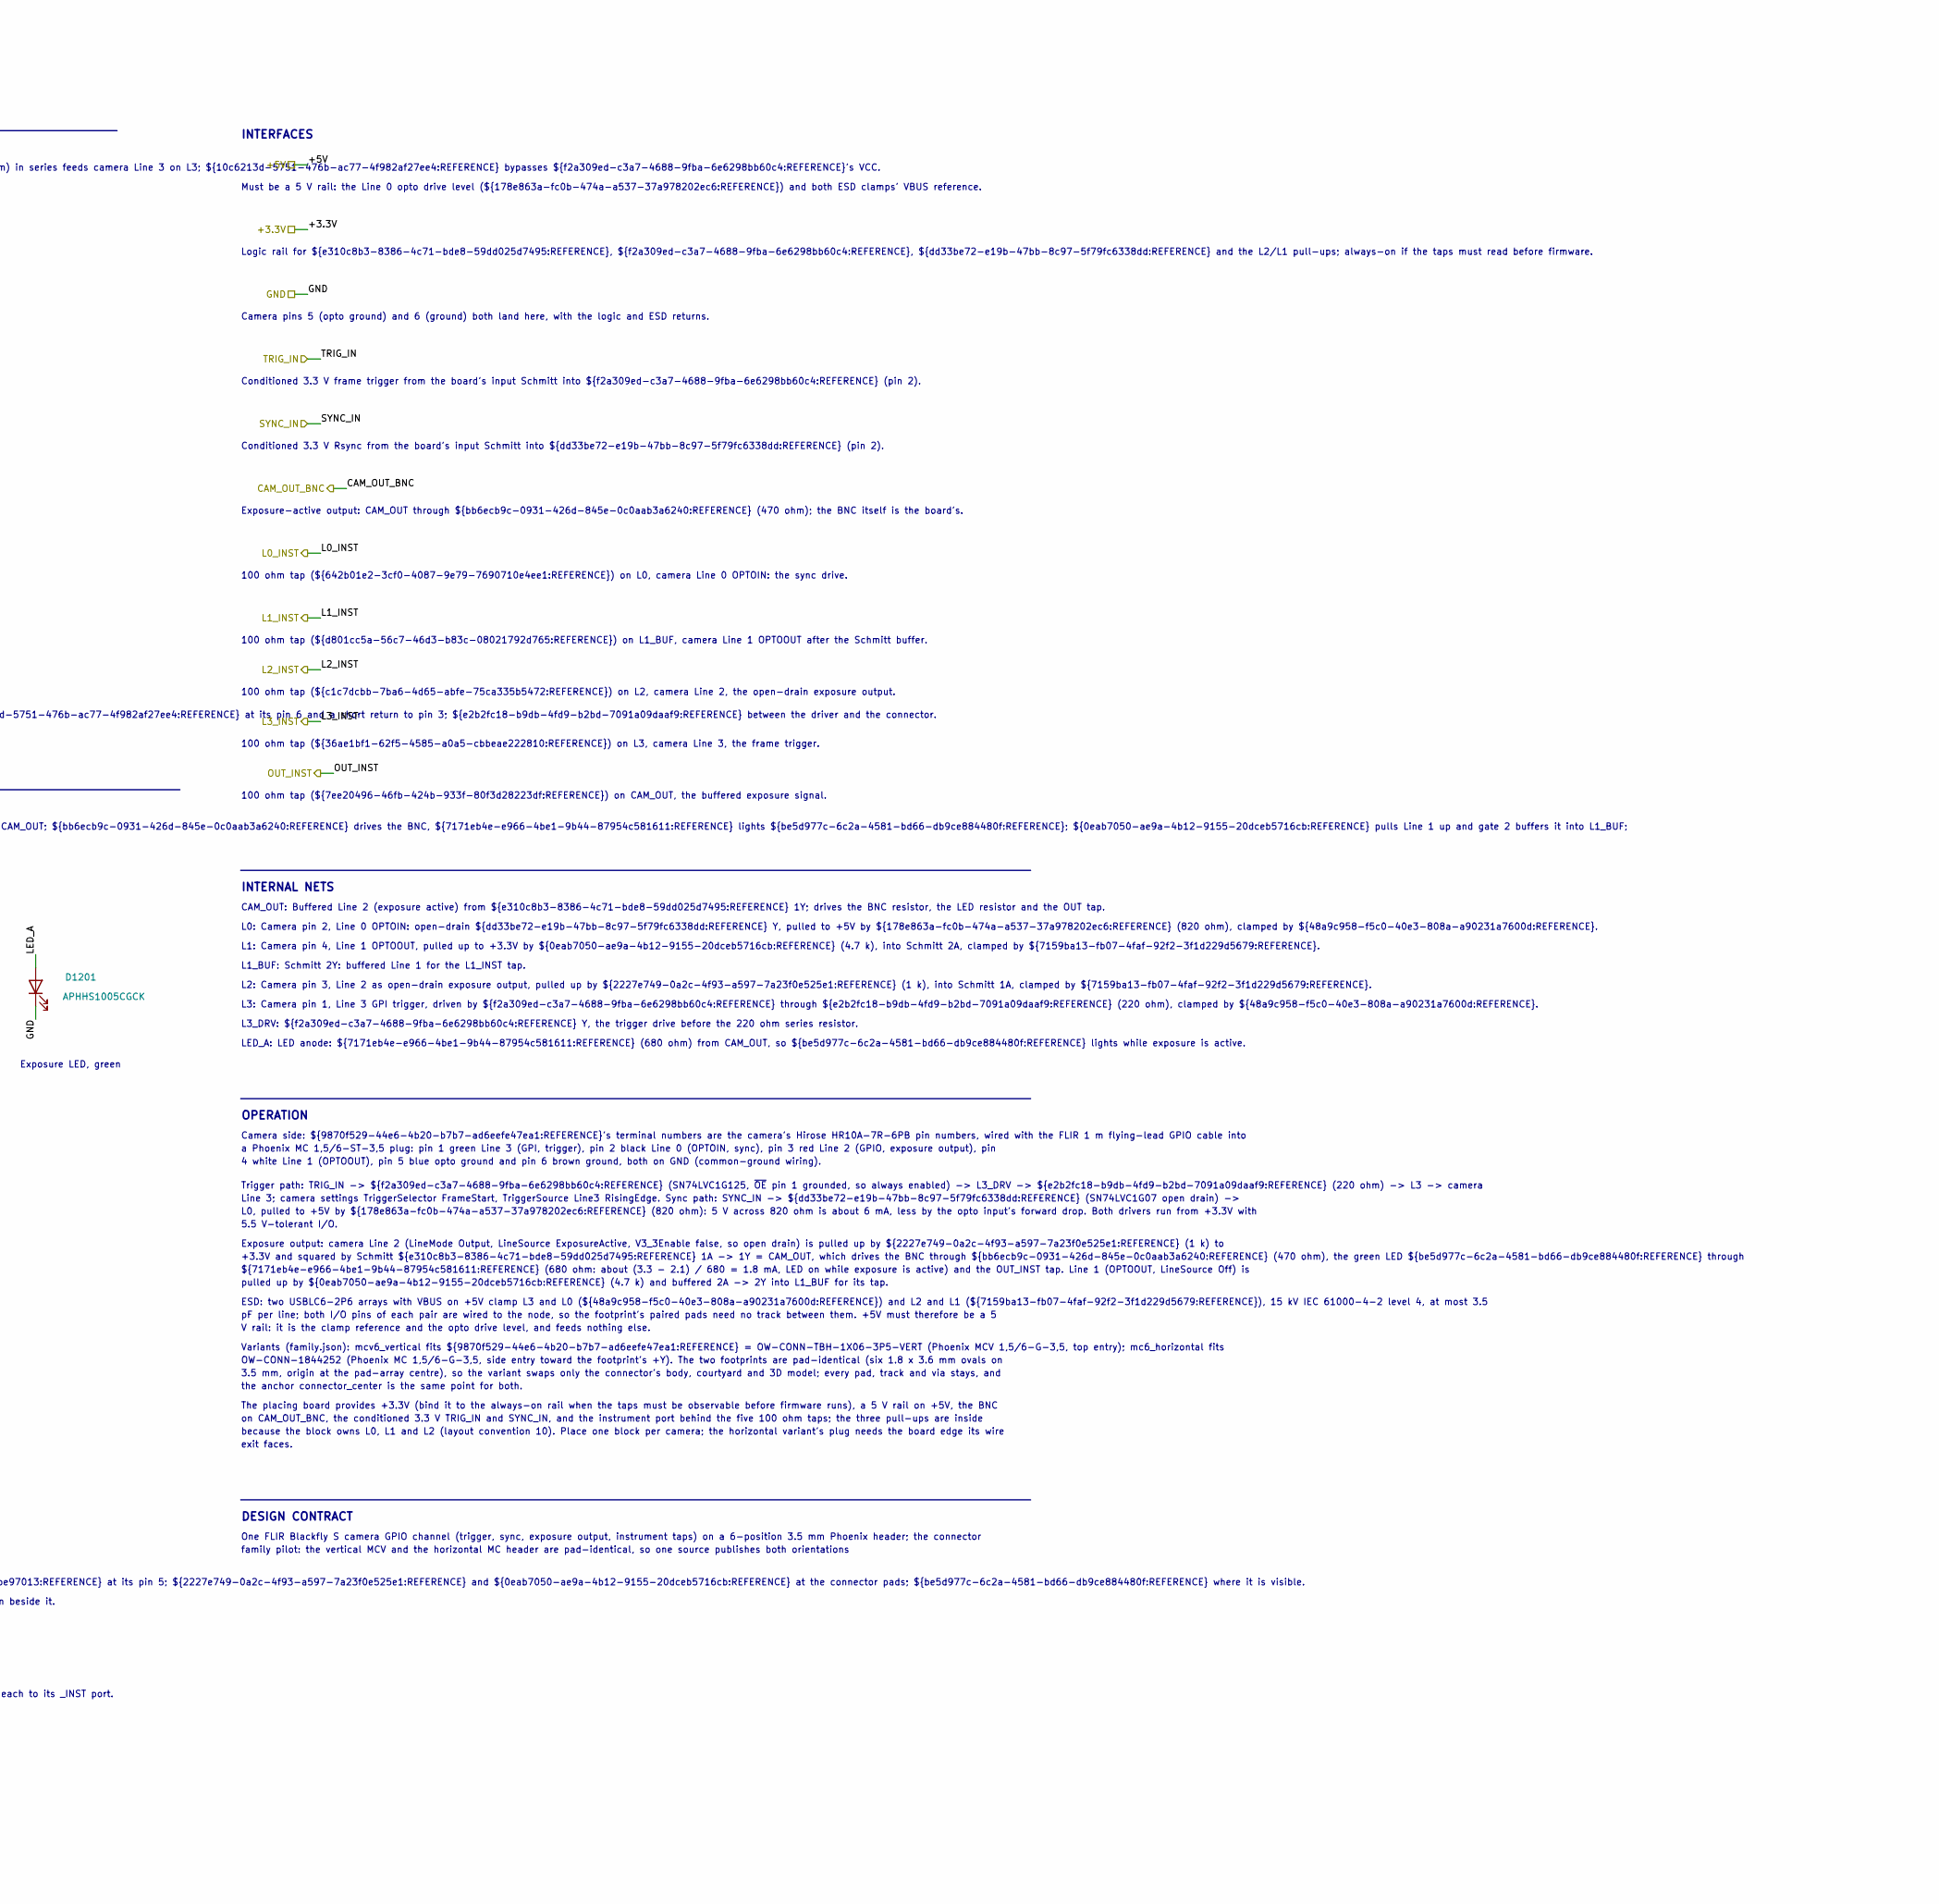
[picture p50: schematic blackfly_s_gpio_channel_mcv6_vertical.kicad_sch, Blackfly S GPIO channel family, part in row 1, column 2]

Parts:
C1201, C1202, C1203: 100nF; C_0402_1005Metric; PartID sym_orb_weaver_passives_c_0_1uf_100v_04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
D1201: APHHS1005CGCK; LED_0402-1005_KNB; PartID sym_orb_weaver_misc_led_knb_20ma_grn_2_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
J1201: TBH-1x06-3.5mm; PhoenixContact_MCV_1,5_6-G-3.5_1x06_P3.50mm_Vertical; PartID sym_orb_weaver_connectors_conn_01x06_p3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
R1201: 1k; R_0402_1005Metric; PartID sym_orb_weaver_passives_r_1k_0402
R1202: 4.7k; R_0402_1005Metric; PartID sym_orb_weaver_passives_r_4_7k_0402
R1203: 820; R_0402_1005Metric; PartID mpn_frc0402f8200ts_0402
R1204: 220; R_0603_1608Metric; PartID mpn_0603waf2200t5e_0603
R1205: 470; R_0603_1608Metric; PartID mpn_0603waf4700t5e_0603
R1206: 680; R_0402_1005Metric; PartID mpn_rc0402fr_07680rl_0402
R1207, R1208, R1209, R1210, R1211: 100; R_0402_1005Metric; PartID sym_orb_weaver_passives_r_100_0402
U1201: SN74LVC2G17DRYR; DRY6; PartID sym_orb_weaver_misc_buffer_74lvc2g17dryr
U1202: SN74LVC1G125DRYR; DRY6; PartID sym_orb_weaver_misc_buffer_74lvc1g125dr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
U1203: SN74LVC1G07DRYR; DRY6; PartID sym_orb_weaver_misc_buffer_74lvc1g07dryr
U1204, U1205: USBLC6-2P6; USBLC6-2P6_SOT-666; PartID mpn_usblc6_2p6_sot_666_6

Connections:
/+3.3V: C1201.1, C1202.1, C1203.1, R1201.1, R1202.1, U1201.5 (VCC), U1202.6 (VCC), U1203.6 (VCC); also elsewhere on the board
/+5V: R1203.1, U1204.5 (VBUS), U1205.5 (VBUS); also elsewhere on the board
/CAM2_L0_INST: R1207.2; also elsewhere on the board
/CAM2_L1_INST: R1208.2; also elsewhere on the board
/CAM2_L2_INST: R1209.2; also elsewhere on the board
/CAM2_L3_INST: R1210.2; also elsewhere on the board
/CAM2_OUT_BNC: R1205.2; also elsewhere on the board
/CAM2_OUT_INST: R1211.2; also elsewhere on the board
/GND: C1201.2, C1202.2, C1203.2, D1201.1 (K), J1201.5, J1201.6, U1201.2 (GND), U1202.1 (~OE), U1202.3 (GND), U1203.3 (GND), U1204.2 (GND), U1205.2 (GND); also elsewhere on the board
/SYNC_IN: U1203.2; also elsewhere on the board
/TRIG_IN: U1202.2; also elsewhere on the board
/blackfly_s_gpio_channel_mcv6_vertical1/CAM_OUT: R1205.1, R1206.1, R1211.1, U1201.6 (1Y)
/blackfly_s_gpio_channel_mcv6_vertical1/L0: J1201.2, R1203.2, R1207.1, U1203.4, U1204.3 (I/O2), U1204.4 (I/O2)
/blackfly_s_gpio_channel_mcv6_vertical1/L1: J1201.4, R1202.2, U1201.3 (2A), U1205.3 (I/O2), U1205.4 (I/O2)
/blackfly_s_gpio_channel_mcv6_vertical1/L1_BUF: R1208.1, U1201.4 (2Y)
/blackfly_s_gpio_channel_mcv6_vertical1/L2: J1201.3, R1201.2, R1209.1, U1201.1 (1A), U1205.1 (I/O1), U1205.6 (I/O1)
/blackfly_s_gpio_channel_mcv6_vertical1/L3: J1201.1, R1204.2, R1210.1, U1204.1 (I/O1), U1204.6 (I/O1)
/blackfly_s_gpio_channel_mcv6_vertical1/L3_DRV: R1204.1, U1202.4
/blackfly_s_gpio_channel_mcv6_vertical1/LED_A: D1201.2 (A), R1206.2

Parts of its further copies:
C701, C702, C703, C1401, C1402, C1403: 100nF; C_0402_1005Metric; PartID sym_orb_weaver_passives_c_0_1uf_100v_04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
D701, D1401: APHHS1005CGCK; LED_0402-1005_KNB; PartID sym_orb_weaver_misc_led_knb_20ma_grn_2_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
J701, J1401: TBH-1x06-3.5mm; PhoenixContact_MCV_1,5_6-G-3.5_1x06_P3.50mm_Vertical; PartID sym_orb_weaver_connectors_conn_01x06_p3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
R701, R1401: 1k; R_0402_1005Metric; PartID sym_orb_weaver_passives_r_1k_0402
R702, R1402: 4.7k; R_0402_1005Metric; PartID sym_orb_weaver_passives_r_4_7k_0402
R703, R1403: 820; R_0402_1005Metric; PartID mpn_frc0402f8200ts_0402
R704, R1404: 220; R_0603_1608Metric; PartID mpn_0603waf2200t5e_0603
R705, R1405: 470; R_0603_1608Metric; PartID mpn_0603waf4700t5e_0603
R706, R1406: 680; R_0402_1005Metric; PartID mpn_rc0402fr_07680rl_0402
R707, R708, R709, R710, R711, R1407, R1408, R1409, R1410, R1411: 100; R_0402_1005Metric; PartID sym_orb_weaver_passives_r_100_0402
U701, U1401: SN74LVC2G17DRYR; DRY6; PartID sym_orb_weaver_misc_buffer_74lvc2g17dryr
U702, U1402: SN74LVC1G125DRYR; DRY6; PartID sym_orb_weaver_misc_buffer_74lvc1g125dr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
U703, U1403: SN74LVC1G07DRYR; DRY6; PartID sym_orb_weaver_misc_buffer_74lvc1g07dryr
U704, U705, U1404, U1405: USBLC6-2P6; USBLC6-2P6_SOT-666; PartID mpn_usblc6_2p6_sot_666_6

Connections of its further copies:
/+3.3V: C701.1, C702.1, C703.1, C1401.1, C1402.1, C1403.1, R701.1, R702.1, R1401.1, R1402.1, U701.5 (VCC), U702.6 (VCC), U703.6 (VCC), U1401.5 (VCC), U1402.6 (VCC), U1403.6 (VCC); also elsewhere on the board
/+5V: R703.1, R1403.1, U704.5 (VBUS), U705.5 (VBUS), U1404.5 (VBUS), U1405.5 (VBUS); also elsewhere on the board
/CAM1_L0_INST: R707.2; also elsewhere on the board
/CAM1_L1_INST: R708.2; also elsewhere on the board
/CAM1_L2_INST: R709.2; also elsewhere on the board
/CAM1_L3_INST: R710.2; also elsewhere on the board
/CAM1_OUT_BNC: R705.2; also elsewhere on the board
/CAM1_OUT_INST: R711.2; also elsewhere on the board
/CAM3_L0_INST: R1407.2; also elsewhere on the board
/CAM3_L1_INST: R1408.2; also elsewhere on the board
/CAM3_L2_INST: R1409.2; also elsewhere on the board
/CAM3_L3_INST: R1410.2; also elsewhere on the board
/CAM3_OUT_BNC: R1405.2; also elsewhere on the board
/CAM3_OUT_INST: R1411.2; also elsewhere on the board
/GND: C701.2, C702.2, C703.2, C1401.2, C1402.2, C1403.2, D701.1 (K), D1401.1 (K), J701.5, J701.6, J1401.5, J1401.6, U701.2 (GND), U702.1 (~OE), U702.3 (GND), U703.3 (GND), U704.2 (GND), U705.2 (GND), U1401.2 (GND), U1402.1 (~OE), U1402.3 (GND), U1403.3 (GND), U1404.2 (GND), U1405.2 (GND); also elsewhere on the board
/SYNC_IN: U703.2, U1403.2; also elsewhere on the board
/TRIG_IN: U702.2, U1402.2; also elsewhere on the board
/blackfly_s_gpio_channel_mcv6_vertical2/CAM_OUT: R1405.1, R1406.1, R1411.1, U1401.6 (1Y)
/blackfly_s_gpio_channel_mcv6_vertical2/L0: J1401.2, R1403.2, R1407.1, U1403.4, U1404.3 (I/O2), U1404.4 (I/O2)
/blackfly_s_gpio_channel_mcv6_vertical2/L1: J1401.4, R1402.2, U1401.3 (2A), U1405.3 (I/O2), U1405.4 (I/O2)
/blackfly_s_gpio_channel_mcv6_vertical2/L1_BUF: R1408.1, U1401.4 (2Y)
/blackfly_s_gpio_channel_mcv6_vertical2/L2: J1401.3, R1401.2, R1409.1, U1401.1 (1A), U1405.1 (I/O1), U1405.6 (I/O1)
/blackfly_s_gpio_channel_mcv6_vertical2/L3: J1401.1, R1404.2, R1410.1, U1404.1 (I/O1), U1404.6 (I/O1)
/blackfly_s_gpio_channel_mcv6_vertical2/L3_DRV: R1404.1, U1402.4
/blackfly_s_gpio_channel_mcv6_vertical2/LED_A: D1401.2 (A), R1406.2
/blackfly_s_gpio_channel_mcv6_vertical/CAM_OUT: R705.1, R706.1, R711.1, U701.6 (1Y)
/blackfly_s_gpio_channel_mcv6_vertical/L0: J701.2, R703.2, R707.1, U703.4, U704.3 (I/O2), U704.4 (I/O2)
/blackfly_s_gpio_channel_mcv6_vertical/L1: J701.4, R702.2, U701.3 (2A), U705.3 (I/O2), U705.4 (I/O2)
/blackfly_s_gpio_channel_mcv6_vertical/L1_BUF: R708.1, U701.4 (2Y)
/blackfly_s_gpio_channel_mcv6_vertical/L2: J701.3, R701.2, R709.1, U701.1 (1A), U705.1 (I/O1), U705.6 (I/O1)
/blackfly_s_gpio_channel_mcv6_vertical/L3: J701.1, R704.2, R710.1, U704.1 (I/O1), U704.6 (I/O1)
/blackfly_s_gpio_channel_mcv6_vertical/L3_DRV: R704.1, U702.4
/blackfly_s_gpio_channel_mcv6_vertical/LED_A: D701.2 (A), R706.2

Notes on the sheet:
Blackfly S GPIO channel | trigger in, sync in, exposure out, five taps; vertical or horizontal header
One FLIR Blackfly S camera GPIO channel (trigger, sync, exposure output, instrument taps) on a 6-position 3.5 mm Phoenix header; the connector family pilot: the vertical MCV and the horizontal MC header are pad-identical, so one source publishes both orientations
Matching net labels are connected. Group order explains function; PCB placement priorities are stated below.
1. Camera header
${9870f529-44e6-4b20-b7b7-ad6eefe47ea1:REFERENCE}, the 6-position 3.5 mm Phoenix header; pins 1 to 4 are Lines 3, 0, 2 and 1, pins 5 and 6 are the camera's two grounds.
Camera GPIO header, 6-pos
3.5 mm
PLACE: Place ${9870f529-44e6-4b20-b7b7-ad6eefe47ea1:REFERENCE} at the board edge the plug needs: the vertical body takes the plug from above, the horizontal from its +Y side; the anchor is the pad-array centre for both.
ROUTE: L3, L0, L2 and L1 run straight from the pads to their clamps and parts; GND from pins 5 and 6 into the block's return.
2. Line 3 trigger drive
${f2a309ed-c3a7-4688-9fba-6e6298bb60c4:REFERENCE} (always enabled) drives L3_DRV; ${e2b2fc18-b9db-4fd9-b2bd-7091a09daaf9:REFERENCE} (220 ohm) in series feeds camera Line 3 on L3; ${10c6213d-5751-476b-ac77-4f982af27ee4:REFERENCE} bypasses ${f2a309ed-c3a7-4688-9fba-6e6298bb60c4:REFERENCE}'s VCC.
VCC pin 6 bypass, ${f2a309ed-c3a7-4688-9fba-6e6298bb60c4:REFERENCE}
Line 3 trigger driver, always enabled
L3 trigger series, 220 ohm
PLACE: Place ${f2a309ed-c3a7-4688-9fba-6e6298bb60c4:REFERENCE} near ${9870f529-44e6-4b20-b7b7-ad6eefe47ea1:REFERENCE} pin 1 with ${10c6213d-5751-476b-ac77-4f982af27ee4:REFERENCE} at its pin 6 and a short return to pin 3; ${e2b2fc18-b9db-4fd9-b2bd-7091a09daaf9:REFERENCE} between the driver and the c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
ROUTE: L3 is a 3.3 V edge-triggered line: short, over ground, away from the switching parts of the board.
3. Line 0 sync drive
${dd33be72-e19b-47bb-8c97-5f79fc6338dd:REFERENCE}'s open-drain Y pulls L0 low; ${178e863a-fc0b-474a-a537-37a978202ec6:REFERENCE} (820 ohm) returns it to +5V, the opto input's drive level; ${51f86269-ea15-4394-96b4-401365e1f3d8:REFERENCE} bypasses ${dd33be72-e19b-47bb-8c97-5f79fc6338dd:REFERENCE}'s 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
VCC pin 6 bypass, ${dd33be72-e19b-47bb-8c97-5f79fc6338dd:REFERENCE}
Line 0 sync driver, open drain
L0 opto pull-up to
+5V, 820 ohm
PLACE: Place ${dd33be72-e19b-47bb-8c97-5f79fc6338dd:REFERENCE} near ${9870f529-44e6-4b20-b7b7-ad6eefe47ea1:REFERENCE} pin 2 with ${51f86269-ea15-4394-96b4-401365e1f3d8:REFERENCE} at its pin 6; ${178e863a-fc0b-474a-a537-37a978202ec6:REFERENCE} from L0 to the +5V entry.
ROUTE: L0 carries about 6 mA pulses into the camera's opto input; keep its return with the trigger line.
4. Exposure output, BNC drive and LED
${2227e749-0a2c-4f93-a597-7a23f0e525e1:REFERENCE} pulls Line 2 up, ${e310c8b3-8386-4c71-bde8-59dd025d7495:REFERENCE} gate 1 squares it into CAM_OUT; ${bb6ecb9c-0931-426d-845e-0c0aab3a6240:REFERENCE} drives the BNC, ${7171eb4e-e966-4be1-9b44-87954c581611:REFERENCE} lights ${be5d977c-6c2a-4581-bd66-d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
${d8715160-be15-46f0-a763-2bd41be97013:REFERENCE} bypasses ${e310c8b3-8386-4c71-bde8-59dd025d7495:REFERENCE}.
L2 pull-up to +3.3V,
1 k
Unit 1: Schmitt buffers, L2 and L1
BNC drive series, 470 ohm
LED series, 680 ohm
Exposure LED, green
L1 pull-up to +3.3V,
4.7 k
Unit 2: Schmitt buffers, L2 and L1
Power unit
VCC pin 5 bypass, ${e310c8b3-8386-4c71-bde8-59dd025d7495:REFERENCE}
PLACE: Place ${e310c8b3-8386-4c71-bde8-59dd025d7495:REFERENCE} between the connector and the BNC side with ${d8715160-be15-46f0-a763-2bd41be97013:REFERENCE} at its pin 5; ${2227e749-0a2c-4f93-a597-7a23f0e525e1:REFERENCE} and ${0eab7050-ae9a-4b12-9155-20dceb5716cb:REFERENCE} at the connector pads; $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
ROUTE: CAM_OUT is the board's exposure reference: route ${bb6ecb9c-0931-426d-845e-0c0aab3a6240:REFERENCE}'s far end to the BNC with a ground return beside it.
5. ESD clamps
${48a9c958-f5c0-40e3-808a-a90231a7600d:REFERENCE} clamps L3 and L0, ${7159ba13-fb07-4faf-92f2-3f1d229d5679:REFERENCE} clamps L2 and L1, both referenced to +5V and GND; each pair's two I/O pins are tied to the node.
ESD array for L3/L0
ESD array for L2/L1
PLACE: Place both arrays right at ${9870f529-44e6-4b20-b7b7-ad6eefe47ea1:REFERENCE}'s pads, before any series part, with the shortest GND return.
ROUTE: Wire the paired I/O pads together on the node itself; no separate track between them.
6. Instrument taps
100 ohm series taps: ${36ae1bf1-62f5-4585-a0a5-cbbeae222810:REFERENCE} on L3, ${642b01e2-3cf0-4087-9e79-7690710e4ee1:REFERENCE} on L0, ${c1c7dcbb-7ba6-4d65-abfe-75ca335b5472:REFERENCE} on L2, ${d801cc5a-56c7-46d3-b83c-08021792d765:REFERENCE} on L1_BUF, ${7ee20496-46fb-424b-933f-80f3d28223df:REFEREN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
100 ohm tap, L3 to L3_INST
100 ohm tap, L0 to L0_INST
100 ohm tap, L2 to L2_INST
100 ohm tap, L1_BUF to L1_INST
100 ohm tap, CAM_OUT to OUT_INST
PLACE: Place the five taps as a row toward the instrument-port side of the block.
ROUTE: INSTRUMENT class to the instrument port; every tapped node has a DC definition (driven or pulled up).
INTERFACES
Must be a 5 V rail: the Line 0 opto drive level (${178e863a-fc0b-474a-a537-37a978202ec6:REFERENCE}) and both ESD clamps' VBUS reference.
Logic rail for ${e310c8b3-8386-4c71-bde8-59dd025d7495:REFERENCE}, ${f2a309ed-c3a7-4688-9fba-6e6298bb60c4:REFERENCE}, ${dd33be72-e19b-47bb-8c97-5f79fc6338dd:REFERENCE} and the L2/L1 pull-ups; always-on if the taps must read before firmware.
Camera pins 5 (opto ground) and 6 (ground) both land here, with the logic and ESD returns.
Conditioned 3.3 V frame trigger from the board's input Schmitt into ${f2a309ed-c3a7-4688-9fba-6e6298bb60c4:REFERENCE} (pin 2).
Conditioned 3.3 V Rsync from the board's input Schmitt into ${dd33be72-e19b-47bb-8c97-5f79fc6338dd:REFERENCE} (pin 2).
Exposure-active output: CAM_OUT through ${bb6ecb9c-0931-426d-845e-0c0aab3a6240:REFERENCE} (470 ohm); the BNC itself is the board's.
100 ohm tap (${642b01e2-3cf0-4087-9e79-7690710e4ee1:REFERENCE}) on L0, camera Line 0 OPTOIN: the sync drive.
100 ohm tap (${d801cc5a-56c7-46d3-b83c-08021792d765:REFERENCE}) on L1_BUF, camera Line 1 OPTOOUT after the Schmitt buffer.
100 ohm tap (${c1c7dcbb-7ba6-4d65-abfe-75ca335b5472:REFERENCE}) on L2, camera Line 2, the open-drain exposure output.
100 ohm tap (${36ae1bf1-62f5-4585-a0a5-cbbeae222810:REFERENCE}) on L3, camera Line 3, the frame trigger.
100 ohm tap (${7ee20496-46fb-424b-933f-80f3d28223df:REFERENCE}) on CAM_OUT, the buffered exposure signal.
INTERNAL NETS
CAM_OUT: Buffered Line 2 (exposure active) from ${e310c8b3-8386-4c71-bde8-59dd025d7495:REFERENCE} 1Y; drives the BNC resistor, the LED resistor and the OUT tap.
L0: Camera pin 2, Line 0 OPTOIN: open-drain ${dd33be72-e19b-47bb-8c97-5f79fc6338dd:REFERENCE} Y, pulled to +5V by ${178e863a-fc0b-474a-a537-37a978202ec6:REFERENCE} (820 ohm), clamped by ${48a9c958-f5c0-40e3-808a-a90231a7600d:REFERENCE}.
L1: Camera pin 4, Line 1 OPTOOUT, pulled up to +3.3V by ${0eab7050-ae9a-4b12-9155-20dceb5716cb:REFERENCE} (4.7 k), into Schmitt 2A, clamped by ${7159ba13-fb07-4faf-92f2-3f1d229d5679:REFERENCE}.
L1_BUF: Schmitt 2Y: buffered Line 1 for the L1_INST tap.
L2: Camera pin 3, Line 2 as open-drain exposure output, pulled up by ${2227e749-0a2c-4f93-a597-7a23f0e525e1:REFERENCE} (1 k), into Schmitt 1A, clamped by ${7159ba13-fb07-4faf-92f2-3f1d229d5679:REFERENCE}.
L3: Camera pin 1, Line 3 GPI trigger, driven by ${f2a309ed-c3a7-4688-9fba-6e6298bb60c4:REFERENCE} through ${e2b2fc18-b9db-4fd9-b2bd-7091a09daaf9:REFERENCE} (220 ohm), clamped by ${48a9c958-f5c0-40e3-808a-a90231a7600d:REFERENCE}.
L3_DRV: ${f2a309ed-c3a7-4688-9fba-6e6298bb60c4:REFERENCE} Y, the trigger drive before the 220 ohm series resistor.
LED_A: LED anode: ${7171eb4e-e966-4be1-9b44-87954c581611:REFERENCE} (680 ohm) from CAM_OUT, so ${be5d977c-6c2a-4581-bd66-db9ce884480f:REFERENCE} lights while exposure is active.
OPERATION
Camera side: ${9870f529-44e6-4b20-b7b7-ad6eefe47ea1:REFERENCE}'s terminal numbers are the camera's Hirose HR10A-7R-6PB pin numbers, wired with the FLIR 1 m flying-lead GPIO cable into
a Phoenix MC 1,5/6-ST-3,5 plug: pin 1 green Line 3 (GPI, trigger), pin 2 black Line 0 (OPTOIN, sync), pin 3 red Line 2 (GPIO, exposure output), pin
4 white Line 1 (OPTOOUT), pin 5 blue opto ground and pin 6 brown ground, both on GND (common-ground wiring).
Trigger path: TRIG_IN -> ${f2a309ed-c3a7-4688-9fba-6e6298bb60c4:REFERENCE} (SN74LVC1G125, ~{OE} pin 1 grounded, so always enabled) -> L3_DRV -> ${e2b2fc18-b9db-4fd9-b2bd-7091a09daaf9:REFERENCE} (220 ohm) -> L3 -> camera
Line 3; camera settings TriggerSelector FrameStart, TriggerSource Line3 RisingEdge. Sync path: SYNC_IN -> ${dd33be72-e19b-47bb-8c97-5f79fc6338dd:REFERENCE} (SN74LVC1G07 open drain) ->
L0, pulled to +5V by ${178e863a-fc0b-474a-a537-37a978202ec6:REFERENCE} (820 ohm): 5 V across 820 ohm is about 6 mA, less by the opto input's forward drop. Both drivers run from +3.3V with
5.5 V-tolerant I/O.
Exposure output: camera Line 2 (LineMode Output, LineSource ExposureActive, V3_3Enable false, so open drain) is pulled up by ${2227e749-0a2c-4f93-a597-7a23f0e525e1:REFERENCE} (1 k) to
+3.3V and squared by Schmitt ${e310c8b3-8386-4c71-bde8-59dd025d7495:REFERENCE} 1A -> 1Y = CAM_OUT, which drives the BNC through ${bb6ecb9c-0931-426d-845e-0c0aab3a6240:REFERENCE} (470 ohm), the green LED ${be5d977c-6c2a-4581-bd66-db9ce884480f:REFERENCE} through
${7171eb4e-e966-4be1-9b44-87954c581611:REFERENCE} (680 ohm: about (3.3 - 2.1) / 680 = 1.8 mA, LED on while exposure is active) and the OUT_INST tap. Line 1 (OPTOOUT, LineSource Off) is
pulled up by ${0eab7050-ae9a-4b12-9155-20dceb5716cb:REFERENCE} (4.7 k) and buffered 2A -> 2Y into L1_BUF for its tap.
ESD: two USBLC6-2P6 arrays with VBUS on +5V clamp L3 and L0 (${48a9c958-f5c0-40e3-808a-a90231a7600d:REFERENCE}) and L2 and L1 (${7159ba13-fb07-4faf-92f2-3f1d229d5679:REFERENCE}), 15 kV IEC 61000-4-2 level 4, at most 3.5
pF per line; both I/O pins of each pair are wired to the node, so the footprint's paired pads need no track between them. +5V must therefore be a 5
V rail: it is the clamp reference and the opto drive level, and feeds nothing else.
Variants (family.json): mcv6_vertical fits ${9870f529-44e6-4b20-b7b7-ad6eefe47ea1:REFERENCE} = OW-CONN-TBH-1X06-3P5-VERT (Phoenix MCV 1,5/6-G-3,5, top entry); mc6_horizontal fits
OW-CONN-1844252 (Phoenix MC 1,5/6-G-3,5, side entry toward the footprint's +Y). The two footprints are pad-identical (six 1.8 x 3.6 mm ovals on
3.5 mm, origin at the pad-array centre), so the variant swaps only the connector's body, courtyard and 3D model; every pad, track and via stays, and
the anchor connector_center is the same point for both.
The placing board provides +3.3V (bind it to the always-on rail when the taps must be observable before firmware runs), a 5 V rail on +5V, the BNC
on CAM_OUT_BNC, the conditioned 3.3 V TRIG_IN and SYNC_IN, and the instrument port behind the five 100 ohm taps; the three pull-ups are inside
because the block owns L0, L1 and L2 (layout convention 10). Place one block per camera; the horizontal variant's plug needs the board edge its wire
exit faces.
DESIGN CONTRACT
One FLIR Blackfly S camera GPIO channel (trigger, sync, exposure output, instrument taps) on a 6-position 3.5 mm Phoenix header; the connector
family pilot: the vertical MCV and the horizontal MC header are pad-identical, so one source publishes both orientations

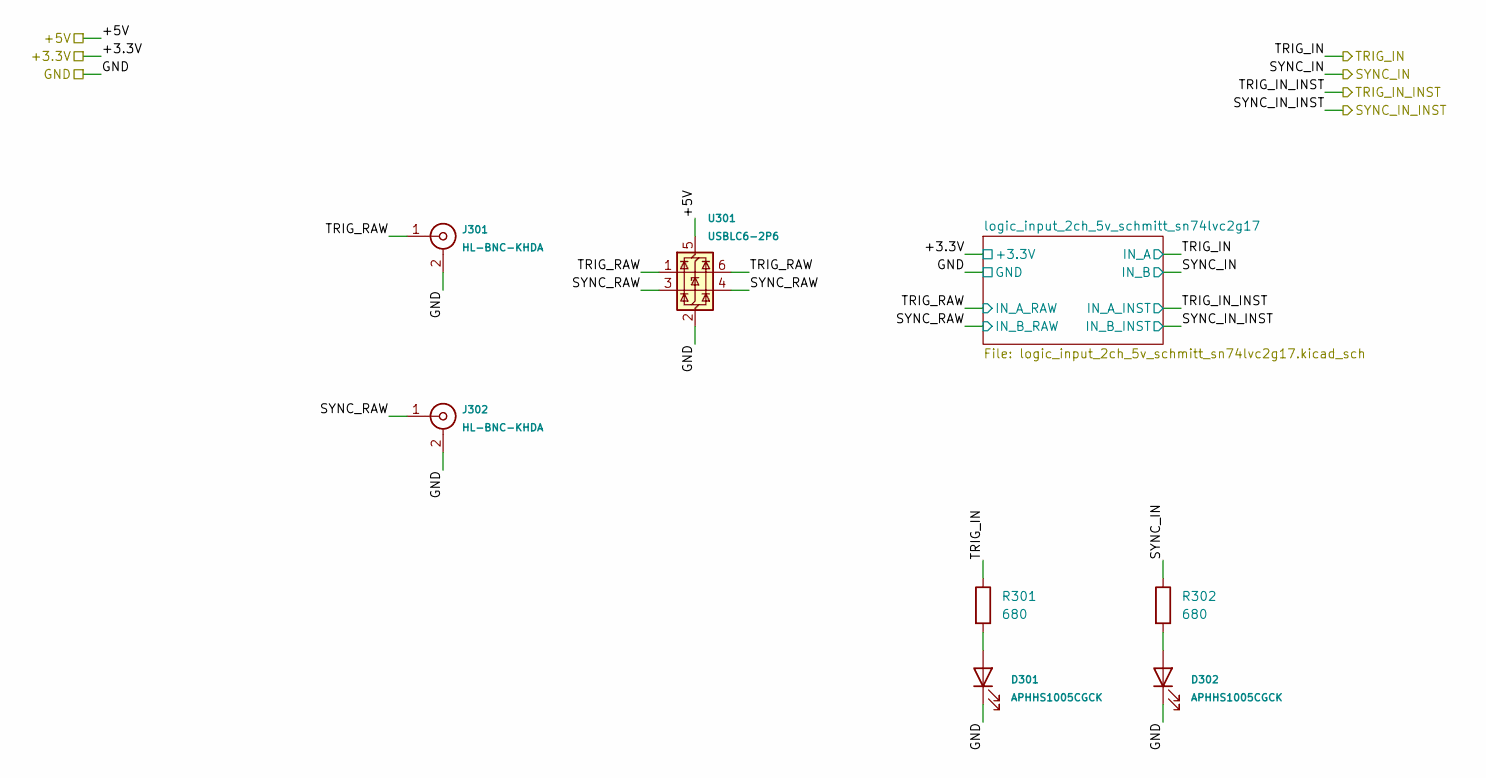
[picture p51: schematic inputs.kicad_sch, camera-gpio-interface-pcb]

Parts:
D301, D302: APHHS1005CGCK; LED_0402-1005_KNB; PartID sym_orb_weaver_misc_led_knb_20ma_grn_2_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
J301, J302: HL-BNC-KHDA; CONN_BNC_HL-BNC-KHDA; PartID sym_orb_weaver_connectors_conn_coaxial_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
R301, R302: 680; R_0402_1005Metric; PartID mpn_rc0402fr_07680rl_0402
U301: USBLC6-2P6; USBLC6-2P6_SOT-666; PartID mpn_usblc6_2p6_sot_666_6

Connections:
/+5V: U301.5 (VBUS); also elsewhere on the board
/GND: D301.1 (K), D302.1 (K), J301.2 (Shield), J302.2 (Shield), U301.2 (GND); also elsewhere on the board
/SYNC_IN: R302.1; also elsewhere on the board
/TRIG_IN: R301.1; also elsewhere on the board
/inputs/SYNC_RAW: J302.1 (Signal), U301.3 (I/O2), U301.4 (I/O2); also elsewhere on the board
/inputs/TRIG_RAW: J301.1 (Signal), U301.1 (I/O1), U301.6 (I/O1); also elsewhere on the board
unnamed: D301.2 (A), R301.2
unnamed: D302.2 (A), R302.2

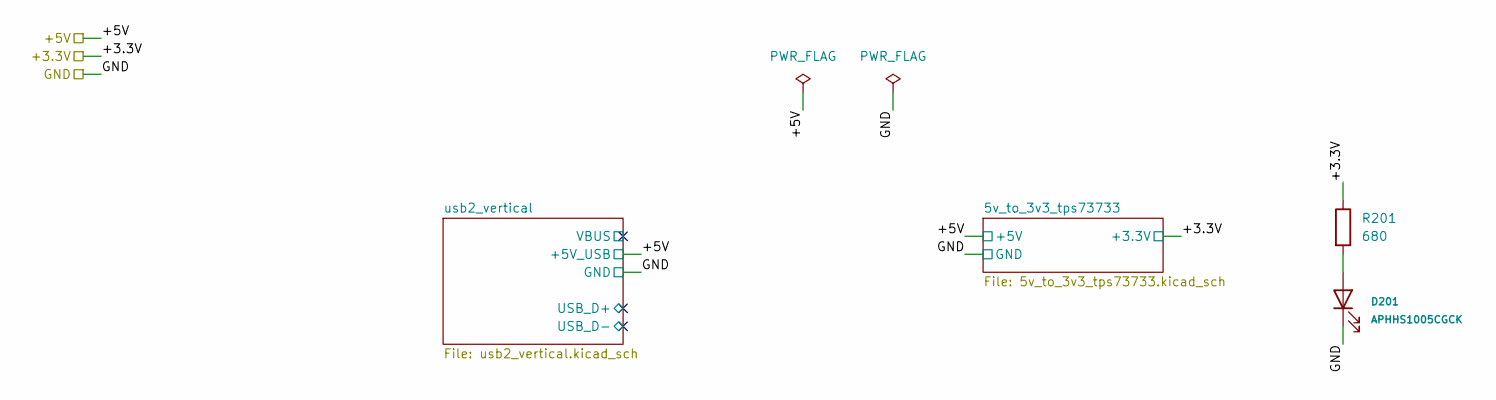
[picture p52: schematic power.kicad_sch, camera-gpio-interface-pcb]

Parts:
D201: APHHS1005CGCK; LED_0402-1005_KNB; PartID sym_orb_weaver_misc_led_knb_20ma_grn_2_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
R201: 680; R_0402_1005Metric; PartID mpn_rc0402fr_07680rl_0402

Connections:
/+3.3V: R201.1; also elsewhere on the board
/GND: D201.1 (K); also elsewhere on the board
unnamed: D201.2 (A), R201.2
