peterpolidoro/camera-gpio-interface-pcb/kicad/camera-gpio-interface-pcb.kicad_pcb

## KiCad design kicad/camera-gpio-interface-pcb.kicad_pcb (continued)

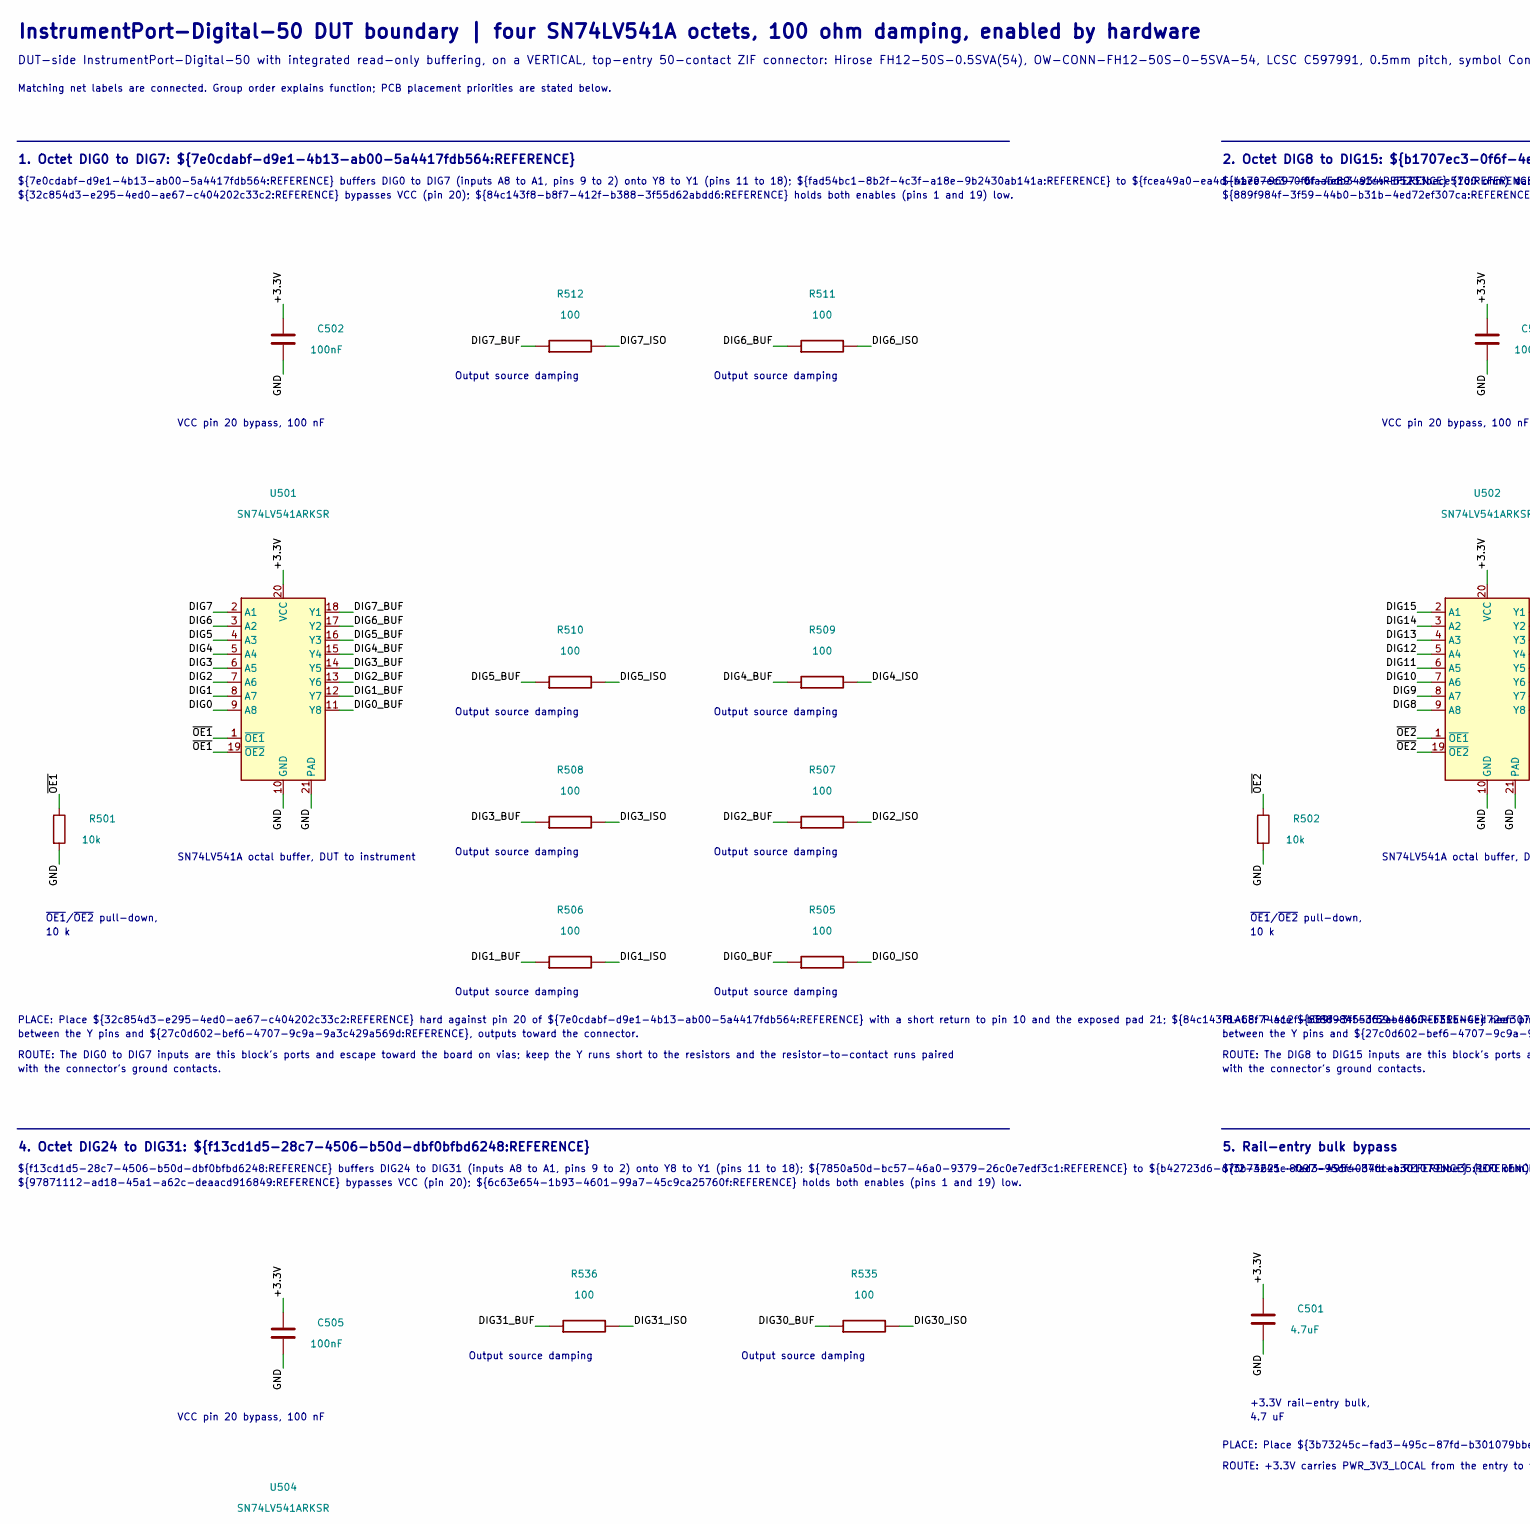
[picture p53: schematic instrument_port_digital_50_dut_ffc_boundary_vertical.kicad_sch, InstrumentPort-Digital-50 DUT boundary, vertical, part in row 1, column 1]

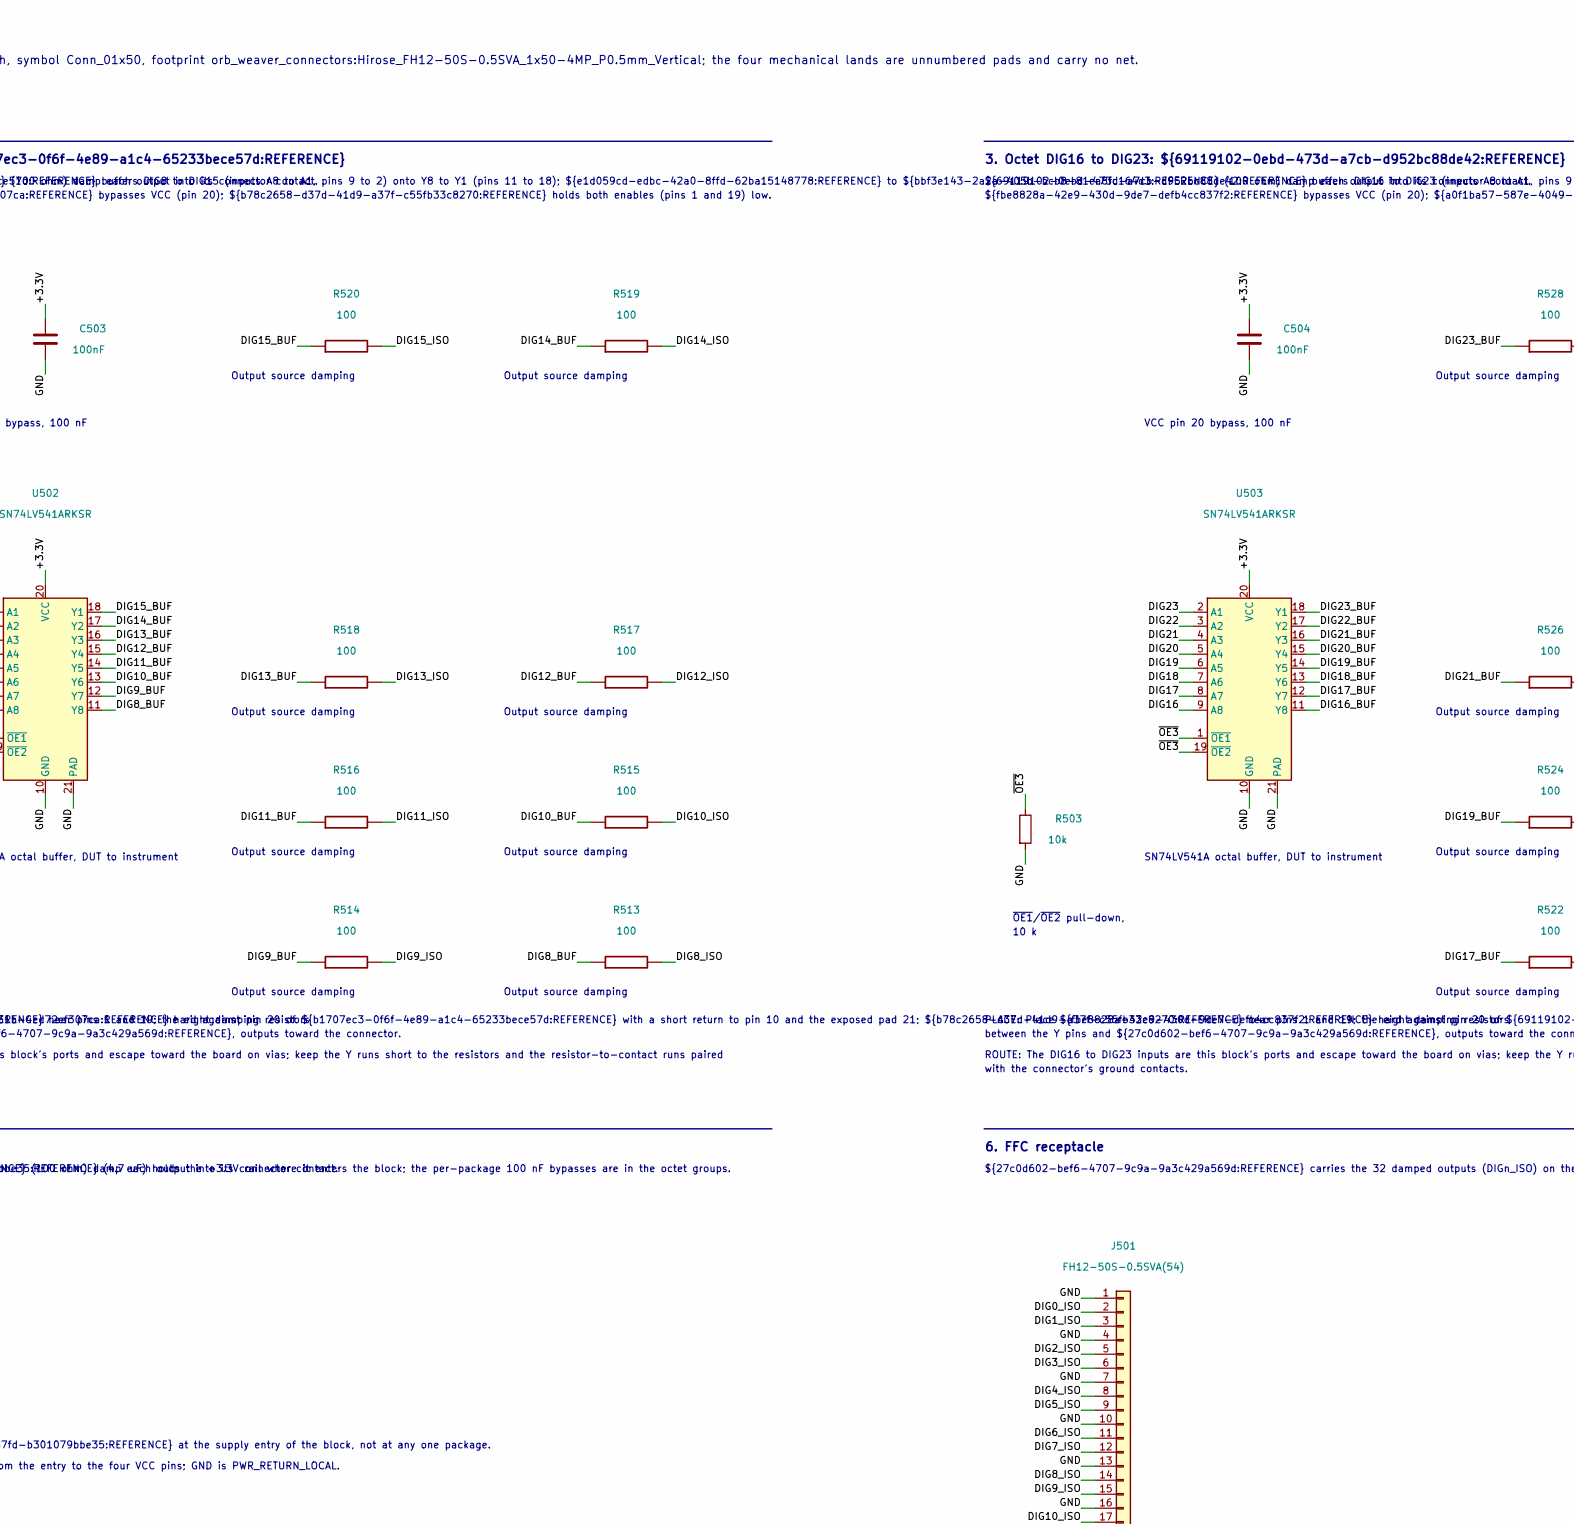
[picture p54: schematic instrument_port_digital_50_dut_ffc_boundary_vertical.kicad_sch, InstrumentPort-Digital-50 DUT boundary, vertical, part in row 1, column 2]

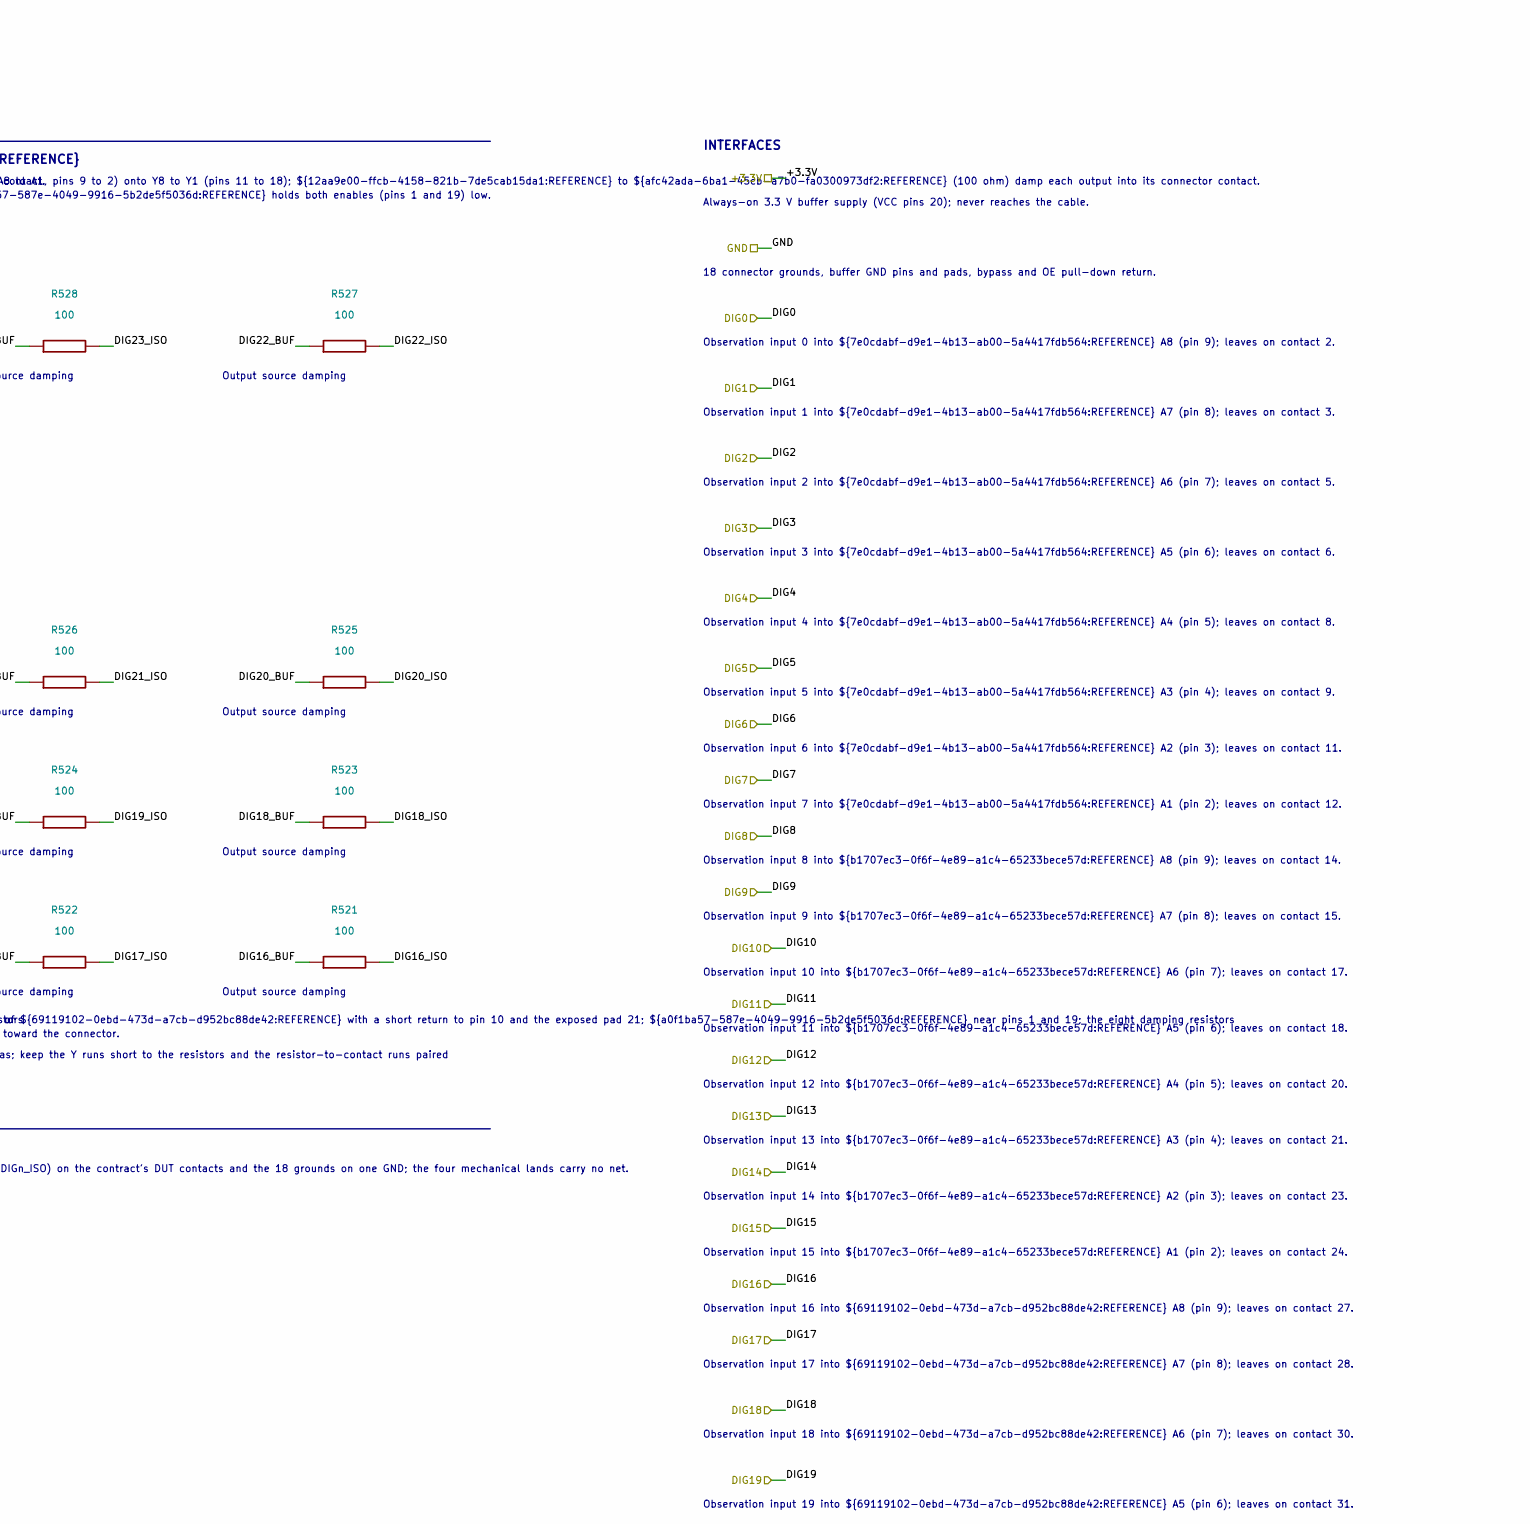
[picture p55: schematic instrument_port_digital_50_dut_ffc_boundary_vertical.kicad_sch, InstrumentPort-Digital-50 DUT boundary, vertical, part in row 1, column 3]

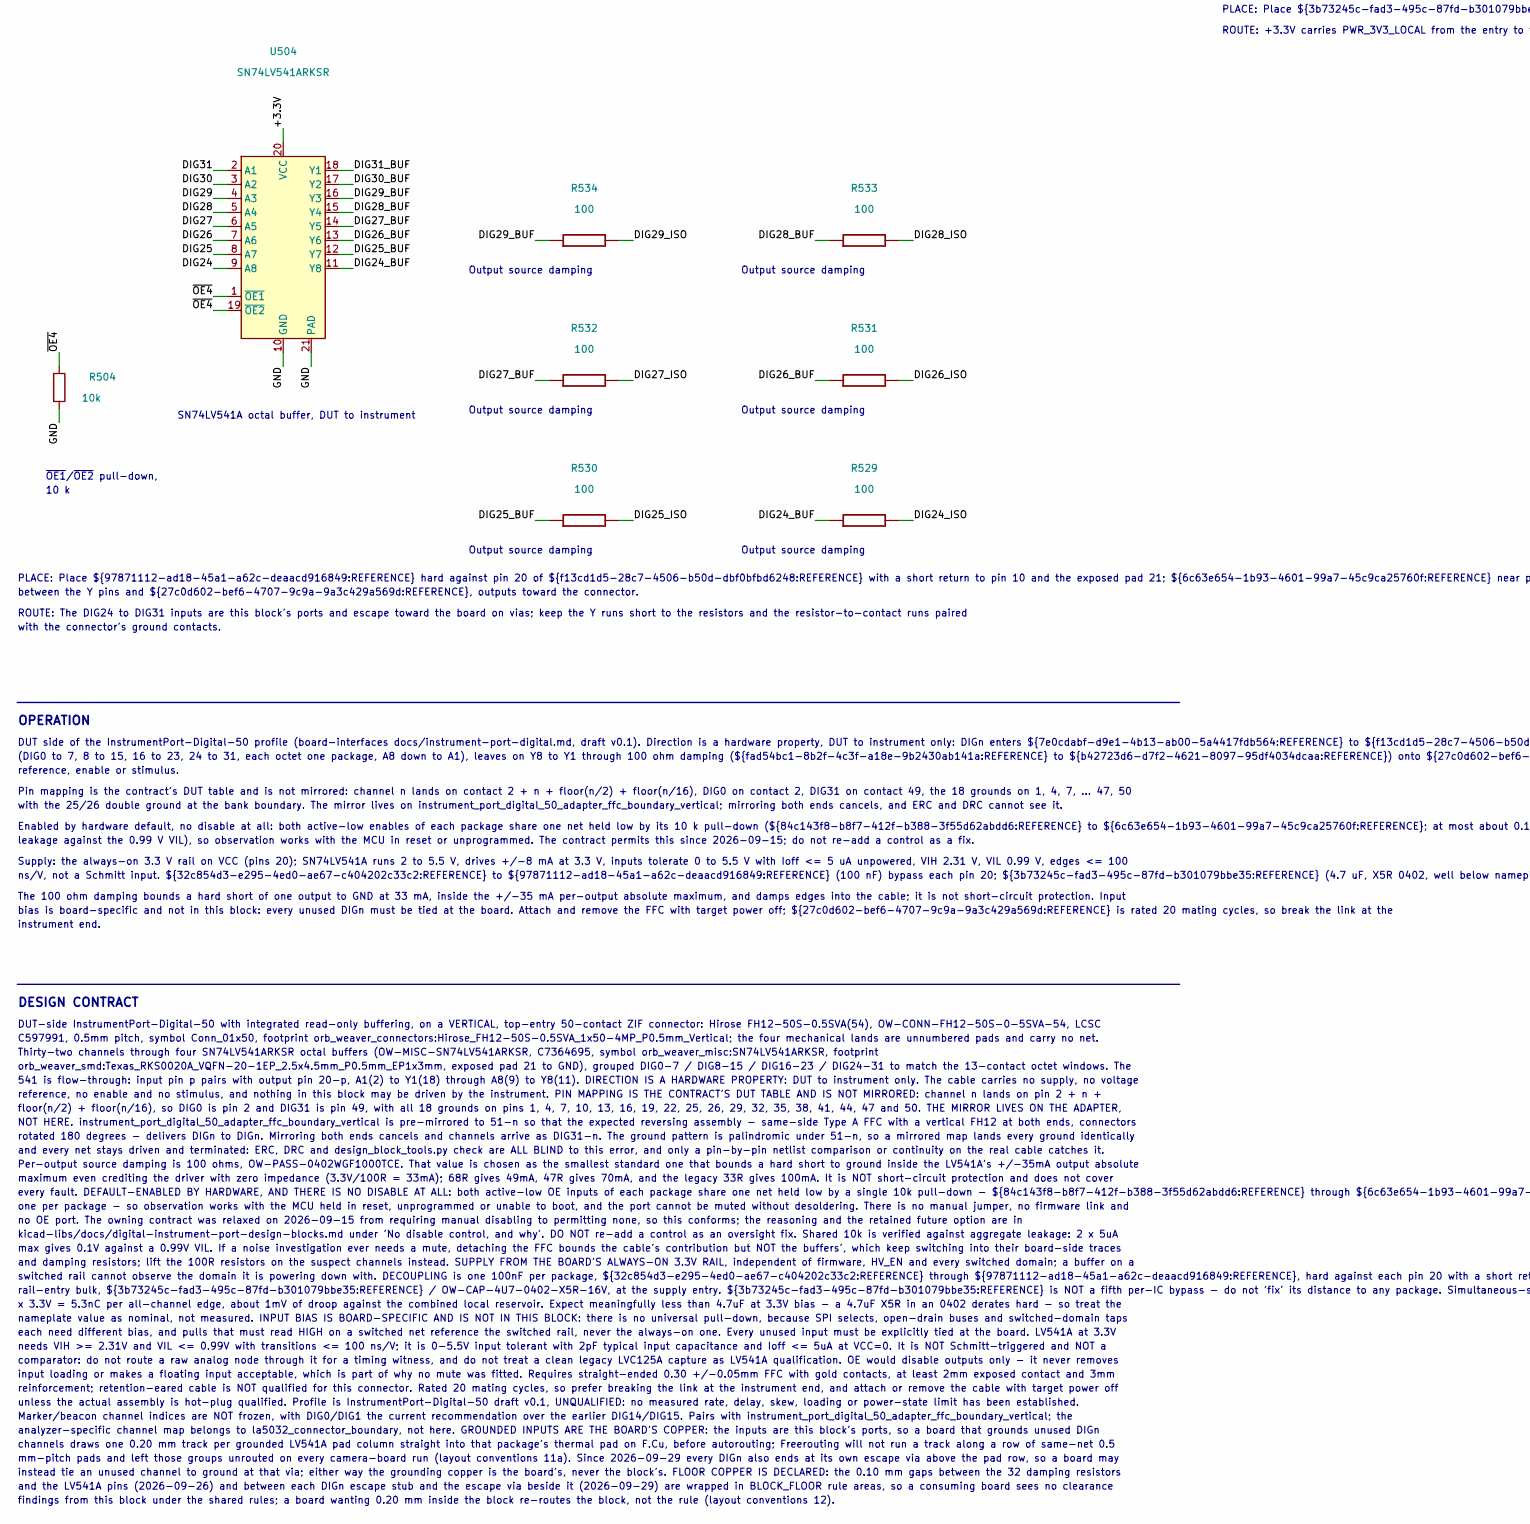
[picture p56: schematic instrument_port_digital_50_dut_ffc_boundary_vertical.kicad_sch, InstrumentPort-Digital-50 DUT boundary, vertical, part in row 2, column 1]

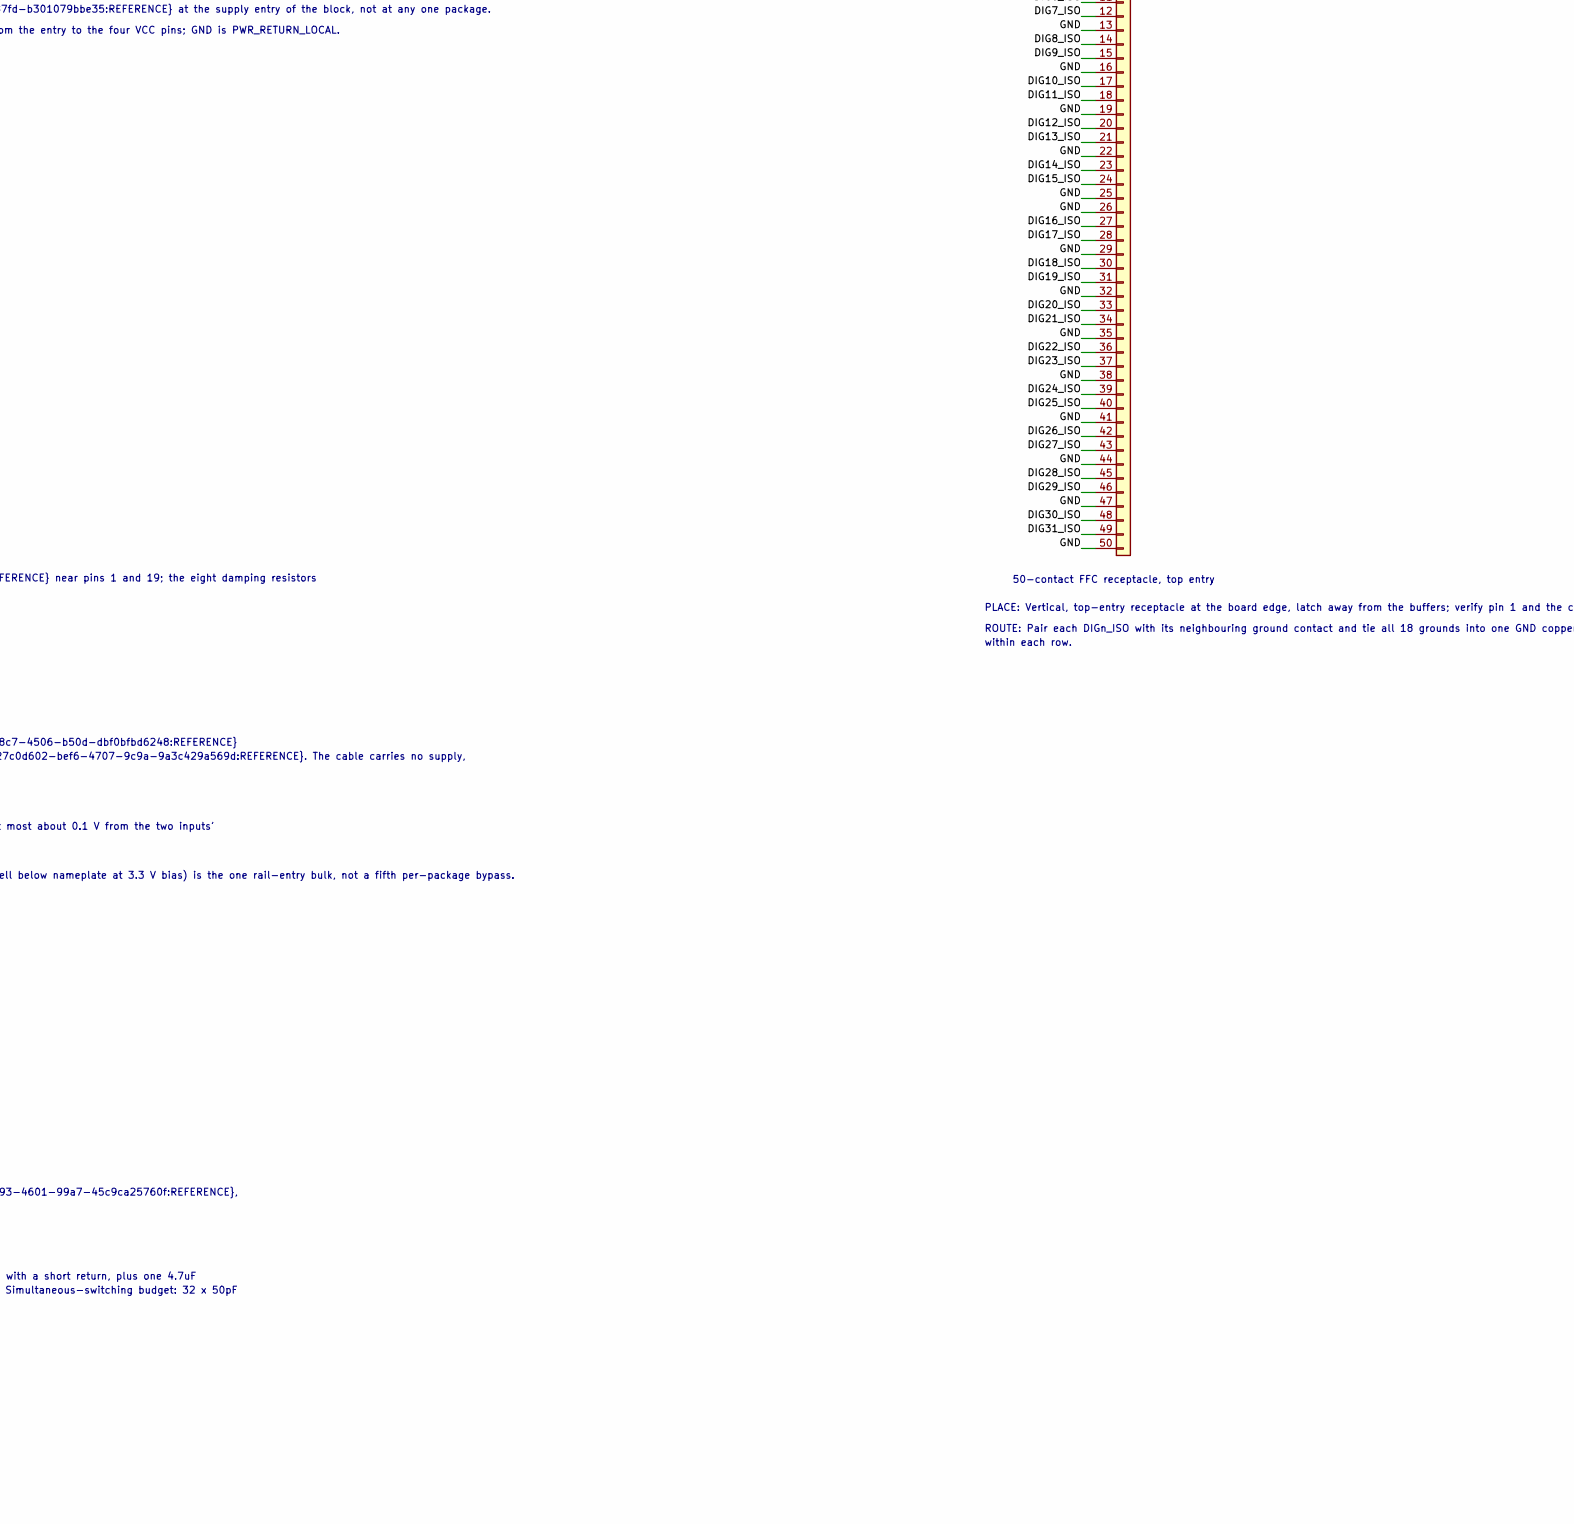
[picture p57: schematic instrument_port_digital_50_dut_ffc_boundary_vertical.kicad_sch, InstrumentPort-Digital-50 DUT boundary, vertical, part in row 2, column 2]

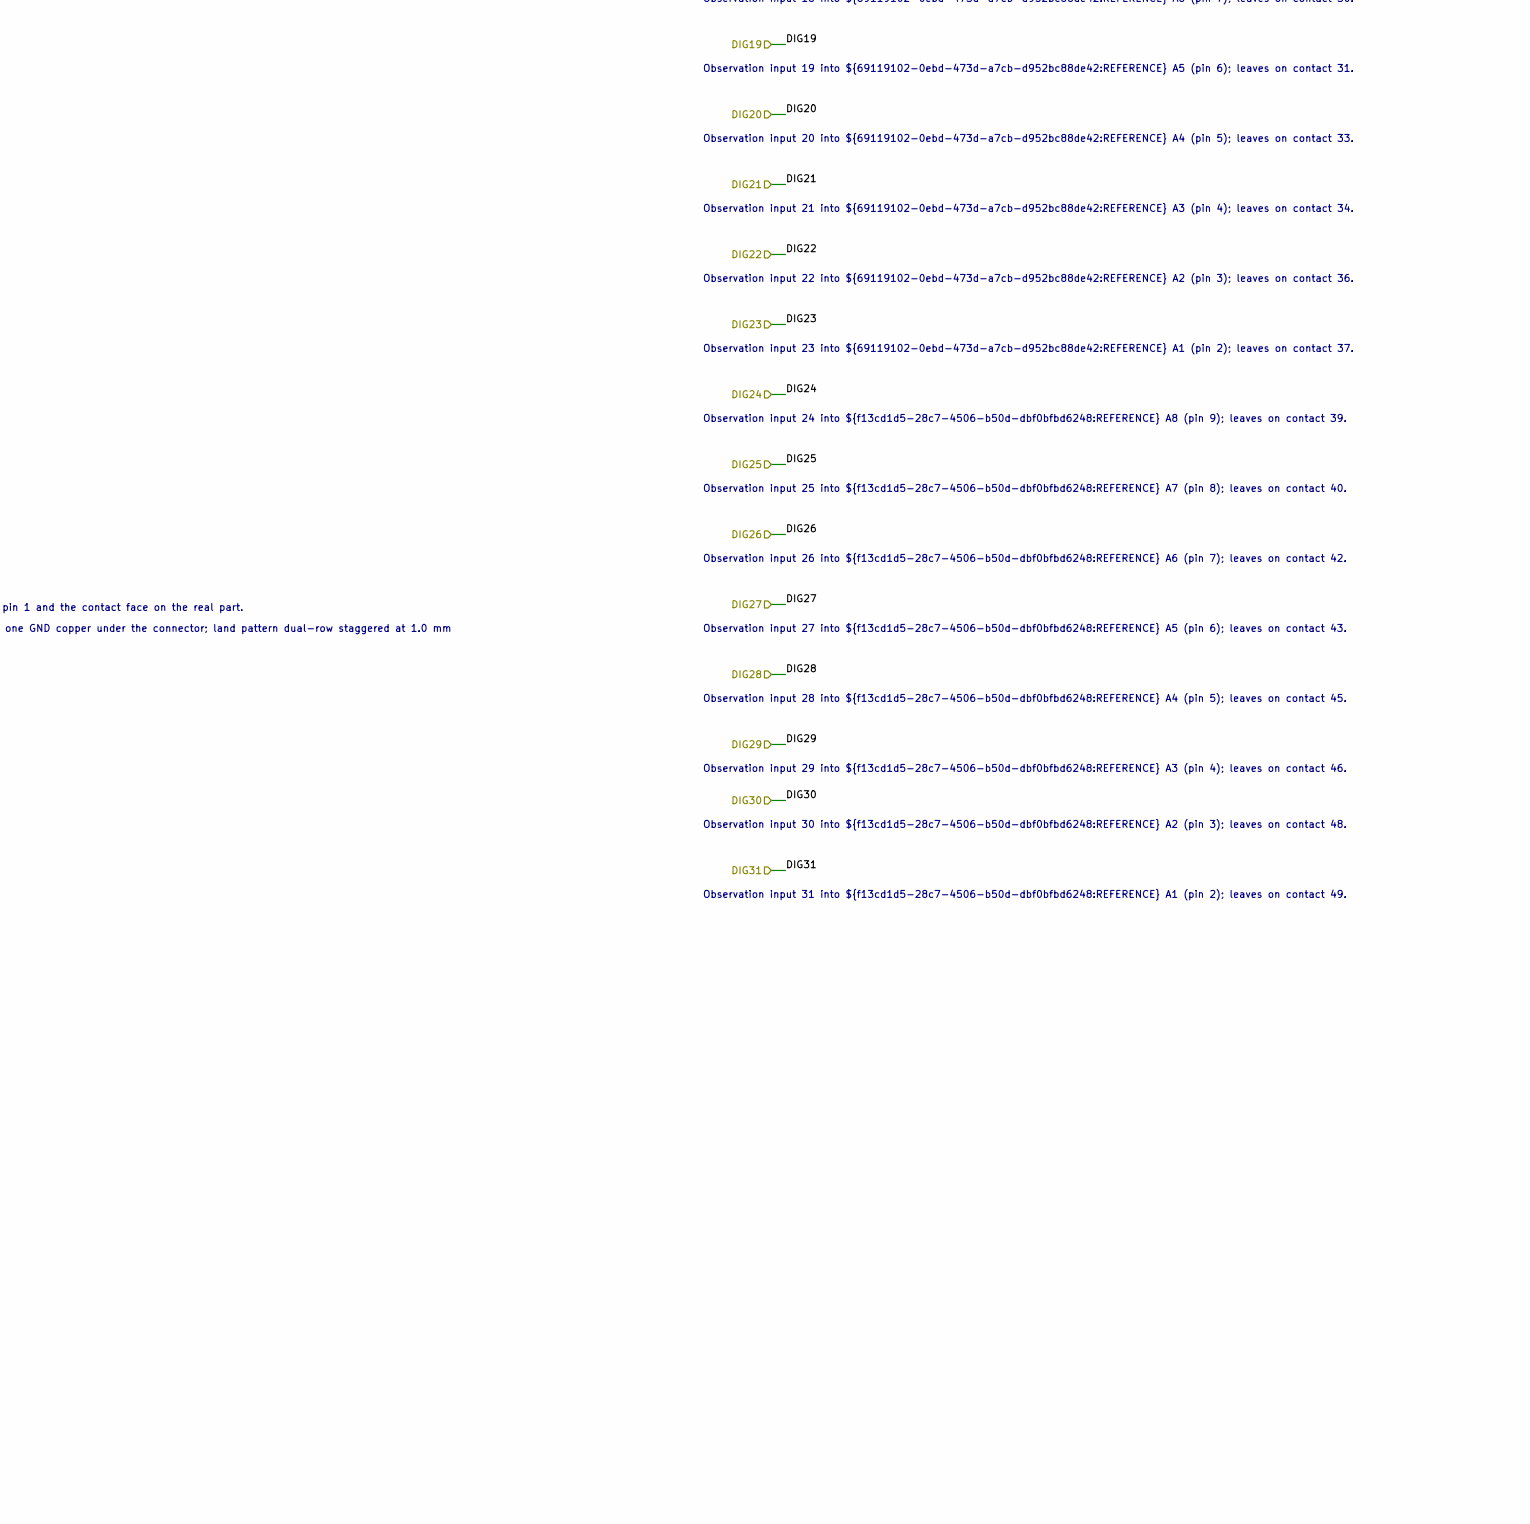
[picture p58: schematic instrument_port_digital_50_dut_ffc_boundary_vertical.kicad_sch, InstrumentPort-Digital-50 DUT boundary, vertical, part in row 2, column 3]

Parts:
C501: 4.7uF; C_0402_1005Metric; PartID sym_orb_weaver_passives_c_4_7uf_25v_0402
C502, C503, C504, C505: 100nF; C_0402_1005Metric; PartID sym_orb_weaver_passives_c_0_1uf_100v_04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
J501: FH12-50S-0.5SVA(54); Hirose_FH12-50S-0.5SVA_1x50-4MP_P0.5mm_Vertical; PartID mpn_fh12_50s_0_5sva_54
R501, R502, R503, R504: 10k; R_0402_1005Metric; PartID sym_orb_weaver_passives_r_10_0k_0402
R505, R506, R507, R508, R509, R510, R511, R512, R513, R514, R515, R516, R517, R518, R519, R520, R521, R522, R523, R524, R525, R526, R527, R528, R529, R530, R531, R532, R533, R534, R535, R536: 100; R_0402_1005Metric; PartID sym_orb_weaver_passives_r_100_0402
U501, U502, U503, U504: SN74LV541ARKSR; Texas_RKS0020A_VQFN-20-1EP_2.5x4.5mm_P0.5mm_EP1x3mm; PartID sym_orb_weaver_misc_sn74lv541arksr

Connections:
/+3.3V: C501.1, C502.1, C503.1, C504.1, C505.1, U501.20 (VCC), U502.20 (VCC), U503.20 (VCC), U504.20 (VCC); also elsewhere on the board
/CAM1_L0_INST: U501.6 (A5); also elsewhere on the board
/CAM1_L1_INST: U501.5 (A4); also elsewhere on the board
/CAM1_L2_INST: U501.4 (A3); also elsewhere on the board
/CAM1_L3_INST: U501.3 (A2); also elsewhere on the board
/CAM1_OUT_INST: U501.2 (A1); also elsewhere on the board
/CAM2_L0_INST: U502.9 (A8); also elsewhere on the board
/CAM2_L1_INST: U502.8 (A7); also elsewhere on the board
/CAM2_L2_INST: U502.7 (A6); also elsewhere on the board
/CAM2_L3_INST: U502.6 (A5); also elsewhere on the board
/CAM2_OUT_INST: U502.5 (A4); also elsewhere on the board
/CAM3_L0_INST: U502.4 (A3); also elsewhere on the board
/CAM3_L1_INST: U502.3 (A2); also elsewhere on the board
/CAM3_L2_INST: U502.2 (A1); also elsewhere on the board
/CAM3_L3_INST: U503.9 (A8); also elsewhere on the board
/CAM3_OUT_INST: U503.8 (A7); also elsewhere on the board
/GND: C501.2, C502.2, C503.2, C504.2, C505.2, J501.1, J501.4, J501.7, J501.10, J501.13, J501.16, J501.19, J501.22, J501.25, J501.26, J501.29, J501.32, J501.35, J501.38, J501.41, J501.44, J501.47, J501.50, R501.2, R502.2, R503.2, R504.2, U501.10 (GND), U501.21 (PAD), U502.10 (GND), U502.21 (PAD), U503.2 (A1), U503.3 (A2), U503.4 (A3), U503.5 (A4), U503.6 (A5), U503.7 (A6), U503.10 (GND), U503.21 (PAD), U504.2 (A1), U504.3 (A2), U504.4 (A3), U504.5 (A4), U504.6 (A5), U504.7 (A6), U504.8 (A7), U504.9 (A8), U504.10 (GND), U504.21 (PAD); also elsewhere on the board
/SYNC_IN_INST: U501.8 (A7); also elsewhere on the board
/SYNC_OUT_INST: U501.7 (A6); also elsewhere on the board
/TRIG_IN_INST: U501.9 (A8); also elsewhere on the board
/instrument_port_digital_50_dut_ffc_boundary_vertical/DIG0_BUF: R505.1, U501.11 (Y8)
/instrument_port_digital_50_dut_ffc_boundary_vertical/DIG0_ISO: J501.2, R505.2
/instrument_port_digital_50_dut_ffc_boundary_vertical/DIG1_BUF: R506.1, U501.12 (Y7)
/instrument_port_digital_50_dut_ffc_boundary_vertical/DIG1_ISO: J501.3, R506.2
/instrument_port_digital_50_dut_ffc_boundary_vertical/DIG2_BUF: R507.1, U501.13 (Y6)
/instrument_port_digital_50_dut_ffc_boundary_vertical/DIG2_ISO: J501.5, R507.2
/instrument_port_digital_50_dut_ffc_boundary_vertical/DIG3_BUF: R508.1, U501.14 (Y5)
/instrument_port_digital_50_dut_ffc_boundary_vertical/DIG3_ISO: J501.6, R508.2
/instrument_port_digital_50_dut_ffc_boundary_vertical/DIG4_BUF: R509.1, U501.15 (Y4)
/instrument_port_digital_50_dut_ffc_boundary_vertical/DIG4_ISO: J501.8, R509.2
/instrument_port_digital_50_dut_ffc_boundary_vertical/DIG5_BUF: R510.1, U501.16 (Y3)
/instrument_port_digital_50_dut_ffc_boundary_vertical/DIG5_ISO: J501.9, R510.2
/instrument_port_digital_50_dut_ffc_boundary_vertical/DIG6_BUF: R511.1, U501.17 (Y2)
/instrument_port_digital_50_dut_ffc_boundary_vertical/DIG6_ISO: J501.11, R511.2
/instrument_port_digital_50_dut_ffc_boundary_vertical/DIG7_BUF: R512.1, U501.18 (Y1)
/instrument_port_digital_50_dut_ffc_boundary_vertical/DIG7_ISO: J501.12, R512.2
/instrument_port_digital_50_dut_ffc_boundary_vertical/DIG8_BUF: R513.1, U502.11 (Y8)
/instrument_port_digital_50_dut_ffc_boundary_vertical/DIG8_ISO: J501.14, R513.2
/instrument_port_digital_50_dut_ffc_boundary_vertical/DIG9_BUF: R514.1, U502.12 (Y7)
/instrument_port_digital_50_dut_ffc_boundary_vertical/DIG9_ISO: J501.15, R514.2
/instrument_port_digital_50_dut_ffc_boundary_vertical/DIG10_BUF: R515.1, U502.13 (Y6)
/instrument_port_digital_50_dut_ffc_boundary_vertical/DIG10_ISO: J501.17, R515.2
/instrument_port_digital_50_dut_ffc_boundary_vertical/DIG11_BUF: R516.1, U502.14 (Y5)
/instrument_port_digital_50_dut_ffc_boundary_vertical/DIG11_ISO: J501.18, R516.2
/instrument_port_digital_50_dut_ffc_boundary_vertical/DIG12_BUF: R517.1, U502.15 (Y4)
/instrument_port_digital_50_dut_ffc_boundary_vertical/DIG12_ISO: J501.20, R517.2
/instrument_port_digital_50_dut_ffc_boundary_vertical/DIG13_BUF: R518.1, U502.16 (Y3)
/instrument_port_digital_50_dut_ffc_boundary_vertical/DIG13_ISO: J501.21, R518.2
/instrument_port_digital_50_dut_ffc_boundary_vertical/DIG14_BUF: R519.1, U502.17 (Y2)
/instrument_port_digital_50_dut_ffc_boundary_vertical/DIG14_ISO: J501.23, R519.2
/instrument_port_digital_50_dut_ffc_boundary_vertical/DIG15_BUF: R520.1, U502.18 (Y1)
/instrument_port_digital_50_dut_ffc_boundary_vertical/DIG15_ISO: J501.24, R520.2
/instrument_port_digital_50_dut_ffc_boundary_vertical/DIG16_BUF: R521.1, U503.11 (Y8)
/instrument_port_digital_50_dut_ffc_boundary_vertical/DIG16_ISO: J501.27, R521.2
/instrument_port_digital_50_dut_ffc_boundary_vertical/DIG17_BUF: R522.1, U503.12 (Y7)
/instrument_port_digital_50_dut_ffc_boundary_vertical/DIG17_ISO: J501.28, R522.2
/instrument_port_digital_50_dut_ffc_boundary_vertical/DIG18_BUF: R523.1, U503.13 (Y6)
/instrument_port_digital_50_dut_ffc_boundary_vertical/DIG18_ISO: J501.30, R523.2
/instrument_port_digital_50_dut_ffc_boundary_vertical/DIG19_BUF: R524.1, U503.14 (Y5)
/instrument_port_digital_50_dut_ffc_boundary_vertical/DIG19_ISO: J501.31, R524.2
/instrument_port_digital_50_dut_ffc_boundary_vertical/DIG20_BUF: R525.1, U503.15 (Y4)
/instrument_port_digital_50_dut_ffc_boundary_vertical/DIG20_ISO: J501.33, R525.2
/instrument_port_digital_50_dut_ffc_boundary_vertical/DIG21_BUF: R526.1, U503.16 (Y3)
/instrument_port_digital_50_dut_ffc_boundary_vertical/DIG21_ISO: J501.34, R526.2
/instrument_port_digital_50_dut_ffc_boundary_vertical/DIG22_BUF: R527.1, U503.17 (Y2)
/instrument_port_digital_50_dut_ffc_boundary_vertical/DIG22_ISO: J501.36, R527.2
/instrument_port_digital_50_dut_ffc_boundary_vertical/DIG23_BUF: R528.1, U503.18 (Y1)
/instrument_port_digital_50_dut_ffc_boundary_vertical/DIG23_ISO: J501.37, R528.2
/instrument_port_digital_50_dut_ffc_boundary_vertical/DIG24_BUF: R529.1, U504.11 (Y8)
/instrument_port_digital_50_dut_ffc_boundary_vertical/DIG24_ISO: J501.39, R529.2
/instrument_port_digital_50_dut_ffc_boundary_vertical/DIG25_BUF: R530.1, U504.12 (Y7)
/instrument_port_digital_50_dut_ffc_boundary_vertical/DIG25_ISO: J501.40, R530.2
/instrument_port_digital_50_dut_ffc_boundary_vertical/DIG26_BUF: R531.1, U504.13 (Y6)
/instrument_port_digital_50_dut_ffc_boundary_vertical/DIG26_ISO: J501.42, R531.2
/instrument_port_digital_50_dut_ffc_boundary_vertical/DIG27_BUF: R532.1, U504.14 (Y5)
/instrument_port_digital_50_dut_ffc_boundary_vertical/DIG27_ISO: J501.43, R532.2
/instrument_port_digital_50_dut_ffc_boundary_vertical/DIG28_BUF: R533.1, U504.15 (Y4)
/instrument_port_digital_50_dut_ffc_boundary_vertical/DIG28_ISO: J501.45, R533.2
/instrument_port_digital_50_dut_ffc_boundary_vertical/DIG29_BUF: R534.1, U504.16 (Y3)
/instrument_port_digital_50_dut_ffc_boundary_vertical/DIG29_ISO: J501.46, R534.2
/instrument_port_digital_50_dut_ffc_boundary_vertical/DIG30_BUF: R535.1, U504.17 (Y2)
/instrument_port_digital_50_dut_ffc_boundary_vertical/DIG30_ISO: J501.48, R535.2
/instrument_port_digital_50_dut_ffc_boundary_vertical/DIG31_BUF: R536.1, U504.18 (Y1)
/instrument_port_digital_50_dut_ffc_boundary_vertical/DIG31_ISO: J501.49, R536.2
/instrument_port_digital_50_dut_ffc_boundary_vertical/~OE1: R501.1, U501.1 (~OE1), U501.19 (~OE2)
/instrument_port_digital_50_dut_ffc_boundary_vertical/~OE2: R502.1, U502.1 (~OE1), U502.19 (~OE2)
/instrument_port_digital_50_dut_ffc_boundary_vertical/~OE3: R503.1, U503.1 (~OE1), U503.19 (~OE2)
/instrument_port_digital_50_dut_ffc_boundary_vertical/~OE4: R504.1, U504.1 (~OE1), U504.19 (~OE2)

Notes on the sheet:
InstrumentPort-Digital-50 DUT boundary | four SN74LV541A octets, 100 ohm damping, enabled by hardware
DUT-side InstrumentPort-Digital-50 with integrated read-only buffering, on a VERTICAL, top-entry 50-contact ZIF connector: Hirose FH12-50S-0.5SVA(54), OW-CONN-FH12-50S-0-5SVA-54, LCSC C597991, 0.5mm pitch, symbol Conn_01x50, footprint orb_weaver_connectors:Hirose_FH12-50S-0.5SVA_1x50-4MP_P0.5mm_Ver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
Matching net labels are connected. Group order explains function; PCB placement priorities are stated below.
1. Octet DIG0 to DIG7: ${7e0cdabf-d9e1-4b13-ab00-5a4417fdb564:REFERENCE}
${7e0cdabf-d9e1-4b13-ab00-5a4417fdb564:REFERENCE} buffers DIG0 to DIG7 (inputs A8 to A1, pins 9 to 2) onto Y8 to Y1 (pins 11 to 18); ${fad54bc1-8b2f-4c3f-a18e-9b2430ab141a:REFERENCE} to ${fcea49a0-ea4d-4aee-9697-0faa5db34934:REFERENCE} (100 ohm) damp each output into its connector contact.
${32c854d3-e295-4ed0-ae67-c404202c33c2:REFERENCE} bypasses VCC (pin 20); ${84c143f8-b8f7-412f-b388-3f55d62abdd6:REFERENCE} holds both enables (pins 1 and 19) low.
VCC pin 20 bypass, 100 nF
Output source damping
SN74LV541A octal buffer, DUT to instrument
~{OE1}/~{OE2} pull-down,
10 k
PLACE: Place ${32c854d3-e295-4ed0-ae67-c404202c33c2:REFERENCE} hard against pin 20 of ${7e0cdabf-d9e1-4b13-ab00-5a4417fdb564:REFERENCE} with a short return to pin 10 and the exposed pad 21; ${84c143f8-b8f7-412f-b388-3f55d62abdd6:REFERENCE} near pins 1 and 19; the eight damping resistors
between the Y pins and ${27c0d602-bef6-4707-9c9a-9a3c429a569d:REFERENCE}, outputs toward the connector.
ROUTE: The DIG0 to DIG7 inputs are this block's ports and escape toward the board on vias; keep the Y runs short to the resistors and the resistor-to-contact runs paired
with the connector's ground contacts.
2. Octet DIG8 to DIG15: ${b1707ec3-0f6f-4e89-a1c4-65233bece57d:REFERENCE}
${b1707ec3-0f6f-4e89-a1c4-65233bece57d:REFERENCE} buffers DIG8 to DIG15 (inputs A8 to A1, pins 9 to 2) onto Y8 to Y1 (pins 11 to 18); ${e1d059cd-edbc-42a0-8ffd-62ba15148778:REFERENCE} to ${bbf3e143-2a2a-405b-bcb8-81ea8fc164d3:REFERENCE} (100 ohm) damp each output into its connector contact.
${889f984f-3f59-44b0-b31b-4ed72ef307ca:REFERENCE} bypasses VCC (pin 20); ${b78c2658-d37d-41d9-a37f-c55fb33c8270:REFERENCE} holds both enables (pins 1 and 19) low.
PLACE: Place ${889f984f-3f59-44b0-b31b-4ed72ef307ca:REFERENCE} hard against pin 20 of ${b1707ec3-0f6f-4e89-a1c4-65233bece57d:REFERENCE} with a short return to pin 10 and the exposed pad 21; ${b78c2658-d37d-41d9-a37f-c55fb33c8270:REFERENCE} near pins 1 and 19; the eight damping resistors
ROUTE: The DIG8 to DIG15 inputs are this block's ports and escape toward the board on vias; keep the Y runs short to the resistors and the resistor-to-contact runs paired
3. Octet DIG16 to DIG23: ${69119102-0ebd-473d-a7cb-d952bc88de42:REFERENCE}
${69119102-0ebd-473d-a7cb-d952bc88de42:REFERENCE} buffers DIG16 to DIG23 (inputs A8 to A1, pins 9 to 2) onto Y8 to Y1 (pins 11 to 18); ${12aa9e00-ffcb-4158-821b-7de5cab15da1:REFERENCE} to ${afc42ada-6ba1-45cb-a7b0-fa0300973df2:REFERENCE} (100 ohm) damp each output into its connector contact.
${fbe8828a-42e9-430d-9de7-defb4cc837f2:REFERENCE} bypasses VCC (pin 20); ${a0f1ba57-587e-4049-9916-5b2de5f5036d:REFERENCE} holds both enables (pins 1 and 19) low.
PLACE: Place ${fbe8828a-42e9-430d-9de7-defb4cc837f2:REFERENCE} hard against pin 20 of ${69119102-0ebd-473d-a7cb-d952bc88de42:REFERENCE} with a short return to pin 10 and the exposed pad 21; ${a0f1ba57-587e-4049-9916-5b2de5f5036d:REFERENCE} near pins 1 and 19; the eight damping resistors
ROUTE: The DIG16 to DIG23 inputs are this block's ports and escape toward the board on vias; keep the Y runs short to the resistors and the resistor-to-contact runs paired
4. Octet DIG24 to DIG31: ${f13cd1d5-28c7-4506-b50d-dbf0bfbd6248:REFERENCE}
${f13cd1d5-28c7-4506-b50d-dbf0bfbd6248:REFERENCE} buffers DIG24 to DIG31 (inputs A8 to A1, pins 9 to 2) onto Y8 to Y1 (pins 11 to 18); ${7850a50d-bc57-46a0-9379-26c0e7edf3c1:REFERENCE} to ${b42723d6-d7f2-4621-8097-95df4034dcaa:REFERENCE} (100 ohm) damp each output into its connector contact.
${97871112-ad18-45a1-a62c-deaacd916849:REFERENCE} bypasses VCC (pin 20); ${6c63e654-1b93-4601-99a7-45c9ca25760f:REFERENCE} holds both enables (pins 1 and 19) low.
PLACE: Place ${97871112-ad18-45a1-a62c-deaacd916849:REFERENCE} hard against pin 20 of ${f13cd1d5-28c7-4506-b50d-dbf0bfbd6248:REFERENCE} with a short return to pin 10 and the exposed pad 21; ${6c63e654-1b93-4601-99a7-45c9ca25760f:REFERENCE} near pins 1 and 19; the eight damping resistors
ROUTE: The DIG24 to DIG31 inputs are this block's ports and escape toward the board on vias; keep the Y runs short to the resistors and the resistor-to-contact runs paired
5. Rail-entry bulk bypass
${3b73245c-fad3-495c-87fd-b301079bbe35:REFERENCE} (4.7 uF) holds the +3.3V rail where it enters the block; the per-package 100 nF bypasses are in the octet groups.
+3.3V rail-entry bulk,
4.7 uF
PLACE: Place ${3b73245c-fad3-495c-87fd-b301079bbe35:REFERENCE} at the supply entry of the block, not at any one package.
ROUTE: +3.3V carries PWR_3V3_LOCAL from the entry to the four VCC pins; GND is PWR_RETURN_LOCAL.
6. FFC receptacle
${27c0d602-bef6-4707-9c9a-9a3c429a569d:REFERENCE} carries the 32 damped outputs (DIGn_ISO) on the contract's DUT contacts and the 18 grounds on one GND; the four mechanical lands carry no net.
50-contact FFC receptacle, top entry
PLACE: Vertical, top-entry receptacle at the board edge, latch away from the buffers; verify pin 1 and the contact face on the real part.
ROUTE: Pair each DIGn_ISO with its neighbouring ground contact and tie all 18 grounds into one GND copper under the connector; land pattern dual-row staggered at 1.0 mm
within each row.
INTERFACES
Always-on 3.3 V buffer supply (VCC pins 20); never reaches the cable.
18 connector grounds, buffer GND pins and pads, bypass and OE pull-down return.
Observation input 0 into ${7e0cdabf-d9e1-4b13-ab00-5a4417fdb564:REFERENCE} A8 (pin 9); leaves on contact 2.
Observation input 1 into ${7e0cdabf-d9e1-4b13-ab00-5a4417fdb564:REFERENCE} A7 (pin 8); leaves on contact 3.
Observation input 2 into ${7e0cdabf-d9e1-4b13-ab00-5a4417fdb564:REFERENCE} A6 (pin 7); leaves on contact 5.
Observation input 3 into ${7e0cdabf-d9e1-4b13-ab00-5a4417fdb564:REFERENCE} A5 (pin 6); leaves on contact 6.
Observation input 4 into ${7e0cdabf-d9e1-4b13-ab00-5a4417fdb564:REFERENCE} A4 (pin 5); leaves on contact 8.
Observation input 5 into ${7e0cdabf-d9e1-4b13-ab00-5a4417fdb564:REFERENCE} A3 (pin 4); leaves on contact 9.
Observation input 6 into ${7e0cdabf-d9e1-4b13-ab00-5a4417fdb564:REFERENCE} A2 (pin 3); leaves on contact 11.
Observation input 7 into ${7e0cdabf-d9e1-4b13-ab00-5a4417fdb564:REFERENCE} A1 (pin 2); leaves on contact 12.
Observation input 8 into ${b1707ec3-0f6f-4e89-a1c4-65233bece57d:REFERENCE} A8 (pin 9); leaves on contact 14.
Observation input 9 into ${b1707ec3-0f6f-4e89-a1c4-65233bece57d:REFERENCE} A7 (pin 8); leaves on contact 15.
Observation input 10 into ${b1707ec3-0f6f-4e89-a1c4-65233bece57d:REFERENCE} A6 (pin 7); leaves on contact 17.
Observation input 11 into ${b1707ec3-0f6f-4e89-a1c4-65233bece57d:REFERENCE} A5 (pin 6); leaves on contact 18.
Observation input 12 into ${b1707ec3-0f6f-4e89-a1c4-65233bece57d:REFERENCE} A4 (pin 5); leaves on contact 20.
Observation input 13 into ${b1707ec3-0f6f-4e89-a1c4-65233bece57d:REFERENCE} A3 (pin 4); leaves on contact 21.
Observation input 14 into ${b1707ec3-0f6f-4e89-a1c4-65233bece57d:REFERENCE} A2 (pin 3); leaves on contact 23.
Observation input 15 into ${b1707ec3-0f6f-4e89-a1c4-65233bece57d:REFERENCE} A1 (pin 2); leaves on contact 24.
Observation input 16 into ${69119102-0ebd-473d-a7cb-d952bc88de42:REFERENCE} A8 (pin 9); leaves on contact 27.
Observation input 17 into ${69119102-0ebd-473d-a7cb-d952bc88de42:REFERENCE} A7 (pin 8); leaves on contact 28.
Observation input 18 into ${69119102-0ebd-473d-a7cb-d952bc88de42:REFERENCE} A6 (pin 7); leaves on contact 30.
Observation input 19 into ${69119102-0ebd-473d-a7cb-d952bc88de42:REFERENCE} A5 (pin 6); leaves on contact 31.
Observation input 20 into ${69119102-0ebd-473d-a7cb-d952bc88de42:REFERENCE} A4 (pin 5); leaves on contact 33.
Observation input 21 into ${69119102-0ebd-473d-a7cb-d952bc88de42:REFERENCE} A3 (pin 4); leaves on contact 34.
Observation input 22 into ${69119102-0ebd-473d-a7cb-d952bc88de42:REFERENCE} A2 (pin 3); leaves on contact 36.
Observation input 23 into ${69119102-0ebd-473d-a7cb-d952bc88de42:REFERENCE} A1 (pin 2); leaves on contact 37.
Observation input 24 into ${f13cd1d5-28c7-4506-b50d-dbf0bfbd6248:REFERENCE} A8 (pin 9); leaves on contact 39.
Observation input 25 into ${f13cd1d5-28c7-4506-b50d-dbf0bfbd6248:REFERENCE} A7 (pin 8); leaves on contact 40.
Observation input 26 into ${f13cd1d5-28c7-4506-b50d-dbf0bfbd6248:REFERENCE} A6 (pin 7); leaves on contact 42.
Observation input 27 into ${f13cd1d5-28c7-4506-b50d-dbf0bfbd6248:REFERENCE} A5 (pin 6); leaves on contact 43.
Observation input 28 into ${f13cd1d5-28c7-4506-b50d-dbf0bfbd6248:REFERENCE} A4 (pin 5); leaves on contact 45.
Observation input 29 into ${f13cd1d5-28c7-4506-b50d-dbf0bfbd6248:REFERENCE} A3 (pin 4); leaves on contact 46.
Observation input 30 into ${f13cd1d5-28c7-4506-b50d-dbf0bfbd6248:REFERENCE} A2 (pin 3); leaves on contact 48.
Observation input 31 into ${f13cd1d5-28c7-4506-b50d-dbf0bfbd6248:REFERENCE} A1 (pin 2); leaves on contact 49.
OPERATION
DUT side of the InstrumentPort-Digital-50 profile (board-interfaces docs/instrument-port-digital.md, draft v0.1). Direction is a hardware property, DUT to instrument only: DIGn enters ${7e0cdabf-d9e1-4b13-ab00-5a4417fdb564:REFERENCE} to ${f13cd1d5-28c7-4506-b50d-dbf0bfbd6248:REFERENCE}
(DIG0 to 7, 8 to 15, 16 to 23, 24 to 31, each octet one package, A8 down to A1), leaves on Y8 to Y1 through 100 ohm damping (${fad54bc1-8b2f-4c3f-a18e-9b2430ab141a:REFERENCE} to ${b42723d6-d7f2-4621-8097-95df4034dcaa:REFERENCE}) onto ${27c0d602-bef6-4707-9c9a-9a3c429a569d:REFERENCE}. The cable carr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
reference, enable or stimulus.
Pin mapping is the contract's DUT table and is not mirrored: channel n lands on contact 2 + n + floor(n/2) + floor(n/16), DIG0 on contact 2, DIG31 on contact 49, the 18 grounds on 1, 4, 7, ... 47, 50
with the 25/26 double ground at the bank boundary. The mirror lives on instrument_port_digital_50_adapter_ffc_boundary_vertical; mirroring both ends cancels, and ERC and DRC cannot see it.
Enabled by hardware default, no disable at all: both active-low enables of each package share one net held low by its 10 k pull-down (${84c143f8-b8f7-412f-b388-3f55d62abdd6:REFERENCE} to ${6c63e654-1b93-4601-99a7-45c9ca25760f:REFERENCE}; at most about 0.1 V from the two inputs'
leakage against the 0.99 V VIL), so observation works with the MCU in reset or unprogrammed. The contract permits this since 2026-09-15; do not re-add a control as a fix.
Supply: the always-on 3.3 V rail on VCC (pins 20); SN74LV541A runs 2 to 5.5 V, drives +/-8 mA at 3.3 V, inputs tolerate 0 to 5.5 V with Ioff <= 5 uA unpowered, VIH 2.31 V, VIL 0.99 V, edges <= 100
ns/V, not a Schmitt input. ${32c854d3-e295-4ed0-ae67-c404202c33c2:REFERENCE} to ${97871112-ad18-45a1-a62c-deaacd916849:REFERENCE} (100 nF) bypass each pin 20; ${3b73245c-fad3-495c-87fd-b301079bbe35:REFERENCE} (4.7 uF, X5R 0402, well below nameplate at 3.3 V bias) is the one rail-entry bulk, not a f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
The 100 ohm damping bounds a hard short of one output to GND at 33 mA, inside the +/-35 mA per-output absolute maximum, and damps edges into the cable; it is not short-circuit protection. Input
bias is board-specific and not in this block: every unused DIGn must be tied at the board. Attach and remove the FFC with target power off; ${27c0d602-bef6-4707-9c9a-9a3c429a569d:REFERENCE} is rated 20 mating cycles, so break the link at the
instrument end.
DESIGN CONTRACT
DUT-side InstrumentPort-Digital-50 with integrated read-only buffering, on a VERTICAL, top-entry 50-contact ZIF connector: Hirose FH12-50S-0.5SVA(54), OW-CONN-FH12-50S-0-5SVA-54, LCSC
C597991, 0.5mm pitch, symbol Conn_01x50, footprint orb_weaver_connectors:Hirose_FH12-50S-0.5SVA_1x50-4MP_P0.5mm_Vertical; the four mechanical lands are unnumbered pads and carry no net.
Thirty-two channels through four SN74LV541ARKSR octal buffers (OW-MISC-SN74LV541ARKSR, C7364695, symbol orb_weaver_misc:SN74LV541ARKSR, footprint
orb_weaver_smd:Texas_RKS0020A_VQFN-20-1EP_2.5x4.5mm_P0.5mm_EP1x3mm, exposed pad 21 to GND), grouped DIG0-7 / DIG8-15 / DIG16-23 / DIG24-31 to match the 13-contact octet windows. The
541 is flow-through: input pin p pairs with output pin 20-p, A1(2) to Y1(18) through A8(9) to Y8(11). DIRECTION IS A HARDWARE PROPERTY: DUT to instrument only. The cable carries no supply, no voltage
reference, no enable and no stimulus, and nothing in this block may be driven by the instrument. PIN MAPPING IS THE CONTRACT'S DUT TABLE AND IS NOT MIRRORED: channel n lands on pin 2 + n +
floor(n/2) + floor(n/16), so DIG0 is pin 2 and DIG31 is pin 49, with all 18 grounds on pins 1, 4, 7, 10, 13, 16, 19, 22, 25, 26, 29, 32, 35, 38, 41, 44, 47 and 50. THE MIRROR LIVES ON THE ADAPTER,
NOT HERE. instrument_port_digital_50_adapter_ffc_boundary_vertical is pre-mirrored to 51-n so that the expected reversing assembly - same-side Type A FFC with a vertical FH12 at both ends, connectors
rotated 180 degrees - delivers DIGn to DIGn. Mirroring both ends cancels and channels arrive as DIG31-n. The ground pattern is palindromic under 51-n, so a mirrored map lands every ground identically
and every net stays driven and terminated: ERC, DRC and design_block_tools.py check are ALL BLIND to this error, and only a pin-by-pin netlist comparison or continuity on the real cable catches it.
Per-output source damping is 100 ohms, OW-PASS-0402WGF1000TCE. That value is chosen as the smallest standard one that bounds a hard short to ground inside the LV541A's +/-35mA output absolute
maximum even crediting the driver with zero impedance (3.3V/100R = 33mA); 68R gives 49mA, 47R gives 70mA, and the legacy 33R gives 100mA. It is NOT short-circuit protection and does not cover
every fault. DEFAULT-ENABLED BY HARDWARE, AND THERE IS NO DISABLE AT ALL: both active-low OE inputs of each package share one net held low by a single 10k pull-down - ${84c143f8-b8f7-412f-b388-3f55d62abdd6:REFERENCE} through ${6c63e654-1b93-4601-99a7-45c9ca25760f:REFERENCE},
one per package - so observation works with the MCU held in reset, unprogrammed or unable to boot, and the port cannot be muted without desoldering. There is no manual jumper, no firmware link and
no OE port. The owning contract was relaxed on 2026-09-15 from requiring manual disabling to permitting none, so this conforms; the reasoning and the retained future option are in
kicad-libs/docs/digital-instrument-port-design-blocks.md under 'No disable control, and why'. DO NOT re-add a control as an oversight fix. Shared 10k is verified against aggregate leakage: 2 x 5uA
max gives 0.1V against a 0.99V VIL. If a noise investigation ever needs a mute, detaching the FFC bounds the cable's contribution but NOT the buffers', which keep switching into their board-side traces
and damping resistors; lift the 100R resistors on the suspect channels instead. SUPPLY FROM THE BOARD'S ALWAYS-ON 3.3V RAIL, independent of firmware, HV_EN and every switched domain; a buffer on a
switched rail cannot observe the domain it is powering down with. DECOUPLING is one 100nF per package, ${32c854d3-e295-4ed0-ae67-c404202c33c2:REFERENCE} through ${97871112-ad18-45a1-a62c-deaacd916849:REFERENCE}, hard against each pin 20 with a short return, plus one 4.7uF
rail-entry bulk, ${3b73245c-fad3-495c-87fd-b301079bbe35:REFERENCE} / OW-CAP-4U7-0402-X5R-16V, at the supply entry. ${3b73245c-fad3-495c-87fd-b301079bbe35:REFERENCE} is NOT a fifth per-IC bypass - do not 'fix' its distance to any package. Simultaneous-switching budget: 32 x 50pF
x 3.3V = 5.3nC per all-channel edge, about 1mV of droop against the combined local reservoir. Expect meaningfully less than 4.7uF at 3.3V bias - a 4.7uF X5R in an 0402 derates hard - so treat the
nameplate value as nominal, not measured. INPUT BIAS IS BOARD-SPECIFIC AND IS NOT IN THIS BLOCK: there is no universal pull-down, because SPI selects, open-drain buses and switched-domain taps
each need different bias, and pulls that must read HIGH on a switched net reference the switched rail, never the always-on one. Every unused input must be explicitly tied at the board. LV541A at 3.3V
needs VIH >= 2.31V and VIL <= 0.99V with transitions <= 100 ns/V; it is 0-5.5V input tolerant with 2pF typical input capacitance and Ioff <= 5uA at VCC=0. It is NOT Schmitt-triggered and NOT a
comparator: do not route a raw analog node through it for a timing witness, and do not treat a clean legacy LVC125A capture as LV541A qualification. OE would disable outputs only - it never removes
input loading or makes a floating input acceptable, which is part of why no mute was fitted. Requires straight-ended 0.30 +/-0.05mm FFC with gold contacts, at least 2mm exposed contact and 3mm
reinforcement; retention-eared cable is NOT qualified for this connector. Rated 20 mating cycles, so prefer breaking the link at the instrument end, and attach or remove the cable with target power off
unless the actual assembly is hot-plug qualified. Profile is InstrumentPort-Digital-50 draft v0.1, UNQUALIFIED: no measured rate, delay, skew, loading or power-state limit has been established.
Marker/beacon channel indices are NOT frozen, with DIG0/DIG1 the current recommendation over the earlier DIG14/DIG15. Pairs with instrument_port_digital_50_adapter_ffc_boundary_vertical; the
analyzer-specific channel map belongs to la5032_connector_boundary, not here. GROUNDED INPUTS ARE THE BOARD'S COPPER: the inputs are this block's ports, so a board that grounds unused DIGn
channels draws one 0.20 mm track per grounded LV541A pad column straight into that package's thermal pad on F.Cu, before autorouting; Freerouting will not run a track along a row of same-net 0.5
mm-pitch pads and left those groups unrouted on every camera-board run (layout conventions 11a). Since 2026-09-29 every DIGn also ends at its own escape via above the pad row, so a board may
instead tie an unused channel to ground at that via; either way the grounding copper is the board's, never the block's. FLOOR COPPER IS DECLARED: the 0.10 mm gaps between the 32 damping resistors
and the LV541A pins (2026-09-26) and between each DIGn escape stub and the escape via beside it (2026-09-29) are wrapped in BLOCK_FLOOR rule areas, so a consuming board sees no clearance
findings from this block under the shared rules; a board wanting 0.20 mm inside the block re-routes the block, not the rule (layout conventions 12).
