peterpolidoro/camera-gpio-interface-pcb/kicad/camera-gpio-interface-pcb.kicad_pcb

## KiCad design kicad/camera-gpio-interface-pcb.kicad_pcb (continued)

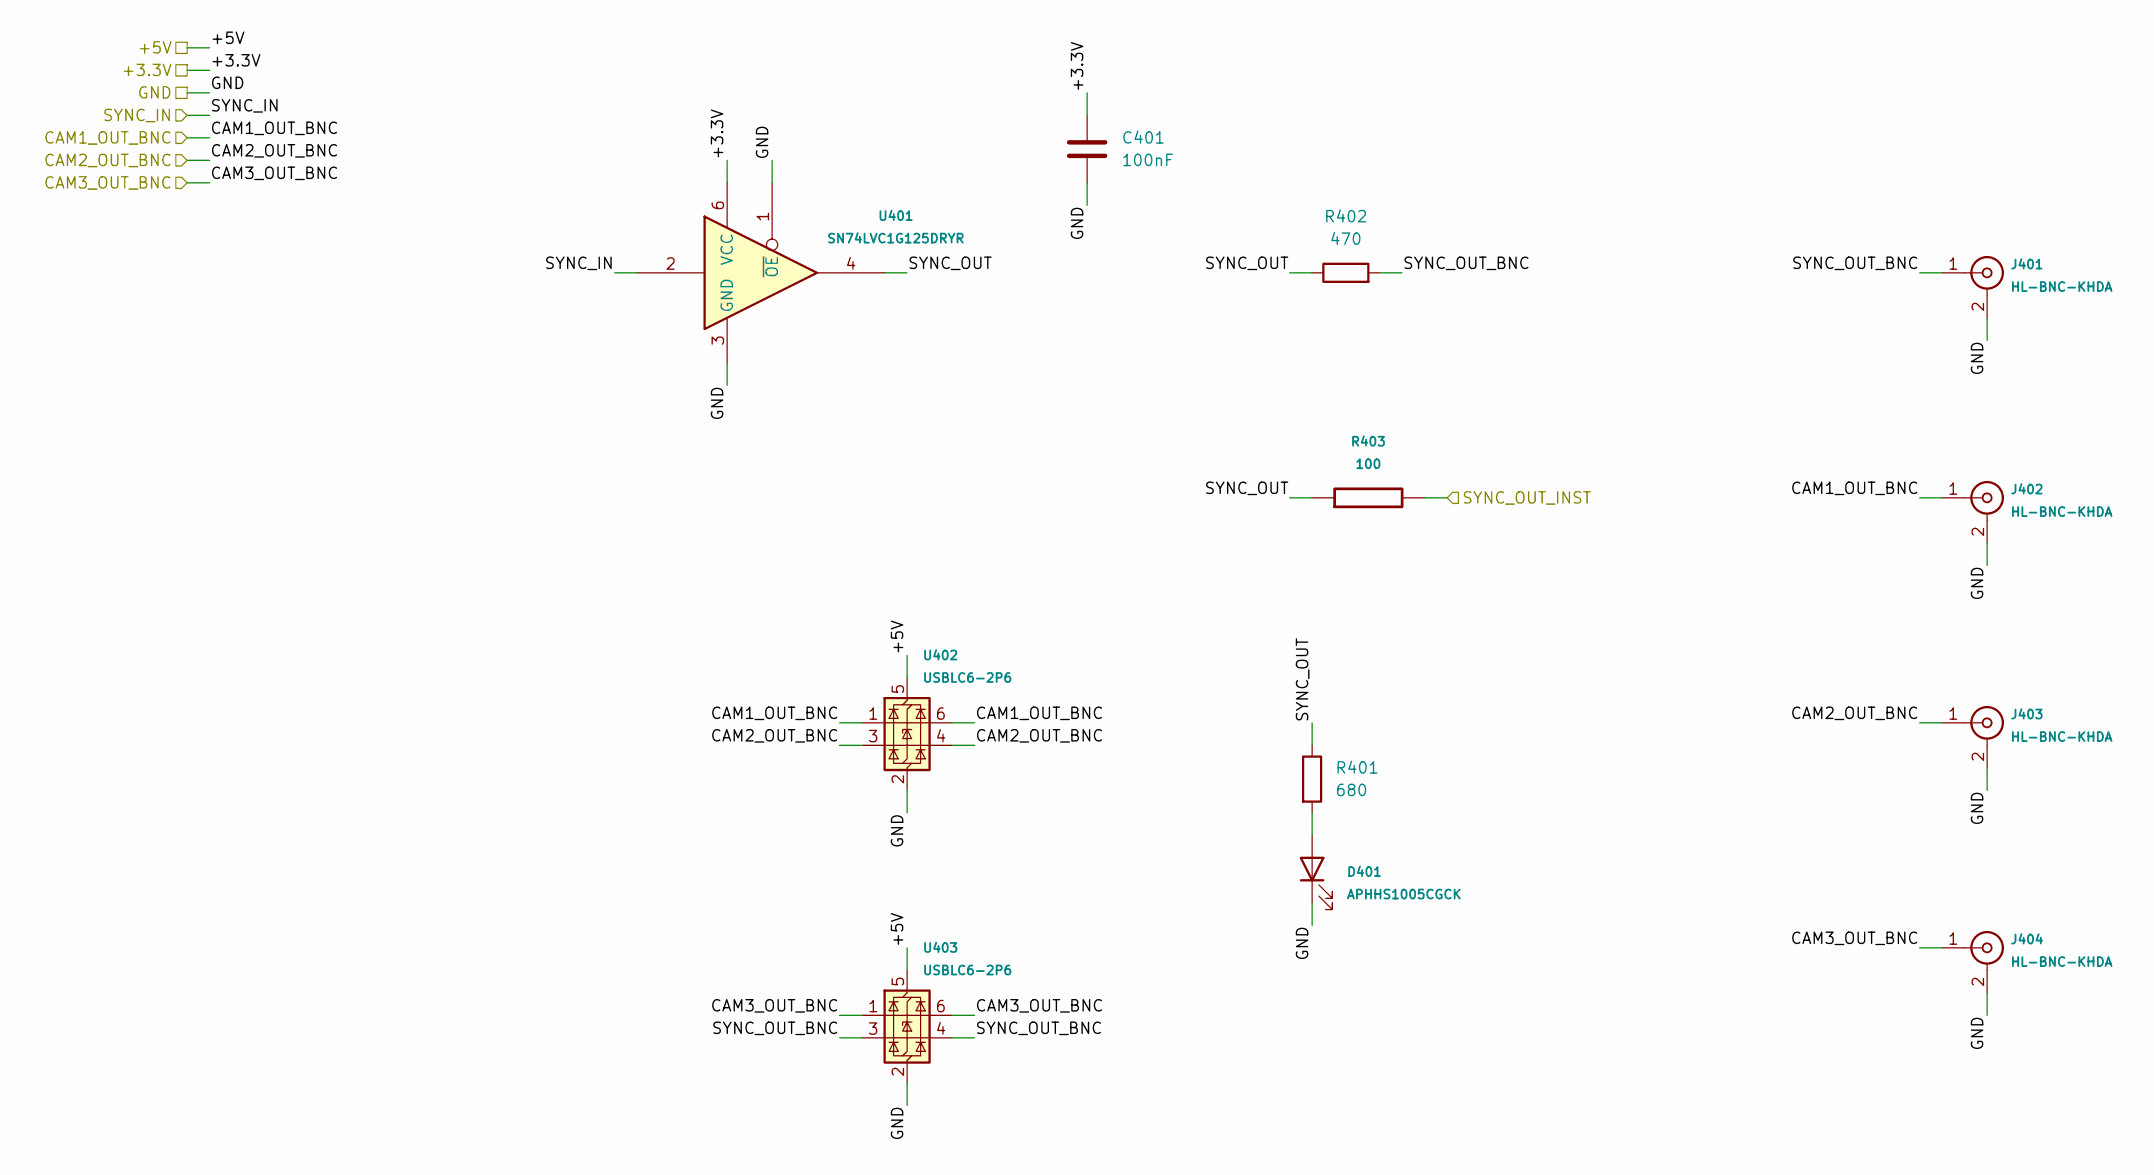
[picture p59: schematic outputs.kicad_sch, camera-gpio-interface-pcb]

Parts:
C401: 100nF; C_0402_1005Metric; PartID sym_orb_weaver_passives_c_0_1uf_100v_04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
D401: APHHS1005CGCK; LED_0402-1005_KNB; PartID sym_orb_weaver_misc_led_knb_20ma_grn_2_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
J401, J402, J403, J404: HL-BNC-KHDA; CONN_BNC_HL-BNC-KHDA; PartID sym_orb_weaver_connectors_conn_coaxial_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
R401: 680; R_0402_1005Metric; PartID mpn_rc0402fr_07680rl_0402
R402: 470; R_0603_1608Metric; PartID mpn_0603waf4700t5e_0603
R403: 100; R_0402_1005Metric; PartID sym_orb_weaver_passives_r_100_0402
U401: SN74LVC1G125DRYR; DRY6; PartID sym_orb_weaver_misc_buffer_74lvc1g125dr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
U402, U403: USBLC6-2P6; USBLC6-2P6_SOT-666; PartID mpn_usblc6_2p6_sot_666_6

Connections:
/+3.3V: C401.1, U401.6 (VCC); also elsewhere on the board
/+5V: U402.5 (VBUS), U403.5 (VBUS); also elsewhere on the board
/CAM1_OUT_BNC: J402.1 (Signal), U402.1 (I/O1), U402.6 (I/O1); also elsewhere on the board
/CAM2_OUT_BNC: J403.1 (Signal), U402.3 (I/O2), U402.4 (I/O2); also elsewhere on the board
/CAM3_OUT_BNC: J404.1 (Signal), U403.1 (I/O1), U403.6 (I/O1); also elsewhere on the board
/GND: C401.2, D401.1 (K), J401.2 (Shield), J402.2 (Shield), J403.2 (Shield), J404.2 (Shield), U401.1 (~OE), U401.3 (GND), U402.2 (GND), U403.2 (GND); also elsewhere on the board
/SYNC_IN: U401.2; also elsewhere on the board
/SYNC_OUT_INST: R403.2; also elsewhere on the board
/outputs/SYNC_OUT: R401.1, R402.1, R403.1, U401.4
/outputs/SYNC_OUT_BNC: J401.1 (Signal), R402.2, U403.3 (I/O2), U403.4 (I/O2)
unnamed: D401.2 (A), R401.2

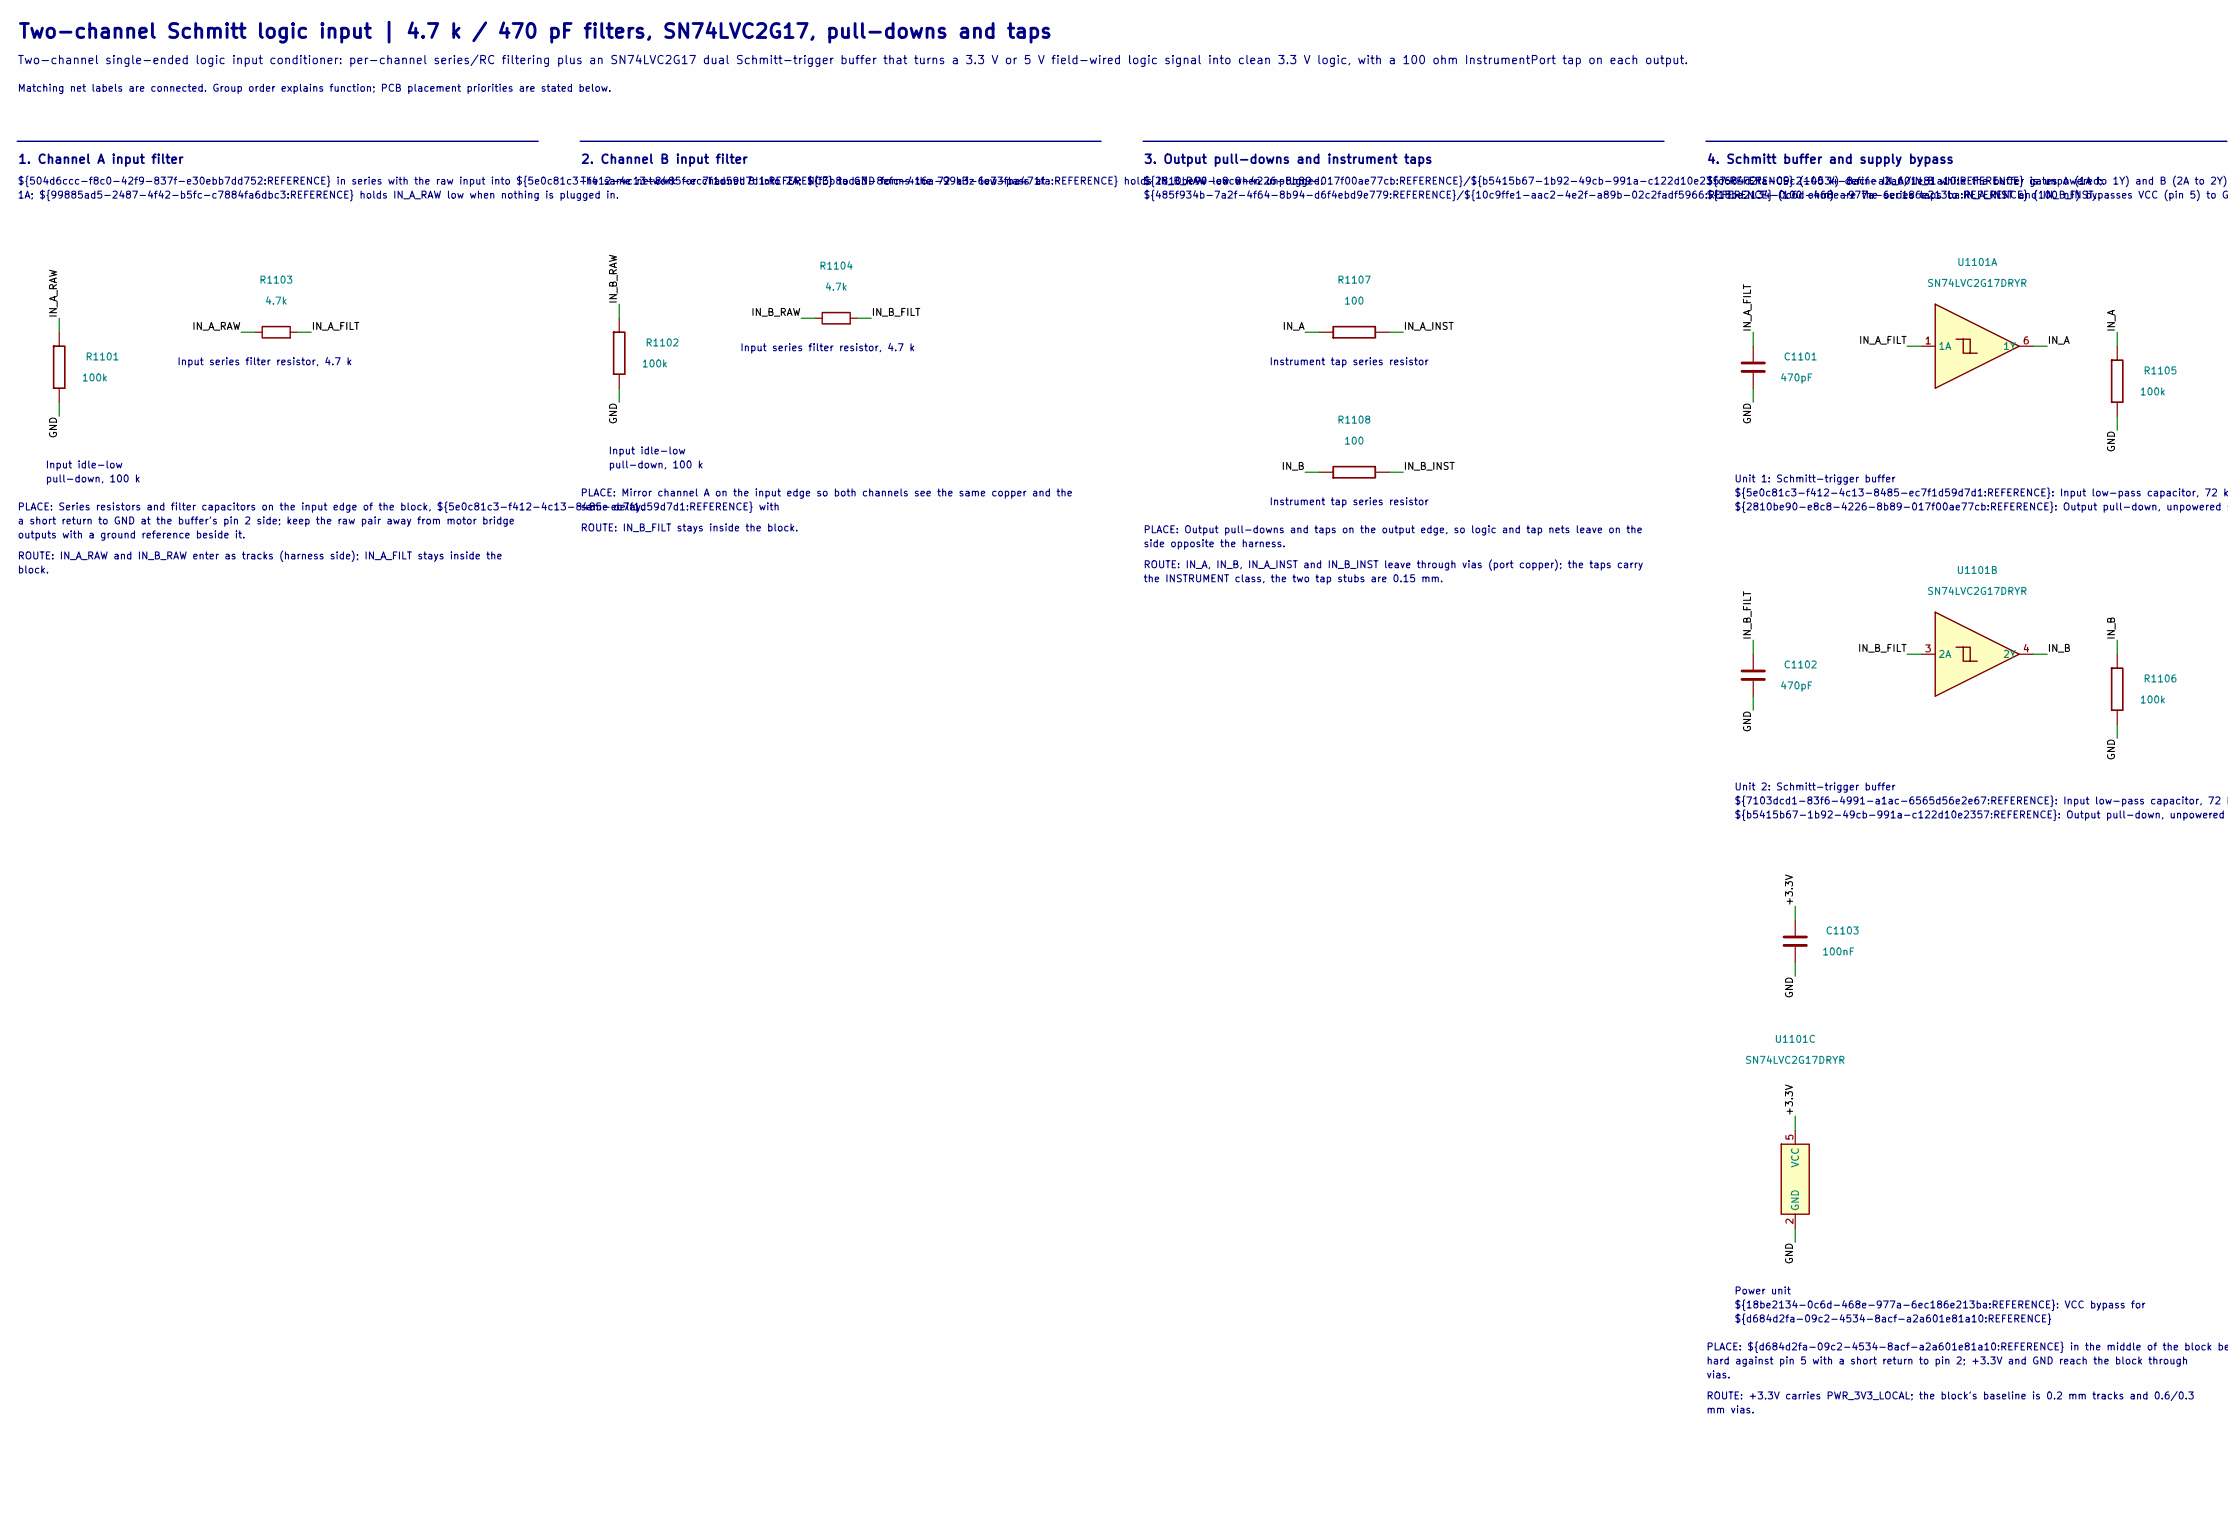
[picture p60: schematic logic_input_2ch_5v_schmitt_sn74lvc2g17.kicad_sch, Two-channel Schmitt logic input, part in row 1, column 1]

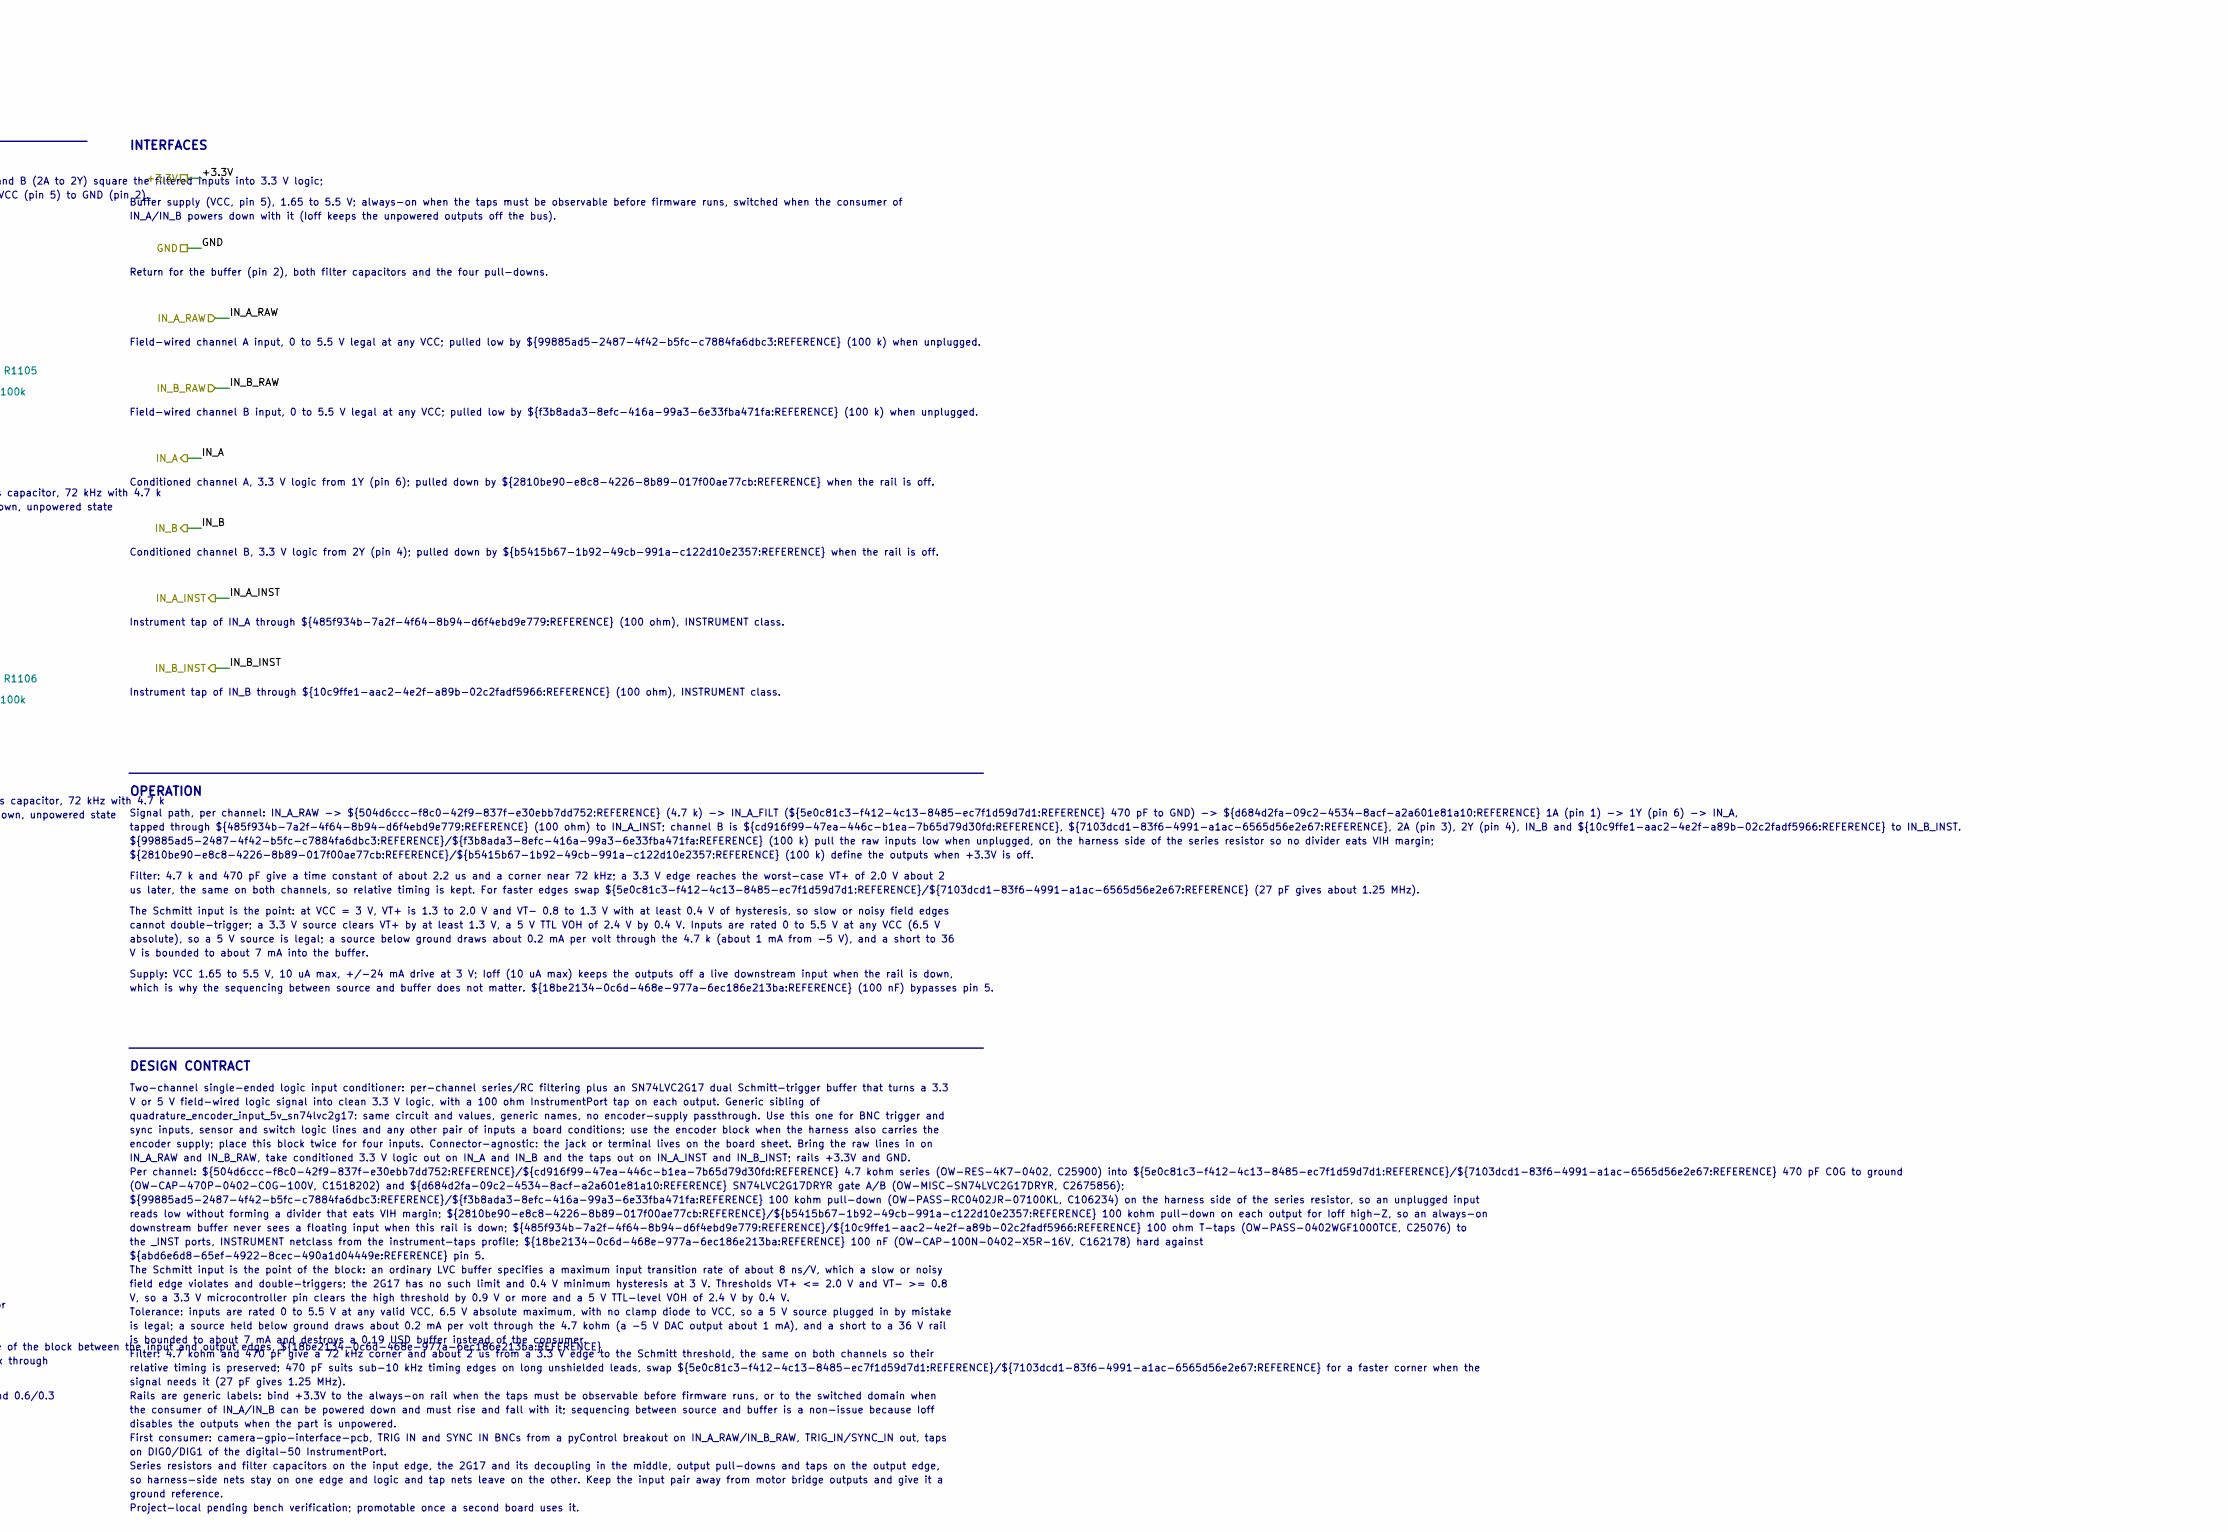
[picture p61: schematic logic_input_2ch_5v_schmitt_sn74lvc2g17.kicad_sch, Two-channel Schmitt logic input, part in row 1, column 2]

Parts:
C1101, C1102: 470pF; C_0402_1005Metric; PartID mpn_grm1555c2a471je01d_0402
C1103: 100nF; C_0402_1005Metric; PartID sym_orb_weaver_passives_c_0_1uf_100v_04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
R1101, R1102, R1105, R1106: 100k; R_0402_1005Metric; PartID sym_orb_weaver_passives_r_100k_0402
R1103, R1104: 4.7k; R_0402_1005Metric; PartID sym_orb_weaver_passives_r_4_7k_0402
R1107, R1108: 100; R_0402_1005Metric; PartID sym_orb_weaver_passives_r_100_0402
U1101: SN74LVC2G17DRYR; DRY6; PartID sym_orb_weaver_misc_buffer_74lvc2g17dryr

Connections:
/+3.3V: C1103.1, U1101.5 (VCC); also elsewhere on the board
/GND: C1101.2, C1102.2, C1103.2, R1101.2, R1102.2, R1105.2, R1106.2, U1101.2 (GND); also elsewhere on the board
/SYNC_IN: R1106.1, R1108.1, U1101.4 (2Y); also elsewhere on the board
/SYNC_IN_INST: R1108.2; also elsewhere on the board
/TRIG_IN: R1105.1, R1107.1, U1101.6 (1Y); also elsewhere on the board
/TRIG_IN_INST: R1107.2; also elsewhere on the board
/inputs/SYNC_RAW: R1102.1, R1104.1; also elsewhere on the board
/inputs/TRIG_RAW: R1101.1, R1103.1; also elsewhere on the board
/inputs/logic_input_2ch_5v_schmitt_sn74lvc2g17/IN_A_FILT: C1101.1, R1103.2, U1101.1 (1A)
/inputs/logic_input_2ch_5v_schmitt_sn74lvc2g17/IN_B_FILT: C1102.1, R1104.2, U1101.3 (2A)

Notes on the sheet:
Two-channel Schmitt logic input | 4.7 k / 470 pF filters, SN74LVC2G17, pull-downs and taps
Two-channel single-ended logic input conditioner: per-channel series/RC filtering plus an SN74LVC2G17 dual Schmitt-trigger buffer that turns a 3.3 V or 5 V field-wired logic signal into clean 3.3 V logic, with a 100 ohm InstrumentPort tap on each output.
Matching net labels are connected. Group order explains function; PCB placement priorities are stated below.
1. Channel A input filter
${504d6ccc-f8c0-42f9-837f-e30ebb7dd752:REFERENCE} in series with the raw input into ${5e0c81c3-f412-4c13-8485-ec7f1d59d7d1:REFERENCE} to GND forms the 72 kHz low-pass at
1A; ${99885ad5-2487-4f42-b5fc-c7884fa6dbc3:REFERENCE} holds IN_A_RAW low when nothing is plugged in.
Input series filter resistor, 4.7 k
Input idle-low
pull-down, 100 k
PLACE: Series resistors and filter capacitors on the input edge of the block, ${5e0c81c3-f412-4c13-8485-ec7f1d59d7d1:REFERENCE} with
a short return to GND at the buffer's pin 2 side; keep the raw pair away from motor bridge
outputs with a ground reference beside it.
ROUTE: IN_A_RAW and IN_B_RAW enter as tracks (harness side); IN_A_FILT stays inside the
block.
2. Channel B input filter
The same network for channel B into 2A; ${f3b8ada3-8efc-416a-99a3-6e33fba471fa:REFERENCE} holds IN_B_RAW low when unplugged.
PLACE: Mirror channel A on the input edge so both channels see the same copper and the
same delay.
ROUTE: IN_B_FILT stays inside the block.
3. Output pull-downs and instrument taps
${2810be90-e8c8-4226-8b89-017f00ae77cb:REFERENCE}/${b5415b67-1b92-49cb-991a-c122d10e2357:REFERENCE} (100 k) define IN_A/IN_B while the buffer is unpowered;
${485f934b-7a2f-4f64-8b94-d6f4ebd9e779:REFERENCE}/${10c9ffe1-aac2-4e2f-a89b-02c2fadf5966:REFERENCE} (100 ohm) are the series taps to IN_A_INST and IN_B_INST.
Instrument tap series resistor
PLACE: Output pull-downs and taps on the output edge, so logic and tap nets leave on the
side opposite the harness.
ROUTE: IN_A, IN_B, IN_A_INST and IN_B_INST leave through vias (port copper); the taps carry
the INSTRUMENT class, the two tap stubs are 0.15 mm.
4. Schmitt buffer and supply bypass
${d684d2fa-09c2-4534-8acf-a2a601e81a10:REFERENCE} gates A (1A to 1Y) and B (2A to 2Y) square the filtered inputs into 3.3 V logic;
${18be2134-0c6d-468e-977a-6ec186e213ba:REFERENCE} (100 nF) bypasses VCC (pin 5) to GND (pin 2).
Unit 1: Schmitt-trigger buffer
${5e0c81c3-f412-4c13-8485-ec7f1d59d7d1:REFERENCE}: Input low-pass capacitor, 72 kHz with 4.7 k
${2810be90-e8c8-4226-8b89-017f00ae77cb:REFERENCE}: Output pull-down, unpowered state
Unit 2: Schmitt-trigger buffer
${7103dcd1-83f6-4991-a1ac-6565d56e2e67:REFERENCE}: Input low-pass capacitor, 72 kHz with 4.7 k
${b5415b67-1b92-49cb-991a-c122d10e2357:REFERENCE}: Output pull-down, unpowered state
Power unit
${18be2134-0c6d-468e-977a-6ec186e213ba:REFERENCE}: VCC bypass for
${d684d2fa-09c2-4534-8acf-a2a601e81a10:REFERENCE}
PLACE: ${d684d2fa-09c2-4534-8acf-a2a601e81a10:REFERENCE} in the middle of the block between the input and output edges, ${18be2134-0c6d-468e-977a-6ec186e213ba:REFERENCE}
hard against pin 5 with a short return to pin 2; +3.3V and GND reach the block through
vias.
ROUTE: +3.3V carries PWR_3V3_LOCAL; the block's baseline is 0.2 mm tracks and 0.6/0.3
mm vias.
INTERFACES
Buffer supply (VCC, pin 5), 1.65 to 5.5 V; always-on when the taps must be observable before firmware runs, switched when the consumer of
IN_A/IN_B powers down with it (Ioff keeps the unpowered outputs off the bus).
Return for the buffer (pin 2), both filter capacitors and the four pull-downs.
Field-wired channel A input, 0 to 5.5 V legal at any VCC; pulled low by ${99885ad5-2487-4f42-b5fc-c7884fa6dbc3:REFERENCE} (100 k) when unplugged.
Field-wired channel B input, 0 to 5.5 V legal at any VCC; pulled low by ${f3b8ada3-8efc-416a-99a3-6e33fba471fa:REFERENCE} (100 k) when unplugged.
Conditioned channel A, 3.3 V logic from 1Y (pin 6); pulled down by ${2810be90-e8c8-4226-8b89-017f00ae77cb:REFERENCE} when the rail is off.
Conditioned channel B, 3.3 V logic from 2Y (pin 4); pulled down by ${b5415b67-1b92-49cb-991a-c122d10e2357:REFERENCE} when the rail is off.
Instrument tap of IN_A through ${485f934b-7a2f-4f64-8b94-d6f4ebd9e779:REFERENCE} (100 ohm), INSTRUMENT class.
Instrument tap of IN_B through ${10c9ffe1-aac2-4e2f-a89b-02c2fadf5966:REFERENCE} (100 ohm), INSTRUMENT class.
OPERATION
Signal path, per channel: IN_A_RAW -> ${504d6ccc-f8c0-42f9-837f-e30ebb7dd752:REFERENCE} (4.7 k) -> IN_A_FILT (${5e0c81c3-f412-4c13-8485-ec7f1d59d7d1:REFERENCE} 470 pF to GND) -> ${d684d2fa-09c2-4534-8acf-a2a601e81a10:REFERENCE} 1A (pin 1) -> 1Y (pin 6) -> IN_A,
tapped through ${485f934b-7a2f-4f64-8b94-d6f4ebd9e779:REFERENCE} (100 ohm) to IN_A_INST; channel B is ${cd916f99-47ea-446c-b1ea-7b65d79d30fd:REFERENCE}, ${7103dcd1-83f6-4991-a1ac-6565d56e2e67:REFERENCE}, 2A (pin 3), 2Y (pin 4), IN_B and ${10c9ffe1-aac2-4e2f-a89b-02c2fadf5966:REFERENCE} to IN_B_INST.
${99885ad5-2487-4f42-b5fc-c7884fa6dbc3:REFERENCE}/${f3b8ada3-8efc-416a-99a3-6e33fba471fa:REFERENCE} (100 k) pull the raw inputs low when unplugged, on the harness side of the series resistor so no divider eats VIH margin;
${2810be90-e8c8-4226-8b89-017f00ae77cb:REFERENCE}/${b5415b67-1b92-49cb-991a-c122d10e2357:REFERENCE} (100 k) define the outputs when +3.3V is off.
Filter: 4.7 k and 470 pF give a time constant of about 2.2 us and a corner near 72 kHz; a 3.3 V edge reaches the worst-case VT+ of 2.0 V about 2
us later, the same on both channels, so relative timing is kept. For faster edges swap ${5e0c81c3-f412-4c13-8485-ec7f1d59d7d1:REFERENCE}/${7103dcd1-83f6-4991-a1ac-6565d56e2e67:REFERENCE} (27 pF gives about 1.25 MHz).
The Schmitt input is the point: at VCC = 3 V, VT+ is 1.3 to 2.0 V and VT- 0.8 to 1.3 V with at least 0.4 V of hysteresis, so slow or noisy field edges
cannot double-trigger; a 3.3 V source clears VT+ by at least 1.3 V, a 5 V TTL VOH of 2.4 V by 0.4 V. Inputs are rated 0 to 5.5 V at any VCC (6.5 V
absolute), so a 5 V source is legal; a source below ground draws about 0.2 mA per volt through the 4.7 k (about 1 mA from -5 V), and a short to 36
V is bounded to about 7 mA into the buffer.
Supply: VCC 1.65 to 5.5 V, 10 uA max, +/-24 mA drive at 3 V; Ioff (10 uA max) keeps the outputs off a live downstream input when the rail is down,
which is why the sequencing between source and buffer does not matter. ${18be2134-0c6d-468e-977a-6ec186e213ba:REFERENCE} (100 nF) bypasses pin 5.
DESIGN CONTRACT
Two-channel single-ended logic input conditioner: per-channel series/RC filtering plus an SN74LVC2G17 dual Schmitt-trigger buffer that turns a 3.3
V or 5 V field-wired logic signal into clean 3.3 V logic, with a 100 ohm InstrumentPort tap on each output. Generic sibling of
quadrature_encoder_input_5v_sn74lvc2g17: same circuit and values, generic names, no encoder-supply passthrough. Use this one for BNC trigger and
sync inputs, sensor and switch logic lines and any other pair of inputs a board conditions; use the encoder block when the harness also carries the
encoder supply; place this block twice for four inputs. Connector-agnostic: the jack or terminal lives on the board sheet. Bring the raw lines in on
IN_A_RAW and IN_B_RAW, take conditioned 3.3 V logic out on IN_A and IN_B and the taps out on IN_A_INST and IN_B_INST; rails +3.3V and GND.
Per channel: ${504d6ccc-f8c0-42f9-837f-e30ebb7dd752:REFERENCE}/${cd916f99-47ea-446c-b1ea-7b65d79d30fd:REFERENCE} 4.7 kohm series (OW-RES-4K7-0402, C25900) into ${5e0c81c3-f412-4c13-8485-ec7f1d59d7d1:REFERENCE}/${7103dcd1-83f6-4991-a1ac-6565d56e2e67:REFERENCE} 470 pF C0G to ground
(OW-CAP-470P-0402-C0G-100V, C1518202) and ${d684d2fa-09c2-4534-8acf-a2a601e81a10:REFERENCE} SN74LVC2G17DRYR gate A/B (OW-MISC-SN74LVC2G17DRYR, C2675856);
${99885ad5-2487-4f42-b5fc-c7884fa6dbc3:REFERENCE}/${f3b8ada3-8efc-416a-99a3-6e33fba471fa:REFERENCE} 100 kohm pull-down (OW-PASS-RC0402JR-07100KL, C106234) on the harness side of the series resistor, so an unplugged input
reads low without forming a divider that eats VIH margin; ${2810be90-e8c8-4226-8b89-017f00ae77cb:REFERENCE}/${b5415b67-1b92-49cb-991a-c122d10e2357:REFERENCE} 100 kohm pull-down on each output for Ioff high-Z, so an always-on
downstream buffer never sees a floating input when this rail is down; ${485f934b-7a2f-4f64-8b94-d6f4ebd9e779:REFERENCE}/${10c9ffe1-aac2-4e2f-a89b-02c2fadf5966:REFERENCE} 100 ohm T-taps (OW-PASS-0402WGF1000TCE, C25076) to
the _INST ports, INSTRUMENT netclass from the instrument-taps profile; ${18be2134-0c6d-468e-977a-6ec186e213ba:REFERENCE} 100 nF (OW-CAP-100N-0402-X5R-16V, C162178) hard against
${abd6e6d8-65ef-4922-8cec-490a1d04449e:REFERENCE} pin 5.
The Schmitt input is the point of the block: an ordinary LVC buffer specifies a maximum input transition rate of about 8 ns/V, which a slow or noisy
field edge violates and double-triggers; the 2G17 has no such limit and 0.4 V minimum hysteresis at 3 V. Thresholds VT+ <= 2.0 V and VT- >= 0.8
V, so a 3.3 V microcontroller pin clears the high threshold by 0.9 V or more and a 5 V TTL-level VOH of 2.4 V by 0.4 V.
Tolerance: inputs are rated 0 to 5.5 V at any valid VCC, 6.5 V absolute maximum, with no clamp diode to VCC, so a 5 V source plugged in by mistake
is legal; a source held below ground draws about 0.2 mA per volt through the 4.7 kohm (a -5 V DAC output about 1 mA), and a short to a 36 V rail
is bounded to about 7 mA and destroys a 0.19 USD buffer instead of the consumer.
Filter: 4.7 kohm and 470 pF give a 72 kHz corner and about 2 us from a 3.3 V edge to the Schmitt threshold, the same on both channels so their
relative timing is preserved; 470 pF suits sub-10 kHz timing edges on long unshielded leads, swap ${5e0c81c3-f412-4c13-8485-ec7f1d59d7d1:REFERENCE}/${7103dcd1-83f6-4991-a1ac-6565d56e2e67:REFERENCE} for a faster corner when the
signal needs it (27 pF gives 1.25 MHz).
Rails are generic labels: bind +3.3V to the always-on rail when the taps must be observable before firmware runs, or to the switched domain when
the consumer of IN_A/IN_B can be powered down and must rise and fall with it; sequencing between source and buffer is a non-issue because Ioff
disables the outputs when the part is unpowered.
First consumer: camera-gpio-interface-pcb, TRIG IN and SYNC IN BNCs from a pyControl breakout on IN_A_RAW/IN_B_RAW, TRIG_IN/SYNC_IN out, taps
on DIG0/DIG1 of the digital-50 InstrumentPort.
Series resistors and filter capacitors on the input edge, the 2G17 and its decoupling in the middle, output pull-downs and taps on the output edge,
so harness-side nets stay on one edge and logic and tap nets leave on the other. Keep the input pair away from motor bridge outputs and give it a
ground reference.
Project-local pending bench verification; promotable once a second board uses it.

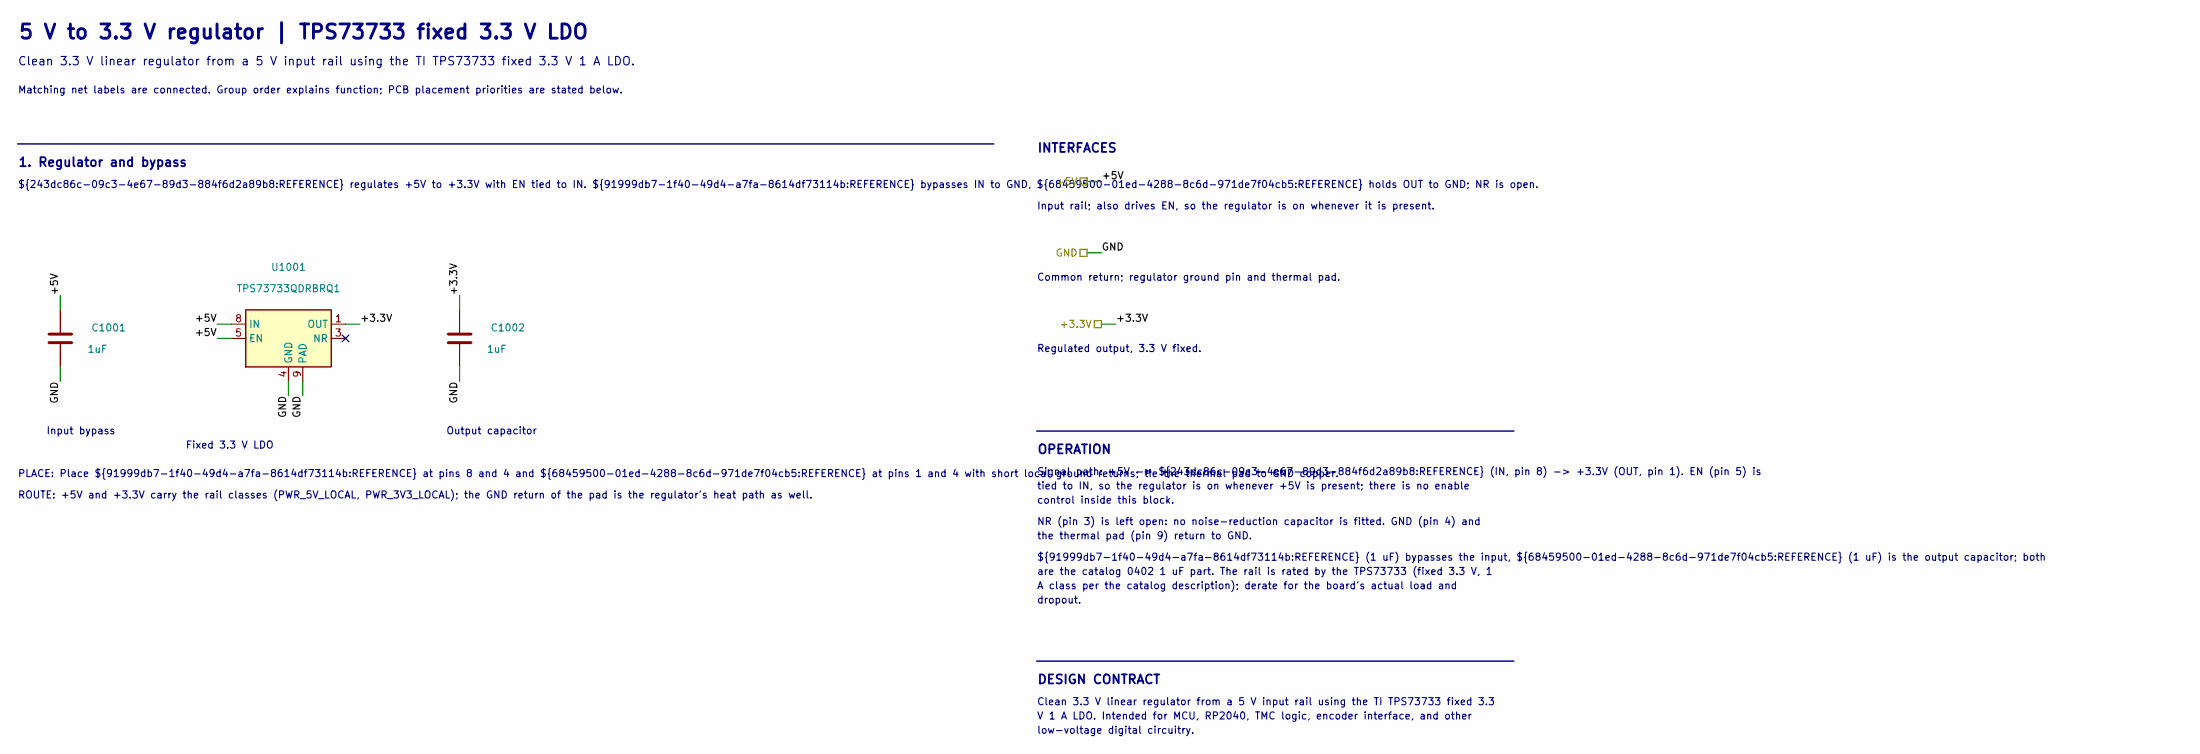
[picture p62: schematic 5v_to_3v3_tps73733.kicad_sch, 5 V to 3.3 V regulator]

Parts:
C1001, C1002: 1uF; C_0402_1005Metric; PartID sym_orb_weaver_passives_c_1uf_35v_0402
U1001: TPS73733QDRBRQ1; TPS737Q1; PartID sym_orb_weaver_power_regulator_linear_3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

Connections:
/+3.3V: C1002.1, U1001.1 (OUT); also elsewhere on the board
/+5V: C1001.1, U1001.5 (EN), U1001.8 (IN); also elsewhere on the board
/GND: C1001.2, C1002.2, U1001.4 (GND), U1001.9 (PAD); also elsewhere on the board

Notes on the sheet:
5 V to 3.3 V regulator | TPS73733 fixed 3.3 V LDO
Clean 3.3 V linear regulator from a 5 V input rail using the TI TPS73733 fixed 3.3 V 1 A LDO.
Matching net labels are connected. Group order explains function; PCB placement priorities are stated below.
1. Regulator and bypass
${243dc86c-09c3-4e67-89d3-884f6d2a89b8:REFERENCE} regulates +5V to +3.3V with EN tied to IN. ${91999db7-1f40-49d4-a7fa-8614df73114b:REFERENCE} bypasses IN to GND, ${68459500-01ed-4288-8c6d-971de7f04cb5:REFERENCE} holds OUT to GND; NR is open.
Input bypass
Fixed 3.3 V LDO
Output capacitor
PLACE: Place ${91999db7-1f40-49d4-a7fa-8614df73114b:REFERENCE} at pins 8 and 4 and ${68459500-01ed-4288-8c6d-971de7f04cb5:REFERENCE} at pins 1 and 4 with short local ground returns; tie the thermal pad to GND copper.
ROUTE: +5V and +3.3V carry the rail classes (PWR_5V_LOCAL, PWR_3V3_LOCAL); the GND return of the pad is the regulator's heat path as well.
INTERFACES
Input rail; also drives EN, so the regulator is on whenever it is present.
Common return; regulator ground pin and thermal pad.
Regulated output, 3.3 V fixed.
OPERATION
Signal path: +5V -> ${243dc86c-09c3-4e67-89d3-884f6d2a89b8:REFERENCE} (IN, pin 8) -> +3.3V (OUT, pin 1). EN (pin 5) is
tied to IN, so the regulator is on whenever +5V is present; there is no enable
control inside this block.
NR (pin 3) is left open: no noise-reduction capacitor is fitted. GND (pin 4) and
the thermal pad (pin 9) return to GND.
${91999db7-1f40-49d4-a7fa-8614df73114b:REFERENCE} (1 uF) bypasses the input, ${68459500-01ed-4288-8c6d-971de7f04cb5:REFERENCE} (1 uF) is the output capacitor; both
are the catalog 0402 1 uF part. The rail is rated by the TPS73733 (fixed 3.3 V, 1
A class per the catalog description); derate for the board's actual load and
dropout.
DESIGN CONTRACT
Clean 3.3 V linear regulator from a 5 V input rail using the TI TPS73733 fixed 3.3
V 1 A LDO. Intended for MCU, RP2040, TMC logic, encoder interface, and other
low-voltage digital circuitry.
