peterpolidoro/camera-gpio-interface-pcb/kicad/board-manifest.yaml

schema: orb-weaver/board-manifest/1
board: camera-gpio-interface-pcb
project: camera-gpio-interface-pcb.kicad_pro
summary: 'Camera GPIO interface for the three FLIR Blackfly S cameras of the joystick rig: three pluggable screw-terminal
  camera channels, two BNC inputs from the pyControl breakout, four 3.3 V BNC outputs to a Neuropixels OneBox, an InstrumentPort-Digital-50
  with every camera line tapped, USB power; no MCU; v1.0 as built.'
rules:
  profiles:
  - instrument-taps
  - hv-power-24v
  grid_mm: 1.0
  datum:
    kind: aux axis origin
    kicad_mm: [150.0, 95.0]
sheets:
- name: inputs
  file: inputs.kicad_sch
  parent: /
  ports:
    +3.3V: +3.3V
    +5V: +5V
    GND: GND
    SYNC_IN: SYNC_IN
    SYNC_IN_INST: SYNC_IN_INST
    TRIG_IN: TRIG_IN
    TRIG_IN_INST: TRIG_IN_INST
  note: board-authored sheet, 7 parts
- name: power
  file: power.kicad_sch
  parent: /
  ports:
    +3.3V: +3.3V
    +5V: +5V
    GND: GND
  note: board-authored sheet, 2 parts
- name: outputs
  file: outputs.kicad_sch
  parent: /
  ports:
    +3.3V: +3.3V
    +5V: +5V
    CAM1_OUT_BNC: CAM1_OUT_BNC
    CAM2_OUT_BNC: CAM2_OUT_BNC
    CAM3_OUT_BNC: CAM3_OUT_BNC
    GND: GND
    SYNC_IN: SYNC_IN
    SYNC_OUT_INST: SYNC_OUT_INST
  note: board-authored sheet, 12 parts
placements:
- name: blackfly_s_gpio_channel_mcv6_vertical
  block: orb_weaver_blackfly_s_gpio_channel:blackfly_s_gpio_channel_mcv6_vertical
  parent: /
  anchor_mm: [-25.0, -24.0]
  rotation_degrees: 180
  side: front
  anchor_rule: 'inferred (block not in the anchor table): the group''s one connector, pad-array centre'
  connections:
    +3.3V: +3.3V
    +5V: +5V
    CAM_OUT_BNC: CAM1_OUT_BNC
    GND: GND
    L0_INST: CAM1_L0_INST
    L1_INST: CAM1_L1_INST
    L2_INST: CAM1_L2_INST
    L3_INST: CAM1_L3_INST
    OUT_INST: CAM1_OUT_INST
    SYNC_IN: SYNC_IN
    TRIG_IN: TRIG_IN
- name: logic_input_2ch_5v_schmitt_sn74lvc2g17
  block: orb_weaver_private:logic_input_2ch_5v_schmitt_sn74lvc2g17
  parent: /inputs
  anchor_mm: [-12.0, 17.0]
  rotation_degrees: 90
  side: front
  sheet_pins:
    size_mm: [25.4, 15.24]
    pins:
      +3.3V:
        edge: west
        offset_mm: 2.54
        angle: 180
        shape: passive
      GND:
        edge: west
        offset_mm: 5.08
        angle: 180
        shape: passive
      IN_A_RAW:
        edge: west
        offset_mm: 10.16
        angle: 180
        shape: input
      IN_B_RAW:
        edge: west
        offset_mm: 12.7
        angle: 180
        shape: input
      IN_A:
        edge: east
        offset_mm: 2.54
        angle: 0
        shape: output
      IN_B:
        edge: east
        offset_mm: 5.08
        angle: 0
        shape: output
      IN_A_INST:
        edge: east
        offset_mm: 10.16
        angle: 0
        shape: output
      IN_B_INST:
        edge: east
        offset_mm: 12.7
        angle: 0
        shape: output
  connections:
    +3.3V: +3.3V
    GND: GND
    IN_A: TRIG_IN
    IN_A_INST: TRIG_IN_INST
    IN_A_RAW: TRIG_RAW
    IN_B: SYNC_IN
    IN_B_INST: SYNC_IN_INST
    IN_B_RAW: SYNC_RAW
- name: 5v_to_3v3_tps73733
  block: orb_weaver_private:5v_to_3v3_tps73733
  parent: /power
  anchor_mm: [-40.0, -15.0]
  rotation_degrees: 180
  side: front
  connections:
    +3.3V: +3.3V
    +5V: +5V
    GND: GND
- name: usb2_vertical
  block: orb_weaver_private:usb2_vertical
  parent: /power
  anchor_mm: [-44.0, -1.0]
  rotation_degrees: 90
  side: front
  connections:
    +5V_USB: +5V
    GND: GND
    USB_D+:
      open: no-connect flag
    USB_D-:
      open: no-connect flag
    VBUS:
      open: no-connect flag
- name: instrument_port_digital_50_dut_ffc_boundary_vertical
  block: orb_weaver_private:instrument_port_digital_50_dut_ffc_boundary_vertical
  parent: /
  anchor_mm: [44.0, 4.0]
  rotation_degrees: 270
  side: front
  sheet_pins:
    size_mm: [25.4, 91.44]
    pins:
      +3.3V:
        edge: west
        offset_mm: 2.54
        angle: 180
        shape: passive
      GND:
        edge: west
        offset_mm: 5.08
        angle: 180
        shape: passive
      DIG0:
        edge: west
        offset_mm: 10.16
        angle: 180
        shape: input
      DIG1:
        edge: west
        offset_mm: 12.7
        angle: 180
        shape: input
      DIG2:
        edge: west
        offset_mm: 15.24
        angle: 180
        shape: input
      DIG3:
        edge: west
        offset_mm: 17.78
        angle: 180
        shape: input
      DIG4:
        edge: west
        offset_mm: 20.32
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
  side: front
  anchor_rule: 'inferred (block not in the anchor table): the group''s one connector, pad-array centre'
  connections:
    +3.3V: +3.3V
    +5V: +5V
    CAM_OUT_BNC: CAM2_OUT_BNC
    GND: GND
    L0_INST: CAM2_L0_INST
    L1_INST: CAM2_L1_INST
    L2_INST: CAM2_L2_INST
    L3_INST: CAM2_L3_INST
    OUT_INST: CAM2_OUT_INST
    SYNC_IN: SYNC_IN
    TRIG_IN: TRIG_IN
nets:
  /+3.3V:
    class: PWR_3V3_NARROW
    meaning: The only logic rail, from the TPS73733 on the power sheet; always on while USB is present, as the InstrumentPort
      block requires
  /+5V:
    class: PWR_5V_NARROW
    meaning: 'VBUS after the USB block''s Schottky (+5V_USB in the design record): the Line 0 pull-ups and every ESD array''s
      clamp reference'
  /CAM1_L0_INST:
    class: INSTRUMENT
    meaning: 'DIG3: camera 1 pin 2 node (Line 0, the Rsync drive), 0 to 4.7 V open-drain'
  /CAM1_L1_INST:
    class: INSTRUMENT
    meaning: 'DIG4: camera 1 OPTOOUT (Line 1), Schmitt-buffered; a second camera output for diagnosing missed triggers'
  /CAM1_L2_INST:
    class: INSTRUMENT
    meaning: 'DIG5: camera 1 Line 2 raw open-drain node (ExposureActive)'
  /CAM1_L3_INST:
    class: INSTRUMENT
    meaning: 'DIG6: camera 1 pin 1 node (Line 3, the trigger) after the 220 Ω'
  /CAM1_OUT_BNC:
    class: Default
    meaning: Camera 1 ExposureActive (Line 2, Schmitt-buffered) behind the block's 470 Ω, to the CAM1 OUT BNC
  /CAM1_OUT_INST:
    class: INSTRUMENT
    meaning: 'DIG7: what the CAM1 OUT BNC carries'
  /CAM2_L0_INST:
    class: INSTRUMENT
    meaning: 'DIG8: camera 2 pin 2 node (Line 0, the Rsync drive), 0 to 4.7 V open-drain'
  /CAM2_L1_INST:
    class: INSTRUMENT
    meaning: 'DIG9: camera 2 OPTOOUT (Line 1), Schmitt-buffered; a second camera output for diagnosing missed triggers'
  /CAM2_L2_INST:
    class: INSTRUMENT
    meaning: 'DIG10: camera 2 Line 2 raw open-drain node (ExposureActive)'
  /CAM2_L3_INST:
    class: INSTRUMENT
    meaning: 'DIG11: camera 2 pin 1 node (Line 3, the trigger) after the 220 Ω'
  /CAM2_OUT_BNC:
    class: Default
    meaning: Camera 2 ExposureActive (Line 2, Schmitt-buffered) behind the block's 470 Ω, to the CAM2 OUT BNC
  /CAM2_OUT_INST:
    class: INSTRUMENT
    meaning: 'DIG12: what the CAM2 OUT BNC carries'
  /CAM3_L0_INST:
    class: INSTRUMENT
    meaning: 'DIG13: camera 3 pin 2 node (Line 0, the Rsync drive), 0 to 4.7 V open-drain'
  /CAM3_L1_INST:
    class: INSTRUMENT
    meaning: 'DIG14: camera 3 OPTOOUT (Line 1), Schmitt-buffered; a second camera output for diagnosing missed triggers'
  /CAM3_L2_INST:
    class: INSTRUMENT
    meaning: 'DIG15: camera 3 Line 2 raw open-drain node (ExposureActive)'
  /CAM3_L3_INST:
    class: INSTRUMENT
    meaning: 'DIG16: camera 3 pin 1 node (Line 3, the trigger) after the 220 Ω'
  /CAM3_OUT_BNC:
    class: Default
    meaning: Camera 3 ExposureActive (Line 2, Schmitt-buffered) behind the block's 470 Ω, to the CAM3 OUT BNC
  /CAM3_OUT_INST:
    class: INSTRUMENT
    meaning: 'DIG17: what the CAM3 OUT BNC carries'
  /GND:
    class: PWR_RETURN_LOCAL
    meaning: Board ground; every BNC shell and camera pins 5 and 6
  /SYNC_IN:
    class: Default
    meaning: Conditioned Rsync from the SYNC IN BNC, 3.3 V, to the three Line 0 drivers and the SYNC OUT driver
  /SYNC_IN_INST:
    class: INSTRUMENT
    meaning: 'DIG1: the conditioned Rsync after the Schmitt (the input block''s IN_B_INST)'
  /SYNC_OUT_INST:
    class: INSTRUMENT
    meaning: 'DIG2: what the SYNC OUT BNC carries, at the driver output before the 470 Ω'
  /TRIG_IN:
    class: Default
    meaning: Conditioned 150 Hz frame trigger from the TRIG IN BNC, 3.3 V, to the three camera channels' Line 3 drivers
  /TRIG_IN_INST:
    class: INSTRUMENT
    meaning: 'DIG0: the conditioned trigger after the Schmitt (the input block''s IN_A_INST)'
  /inputs/SYNC_RAW:
    class: Default
    meaning: The SYNC IN jack to the ESD clamp and the input block's IN_B_RAW
  /inputs/TRIG_RAW:
    class: Default
    meaning: The TRIG IN jack to the ESD clamp and the input block's IN_A_RAW
