peterpolidoro/camera-gpio-interface-pcb/(commit log)

2026-09-23 Update plans with pcb resistor values
2026-09-24 Update docs after making camera block
2026-09-25 Initialize kicad project
    [camera-gpio-interface-pcb.kicad_pcb, camera-gpio-interface-pcb.kicad_sch]
2026-09-25 Add root level schematic sheets
    [5v_to_3v3_tps73733.kicad_sch, camera-gpio-interface-pcb.kicad_sch, camera_1.kicad_sch, camera_2.kicad_sch, camera_3.kicad_sch, inputs.kicad_sch, instrument_port.kicad_sch, power.kicad_sch]
2026-09-25 Initial v1.0 pcb layout
    [5v_to_3v3_tps73733.kicad_sch, blackfly_s_gpio_channel_mcv6_vertical.kicad_sch, camera-gpio-interface-pcb.kicad_pcb, camera-gpio-interface-pcb.kicad_sch, camera_1.kicad_sch, camera_2.kicad_sch, camera_3.kicad_sch, inputs.kicad_sch]
2026-09-25 Update channels file
    [camera-gpio-interface-pcb.kicad_pcb]
2026-09-26 Found a routing solution
    [camera-gpio-interface-pcb.kicad_pcb]
2026-09-26 Update with changes after fixing kicad-lib scripts
    [camera-gpio-interface-pcb.kicad_pcb]
2026-09-26 Finished v1.0 changes
    [5v_to_3v3_tps73733.kicad_sch, blackfly_s_gpio_channel_mcv6_vertical.kicad_sch, camera-gpio-interface-pcb-assembled.step, camera-gpio-interface-pcb-bom.csv, camera-gpio-interface-pcb.kicad_pcb, camera-gpio-interface-pcb.kicad_sch, connectors.csv, inputs.kicad_sch]
2026-09-26 Update documentation
    [jlcpcb-bom.csv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]
2026-10-02 Finish S6
    [mechanical-datums.csv]
2026-10-05 Update to use latest kicad-libs
2026-10-12 More changes before mirroring
    [camera-gpio-interface-pcb-B_Cu.gbl, camera-gpio-interface-pcb-B_Mask.gbs, camera-gpio-interface-pcb-B_Paste.gbp, camera-gpio-interface-pcb-B_Silkscreen.gbo, camera-gpio-interface-pcb-Edge_Cuts.gm1, camera-gpio-interface-pcb-F_Cu.gtl, camera-gpio-interface-pcb-F_Mask.gts, camera-gpio-interface-pcb-F_Paste.gtp]
2026-10-13 Regenerate schematics
    [5v_to_3v3_tps73733.kicad_sch, blackfly_s_gpio_channel_mcv6_vertical.kicad_sch, camera-gpio-interface-pcb-assembled.step, camera-gpio-interface-pcb.kicad_pcb, camera-gpio-interface-pcb.kicad_sch, instrument_port_digital_50_dut_ffc_boundary_vertical.kicad_sch, logic_input_2ch_5v_schmitt_sn74lvc2g17.kicad_sch, usb2_vertical.kicad_sch]
2026-10-14 Update generated documentation
    [camera-gpio-interface-pcb-assembled.step, camera-gpio-interface-pcb.kicad_pcb]
2026-10-15 Add subsystems
    [camera-gpio-interface-pcb-assembled.step]
